rwaldron/johnny-five/awesome.md

# Awesome Nodebots Built with Johnny-Five
----------------
(Entries listed newest to oldest)

## Ricardo de Pena [@ricardodepena](https://twitter.com/ricardodepena)

- Clawbot: bluetooth bot with a claw, controlled via a ps3 controller
    [video](http://vimeo.com/86788094)
    [code](https://github.com/rdepena/clawbot)

## Richard Key [@busyrich](http://twitter.com/busyrich)

- Arduino Attack!
    [video](http://www.youtube.com/watch?v=1NalU4d7a20)
    [code](https://github.com/BusyRich/arduino-attack)

## Andrew Homeyer [@andrewhomeyer](https://twitter.com/andrewhomeyer), Matt Parrish [@mattparrish](https://twitter.com/mattparrish), Nicholas Boll [@nicholasboll](https://twitter.com/nicholasboll)

- Missile Command: A rubber band launcher that took down a nodecopter
    [video](http://youtu.be/0FAfu-Zowuo)
    [code](https://github.com/homeyer/missile-command/)

## Sara Gorecki [@opheliasdaisies] (https://twitter.com/opheliasdaisies)

- A tri-color LED that cycles according to pressure sensor input.
    [video](http://youtu.be/ePiiaja1CuI)
    [code](https://github.com/opheliasdaisies/tri-color-led)

## Rahul Ravikumar [@tikurahul](https://twitter.com/tikurahul), Bryan Hughes[@nebrius](https://twitter.com/nebrius)

- Typing Bot (nodebots, jsconf)
    [video](http://www.youtube.com/watch?v=kjTO2OkGnD8)

## Raquel Vélez [@rockbot](https://twitter.com/rockbot)

- Manny the Manipulator: A 2-dimensional serial manipulator using forward/inverse kinematics (via [vektor](https://github.com/rockbot/vektor))
    [video](http://www.youtube.com/watch?v=JKumEFyOvuI)
    [code](https://github.com/rockbot/vektor/tree/master/manipulator)

## Travis Thieman [@thieman](https://twitter.com/thieman)

- Power Glove (OS X Volume Control):
    [video](http://www.youtube.com/watch?v=j1BimT0hPSQ)
    [code](https://github.com/tthieman/arduino-projects/blob/master/hackathon_20130217/power_glove.js)

## Francis Gulotta [@reconbot](https://twitter.com/reconbot)

- Dorby the DoorBot
    [video howto](http://www.youtube.com/watch?v=6VnSIbRAlFw)
    [video servo operation](http://www.youtube.com/watch?v=gh7LtDA6EL0)
    [code](https://github.com/reconbot/dorby)

## Tim Walker [@timwalker2k](https://twitter.com/timwalker2k)

- An experimental Theremin using a proximity sensor and JavaScript.
    [code](https://github.com/twalker/sine5)

- A build status light for use within a continuous integration workflow
    [code](https://github.com/twalker/cilite)

## Kelly Korevec [@korevec](http://twitter.com/korevec)

- Medibot
    [Picture](https://twitter.com/korevec/status/267848987711766528/photo/1)
    [code](https://github.com/korevec/medibot)

## Irene Ros [@ireneros](http://twitter.com/ireneros)

- Wii Nunchuk Controller for AR Drone (nodecopter event)
    [video](http://twitter.yfrog.com/n4u1nrxrakmkyopxxpjmxzmzz)
    [code](https://github.com/iros/nodecoptering)

## Chris Williams [@voodootikigod](http://twitter.com/voodootikigod)

- Wii Nunchuk Controller for AR Drone (nodecopter event)
    [code](https://github.com/voodootikigod/wii-drone/)

## Andreas Haugstrup Pedersen [@hgstrp](http://twitter.com/hgstrp)

- LCD Controller (First successful implementation!!)
    [video](http://vimeo.com/46577266)
    [code](https://gist.github.com/3200331)
    (Became the basis for the LCD constructor!)

## Rebecca Murphey [@rmurphey](http://twitter.com/rmurphey)

- Johnny-Five Projects
    [On Github](https://github.com/rmurphey/johnny-five-projects)

- Shift Register Implementation w/ Led Counter Display
    [video](http://vimeo.com/46463390)
    [code](http://gist.github.com/3185390)

## Jonathan Blanchet [@jblanchefr](http://twitter.com/jblanchefr)

- Arduino + Websockets + particles:
    [video](http://www.youtube.com/watch?v=MXEGLGmpCfo)
    [code](https://gist.github.com/3145395)

- Arduino + Websockets + css change:
    [video](http://www.youtube.com/watch?v=aYFOOr1amSg&feature=plcp)
    [code](https://gist.github.com/3145461)

- Arduino + potentiometer + particles:
    [video](http://www.youtube.com/watch?v=d5r5r7pHUZI)
    [code](https://gist.github.com/3147263)

## Cole Gillespie [@theCole](https://twitter.com/theCole)

- Joystick Controlled Google Maps Streetview:
    [video](https://air.mozilla.org/hack-jam-dundee/)

## Kelly Korevec [@korevec](https://twitter.com/korevec)

- 6WD Rover
  [image](http://twitpic.com/a9t3rg)

## Sara Chipps [@sarajchipps](https://twitter.com/sarajchipps)

- LEDs that change color based on Twitter sentiment
   [video](http://www.youtube.com/watch?v=ws7svZuq29c)
   [code](https://github.com/SaraJo/twitter-ring)

## Yusuf Çakmak [@yukocan](https://twitter.com/yukocan)
   Control Led's Color with Leap Motion + Arduino
   [Code](https://github.com/yusufcakmak/leapmotion-arduino/blob/master/examples/ledcontrolhands.js) 
   [Vine](https://vine.co/v/MmhnAKO7aLx)

## Ibnu Triyono [@ibnutri](https://twitter.com/ibnutri)
   SCARA Drawbot (using 2 sg90s servo)
   [Code](https://github.com/ibnutri/scara-drawbot)
