rwaldron/johnny-five/docs/accelerometer-LIS3DH.md

<!--remove-start-->

# Accelerometer - LIS3DH

<!--remove-end-->

##### Breadboard for "Accelerometer - LIS3DH"

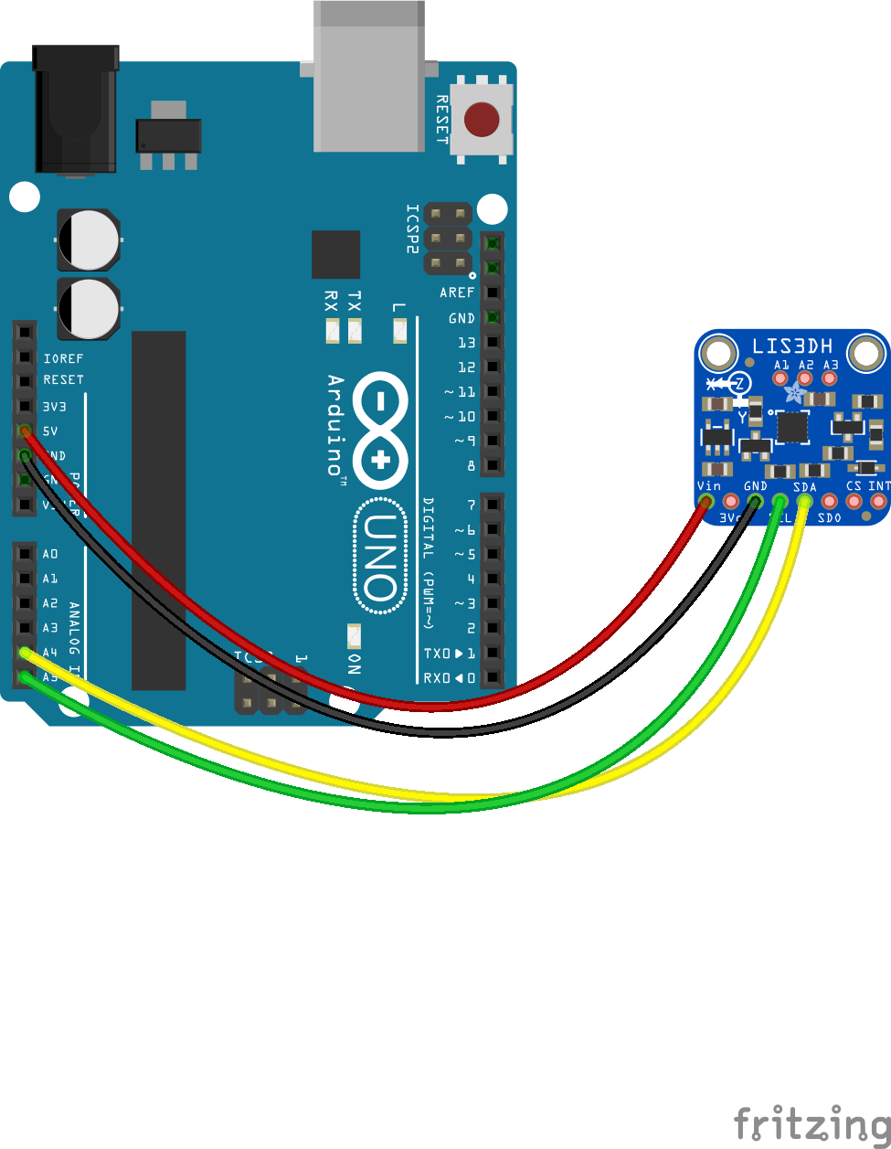
[picture p6: docs/breadboard/accelerometer-LIS3DH.png]
<br>

Fritzing diagram: [docs/breadboard/accelerometer-LIS3DH.fzz](breadboard/accelerometer-LIS3DH.fzz)

&nbsp;

Run this example from the command line with:
```bash
node eg/accelerometer-LIS3DH.js
```

```javascript
const { Accelerometer, Board } = require("johnny-five");
const board = new Board();

board.on("ready", () => {
  const accelerometer = new Accelerometer({
    controller: "LIS3DH",
    // Optionally set the range to one of
    // 2, 4, 8, 16 (±g)
    // Defaults to ±2g
    // range: ...
  });

  accelerometer.on("change", () => {
    const {acceleration, inclination, orientation, pitch, roll, x, y, z} = accelerometer;
    console.log("Accelerometer:");
    console.log("  x            : ", x);
    console.log("  y            : ", y);
    console.log("  z            : ", z);
    console.log("  pitch        : ", pitch);
    console.log("  roll         : ", roll);
    console.log("  acceleration : ", acceleration);
    console.log("  inclination  : ", inclination);
    console.log("  orientation  : ", orientation);
    console.log("--------------------------------------");
  });

  ["tap", "tap:single", "tap:double"].forEach((event) => {
    accelerometer.on(event, () => {
      console.log(event);
    });
  });
});

```

&nbsp;

<!--remove-start-->

## License
Copyright (c) 2012-2014 Rick Waldron <waldron.rick@gmail.com>
Licensed under the MIT license.
Copyright (c) 2015-2023 The Johnny-Five Contributors
Licensed under the MIT license.

<!--remove-end-->
