rwaldron/johnny-five/docs/accelerometer-MMA8452.md

<!--remove-start-->

# Accelerometer - MMA8452

<!--remove-end-->

##### Breadboard for "Accelerometer - MMA8452"

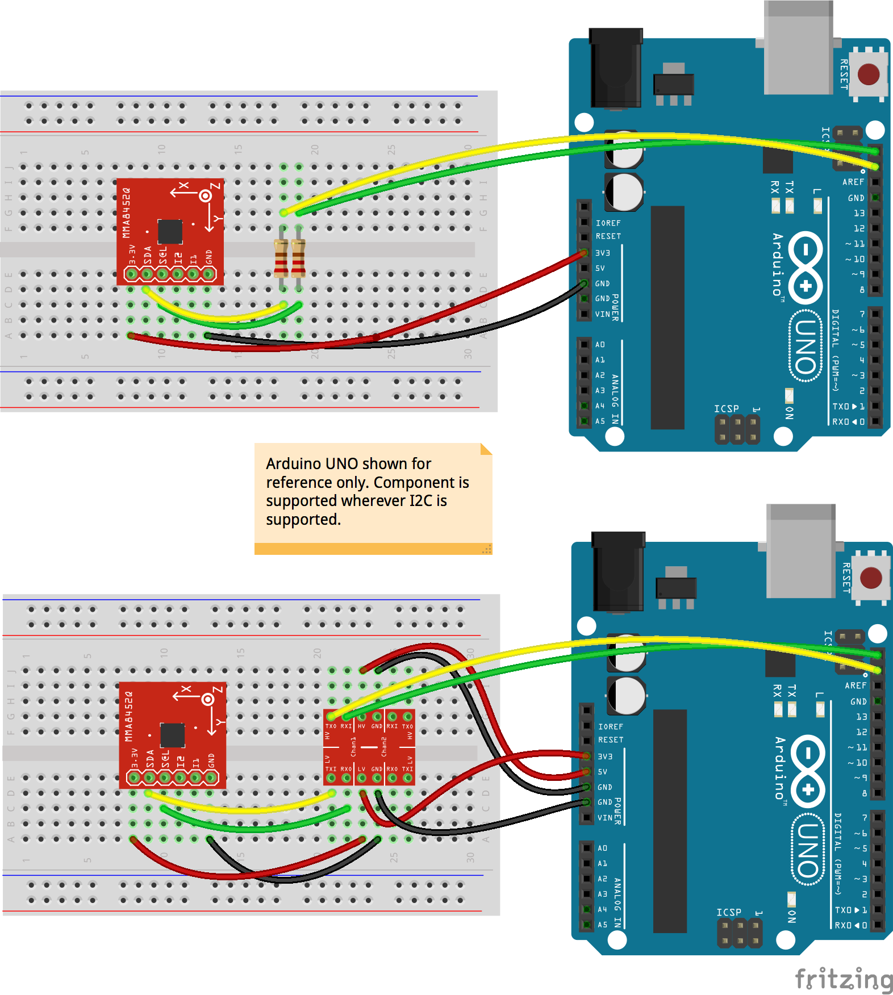
[picture p8: docs/breadboard/accelerometer-MMA8452.png]
<br>

Fritzing diagram: [docs/breadboard/accelerometer-MMA8452.fzz](breadboard/accelerometer-MMA8452.fzz)

&nbsp;

Run this example from the command line with:
```bash
node eg/accelerometer-MMA8452.js
```

```javascript
const { Accelerometer, Board } = require("johnny-five");
const board = new Board();

board.on("ready", () => {
  const accelerometer = new Accelerometer({
    controller: "MMA8452"
  });

  accelerometer.on("change", () => {
    const {acceleration, inclination, orientation, pitch, roll, x, y, z} = accelerometer;
    console.log("Accelerometer:");
    console.log("  x            : ", x);
    console.log("  y            : ", y);
    console.log("  z            : ", z);
    console.log("  pitch        : ", pitch);
    console.log("  roll         : ", roll);
    console.log("  acceleration : ", acceleration);
    console.log("  inclination  : ", inclination);
    console.log("  orientation  : ", orientation);
    console.log("--------------------------------------");
  });

  ["tap", "tap:single", "tap:double"].forEach((event) => {
    accelerometer.on(event, () => console.log(event));
  });
});

```

&nbsp;

<!--remove-start-->

## License
Copyright (c) 2012-2014 Rick Waldron <waldron.rick@gmail.com>
Licensed under the MIT license.
Copyright (c) 2015-2023 The Johnny-Five Contributors
Licensed under the MIT license.

<!--remove-end-->
