rwaldron/johnny-five/docs/altimeter-BMP085.md

<!--remove-start-->

# Altimeter - BMP085

<!--remove-end-->

##### BMP085

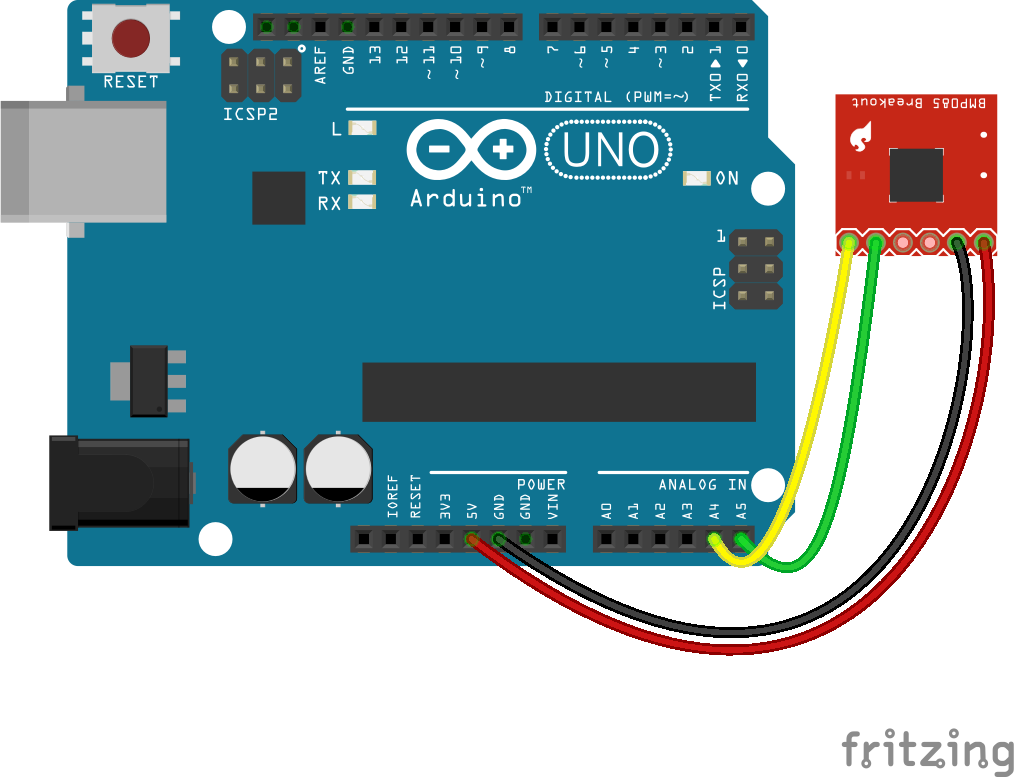
[picture p11: docs/breadboard/multi-bmp085-sfe.png]
<br>

Fritzing diagram: [docs/breadboard/multi-bmp085-sfe.fzz](breadboard/multi-bmp085-sfe.fzz)

&nbsp;

Run this example from the command line with:
```bash
node eg/altimeter-BMP085.js
```

```javascript
const { Altimeter, Board } = require("../");
const board = new Board();

board.on("ready", () => {
  // By including a base `elevation` property, the values
  // received will be absolute elevation (from sealevel)
  const altimeter = new Altimeter({
    controller: "BMP085",
    // Change `elevation` with whatever is reported
    // on http://www.whatismyelevation.com/.
    // `12` is the elevation (meters) for where I live in Brooklyn
    elevation: 12
  });

  altimeter.on("change", () => {
    const {feet, meters} = altimeter;
    console.log("Altimeter:");
    console.log("  feet         : ", feet);
    console.log("  meters       : ", meters);
    console.log("--------------------------------------");
  });
});

```

## Alternates

### BMP085 - Relative Elevation

```javascript
const { Altimeter, Board } = require("johnny-five");
const board = new Board();

board.on("ready", () => {
  // By omitting the base `elevation` property, the values
  // received will be relative to your present elevation
  const altimeter = new Altimeter({
    controller: "BMP085"
  });

  altimeter.on("change", () => {
    const {feet, meters} = altimeter;
    console.log("Altimeter:");
    console.log("  feet         : ", feet);
    console.log("  meters       : ", meters);
    console.log("--------------------------------------");
  });
});

```

## Illustrations / Photos

##### BMP085 (Adafruit)

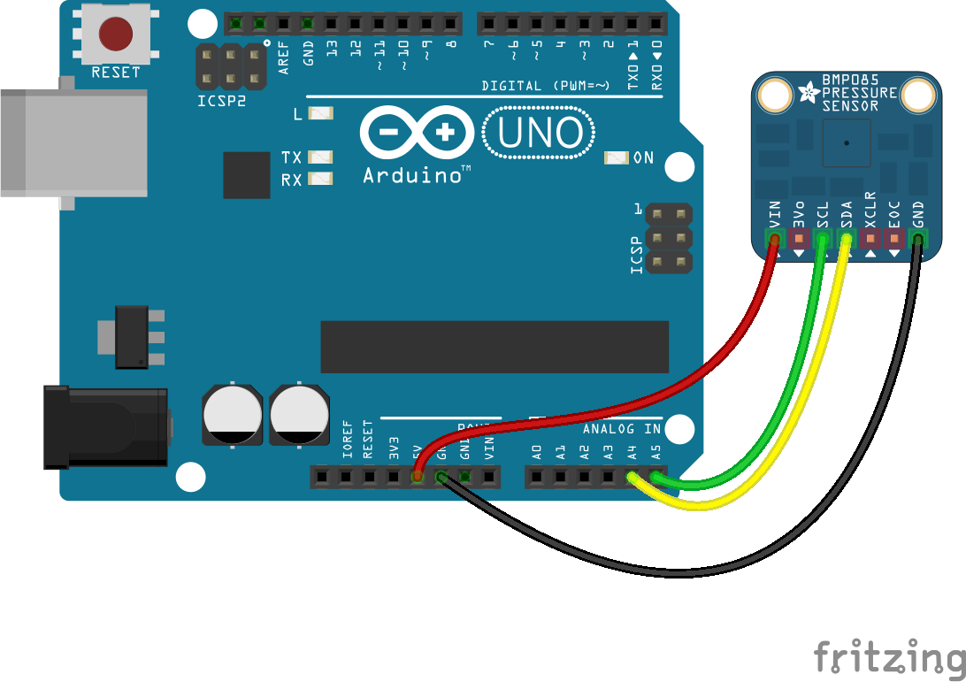
[picture p12: docs/breadboard/multi-bmp085.png]
<br>

Fritzing diagram: [docs/breadboard/multi-bmp085.fzz](breadboard/multi-bmp085.fzz)

&nbsp;

## Learn More

- [BMP085 Barometric Pressure/Temperature/Altitude Sensor](https://www.adafruit.com/products/391)

- [Grove - Barometer Sensor（BMP085)](http://www.seeedstudio.com/depot/grove-barometer-sensor-p-1199.html)

&nbsp;

<!--remove-start-->

## License
Copyright (c) 2012-2014 Rick Waldron <waldron.rick@gmail.com>
Licensed under the MIT license.
Copyright (c) 2015-2023 The Johnny-Five Contributors
Licensed under the MIT license.

<!--remove-end-->
