rwaldron/johnny-five/docs/altimeter-BMP180.md

<!--remove-start-->

# Altimeter - BMP180

<!--remove-end-->

##### BMP180

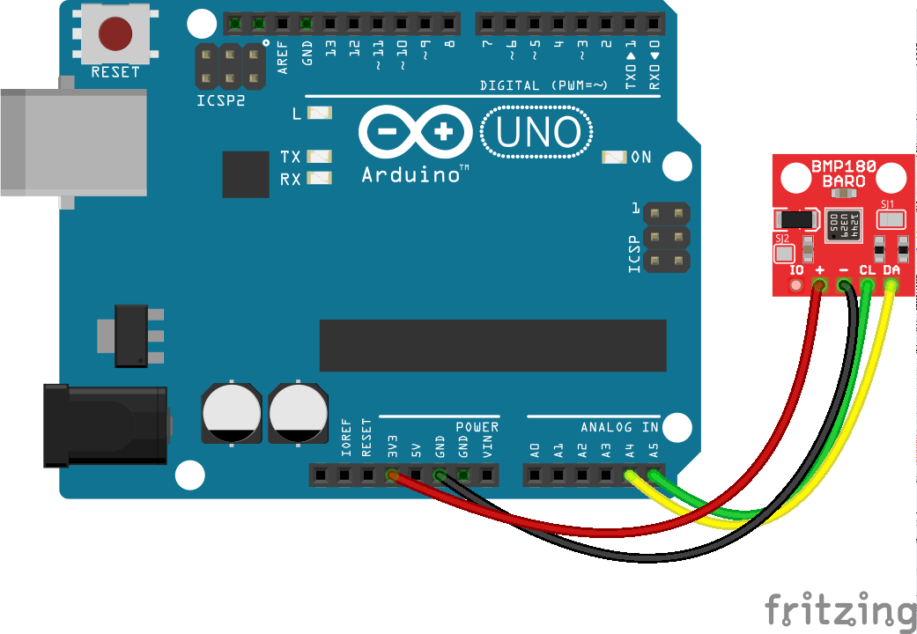
[picture p13: docs/breadboard/multi-bmp180-sfe.png]
<br>

Fritzing diagram: [docs/breadboard/multi-bmp180-sfe.fzz](breadboard/multi-bmp180-sfe.fzz)

&nbsp;

Run this example from the command line with:
```bash
node eg/altimeter-BMP180.js
```

```javascript
const { Altimeter, Board } = require("../");
const board = new Board();

board.on("ready", () => {
  // By including a base `elevation` property, the values
  // received will be absolute elevation (from sealevel)
  const altimeter = new Altimeter({
    controller: "BMP180",
    // Change `elevation` with whatever is reported
    // on http://www.whatismyelevation.com/.
    // `12` is the elevation (meters) for where I live in Brooklyn
    elevation: 12
  });

  altimeter.on("change", () => {
    const {feet, meters} = altimeter;
    console.log("Altimeter:");
    console.log("  feet         : ", feet);
    console.log("  meters       : ", meters);
    console.log("--------------------------------------");
  });
});

```

## Alternates

### BMP180 - Relative Elevation

```javascript
const { Altimeter, Board } = require("johnny-five");
const board = new Board();

board.on("ready", () => {
  // By omitting the base `elevation` property, the values
  // received will be relative to your present elevation
  const altimeter = new Altimeter({
    controller: "BMP180"
  });

  altimeter.on("change", () => {
    const {feet, meters} = altimeter;
    console.log("Altimeter:");
    console.log("  feet         : ", feet);
    console.log("  meters       : ", meters);
    console.log("--------------------------------------");
  });
});

```

## Illustrations / Photos

##### BMP180 (Adafruit)

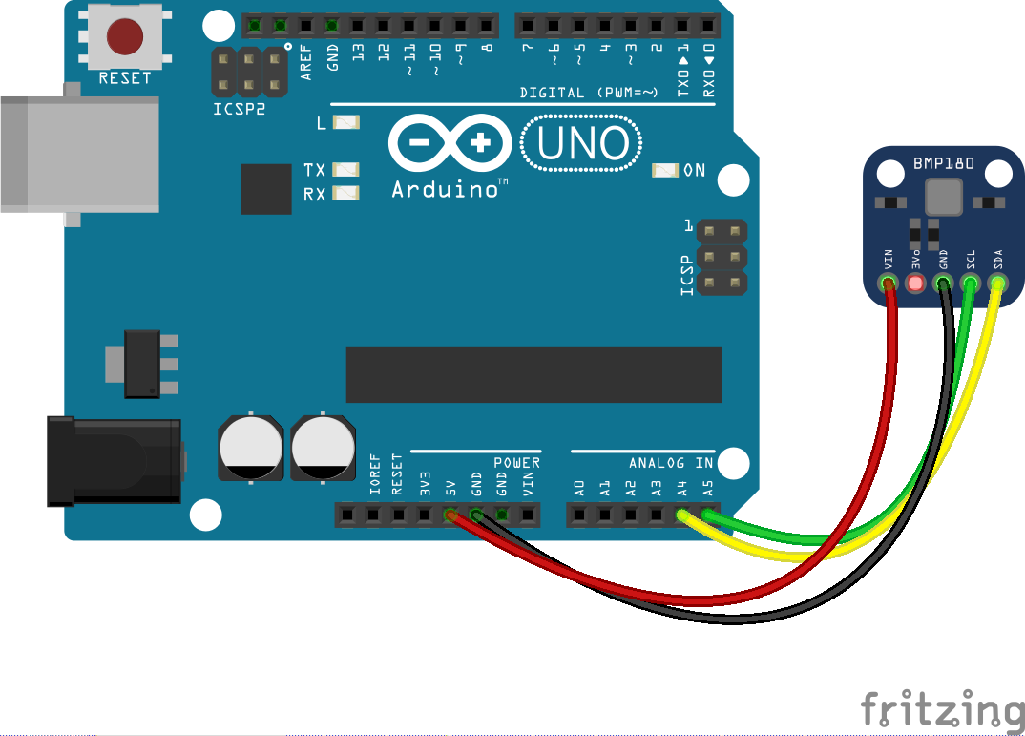
[picture p14: docs/breadboard/multi-bmp180.png]
<br>

Fritzing diagram: [docs/breadboard/multi-bmp180.fzz](breadboard/multi-bmp180.fzz)

&nbsp;

## Learn More

- [BMP180 Barometric Pressure/Temperature/Altitude Sensor](https://www.adafruit.com/products/1603)

- [SparkFun Barometric Pressure Sensor Breakout - BMP180](https://www.sparkfun.com/products/11824)

- [Grove - Barometer Sensor（BMP180)](http://www.seeedstudio.com/depot/Grove-Barometer-SensorBMP180-p-1840.html)

&nbsp;

<!--remove-start-->

## License
Copyright (c) 2012-2014 Rick Waldron <waldron.rick@gmail.com>
Licensed under the MIT license.
Copyright (c) 2015-2023 The Johnny-Five Contributors
Licensed under the MIT license.

<!--remove-end-->
