rwaldron/johnny-five/docs/barometer-mpl115a2.md

<!--remove-start-->

# Barometer - MPL115A2

<!--remove-end-->

##### MPL115A2

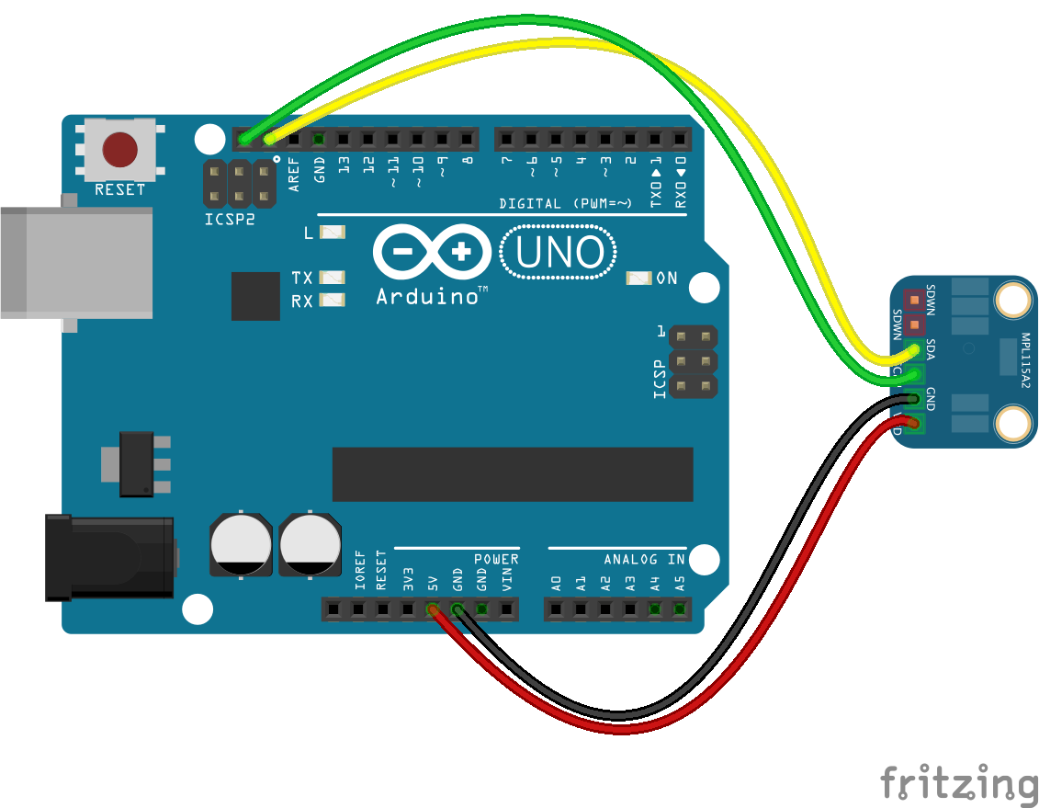
[picture p17: docs/breadboard/multi-mpl115a2.png]
<br>

Fritzing diagram: [docs/breadboard/multi-mpl115a2.fzz](breadboard/multi-mpl115a2.fzz)

&nbsp;

Run this example from the command line with:
```bash
node eg/barometer-mpl115a2.js
```

```javascript
const { Barometer, Board } = require("johnny-five");
const board = new Board();

board.on("ready", () => {
  const barometer = new Barometer({
    controller: "MPL115A2"
  });

  barometer.on("change", () => {
    console.log("Barometer:");
    console.log("  pressure     : ", barometer.pressure);
    console.log("--------------------------------------");
  });
});

```

## Learn More

- [MPL115A2 - I2C Barometric Pressure/Temperature Sensor](https://www.adafruit.com/product/992)

&nbsp;

<!--remove-start-->

## License
Copyright (c) 2012-2014 Rick Waldron <waldron.rick@gmail.com>
Licensed under the MIT license.
Copyright (c) 2015-2023 The Johnny-Five Contributors
Licensed under the MIT license.

<!--remove-end-->
