rwaldron/johnny-five/docs/board-cleanup.md

<!--remove-start-->

# Board - Cleanup in 'exit' event

<!--remove-end-->

##### LED on pin 13 (Arduino UNO)

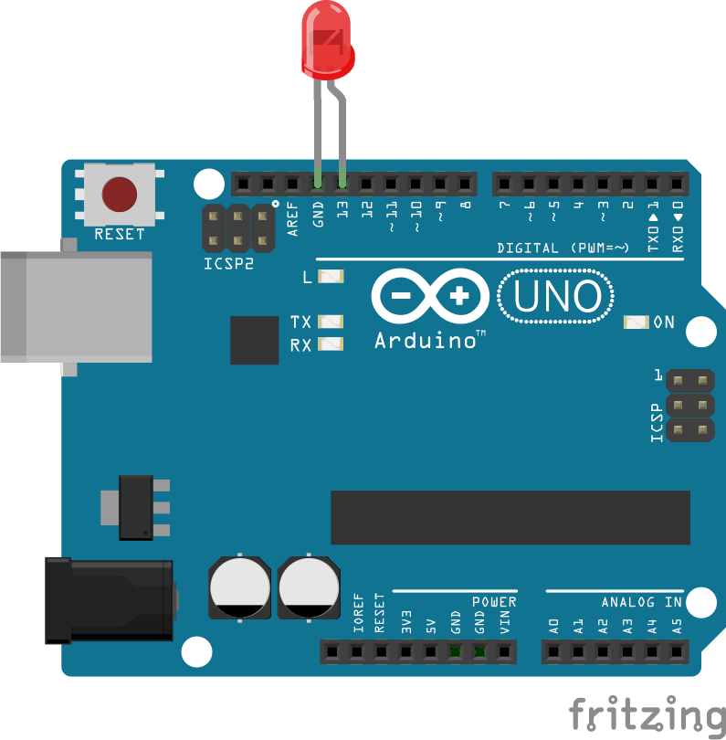
[picture p18: docs/breadboard/led-13.png]
<br>

Fritzing diagram: [docs/breadboard/led-13.fzz](breadboard/led-13.fzz)

&nbsp;

Run this example from the command line with:
```bash
node eg/board-cleanup.js
```

```javascript
const { Board, Led } = require("johnny-five");
const board = new Board();

board.on("ready", () => {
  const led = new Led(13);
  led.on();

  board.on("exit", () => {
    led.off();
  });
});

```

&nbsp;

<!--remove-start-->

## License
Copyright (c) 2012-2014 Rick Waldron <waldron.rick@gmail.com>
Licensed under the MIT license.
Copyright (c) 2015-2023 The Johnny-Five Contributors
Licensed under the MIT license.

<!--remove-end-->
