rwaldron/johnny-five/docs/edison-io-miniboard.md

<!--remove-start-->

# Led Blink on Intel Edison Mini Board

<!--remove-end-->

Example using Johnny-Five + Edison-IO to directly control an Intel Edison

##### LED on pin 1

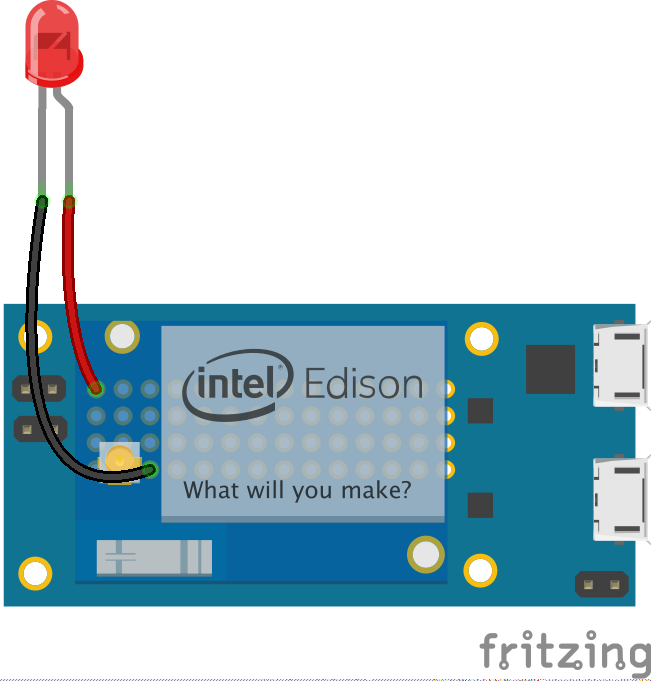
[picture p32: docs/breadboard/led-1-edison-miniboard.png]
<br>

Fritzing diagram: [docs/breadboard/led-1-edison-miniboard.fzz](breadboard/led-1-edison-miniboard.fzz)

&nbsp;

Run this example from the command line with:
```bash
node eg/edison-io-miniboard.js
```

```javascript
const { Board, Led } = require("johnny-five");
const Edison = require("edison-io");
const board = new Board({
  io: new Edison()
});

board.on("ready", () => {
  const led = new Led(1);
  led.blink();
});

```

## Illustrations / Photos

### Intel Edison Mini Board

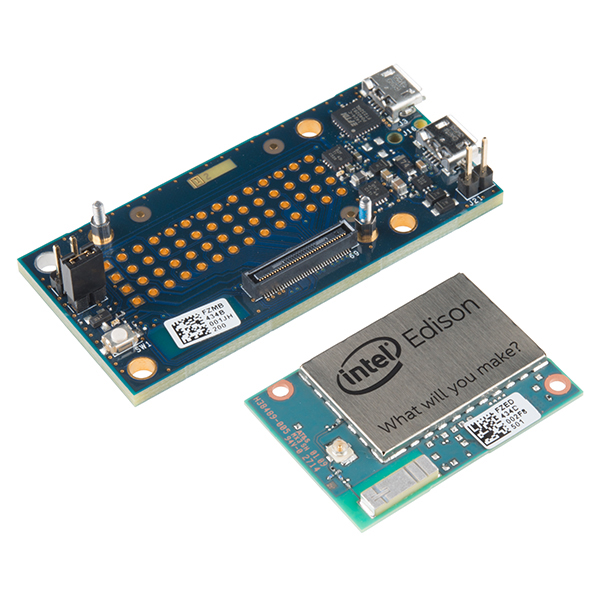
[picture p33: docs/images/edison-mini-board.jpg]
  

## Additional Notes
In order to use the Edison-IO library, you will need to flash the Intel IoTDevKit Image
on your Edison. Once the environment is created, install Johnny-Five and Edison-IO.
```sh
npm install johnny-five edison-io
```

## Learn More

- [edison-io on GitHub](https://github.com/rwaldron/edison-io/)

&nbsp;

<!--remove-start-->

## License
Copyright (c) 2012-2014 Rick Waldron <waldron.rick@gmail.com>
Licensed under the MIT license.
Copyright (c) 2015-2023 The Johnny-Five Contributors
Licensed under the MIT license.

<!--remove-end-->
