rwaldron/johnny-five/docs/grove-accelerometer-adxl345-edison.md

<!--remove-start-->

# Intel Edison + Grove - Accelerometer (ADXL345)

<!--remove-end-->

Using Johnny-Five with Grove's Accelerometer (ADXL345) component on the Intel Edison Arduino Breakout. This shield and component will work with any Arduino pin-out compatible hardware platform.

Run this example from the command line with:
```bash
node eg/grove-accelerometer-adxl345-edison.js
```

```javascript
const {Accelerometer, Board} = require("johnny-five");
const Edison = require("edison-io");
const board = new Board({
  io: new Edison()
});

board.on("ready", function() {

  // Plug the ADXL345 Accelerometer module
  // into an I2C jack
  const accelerometer = new Accelerometer({
    controller: "ADXL345"
  });

  accelerometer.on("change", () => {
    const {acceleration, inclination, orientation, pitch, roll, x, y, z} = accelerometer;
    console.log("Accelerometer:");
    console.log("  x            : ", x);
    console.log("  y            : ", y);
    console.log("  z            : ", z);
    console.log("  pitch        : ", pitch);
    console.log("  roll         : ", roll);
    console.log("  acceleration : ", acceleration);
    console.log("  inclination  : ", inclination);
    console.log("  orientation  : ", orientation);
    console.log("--------------------------------------");
  });
});

```

## Additional Notes
For this program, you'll need:
Intel Edison Arduino Breakout
Grove Base Shield v2
Grove - 3-Axis Digital Accelerometer(±16g)

&nbsp;

<!--remove-start-->

## License
Copyright (c) 2012-2014 Rick Waldron <waldron.rick@gmail.com>
Licensed under the MIT license.
Copyright (c) 2015-2023 The Johnny-Five Contributors
Licensed under the MIT license.

<!--remove-end-->
