rwaldron/johnny-five/docs/grove-accelerometer-mma7660-edison.md

<!--remove-start-->

# Intel Edison + Grove - Accelerometer (MMA7660)

<!--remove-end-->

Using Johnny-Five with Grove's Accelerometer (MMA7660) component on the Intel Edison Arduino Breakout. This shield and component will work with any Arduino pin-out compatible hardware platform.

Run this example from the command line with:
```bash
node eg/grove-accelerometer-mma7660-edison.js
```

```javascript
var five = require("johnny-five");
var Edison = require("edison-io");
var board = new five.Board({
  io: new Edison()
});

board.on("ready", function() {

  // Plug the MMA7660 Accelerometer module
  // into an I2C jack
  var acceleration = new five.Accelerometer({
    controller: "MMA7660"
  });

  acceleration.on("change", function() {
    console.log("accelerometer");
    console.log("  x            : ", this.x);
    console.log("  y            : ", this.y);
    console.log("  z            : ", this.z);
    console.log("  pitch        : ", this.pitch);
    console.log("  roll         : ", this.roll);
    console.log("  acceleration : ", this.acceleration);
    console.log("  inclination  : ", this.inclination);
    console.log("  orientation  : ", this.orientation);
    console.log("--------------------------------------");
  });
});

```

## Additional Notes
For this program, you'll need:
Intel Edison Arduino Breakout
Grove Base Shield v2
Grove - 3-Axis Digital Accelerometer(±1.5g)

&nbsp;

<!--remove-start-->

## License
Copyright (c) 2012-2014 Rick Waldron <waldron.rick@gmail.com>
Licensed under the MIT license.
Copyright (c) 2015-2023 The Johnny-Five Contributors
Licensed under the MIT license.

<!--remove-end-->
