rwaldron/johnny-five/docs/grove-compass-edison.md

<!--remove-start-->

# Intel Edison + Grove - Compass (HMC588L)

<!--remove-end-->

Using Johnny-Five with Grove's Compass (HMC588L) component on the Intel Edison Arduino Breakout. This shield and component will work with any Arduino pin-out compatible hardware platform.

Run this example from the command line with:
```bash
node eg/grove-compass-edison.js
```

```javascript
var five = require("johnny-five");
var Edison = require("edison-io");
var board = new five.Board({
  io: new Edison()
});

board.on("ready", function() {

  // Plug the HMC5883L Compass module
  // into an I2C jack
  var compass = new five.Compass({
    controller: "HMC5883L"
  });

  compass.on("headingchange", function() {
    console.log("headingchange");
    console.log("  heading : ", Math.floor(this.heading));
    console.log("  bearing : ", this.bearing.name);
    console.log("--------------------------------------");
  });

  compass.on("data", function() {
    console.log("  heading : ", Math.floor(this.heading));
    console.log("  bearing : ", this.bearing.name);
    console.log("--------------------------------------");
  });
});

```

## Additional Notes
For this program, you'll need:
Intel Edison Arduino Breakout
Grove Base Shield v2
Grove - 3-Axis Digital Compass
- [Grove - 3-Axis Digital Compass](http://www.seeedstudio.com/depot/Grove-3Axis-Digital-Compass-p-759.html)

&nbsp;

<!--remove-start-->

## License
Copyright (c) 2012-2014 Rick Waldron <waldron.rick@gmail.com>
Licensed under the MIT license.
Copyright (c) 2015-2023 The Johnny-Five Contributors
Licensed under the MIT license.

<!--remove-end-->
