rwaldron/johnny-five/docs/grove-i2c-motor-driver-edison.md

<!--remove-start-->

# Intel Edison + Grove - I2C Motor Driver

<!--remove-end-->

Using Johnny-Five with Grove's I2C Motor Driver component on the Intel Edison Arduino Breakout. This shield and component will work with any Arduino pin-out compatible hardware platform.

Run this example from the command line with:
```bash
node eg/grove-i2c-motor-driver-edison.js
```

```javascript
var five = require("johnny-five");
var Edison = require("edison-io");
var board = new five.Board({
  io: new Edison()
});

board.on("ready", function() {
  var a = new five.Motor({
    controller: "GROVE_I2C_MOTOR_DRIVER",
    pin: "A",
  });

  var b = new five.Motor({
    controller: "GROVE_I2C_MOTOR_DRIVER",
    pin: "B",
  });

  this.wait(3000, function() {
    console.log("REVERSE");

    a.rev(127);
    b.rev(127);

    // Demonstrate motor stop in 2 seconds
    this.wait(3000, function() {
      console.log("STOP");
      a.stop();
      b.stop();

      this.wait(1000, function() {
        process.emit("SIGINT");
      });
    }.bind(this));
  }.bind(this));

  console.log("FORWARD");
  a.fwd(127);
  b.fwd(127);
});

```

## Additional Notes
For this program, you'll need:
Intel Edison Arduino Breakout
Grove Base Shield v2
(Or similiar Grove shield and platform)
Grove - I2C Motor Driver

&nbsp;

<!--remove-start-->

## License
Copyright (c) 2012-2014 Rick Waldron <waldron.rick@gmail.com>
Licensed under the MIT license.
Copyright (c) 2015-2023 The Johnny-Five Contributors
Licensed under the MIT license.

<!--remove-end-->
