rwaldron/johnny-five/docs/grove-joystick-edison.md

<!--remove-start-->

# Intel Edison + Grove - Joystick

<!--remove-end-->

Using Johnny-Five with Grove's Joystick component on the Intel Edison Arduino Breakout. This shield and component will work with any Arduino pin-out compatible hardware platform.

Run this example from the command line with:
```bash
node eg/grove-joystick-edison.js
```

```javascript
var five = require("johnny-five");
var Edison = require("edison-io");
var board = new five.Board({
  io: new Edison()
});

board.on("ready", function() {

  // Plug the Joystick module into the
  // Grove Shield's A0 jack. Use
  // the Joystick class to control.
  var joystick = new five.Joystick(["A0", "A1"]);

  // Observe change events from the Joystick!
  joystick.on("change", function() {
    console.log("Joystick");
    console.log("  x : ", this.x);
    console.log("  y : ", this.y);
    console.log("--------------------------------------");
  });
});

```

## Additional Notes
For this program, you'll need:
Intel Edison Arduino Breakout
Grove Base Shield v2
Grove - Joystick Module
Grove - Touch Module

&nbsp;

<!--remove-start-->

## License
Copyright (c) 2012-2014 Rick Waldron <waldron.rick@gmail.com>
Licensed under the MIT license.
Copyright (c) 2015-2023 The Johnny-Five Contributors
Licensed under the MIT license.

<!--remove-end-->
