rwaldron/johnny-five/docs/grove-led-edison.md

<!--remove-start-->

# Intel Edison + Grove - LED

<!--remove-end-->

Using Johnny-Five with Grove's LED component on the Intel Edison Arduino Breakout. This shield and component will work with any Arduino pin-out compatible hardware platform.

Run this example from the command line with:
```bash
node eg/grove-led-edison.js
```

```javascript
var five = require("johnny-five");
var Edison = require("edison-io");
var board = new five.Board({
  io: new Edison()
});

board.on("ready", function() {

  // Plug the LED module into the
  // Grove Shield's D6 jack.
  //
  // Select an LED from the kit
  // (red, green, blue) and insert
  // it into the LED module, with
  // the long pin in + and short
  // pin in -.
  var led = new five.Led(6);

  // This will blink the LED over
  // 500ms periods.
  led.blink(500);
});

```

## Illustrations / Photos

### Grove LED

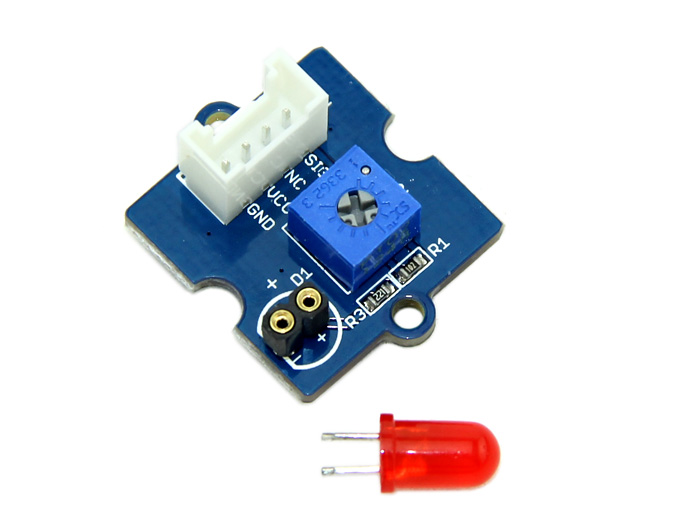
[picture p58: docs/images/grove-led.jpg]
  

## Additional Notes
For this program, you'll need:
Intel Edison Arduino Breakout
Grove Base Shield v2
Grove - LED Module

&nbsp;

<!--remove-start-->

## License
Copyright (c) 2012-2014 Rick Waldron <waldron.rick@gmail.com>
Licensed under the MIT license.
Copyright (c) 2015-2023 The Johnny-Five Contributors
Licensed under the MIT license.

<!--remove-end-->
