rwaldron/johnny-five/docs/grove-light-sensor-edison.md

<!--remove-start-->

# Intel Edison + Grove - Light Sensor (TSL2561)

<!--remove-end-->

Using Johnny-Five with Grove's Light Sensor (TSL2561) component on the Intel Edison Arduino Breakout. This shield and component will work with any Arduino pin-out compatible hardware platform.

Run this example from the command line with:
```bash
node eg/grove-light-sensor-edison.js
```

```javascript
const five = require("johnny-five");
const Edison = require("edison-io");
const board = new five.Board({
  io: new Edison()
});

board.on("ready", () => {

  // Plug the Grove TSL2561 Light sensor module
  // into an I2C jack
  const light = new five.Light({
    controller: "TSL2561"
  });

  light.on("change", function() {
    console.log("Ambient Light Level: ", this.level);
  });
});

```

## Additional Notes
For this program, you'll need:
Intel Edison Arduino Breakout
Grove Base Shield v2
Grove - Digital Light Sensor
- [Grove - Digital Light Sensor](http://www.seeedstudio.com/depot/Grove-Digital-Light-Sensor-p-1281.html)

&nbsp;

<!--remove-start-->

## License
Copyright (c) 2012-2014 Rick Waldron <waldron.rick@gmail.com>
Licensed under the MIT license.
Copyright (c) 2015-2023 The Johnny-Five Contributors
Licensed under the MIT license.

<!--remove-end-->
