rwaldron/johnny-five/docs/grove-q-touch.md

<!--remove-start-->

# Intel Edison + Grove - Q Touch

<!--remove-end-->

Using Johnny-Five with Grove's Q Touch component on the Intel Edison Arduino Breakout. This shield and component will work with any Arduino pin-out compatible hardware platform.

Run this example from the command line with:
```bash
node eg/grove-q-touch.js
```

```javascript
var argv = require("minimist")(process.argv.slice(2), {
  default: {
    show: 1
  }
});
var five = require("johnny-five");
var Edison = require("edison-io");
var board = new five.Board({
  io: new Edison()
});

board.on("ready", function() {
  // QTOUCH Capacitive Touch Shield
  var keypad;

  if (argv.show === 1) {
    keypad = new five.Keypad({
      controller: "QTOUCH"
    });
  }

  if (argv.show === 2) {
    keypad = new five.Keypad({
      controller: "QTOUCH",
      keys: [
        ["1", "2", "3"]
      ]
    });
  }

  if (argv.show === 3) {
    keypad = new five.Keypad({
      controller: "QTOUCH",
      keys: ["1", "2", "3"]
    });
  }

  ["change", "press", "hold", "release"].forEach(function(eventType) {
    keypad.on(eventType, function(data) {
      console.log("Event: %s, Target: %s", eventType, data.which);
    });
  });
});

```

## Additional Notes
For this program, you'll need:
Intel Edison Arduino Breakout
Grove Base Shield v2
Grove - Q Touch Sensor (http://www.seeedstudio.com/depot/GroveQ-Touch-Sensor-p-1854.html)

&nbsp;

<!--remove-start-->

## License
Copyright (c) 2012-2014 Rick Waldron <waldron.rick@gmail.com>
Licensed under the MIT license.
Copyright (c) 2015-2023 The Johnny-Five Contributors
Licensed under the MIT license.

<!--remove-end-->
