rwaldron/johnny-five/docs/hygrometer-DHT11_I2C_NANO_BACKPACK.md

<!--remove-start-->

# Hygrometer - DHT11_I2C_NANO_BACKPACK

<!--remove-end-->

##### Hygrometer DHT11

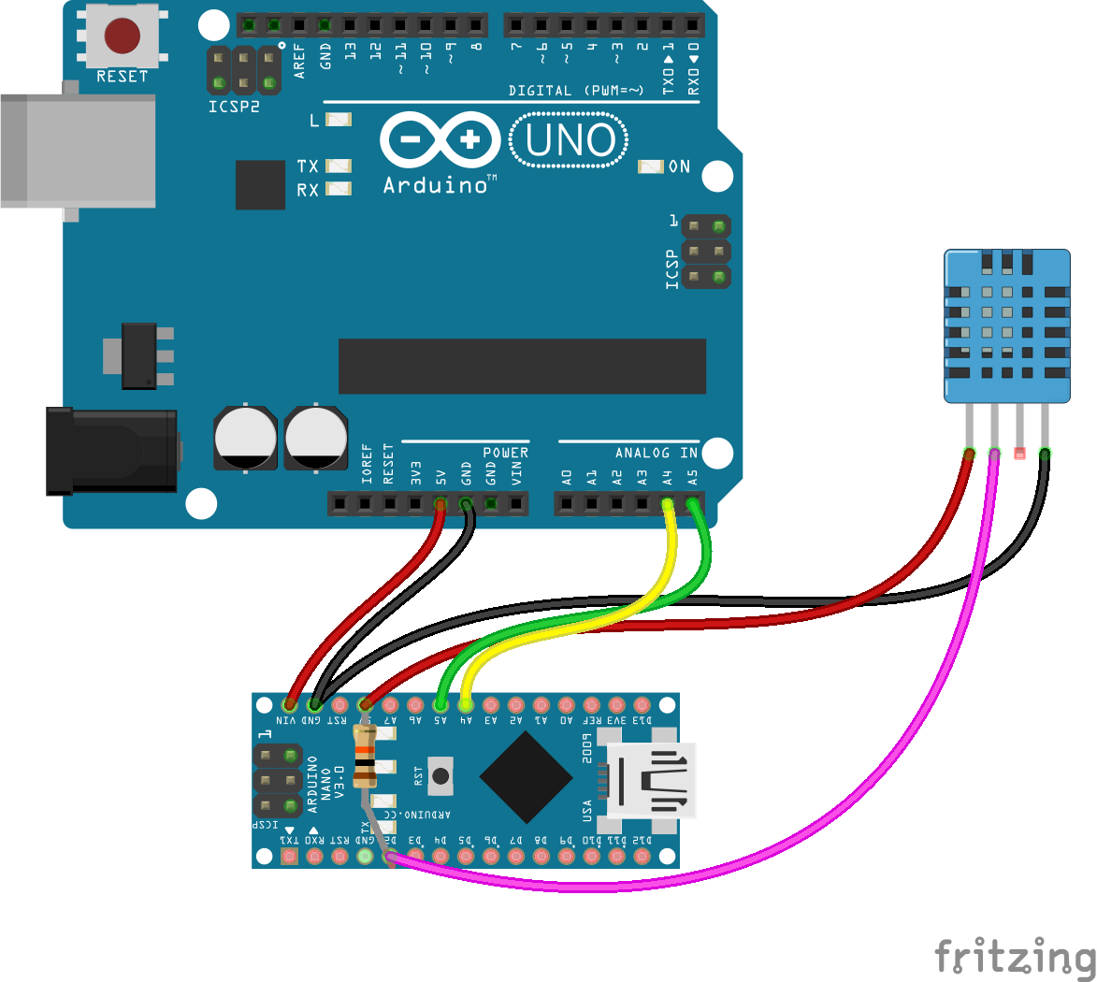
[picture p62: docs/breadboard/multi-DHT11_I2C_NANO_BACKPACK.png]
<br>

Fritzing diagram: [docs/breadboard/multi-DHT11_I2C_NANO_BACKPACK.fzz](breadboard/multi-DHT11_I2C_NANO_BACKPACK.fzz)

&nbsp;

Run this example from the command line with:
```bash
node eg/hygrometer-DHT11_I2C_NANO_BACKPACK.js
```

```javascript
var five = require("../");
var board = new five.Board();

board.on("ready", function() {
  var hygrometer = new five.Hygrometer({
    controller: "DHT11_I2C_NANO_BACKPACK"
  });

  hygrometer.on("change", function() {
    console.log("Hygrometer");
    console.log("  relative humidity : ", this.relativeHumidity);
    console.log("--------------------------------------");
  });
});

```

## Learn More

- [I2C Backback Firmare](https://github.com/rwaldron/johnny-five/blob/master/firmwares/dht_i2c_nano_backpack.ino)

&nbsp;

<!--remove-start-->

## License
Copyright (c) 2012-2014 Rick Waldron <waldron.rick@gmail.com>
Licensed under the MIT license.
Copyright (c) 2015-2023 The Johnny-Five Contributors
Licensed under the MIT license.

<!--remove-end-->
