rwaldron/johnny-five/docs/lcd-i2c.md

<!--remove-start-->

# LCD - I2C

<!--remove-end-->

##### Using a Grove RGB LCD with and without the Grove Shield

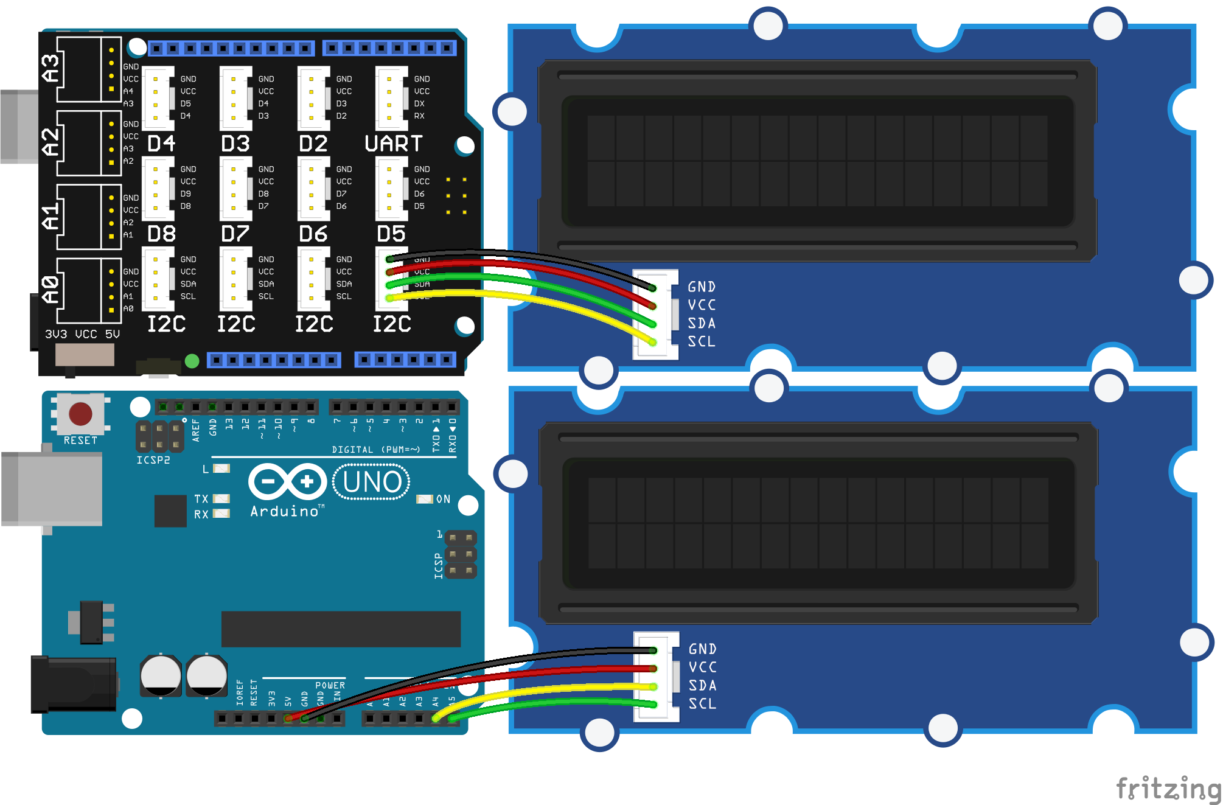
[picture p96: docs/breadboard/lcd-JHD1313M1.png]
<br>

Fritzing diagram: [docs/breadboard/lcd-JHD1313M1.fzz](breadboard/lcd-JHD1313M1.fzz)

&nbsp;

Run this example from the command line with:
```bash
node eg/lcd-i2c.js
```

```javascript
var five = require("johnny-five");
var board = new five.Board();

board.on("ready", function() {

  var lcd = new five.LCD({
    controller: "JHD1313M1"
  });

  lcd.useChar("heart");

  lcd.cursor(0, 0).print("hello :heart:");

  lcd.blink();

  lcd.cursor(1, 0).print("Blinking? ");
});

```

## Additional Notes
[Grove - LCD RGB w/ Backlight](http://www.seeedstudio.com/depot/grove-lcd-rgb-backlight-p-1643.html)
Grove LCD RGB

&nbsp;

<!--remove-start-->

## License
Copyright (c) 2012-2014 Rick Waldron <waldron.rick@gmail.com>
Licensed under the MIT license.
Copyright (c) 2015-2023 The Johnny-Five Contributors
Licensed under the MIT license.

<!--remove-end-->
