rwaldron/johnny-five/docs/lcd-runner-20x4.md

<!--remove-start-->

# LCD - Runner 20x4

<!--remove-end-->

##### Breadboard for "LCD - Runner 20x4"

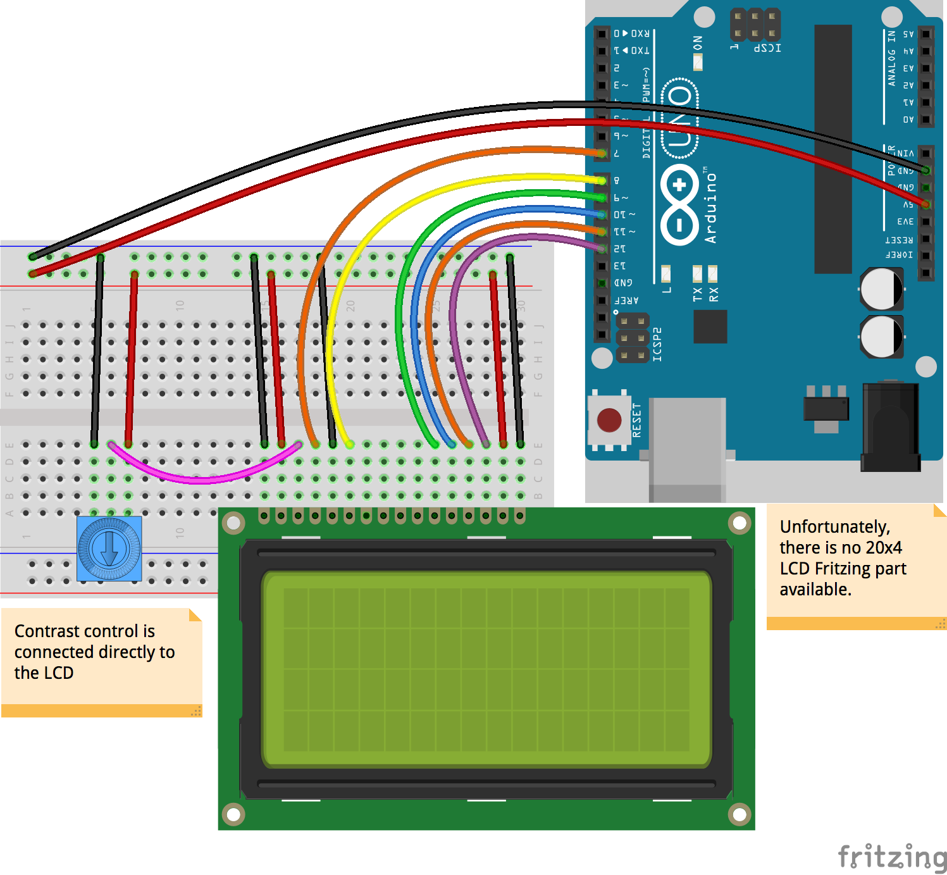
[picture p98: docs/breadboard/lcd-runner-20x4.png]
<br>

Fritzing diagram: [docs/breadboard/lcd-runner-20x4.fzz](breadboard/lcd-runner-20x4.fzz)

&nbsp;

Run this example from the command line with:
```bash
node eg/lcd-runner-20x4.js
```

```javascript
var five = require("johnny-five");
var board = new five.Board();

board.on("ready", function() {

  var lcd = new five.LCD({
    // LCD pin name  RS  EN  DB4 DB5 DB6 DB7
    // Arduino pin # 7    8   9   10  11  12
    pins: [7, 8, 9, 10, 11, 12],
    rows: 4,
    cols: 20
  });

  var frame = 1;
  var frames = [":runninga:", ":runningb:"];
  var col = 0;
  var row = 0;

  // These calls will store the "runninga" and "runningb"
  // characters in the LCD's built-in memory. The LCD
  // allows up to 8 custom characters to be pre-loaded
  // into memory.
  //
  // http://johnny-five.io/api/lcd/#predefined-characters
  //
  lcd.useChar("runninga");
  lcd.useChar("runningb");

  this.loop(300, function() {
    lcd.clear().cursor(row, col).print(
      frames[frame ^= 1]
    );

    if (++col === lcd.cols) {
      col = 0;
      if (++row === lcd.rows) {
        row = 0;
      }
    }
  });
});

```

## Additional Notes
- [16 x 2 LCD White on Blue](http://www.hacktronics.com/LCDs/16-x-2-LCD-White-on-Blue/flypage.tpl.html)
- [20 x 4 LCD White on Blue](http://www.hacktronics.com/LCDs/20-x-4-LCD-White-on-Blue/flypage.tpl.html)

&nbsp;

<!--remove-start-->

## License
Copyright (c) 2012-2014 Rick Waldron <waldron.rick@gmail.com>
Licensed under the MIT license.
Copyright (c) 2015-2023 The Johnny-Five Contributors
Licensed under the MIT license.

<!--remove-end-->
