rwaldron/johnny-five/docs/led-digits-clock-HT16K33.md

<!--remove-start-->

# LED - Digital Clock, HT16K33

<!--remove-end-->

##### Breadboard for "LED - Digital Clock, HT16K33"

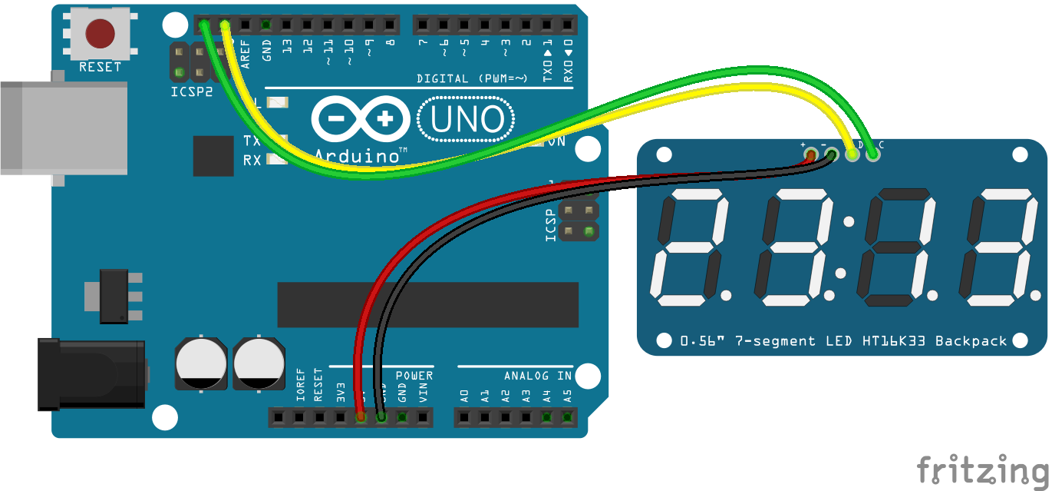
[picture p108: docs/breadboard/led-digits-clock-HT16K33.png]
<br>

Fritzing diagram: [docs/breadboard/led-digits-clock-HT16K33.fzz](breadboard/led-digits-clock-HT16K33.fzz)

&nbsp;

Run this example from the command line with:
```bash
node eg/led-digits-clock-HT16K33.js
```

```javascript
const moment = require("moment");
const { Board, Led } = require("johnny-five");
var board = new Board();

board.on("ready", () => {
  const digits = new Led.Digits({
    controller: "HT16K33",
  });
  let toggle = 0;

  setInterval(() => {
    // Toggle the colon part: on for a second, off for a second.
    digits.print(time(toggle ^= 1));
  }, 1000);
});

function time(showColon) {
  var display = "    " + moment().format(
    showColon ? "h:mm" : "h mm"
  );
  return display.slice(-5);
}

```

## Additional Notes
Learn More:
- [JavaScript: A Digital Clock with Johnny-Five](http://bocoup.com/weblog/javascript-arduino-digital-clock-johnny-five/)

&nbsp;

<!--remove-start-->

## License
Copyright (c) 2012-2014 Rick Waldron <waldron.rick@gmail.com>
Licensed under the MIT license.
Copyright (c) 2015-2023 The Johnny-Five Contributors
Licensed under the MIT license.

<!--remove-end-->
