rwaldron/johnny-five/docs/led-fade-animation.md

<!--remove-start-->

# LED - Fade with animation

<!--remove-end-->

LED fade example that fades an LED up and down to varying values. Requires LED on pin that supports PWM (usually denoted by ~).

##### LED on pin 11 (Arduino UNO)

LED inserted directly into pin 11.

<br>

Fritzing diagram: [docs/breadboard/led-11-pwm.fzz](breadboard/led-11-pwm.fzz)

&nbsp;

Run this example from the command line with:
```bash
node eg/led-fade-animation.js
```

```javascript
const { Board, Led } = require("johnny-five");
const board = new Board();

board.on("ready", () => {
  const led = new Led(11);

  led.fade({
    easing: "linear",
    duration: 1000,
    cuePoints: [0, 0.2, 0.4, 0.6, 0.8, 1],
    keyFrames: [0, 250, 25, 150, 100, 125],
    onstop() {
      console.log("Animation stopped");
    }
  });

  // Toggle the led after 2 seconds (shown in ms)
  board.wait(2000, () => led.fadeOut());
});

```

&nbsp;

<!--remove-start-->

## License
Copyright (c) 2012-2014 Rick Waldron <waldron.rick@gmail.com>
Licensed under the MIT license.
Copyright (c) 2015-2023 The Johnny-Five Contributors
Licensed under the MIT license.

<!--remove-end-->
