rwaldron/johnny-five/docs/light-ambient-EVS_EV3.md

<!--remove-start-->

# Light - EVShield EV3 (Ambient)

<!--remove-end-->

Run this example from the command line with:
```bash
node eg/light-ambient-EVS_EV3.js
```

```javascript
const { Board, Light } = require("johnny-five");
const board = new Board();

board.on("ready", () => {
  const ambient = new Light({
    controller: "EVS_EV3",
    pin: "BAS1"
  });

  ambient.on("change", () => {
    console.log("Ambient Light Level: ");
    console.log("  level  : ", ambient.level);
    console.log("-----------------");
  });
});

```

&nbsp;

<!--remove-start-->

## License
Copyright (c) 2012-2014 Rick Waldron <waldron.rick@gmail.com>
Licensed under the MIT license.
Copyright (c) 2015-2023 The Johnny-Five Contributors
Licensed under the MIT license.

<!--remove-end-->
