rwaldron/johnny-five/docs/light-reflected-EVS_EV3.md

<!--remove-start-->

# Light - EVShield EV3 (Reflected)

<!--remove-end-->

Run this example from the command line with:
```bash
node eg/light-reflected-EVS_EV3.js
```

```javascript
const { Board, Light } = require("johnny-five");
const board = new Board();

board.on("ready", () => {
  const reflected = new Light({
    controller: "EVS_EV3",
    pin: "BAS1",
    mode: "reflected"
  });

  reflected.on("change", () => {
    console.log("Reflected Light Level: ");
    console.log("  level  : ", reflected.level);
    console.log("-----------------");
  });
});

```

&nbsp;

<!--remove-start-->

## License
Copyright (c) 2012-2014 Rick Waldron <waldron.rick@gmail.com>
Licensed under the MIT license.
Copyright (c) 2015-2023 The Johnny-Five Contributors
Licensed under the MIT license.

<!--remove-end-->
