rwaldron/johnny-five/docs/motor-directional.md

<!--remove-start-->

# Motor - Directional

<!--remove-end-->

##### Breadboard for "Motor - Directional"

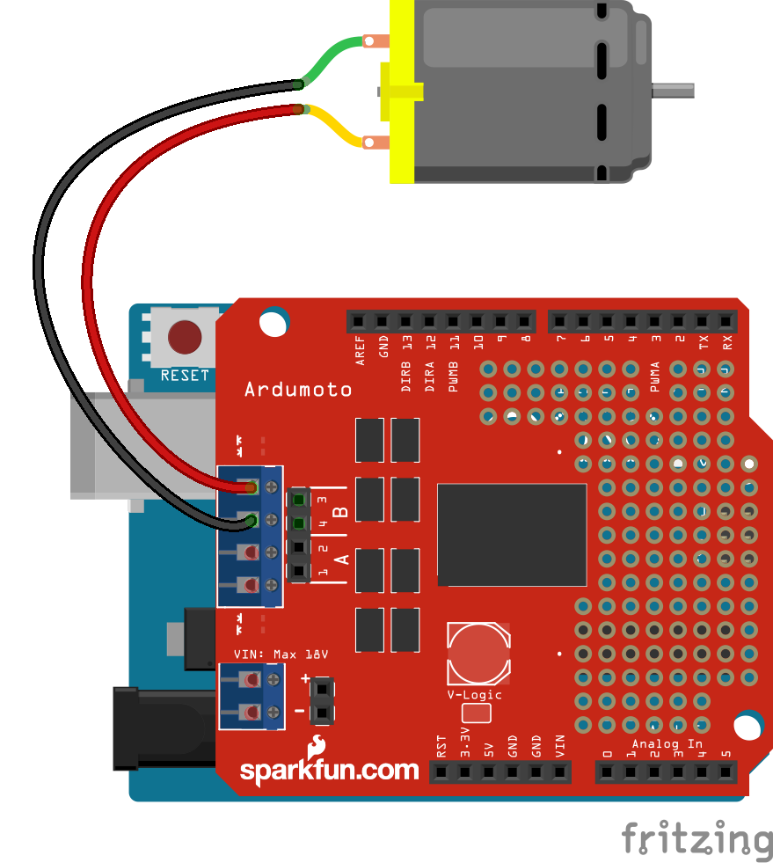
[picture p132: docs/breadboard/motor-directional.png]
<br>

Fritzing diagram: [docs/breadboard/motor-directional.fzz](breadboard/motor-directional.fzz)

&nbsp;

Run this example from the command line with:
```bash
node eg/motor-directional.js
```

```javascript
const {Board, Motor} = require("johnny-five");
const board = new Board();

board.on("ready", () => {
  /*
    ArduMoto
      Motor A
        pwm: 3
        dir: 12

      Motor B
        pwm: 11
        dir: 13

    AdaFruit Motor Shield
      Motor A
        pwm: ?
        dir: ?

      Motor B
        pwm: ?
        dir: ?

    Bi-Directional Motors can be initialized by:

      new five.Motor([ 3, 12 ]);

    ...is the same as...

      new five.Motor({
        pins: [ 3, 12 ]
      });

    ...is the same as...

      new five.Motor({
        pins: {
          pwm: 3,
          dir: 12
        }
      });

   */

  const motor = new Motor({
    pins: {
      pwm: 3,
      dir: 12
    }
  });

  board.repl.inject({
    motor
  });

  motor.on("start", () => {
    console.log(`start: ${Date.now()}`);
  });

  motor.on("stop", () => {
    console.log(`automated stop on timer: ${Date.now()}`);
  });

  motor.on("forward", () => {
    console.log(`forward: ${Date.now()}`);

    // demonstrate switching to reverse after 5 seconds
    board.wait(5000, () => motor.reverse(50));
  });

  motor.on("reverse", () => {
    console.log(`reverse: ${Date.now()}`);

    // demonstrate stopping after 5 seconds
    board.wait(5000, motor.stop);
  });

  // set the motor going forward full speed
  motor.forward(255);
});

```

&nbsp;

<!--remove-start-->

## License
Copyright (c) 2012-2014 Rick Waldron <waldron.rick@gmail.com>
Licensed under the MIT license.
Copyright (c) 2015-2023 The Johnny-Five Contributors
Licensed under the MIT license.

<!--remove-end-->
