rwaldron/johnny-five/docs/motor-PCA9685.md

<!--remove-start-->

# Motor - PCA9685

<!--remove-end-->

Run this example from the command line with:
```bash
node eg/motor-PCA9685.js
```

```javascript
const {Board, Motor} = require("johnny-five");

const board = new Board();

/*
 * The PCA9685 controller has been tested on
 * the Adafruit Motor/Stepper/Servo Shield v2
 */

board.on("ready", () => {
  // Create a new `motor` hardware instance.
  const motor = new Motor({
    pins: [8, 9, 10],
    controller: "PCA9685",
    address: 0x60
  });

  // Inject the `motor` hardware into
  // the Repl instance's context;
  // allows direct command line access
  board.repl.inject({
    motor
  });

  // Motor Event API

  // "start" events fire when the motor is started.
  motor.on("start", () => {
    console.log(`start: ${Date.now()}`);

    // Demonstrate motor stop in 2 seconds
    board.wait(2000, motor.stop);
  });

  // "stop" events fire when the motor is started.
  motor.on("stop", () => {
    console.log(`stop: ${Date.now()}`);
  });

  // Motor API

  // start()
  // Start the motor. `isOn` property set to |true|
  motor.start();

});

```

&nbsp;

<!--remove-start-->

## License
Copyright (c) 2012-2014 Rick Waldron <waldron.rick@gmail.com>
Licensed under the MIT license.
Copyright (c) 2015-2023 The Johnny-Five Contributors
Licensed under the MIT license.

<!--remove-end-->
