rwaldron/johnny-five/docs/plugin.md

<!--remove-start-->

# Example plugin

<!--remove-end-->

Run this example from the command line with:
```bash
node eg/plugin.js
```

```javascript
module.exports = function(five) {
  return (function() {

    function Component(opts) {
      if (!(this instanceof Component)) {
        return new Component(opts);
      }

      // Board.Component
      //    - Register the component with an
      //      existing Board instance.
      //
      // Board.Options
      //    - Normalize incoming options
      //      - Convert string or number pin values
      //        to `this.pin = value`
      //      - Calls an IO Plugin's `normalize` method
      //
      five.Board.Component.call(
        this, opts = five.Board.Options(opts)
      );

      // Define Component initialization

    }

    // Define Component Prototype

    return Component;
  }());
};

/**
 *  To use the plugin in a program:
 *
 *  var five = require("johnny-five");
 *  var Component = require("component")(five);
 *
 *
 */

```

&nbsp;

<!--remove-start-->

## License
Copyright (c) 2012-2014 Rick Waldron <waldron.rick@gmail.com>
Licensed under the MIT license.
Copyright (c) 2015-2023 The Johnny-Five Contributors
Licensed under the MIT license.

<!--remove-end-->
