rwaldron/johnny-five/docs/proximity-EVS_EV3_IR.md

<!--remove-start-->

# Proximity - EVShield EV3 (IR)

<!--remove-end-->

Run this example from the command line with:
```bash
node eg/proximity-EVS_EV3_IR.js
```

```javascript
const { Board, Proximity } = require("johnny-five");
const board = new Board();

board.on("ready", () => {
  const proximity = new Proximity({
    controller: "EVS_EV3_IR",
    pin: "BBS1"
  });

  proximity.on("change", () => {
    const {centimeters, inches} = proximity;
    console.log("Proximity: ");
    console.log("  cm  : ", centimeters);
    console.log("  in  : ", inches);
    console.log("-----------------");
  });
});

```

&nbsp;

<!--remove-start-->

## License
Copyright (c) 2012-2014 Rick Waldron <waldron.rick@gmail.com>
Licensed under the MIT license.
Copyright (c) 2015-2023 The Johnny-Five Contributors
Licensed under the MIT license.

<!--remove-end-->
