rwaldron/johnny-five/docs/proximity-lidarlite.md

<!--remove-start-->

# Proximity - LIDAR-Lite

<!--remove-end-->

Basic LIDAR-Lite example.

##### Breadboard for "Proximity - LIDAR-Lite"

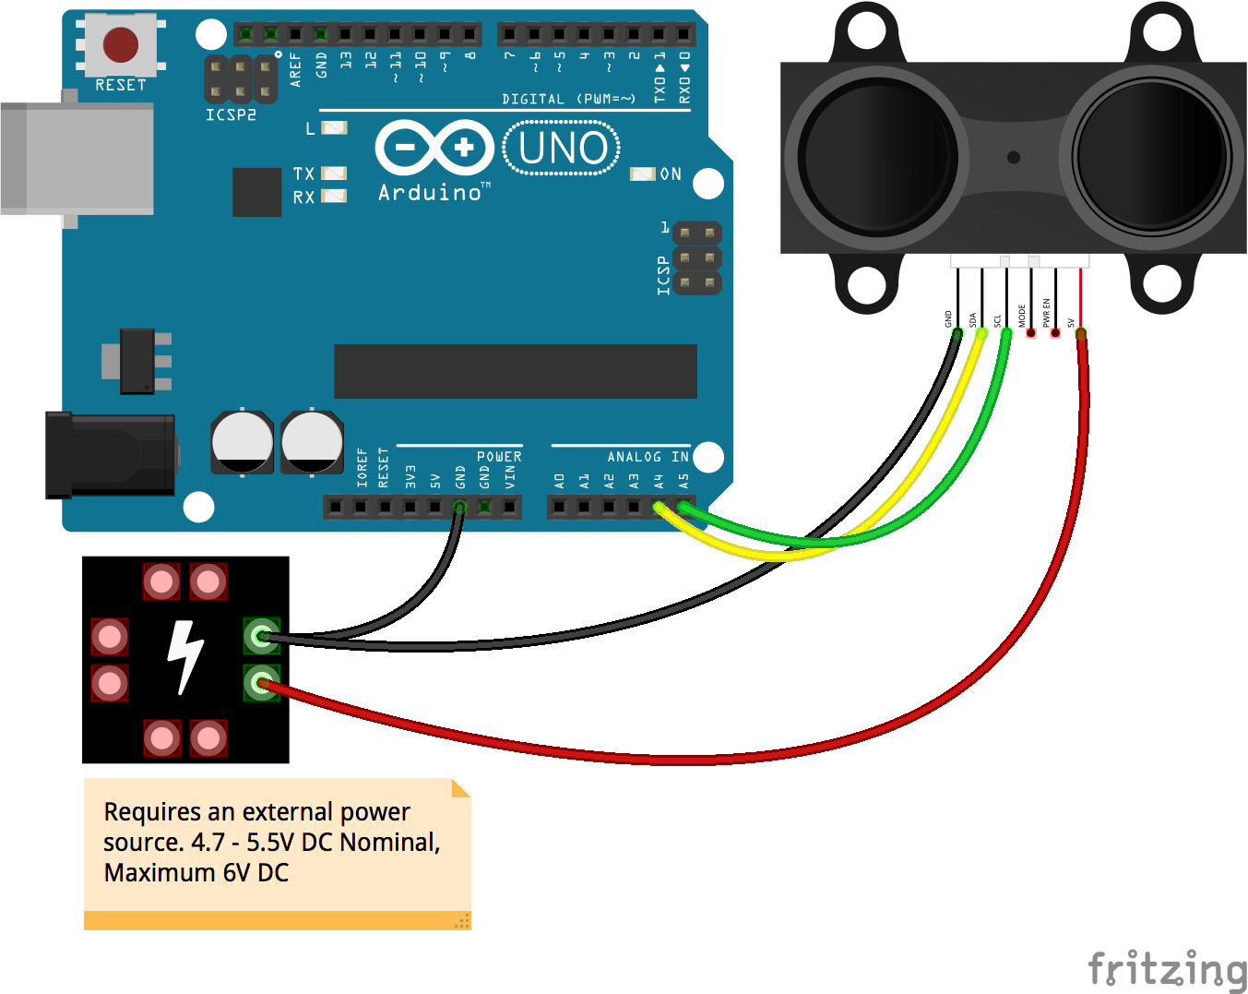
[picture p154: docs/breadboard/proximity-lidarlite.png]
<br>

Fritzing diagram: [docs/breadboard/proximity-lidarlite.fzz](breadboard/proximity-lidarlite.fzz)

&nbsp;

Run this example from the command line with:
```bash
node eg/proximity-lidarlite.js
```

```javascript
const { Board, Proximity } = require("johnny-five");
const board = new Board();

board.on("ready", () => {
  const proximity = new Proximity({
    controller: "LIDARLITE"
  });

  proximity.on("change", () => {
    const {centimeters, inches} = proximity;
    console.log("Proximity: ");
    console.log("  cm  : ", centimeters);
    console.log("  in  : ", inches);
    console.log("-----------------");
  });
});

```

&nbsp;

<!--remove-start-->

## License
Copyright (c) 2012-2014 Rick Waldron <waldron.rick@gmail.com>
Licensed under the MIT license.
Copyright (c) 2015-2023 The Johnny-Five Contributors
Licensed under the MIT license.

<!--remove-end-->
