rwaldron/johnny-five/docs/stepper-driver.md

<!--remove-start-->

# Stepper - Driver

<!--remove-end-->

##### Breadboard for "Stepper - Driver"

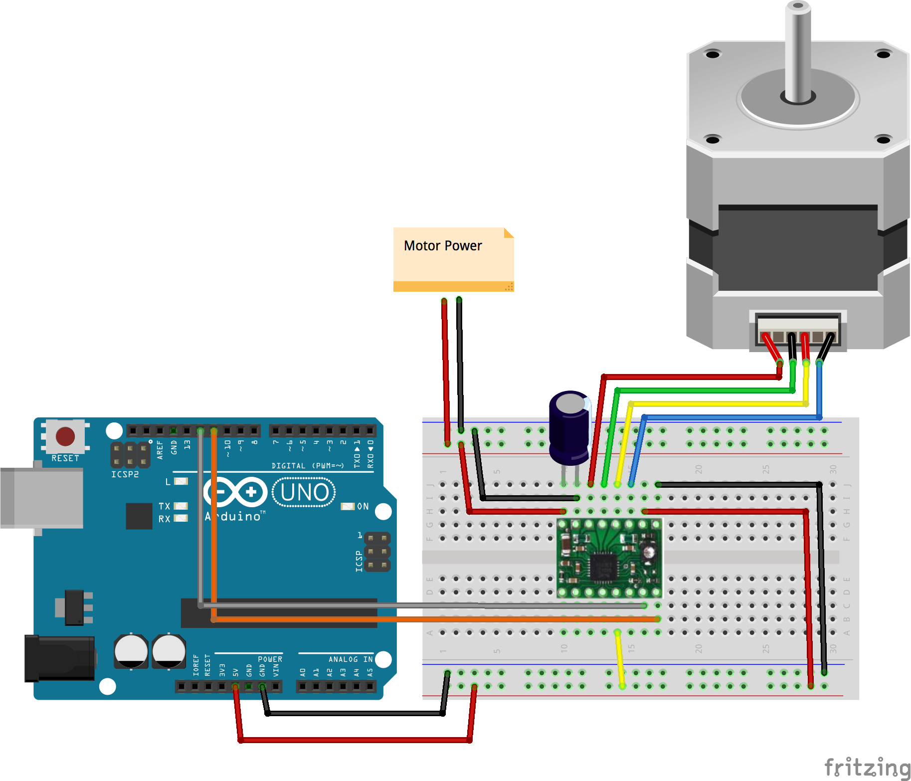
[picture p178: docs/breadboard/stepper-driver.png]
<br>

Fritzing diagram: [docs/breadboard/stepper-driver.fzz](breadboard/stepper-driver.fzz)

&nbsp;

Run this example from the command line with:
```bash
node eg/stepper-driver.js
```

```javascript
const {Board, Stepper} = require("johnny-five");
const board = new Board();

board.on("ready", () => {

  /**
   * In order to use the Stepper class, your board must be flashed with
   * either of the following:
   *
   * - AdvancedFirmata https://github.com/soundanalogous/AdvancedFirmata
   * - ConfigurableFirmata https://github.com/firmata/arduino/releases/tag/v2.6.2
   *
   */

  const stepper = new Stepper({
    type: Stepper.TYPE.DRIVER,
    stepsPerRev: 200,
    pins: {
      step: 12,
      dir: 11
    }
  });

  // Set stepper to 180 RPM, counter-clockwise with acceleration and deceleration
  stepper.rpm(180).ccw().accel(1600).decel(1600);
  
  // Make 10 full revolutions
  stepper.step(2000, () => {

    console.log("Done moving CCW");

    // once first movement is done, make 10 revolutions clockwise at previously
    //      defined speed, accel, and decel by passing an object into stepper.step
    stepper.step({
      steps: 2000,
      direction: Stepper.DIRECTION.CW
    }, () => console.log("Done moving CW"));
  });
});

```

## Additional Notes
- [A4988 Stepper Motor Driver Carrier](http://www.pololu.com/catalog/product/1182)
- [100uf 35v electrolytic cap](http://www.amazon.com/100uF-Radial-Mini-Electrolytic-Capacitor/dp/B0002ZP530)
- [Stepper Motor (4 wire, bipolar)](https://www.sparkfun.com/products/9238)


&nbsp;

<!--remove-start-->

## License
Copyright (c) 2012-2014 Rick Waldron <waldron.rick@gmail.com>
Licensed under the MIT license.
Copyright (c) 2015-2023 The Johnny-Five Contributors
Licensed under the MIT license.

<!--remove-end-->
