rwaldron/johnny-five/docs/temperature-lm35.md

<!--remove-start-->

# Thermometer - LM35

<!--remove-end-->

##### Breadboard for "Thermometer - LM35"

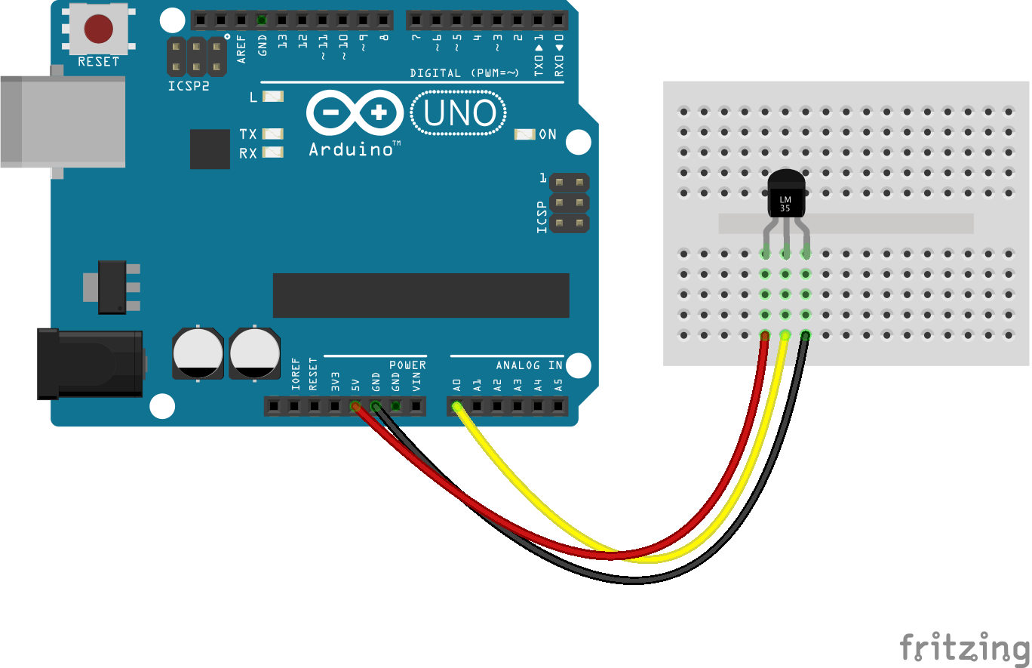
[picture p185: docs/breadboard/temperature-lm35.png]
<br>

Fritzing diagram: [docs/breadboard/temperature-lm35.fzz](breadboard/temperature-lm35.fzz)

&nbsp;

Run this example from the command line with:
```bash
node eg/temperature-lm35.js
```

```javascript
const { Board, Thermometer } = require("johnny-five");
const board = new Board();

board.on("ready", () => {
  const thermometer = new Thermometer({
    controller: "LM35",
    pin: "A0"
  });

  thermometer.on("change", () => {
    const {celsius, fahrenheit, kelvin} = thermometer;
    console.log("Thermometer");
    console.log("  celsius      : ", celsius);
    console.log("  fahrenheit   : ", fahrenheit);
    console.log("  kelvin       : ", kelvin);
    console.log("--------------------------------------");
  });
});

```

## Additional Notes
- [LM35 - Thermometer Sensor](http://www.ti.com/product/lm35)

&nbsp;

<!--remove-start-->

## License
Copyright (c) 2012-2014 Rick Waldron <waldron.rick@gmail.com>
Licensed under the MIT license.
Copyright (c) 2015-2023 The Johnny-Five Contributors
Licensed under the MIT license.

<!--remove-end-->
