rwaldron/johnny-five/assets/rmurphey-rock-paper-scissors.jpg

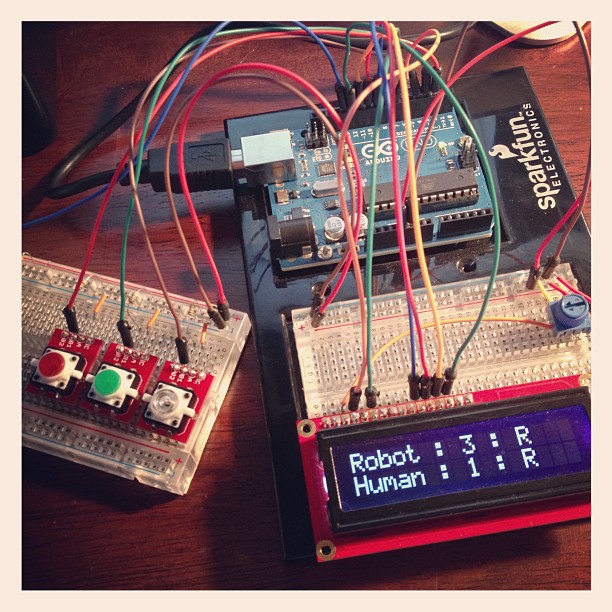
assets/rmurphey-rock-paper-scissors.jpg
