rwaldron/johnny-five/docs/images/beam-MB1000.gif

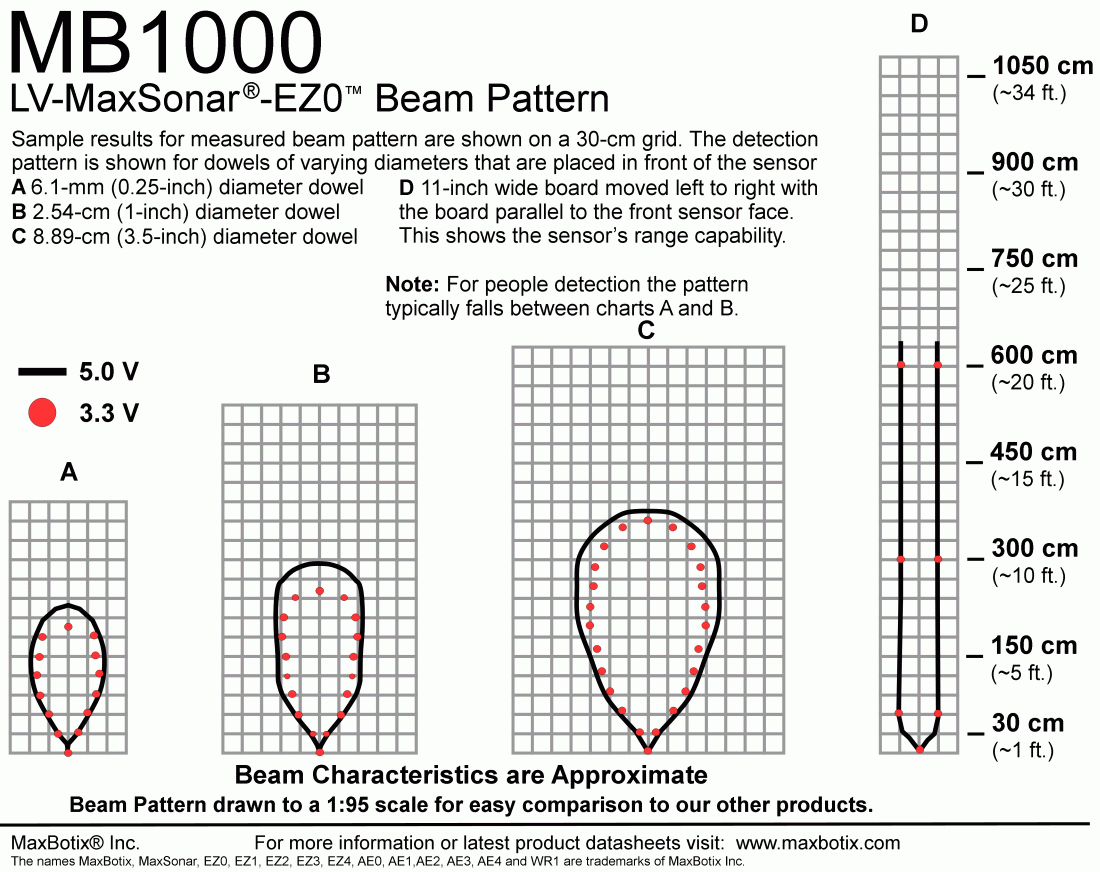
docs/images/beam-MB1000.gif
