rwaldron/johnny-five/docs/images/beam-MB1003.gif

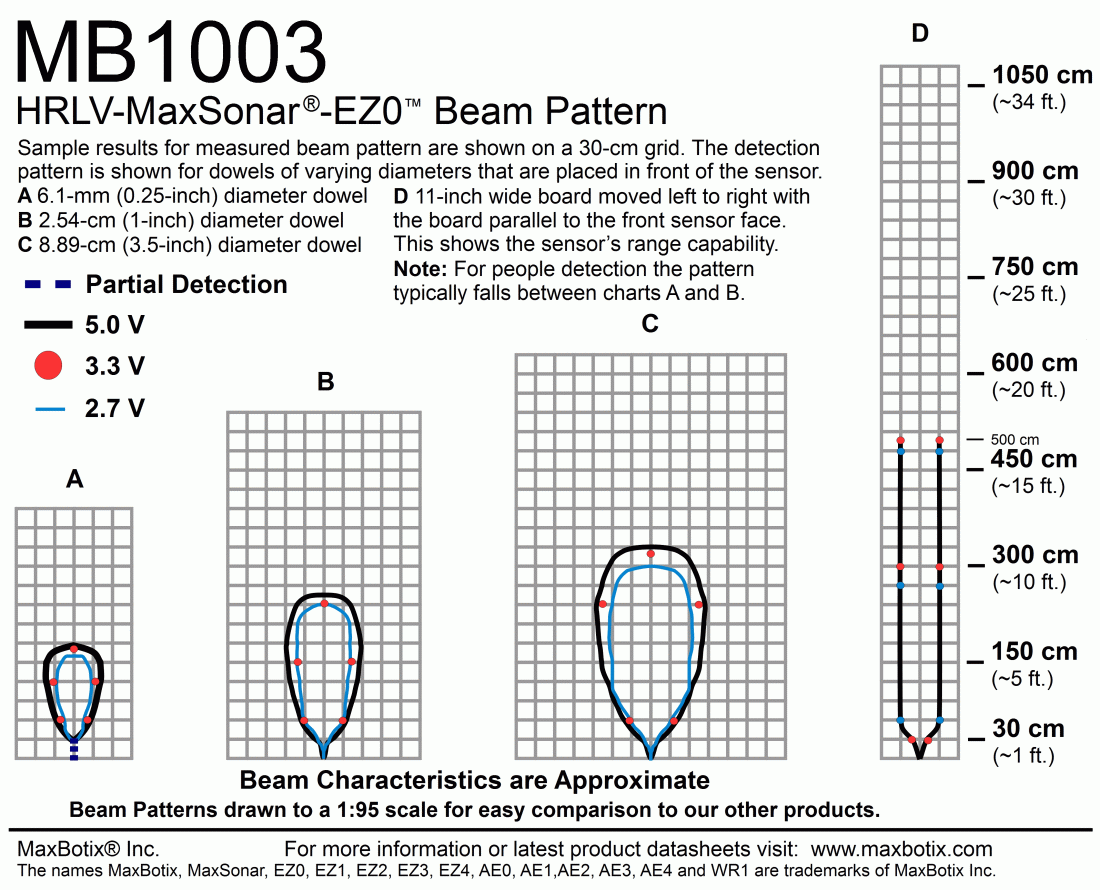
docs/images/beam-MB1003.gif
