rwaldron/johnny-five/docs/images/beam-MB1230.gif

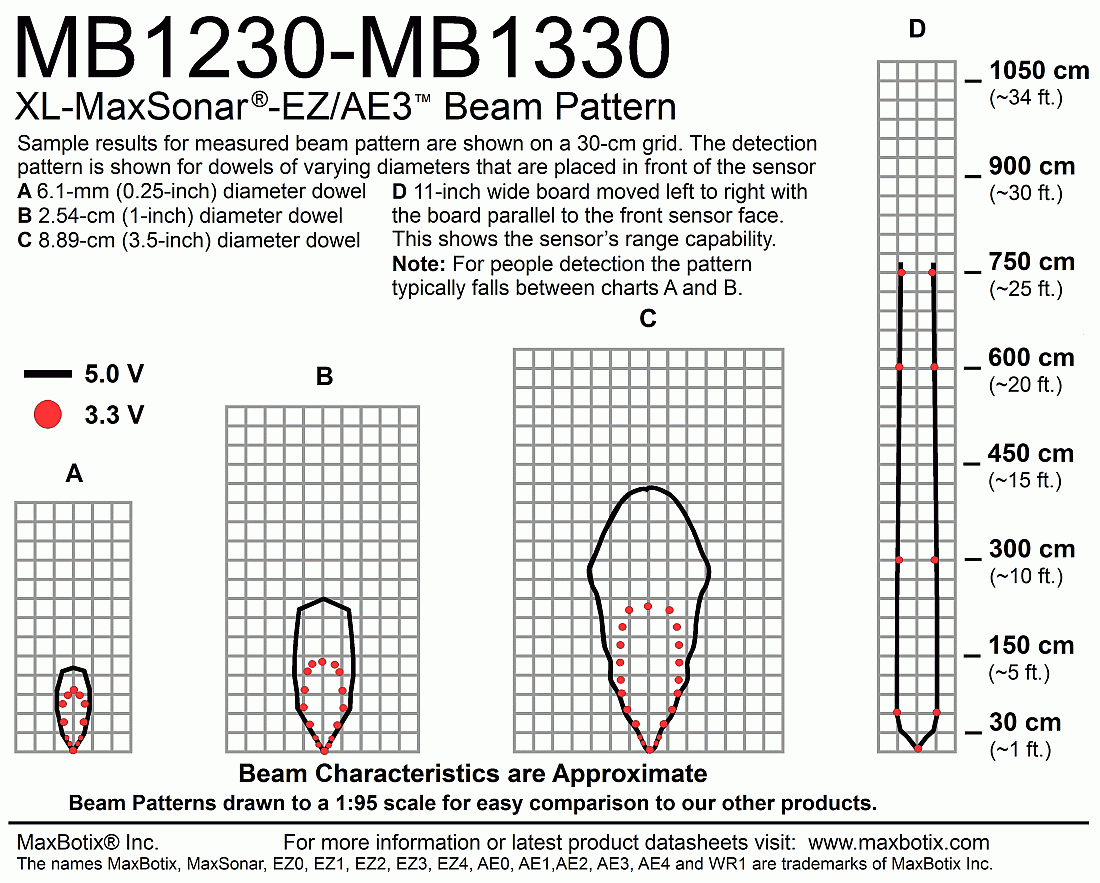
docs/images/beam-MB1230.gif
