rwaldron/johnny-five/docs/images/joystick.jpg

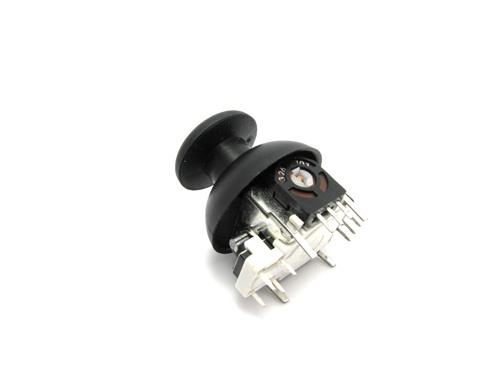
docs/images/joystick.jpg
