rwaldron/johnny-five/docs/images/mpr121_breakout_blue.jpg

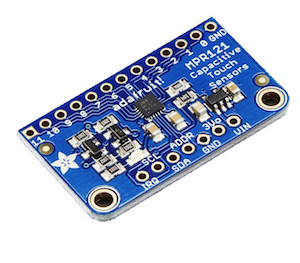
docs/images/mpr121_breakout_blue.jpg
