rwaldron/johnny-five/docs/images/mpr121_breakout_red.jpg

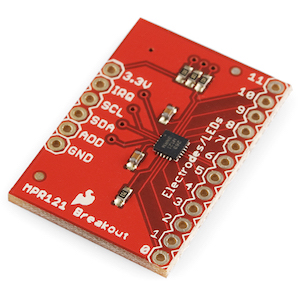
docs/images/mpr121_breakout_red.jpg
