rwaldron/johnny-five/docs/images/mpr121_keypad.jpg

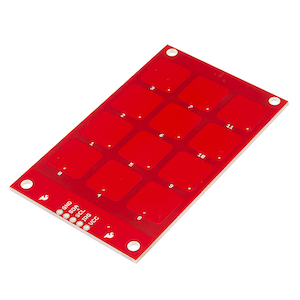
docs/images/mpr121_keypad.jpg
