rwaldron/johnny-five/docs/images/mpr121qr2.jpg

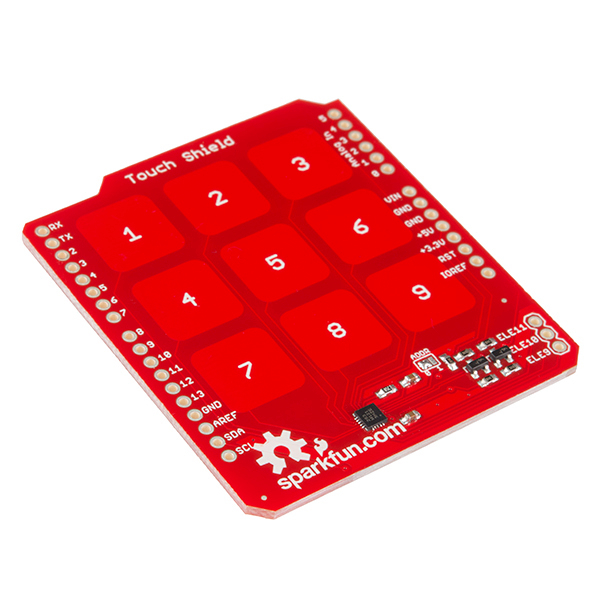
docs/images/mpr121qr2.jpg
