rwaldron/johnny-five/docs/images/tinkerkit-blink.png

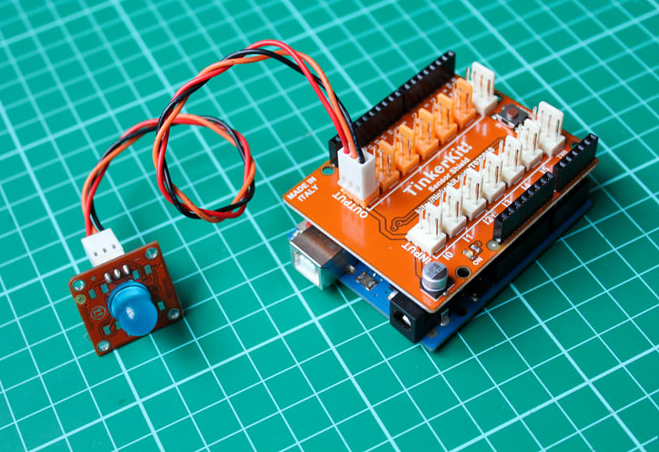
docs/images/tinkerkit-blink.png
