rwaldron/johnny-five/docs/images/tinkerkit-button.png

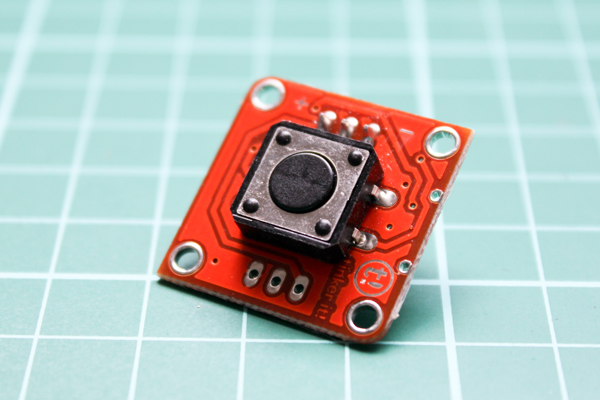
docs/images/tinkerkit-button.png
