rwaldron/johnny-five/docs/images/tinkerkit-continuous-servo.png

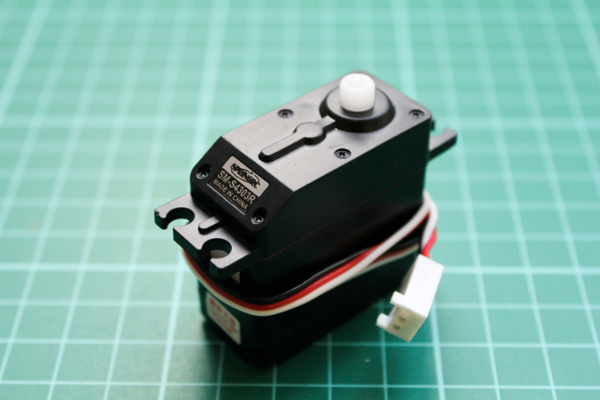
docs/images/tinkerkit-continuous-servo.png
