rwaldron/johnny-five/docs/images/tinkerkit-linear-pot.png

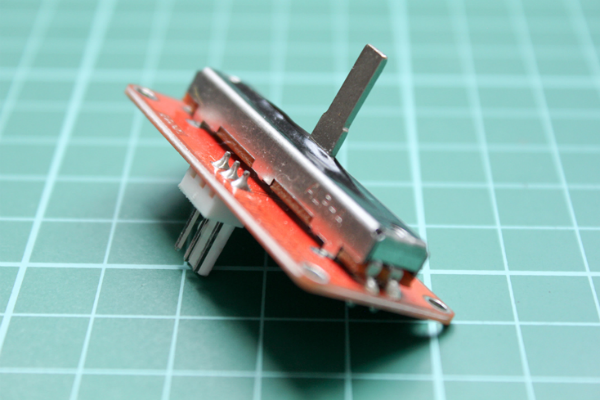
docs/images/tinkerkit-linear-pot.png
