rwaldron/johnny-five/docs/images/tinkerkit-rotary.png

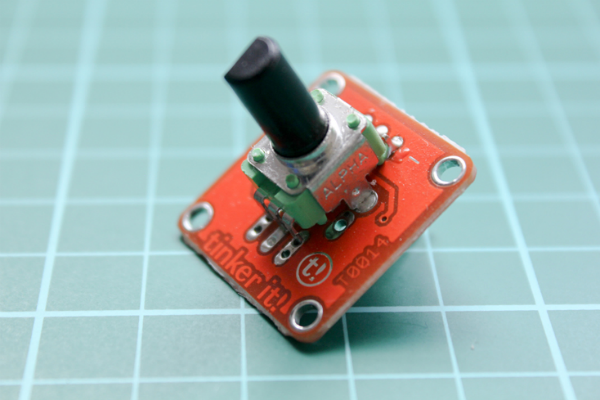
docs/images/tinkerkit-rotary.png
