rwaldron/johnny-five/docs/images/tinkerkit-thermistor.png

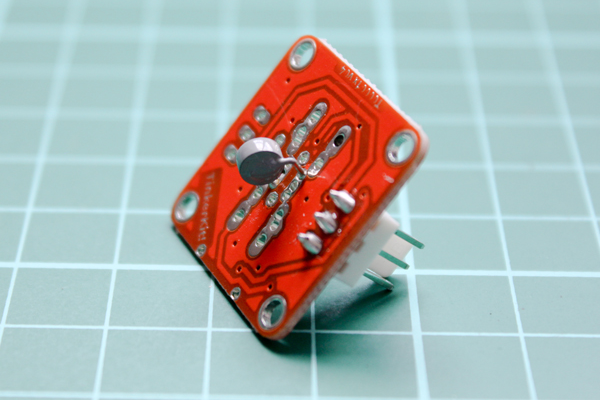
docs/images/tinkerkit-thermistor.png
