rwaldron/johnny-five/docs/images/tinkerkit-tilt.png

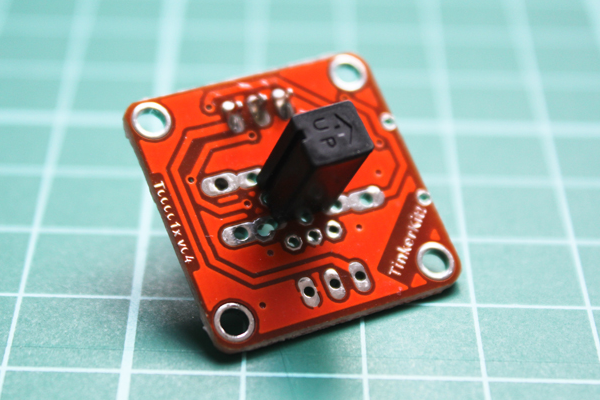
docs/images/tinkerkit-tilt.png
