rwaldron/johnny-five/docs/images/tinkerkit-touch.png

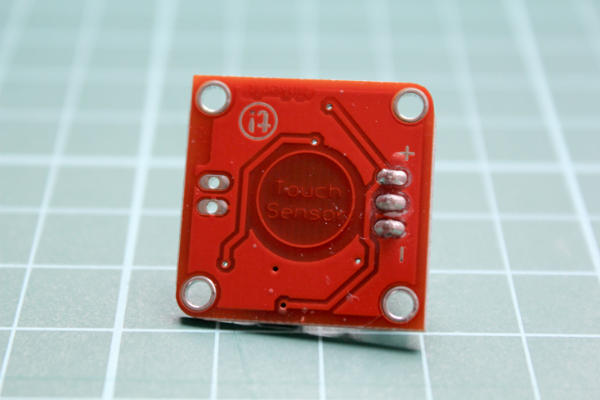
docs/images/tinkerkit-touch.png
