rwaldron/johnny-five/parts.md

# Easy "Getting Started"

- KIT-11576 [Sparkfun Inventor's Kit](https://www.sparkfun.com/products/12060) replaces [RTL-11236](https://www.sparkfun.com/products/retired/11236)
  * Follow the _Replaces_ link shown after the documents links for RTL-11236 for even older retired versions -- for references to software and documentation that may have changed in the later versions

# Parts

## Adafruit

- [Triple-Axis Accelerometer, ADXL326](http://www.adafruit.com/products/1018)
- [Motor Shield](http://www.adafruit.com/products/1438)
- [MaxSonar](https://www.adafruit.com/products/172)
- [Bumper Switch](https://www.adafruit.com/products/818)

## Amazon

- [Futuba Servo](http://www.amazon.com/Futaba-S3003-Servo-Standard/dp/B0015H2V72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)
- [Hitec HS322HD Servo](http://www.amazon.com/Hitec-33322S-HS-322HD-Standard-Karbonite/dp/B0006O3XEA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)
- [OSEPP I2C Expansion Shield](http://www.amazon.com/OSEPP-I2CSHD-01-I2C-Expansion-Shield/dp/B008MOOEA8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)
- [SainSmart Sensor Shield](http://www.amazon.com/SainSmart-Sensor-Digital-Arduino-Duemilanove/dp/B006TQ314G)

## DFRobot

- [Analog Slide Position Sensor](http://www.dfrobot.com/index.php?route=product/product&filter_name=slide&product_id=131)
- [I2C/TWI LCD1602 Module](http://www.dfrobot.com/index.php?route=product/product&filter_name=i2c/twi&product_id=135)
- [DFRobot LG-NS Gripper](http://www.dfrobot.com/index.php?route=product/product&filter_name=gripper&product_id=628#.UCvGymNST_k)

## Makershed

- [Getting Started with Arduino](http://www.makershed.com/Getting_Started_with_Arduino_Kit_V3_0_p/msgsa.htm)
- [Ultimate Microcontroller Pack](http://www.makershed.com/Ultimate_Microcontroller_Pack_p/msump.htm)

## Maxbotix

- **[XL-MaxSonar EZ/AE (MB1230)](http://www.maxbotix.com/products/XL-EZ.htm)**
- [LV-MaxSonar EZ1 (MB1230)](http://www.maxbotix.com/products/LV.htm)

## Parallax

- [Robot Bases](https://www.parallax.com/catalog/robotics/complete-robots)
- [2 Axis Joystick](https://www.parallax.com/product/27800)
- [5 Position Switch](https://www.parallax.com/product/27801)
- [Gripper Kit](https://www.parallax.com/product/28202)
- [PMB-648 GPS SiRF Internal Antenna](https://www.parallax.com/product/28501)
- [Ping))) Ultrasonic Distance Sensor](https://www.parallax.com/product/28015)
- [PIR Sensors](https://www.parallax.com/search?search_api_views_fulltext=pir+sensor)
- [Standard Servo](https://www.parallax.com/product/900-00005)
- [Continuous Servo](https://www.parallax.com/product/900-00008)
- [Tank Tread Kit](https://www.parallax.com/product/28106)

## Sparkfun

- [Triple Axis Accelerometer, ADXL345](https://www.sparkfun.com/products/9836)
- [Arcade Joystick](http://www.sparkfun.com/products/9136)
- retired [Laser Card Module - Red](http://www.sparkfun.com/products/594)
- [Laser Module - Green](https://www.sparkfun.com/products/9906)
- [Pan/Tilt Bracket](http://www.sparkfun.com/products/10335)
- [Robotic Claw](http://www.sparkfun.com/products/10332)
- replaced and retired [Robotic Claw Pan/Tilt Bracket](http://www.sparkfun.com/products/10826)
- [Servo Extension Cable - Female to Female (shrouded)](http://www.sparkfun.com/products/8738)
- [Servo Cable - Female to Female](http://www.sparkfun.com/products/9187)
- [Servo - Medium](http://www.sparkfun.com/products/10333)
- [Servo - Medium Full Rotation](http://www.sparkfun.com/products/10189)
- [Servo - Small](http://www.sparkfun.com/products/9065)
- [SoftPot Membrane - 50mm](http://www.sparkfun.com/products/8680)
- [Triple Axis Magnometer/Compass HMC5883L](https://www.sparkfun.com/products/10530)
- [Wiper/Actuator - 1N to 3N Force](http://www.sparkfun.com/products/9075)

# Tools

- [LadyAda's Toolkit](https://www.adafruit.com/products/136) (I don't have this, but it's basically the same as all of the tools I have)
- [Panavise Vaccuum Base stand](http://www.amazon.com/PanaVise-209-Vacuum-Base-Jr/dp/B000CONJUM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)
- [Panavise Junior](http://www.amazon.com/PanaVise-Model-201-Junior-Miniature/dp/B000B61D22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)
