rwaldron/johnny-five/test/extended/README.md

# Extended Tests

Tests in this directory have risk of being long-running or otherwise failing on builds or slow hardware and are not run as part of the default test command.
