rwaldron/johnny-five/tpl/.changelog.md

| Commit | Message/Description |
| --- | --- |
<%= rows %>
