rwaldron/johnny-five/(threads)

Thread 112 (2013-04-13):

Adding DHT11 or DHT22 sensor support

piotrfalba, 2013-04-13:
It would be great to have DHT11 humidity, temperature sensor support.

BrianGenisio, 2015-01-01:
It looks like the [DHT11Firmata](https://github.com/firmata/arduino/blob/configurable/examples/DHT11Firmata/DHT11Feature.cpp) extension uses the `RESERVED_COMMAND` message ([0x00](https://github.com/firmata/arduino/blob/configurable/examples/DHT11Firmata/DHT11Feature.h#L24)) with a specific address to report the data.  As far as I can tell, there is no way of getting to that command in `firmata.js`.  Or am I missing something?

I think we need to send a PR to firmata.js along with this, to support `RESERVED_COMMAND` handling in some way.  Looks like we need to set the `pinMode` to `0x7E` and then listen to `RESERVED_COMMAND` messages with that `0x7E` address.

The `Temperature` controller would look something like this, where `readReserved` (or something similar) would be a new function in firmata.js.

```js
var ADDRESS = 0x7E,
var LENGTH = 5;
io.readReserved(ADDRESS, LENGTH, function(data) {
  var pin = data[0];
  var temp = read16(data[1], data[2]);
  var humidity = read16(data[3], data[4]);
});
```

Or am I off in the weeds, drinking too much Gulden Draak on NYE?  This doesn't feel right. What does `readReserved` look like to other board IO layers that don't actually speak Firmata?  Is there already a way of doing this in firmata.js that I am overlooking?

(P.S. I don't always hack/program near midnight on NYE... sick wife and kids... canceled plans... waiting for midnight... celebrating the new year by myself and hacking.  Why not look into reading data from humidity sensors?)

soundanalogous, 2015-01-01:
DHT11Firmata will be getting a command ID soon. ConfigurableFirmata features that wrap 3rd party libraries will be separate repositories. The proof-of-concept is here (temporarily): https://github.com/soundanalogous/DHT11Firmata. I'll be moving this to the [firmata organization](https://github.com/firmata) once I have all of the details figured out.

Regarding the command ID I need to determine if devices should get an ID in the existing 0x0F - 0x7F range which will not scale well, or if I designate a single command ID to mean "device" or a range of IDs to classify types of devices (sensor, actuator, radio, etc). The later 2 options will add a second byte to the protocol, the former option would not but it's possible at some point to run out of values.

BrianGenisio, 2015-01-01:
OK, so it sounds like J5 should wait for Firmata before we support this
device.
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

soundanalogous, 2015-01-01:
You may also want to consider this I2C temp + humidity sensor: https://www.adafruit.com/products/1293. The advantage of using an I2C device over something like the DHT11/22 is that the processing is offloaded to the client device. This avoids having to add significant delays to the main loop in the Firmata code running on the Arduino.

zanechua, 2015-05-21:
Any updates on this?

soundanalogous, 2015-05-23:
I'm still working out the details for 3rd party contributed libraries. Once that is settled I can add DHT11/22 support to Firmata.

kevbost, 2015-08-03:
Commenting for update update?  Just got a DHT22 in the mail and then discovered this thread.

soundanalogous, 2015-08-03:
I need to revisit this. I moved on to other tasks before finalizing the addressing scheme for 3rd party Firmata libraries. Additional input on the proposal would help get the process started again: https://github.com/firmata/ConfigurableFirmata/issues/16.

dtex, 2015-12-07:
Cross referencing: https://github.com/firmata/arduino/pull/246

jerwallace, 2016-04-08:
Hey all.. +1 for DHT22 support... It's been a while since the last post.. Any updates here?

soundanalogous, 2016-04-08:
There will be no Firmata device support until more people weigh in on and there is a concrete resolution here: https://github.com/firmata/ConfigurableFirmata/issues/16

rwaldron, 2016-04-08:
In addition to @soundanalogous's information, johnny-five supports DHT11 via I2C backpack, as shown here: https://github.com/rwaldron/johnny-five/issues/1068#issuecomment-200933572

reconbot, 2016-08-23:
Looks like we have two solutions with some broader discussions for the future.

DeanMW, 2016-10-13:
Any update on this yet?

gedeagas, 2016-10-14:
@DeanMW not yet.

rwaldron, 2016-10-14:
@DeanMW @gedeagas Sorry for the delay, it turned out to be a lot more work than I thought. I've tested the latest version using all three: DHT11, DHT21 and DHT22. Be sure to follow the diagrams in the examples, make sure you load the provided firmware onto the nano (or whatever uC you prefer)

- http://johnny-five.io/examples/multi-DHT11_I2C_NANO_BACKPACK/
- http://johnny-five.io/examples/multi-DHT21_I2C_NANO_BACKPACK/
- http://johnny-five.io/examples/multi-DHT22_I2C_NANO_BACKPACK/

michalvankodev, 2017-07-08:
Hello there,

I am going to read from DHT-22 sensor connected to raspberry. AFAIK DHT-22 doesn't have to be connected through I2C. For example this module will do exactly what I want https://github.com/momenso/node-dht-sensor. But I'd like to use DHT with johnny-five.

Can you recommend an alternative approach I should choose? Should I create a new analog thermometer and supply my own `toCelsius` function?

Thanks for reply

rwaldron, 2017-07-12:
> AFAIK DHT-22 doesn't have to be connected through I2C.

You're right DHT-22 doesn't have to be connected through I2C, but when using it with Johnny-Five, it does and always will. The reason for this is still the same as it was in 2013:

> rwaldron commented on Jul 3, 2013
> The code required to make this work requires too many process blocking delays

> For example this module will do exactly what I want https://github.com/momenso/node-dht-sensor

That module includes compiled add-on code that ultimately appears to do the same thing that Johnny-Five's backpack firmware does.

cesaragusto-dev, 2019-04-15:
Any solution to make DHT11 communicate without IC2 with J5?

dtex, 2019-04-17:
@cesaragusto-dev No (see the comment just before yours). Assuming you are using firmata on an Arduino compatible device, the i2c backpack is the most practical solution.

Closed 2016-08-23.

Thread 380 (2014-06-06):

Adafruit Motor Shield Support

brandonaaskov, 2014-06-06:
My particular use case is to drive a [12V stepper motor](https://www.adafruit.com/product/324). I have the [AdvancedFirmata](https://github.com/soundanalogous/AdvancedFirmata) that I need. Even have the motor shield and Arduino on two separate power supplies. But I realized I have no idea how to address the pins with this thing. The motor terminals I'm using are "M3" and "M4" but that doesn't tell me which PWM pins to use.

Then I read this...

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

Give that, is this something that would get support at the firmata level? This is a bit low-level for me, so I'm just barely treading here.

I don't think it makes a difference, but here's my code for reference:
```js
var five = require("johnny-five"),
    board = new five.Board()

board.on("ready", function() {
  var options = {
    type: five.Stepper.TYPE.DRIVER,
    stepsPerRev: 200,
    pins: [11, 12]
  }

  var stepper = new five.Stepper(options)
  stepper.step(1000, function() {
    process.exit(1)
  })
})
```

brewh0use, 2015-05-01:
Have you ever had a chance looking into this again? I was hoping to hook up a stepper motor the adafruit motor shield, but haven't had any luck so far :-(

rwaldron, 2015-05-01:
@dtex are you still working on this?

dtex, 2015-05-01:
No, but I did get a 12V stepper motor to test with.

brewh0use, 2015-05-08:
Please let me know if there is any way I can help. Happy to test with the motors that I have available.

rwaldron, 2015-05-08:
I hate to pass the buck, but if you want to get unblocked, the EasyDriver or the Pololu Drivers work great ;)

spokke, 2015-06-24:
hi all... i'm developing a automower and have adafruit shield 4 motors connected to mega.. i'd like to know if i can connect through johnny ... thank you ...

rwaldron, 2015-06-24:
@spokke which adafruit shield motor shield? v1 or v2?

dtex, 2015-06-24:
The V1 shield should also work with a Mega per the Adafruit site and both V1 and V2 are supported by Johnny-Five.

BrianGenisio, 2015-06-24:
The V1 shield supports stepper and servo connections in addition to regular motors.  When I wrote the V1 driver (ShiftRegister), I only got regular motors working.  IIRC, the code for steppers is a bit more complicated than regular motors, but not as much.  They both use the shift registers to use 3 pins to control lots more.  The Motor.js:Controllers["ShiftRegister"] code was loosely based off of this code: https://github.com/adafruit/Adafruit-Motor-Shield-library/blob/master/AFMotor.cpp

spokke, 2015-06-24:
thank for all response ....
the shield is this http://www.amazon.it/gp/product/B00E19VXR0?psc=1&redirect=true&ref_=oh_aui_detailpage_o02_s00 ... i will try soon ..
which pin must i use ? thank you

BrianGenisio, 2015-06-24:
That is a V1 shield.

rwaldron, 2015-06-24:
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

spokke, 2015-06-24:
ok i will take an example and try in a few days (i hope) :)

BrianGenisio, 2015-06-24:
Again, this shield won't work with Stepper motors without writing new code
inside J5. It will only work with regular motors.
B

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

spokke, 2015-06-24:
Ok i need for normal motor no stepper

Inviato da iPhone

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

reconbot, 2016-08-23:
I'm going to close this issue due to it's age, but if you'd like to continue with it feel free to comment and we'll reopen.

trentrand, 2020-05-03:
For those who landed here looking for help with the Adafruit Motor/Stepper/Servo Shield V2, it is now supported in Johnny-Five. See the example here: https://github.com/rwaldron/johnny-five/wiki/Motor#adafruit-motorstepperservo-shield-v2

Closed 2016-08-23.

Thread 391 (2014-06-16):

Button isPullup option relies on AVR implementation details

fivdi, 2014-06-16:
I hope I'm not doing too much guessing but here's what I believe to be true:

The following piece of code from [button.js](https://github.com/rwaldron/johnny-five/blob/master/lib/button.js#L50-L61) relies on an AVR implementation detail and has the potential of resulting in (possibly serious?) issues on non-AVR platforms:

``` js
  // Set the pin to INPUT mode
  this.mode = this.io.MODES.INPUT;

  // Option to enable the built-in pullup resistor
  this.isPullup = opts.isPullup || false;

  this.io.pinMode(this.pin, this.mode);

  // Enable the pullup resistor after setting pin mode
  if (this.isPullup) {
    this.io.digitalWrite(this.pin, this.io.HIGH);
  }
```

The AVR implementation detail it relies on is the fact that the pullup resistor for an input pin can be enabled by writing 1 to that pin.

So, if opts.isPullup is true, when the line:

``` js
this.io.digitalWrite(this.pin, this.io.HIGH);
```

is executed, it doesn't actually write 1 to the pin, it enables the pullup resistor. This, of course, is fine on AVR platforms such as the Arduino Uno. What happens on other platforms depends on how digitalWrite is implemented.

Here's the current implementation from [galileo-io](https://github.com/rwaldron/galileo-io/blob/master/lib/galileo.js#L247-L257):

``` js
Galileo.prototype.digitalWrite = function(pin, value) {
  var pinIndex = ToPinIndex(pin);

  if (this.pins[pinIndex].mode !== this.MODES.OUTPUT) {
    this.pinMode(pin, this.MODES.OUTPUT);
  }

  this.pins[pinIndex].write(value);

  return this;
};
```

and here's the current implementation from [beaglebone-io](https://github.com/julianduque/beaglebone-io/blob/master/lib/beaglebone.js#L266-L277):

``` js
BeagleBone.prototype.digitalWrite = function (pin, value) {
  var pinIndex = this.normalize(pin);
  var port = this.pins[pinIndex].port;

  if (this.pins[pinIndex].mode !== this.MODES.OUTPUT) {
    this.pinMode(pin, this.MODES.OUTPUT);
  }

  this.pins[pinIndex].value = value;
  b.digitalWrite(port, value);
  return this;
};
```

Instead of enabling the pullup resistor, both of these implementations will change the pin mode from input to output and then write 1 to that output. This has the potential of resulting in (possible serious?) issues. Depending on how the button is wired up, pressing/releasing the button will result in the 5v output being connected to 0v which is not a good idea.

I tried this out on the BeagleBone WITHOUT a button connected up. Fortunately, the attempt to change the pin mode from input to output isn't successful. I didn't try it on any other platforms.

reconbot, 2016-08-23:
Seems related to #363

fivdi, 2017-04-08:
This is no longer a bug, it's a feature :) There are now IO plugins like Raspi-IO that configure pullup/pulldown  resistors when `digitalWrite` is called for an input pin. See [here](https://github.com/nebrius/raspi-io-core/blob/1.1.1/src/index.js#L575-L588).

Closed 2017-05-20.

Thread 420 (2014-07-31):

johnny-five camera support

josephfinlayson, 2014-07-31:
I have one of these (Miniature TTL Serial JPEG Camera with NTSC Video):

https://www.adafruit.com/products/1386

Is it possible to get these working with johnny-five?

YesPapa, 2015-05-14:
Hello,

What about this issue? Is it possible to use the johnny-five library with a camera?

Thank you.

rwaldron, 2015-05-14:
Johnny-Five itself does not support a generic camera, as it's out of scope for the framework. I recommend using [node-opencv](https://github.com/peterbraden/node-opencv) along with Johnny-Five to create robots with camera capabilities. I'm building a rover that uses an ffmpeg stream via websockets to the browser display: https://www.youtube.com/watch?v=xr7hjaZHKFU

YesPapa, 2015-05-14:
Ok. Thank you.

soundanalogous, 2015-05-14:
I have serious doubts that SoftwareSerial support in Firmata would support a camera. It would be better handled by wrapping the Adafruit library and then requesting the buffer from Firmata than trying to relay the buffer data through SoftwareSerial.

tawalke, 2017-11-08:
This issue was a few years ago, I was curious if anything has changed on this front.  I have the Grove Serial Camera Kit and the Grove Fingerprint Sensor.  Both capture images and it would be great to have all my code using the J5 framework for these on multiple devices.

dtex, 2017-11-08:
@rwaldron wrote:
> Johnny-Five itself does not support a generic camera, as it's out of scope for the framework.

We probably should have closed this back then. Please don't take this as a rebuke, it's just a function of what Johnny-Five is intended to be. Rather than an all-things for everyone solution, johnny-five focuses on lower level devices (servos, motors, sensors, etc) and embraces the node/npm ecosystem for more complex and device or manufacturer specific support.

Johnny-Five is not particularly opinionated about how you write your code. It's just Javascript with a healthy helping of events and call backs so it will play nice with other libraries.

Rather than just closing the issue, I want to at least point you in the right direction. Are you using an Arduino Uno connected to your computer over USB or something more?

tawalke, 2018-01-12:
Hi @dtex : Thanks for not closing the issue and your response.  You are right it did kinda sound like a rebuke initially, but I get it.  I had a deadline so I rewrote all the code completely over in C and took out the JS parts to finish quickly since I had a deadline.

However, I would love to help people in my situation that would love to use Johnny-Five with specific sensors so I would LOVE to be pointed in the right direction.  Is there a way for me to take my C code used for specific sensors and convert it to JavaScript for use in the Johnny-Five framework.  I'm sure it would help others looking to use J5 for a holistic across different devices.

Please advise how I can and should go about this.

BTW: I was building a solution that needed to work across 5 different types of sensors and that's why this option was so attractive to me.  The devices were was Raspberry Pi3, BeagleBone Black, custom Qualcomm, ESP8266-12E, and Intel device for legacy work.

dtex, 2018-01-12:
I think the concern raised by @soundanalogous is the first thing that needs to be addressed. He's a smart cookie and knows firmata better than.. well.. anyone else on earth, so his comment warrants serious consideration.

In short, can softwareSerial in firmata even support the camera?

Serial support landed in firmata (for Arduino's and most Arduino compatible devices) a while back so we have everything we need to try it out and it sounds like you might be our motivated contributor.

> Please advise how I can and should go about this.

So part of the battle is making sure you are sending all the appropriate commands to get the camera up and running, and that you are listening for the appropriate commands and knowing what to do with them. You've got all that handled in C, so it's just a matter of porting your code (no magic there).

Next would be making sure that you know how to send and receive serial data in Johnny-Five. The only class in J5 that has code for working with serial is GPS and I think [this code block](https://github.com/rwaldron/johnny-five/blob/master/lib/gps.js#L265-L298) will be the most valuable to help you get up and running.

dtex, 2018-01-12:
Oh, and I'm going to close this issue but not because it is going away. We've added [a new wiki page](../wiki/Requested-Features] that tracks all of our new feature, device, class and module requests in a single place. If anything, it should make it easier for new contributors to find issues to work on. We can also group issues with those feature requests so everyone can see the demand for those that are most wanted.

tawalke, 2018-01-13:
Thanks!! Checking out the wiki page and the code now.

developer239, 2018-06-26:
+1 😄

developer239, 2018-06-26:
@rwaldron Could you please explain how to use opencv and arduino together? I have no experience with IOT so I am slowly trying to read as much information as possible for a project that I have in my mind.

I have experience with https://github.com/justadudewhohacks/opencv4nodejs though.

If I understand it correctly we only need to:
1. connect a camera to Arduino UNO R3
2. initialize `johny-five`
3. then use the camera with opencv:
```
const devicePort = 0;
const wCap = new cv.VideoCapture(devicePort);
```

Is this correct?

Closed 2018-01-12.

Thread 530 (2014-12-13):

ESC

carldanley, 2014-12-13:
I'm trying to use this ESC: https://traxxas.com/products/parts/otherparts/xl5waterproof. I have jumper wires that run from the ground and input on the ESC to the arduino. The arduino is being powered by my macbook (over USB) and the ESC is being powered properly with the RC car's battery.

I'm running this code:
```
const five = require('johnny-five');
const board = new five.Board();

board.on('ready', function() {

  // ENGINE
  const motorServo = new five.Servo({
    pin: 10
  });

  this.repl.inject({
    s: motorServo
  });

});
```

From the repl, I can run `s.to(90)` to stop the motor. I can increase the speed from 90 to 160 where 160 is the maximum speed (35mph) for the RC car.

The RC car is supposed to be able to reverse and I've found that no matter what values I use, I cannot switch from forward to reverse and back. I've gotten both directions to work independently but I do not know what I did to get them to work.

Any suggestions or ideas as to what I need to be doing for this to work properly?

landshark22, 2015-03-21:
Did anyone ever solve this problem? We are having a few issues communicating with our ESC including getting reverse to work properly.

rwaldron, 2015-03-21:
No, not yet. @carldanley was going to ship his bot to me so I could work on it... not sure if that's still the plan. I just bought an ESC that has reverse capabilities—that will be here on Tuesday, which is the soonest I can work on this. I appreciate your patience :)

rwaldron, 2015-03-21:
I just found this on another site...

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

Have you tried calibrating like this?

carldanley, 2015-03-22:
@rwaldron Thanks for the reminder! Email me your address so I can send my RC car your way.

rwaldron, 2015-03-22:
@carldanley let's hold off on that. I have a bidirectional ESC on it's way, so it might be able to solve this without needing your entire RC car :D

rwaldron, 2015-03-24:
Just an update: my speed controller arrived, so I can start working on this on my end.

carldanley, 2015-03-24:
Awesome, let me know if you need anything. I can also test code on my end as well.

landshark22, 2015-03-24:
Update from us as well. We played with it a bit more after I posted this the other day and we were able to figure out we do have reverse. I have not yet tried the calibration procedure above.

I don't have my notes in front of me, but as far as I remember this is what we came up with for the HobbyKing ESC mentioned previously.

50 was the start/reset point.
45-54 Motor would not spin

Forward:
55-85 was the adjustable speed range moving forward.
85-100 no noticeable increase in speed for us.

Reverse:
46-30 If I remember correctly, this was the adjustable range in reverse, I'll double check my notes when I get home, but I do remember the range was minimal as compared to forward.
29-0 Motor would not spin (again I will check these values)

Some interesting notes:

if you set a forward value say 60 and set the next value at 35 the motor would stop almost like popping a circuit breaker. at this point no value forward or reverse would spin the motor. We would then need to send the value of 50 to "reset" the ESC and then we were able to enter af FWD or REV value. Of course most people would not be controlling a motor like this, just thought it was an interesting point to note.

rwaldron, 2015-03-24:
Your notes here are really helpful (thank you), they confirm the understanding I've come to have for 3 stage (Forward, Brake, Reverse) brushed motor speed controllers. Specifically: the forward window is greater, with a larger range and speed capability, than the reverse range.

> if you set a forward value say 60 and set the next value at 35 the motor would stop almost like popping a circuit breaker. at this point no value forward or reverse would spin the motor.

This unit likely has an internal BEC that's sensing a jump and automattically shutting down. These are commonly built in to protect all components that are connected to the controller.

I've just ordered two more speed controllers to keep testing, they should be here tomorrow.

carldanley, 2015-03-24:
@landshark22 do you have some sample code (maybe a gist) of the portion that controls the ESC? I want to test your calculations from my end as well.

rwaldron, 2015-03-24:
@carldanley this is useful, if you have a speed controller programmer:  http://www.axialracing.com/blog_posts/787000000

I made it into an Arduino C program as well:

```ino
#include <Servo.h>

#define MAX 2000
#define MIN 1000
#define NEUTRAL 1500
#define MOTOR_PIN 11

Servo esc;

int aV = 0;
int sV = 0;
int lV = 0;
int step = 0;

void setSpeed(int speed) {
  esc.writeMicroseconds(speed);
}

void setup() {
  Serial.begin(9600);

  esc.attach(MOTOR_PIN);
}

void loop() {
  // To reset the process, type a character into the serial monitor and press <enter>
  while (Serial.available()) {
    step = 0;
    aV = 0;
    Serial.read();
    Serial.println("Reset");
  }

  int v = analogRead(A0);

  if (v != aV) {
    aV = v;
    lV = sV;
    sV = map(v, 0, 1023, MIN, MAX);

    if (sV == MAX && step == 0) {
      Serial.println("Hold speed at MAX and turn on Speed Controller");
      setSpeed(sV);
      step = 1;
    }

    if (sV == MIN && step == 1) {
      Serial.println("Hold speed at MIN");
      setSpeed(sV);
      step = 2;
    }

    if (sV == NEUTRAL && step == 2) {
      Serial.println("Hold speed at NEUTRAL");
      setSpeed(sV);
      step = 3;

      delay(2000);
      step = 0;
    }

    if (step == 0) {
      setSpeed(sV);
    }
  }
}
```

(Hook up a rotary potentiometer to A0)

landshark22, 2015-03-25:
>This unit likely has an internal BEC that's sensing a jump and automattically shutting down. These are commonly built in to protect all components that are connected to the controller.

@rwaldron I figured it was something like that.

@carldanley, this is what we've been using and I'll preface this by saying I don't know if it's right, I just now it's been working, I am starting from 0 in coding my daughter is just as green as I am so we struggled for a while to get this to work:

```
var five = require("johnny-five");
var board = new five.Board();

board.on("ready", function() {

  var esc = new five.ESC(9);
  range: [ 0, 100 ];

  this.repl.inject({
    esc: esc
  });
});
```

and we use the following command to adjust speed

```
esc.speed (60)
```

rwaldron, 2015-03-25:
Whoa, this is awesome—there is a line of code that does literally nothing, but it's **totally** valid syntax! Check it out:

```js
range: [ 0, 100 ];
```

This is effectively a no-op, because `range:` is parsed as _LabelledStatement_, whose _Statement_ is just an _Expression_ (_ArrayInitializer_).

Ok, enough nerding out... You don't actually need to set that range for ESC—`[0, 100]` is the default :)

```js
var five = require("johnny-five");
var board = new five.Board();

board.on("ready", function() {

  var esc = new five.ESC(9);

  this.repl.inject({
    esc: esc
  });
});
```

landshark22, 2015-03-25:
Cool, that's great. We'll try that out. When things started moving we stopped messing with the code :)

A little more info that may or maynot be helpful but worth adding I suppose.

We have the motor/ESC connected to an Arduino Mega, the Mega is connected via USB to a Raspberry Pi 2 running Raspian. We are connected to the Ras Pi 2 via the ethernet connection and sending commands and editing the .js files using Orion also installed on the Pi. So far seems like everything is playing together nicely.

Our ultimate goal is to get this working with a game controller of some sort over the network along with a browser interface. Our project is an Underwater ROV.

rwaldron, 2015-03-25:
All information is useful :)

This sounds like an awesome project! I'll report back later today

rwaldron, 2015-03-25:
Great news: I was able to figure out bidirectional control today. Additionally, I spent time with ESC, updating it to the controller model and adding support for PCA9685 (that's in review right now)

rwaldron, 2015-03-25:
@carldanley I don't think "sport mode" will ever be supportable in any reasonable sense. "Sport Mode – Fwd / Brake / Rev", from what I've learned, this requires a "double tap" of the throttle—1 to brake and then it can be reversed. This isn't meant to be programmed by any code on any platform, this is for use with transmitter + receiver. "Training Mode" which splits the range into 50% forward and 50% reverse is supportable programmatically.

carldanley, 2015-03-26:
That is excellent news. For knowledge purposes, are you mentioning that sport mode is only available when a transmitter/receiver is used? Is that some feature that the transmitter makes available to us? Sorry for the confusion.

Also, for the bidirectional support, did you need to modify anything in j5 for this to work OR did you adjust values until it worked like @landshark22 has been mentioning?

rwaldron, 2015-03-26:
No, it's available, it's just something you did with your figure, and not with code. Johnny-Five needed some changes, I'll be pushing those soon

rwaldron, 2015-03-26:
Here's a bit more detail...

----

The "Forward, Brake, Reverse" setting on all of the speed controllers that I've looked at in the last couple of days requires a "flick of the trigger finger" because it assumes you're using something like one of these:

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

So you'd be pushing the throttle **Forward**; when you want to reverse you need to "flick" the throttle toward **Reverse** once and let it snap back to neutral, which is **Brake**. Once the throttle has snapped back to neutral, you can pull the throttle stick/trigger to **Reverse** the motor.

----

The "Forward, Reverse" setting assumes the same controllers above, BUT this can also easily be programmed for, as there is no "double tap into reverse" necessary. There is a neutral pulse (the center of the max and min pulse); **Forward** is neutral -> max (stopped -> full speed) and **Reverse** is neutral -> min (stopped -> full speed).

Resseguie, 2015-03-26:
Just a clarifying remark for those not familiar with these transmitters. The concept of "pushing the throttle forward" applies to the second type that Rick shows. It's physically reversed in the trigger style transmitter where you "pull the trigger" to drive forward and "push the trigger away from you" to brake/reverse. Wanted to make sure we didn't get confused with physical direction of the throttle mechanism and the direction the vehicle drives.

Resseguie, 2015-03-26:
(this stuff is hard to describe in just text!)

rwaldron, 2015-03-26:
Oh man, while I wrote that I was describing the physical act—as I actually did it in real life—with the the second style controller. Thanks for the additional clarification, because THAT would've been confusing :D

carldanley, 2015-03-26:
This makes total sense now; thanks for taking the time to explain it @rwaldron!

@Resseguie - you're absolutely right; just one of those things that's difficult to read through.

landshark22, 2015-03-29:
Ok, great news

bur here's couple of a really stupid newb questions.

1. How do I check the currently installed version of johnny-five (installed on a Ras Pi 2 running Raspian)

tried:

```
johnny-five -v
```
and received a "command not found" error

2. How do I upgrade to the latest?

I attempted this:
```
sudo apt-get update
```
and then:
```
sudo apt-get upgrade johnny-five
```
lots happened just not sure if we got the latest.

Not only are we new to coding also new to Linux.

rwaldron, 2015-03-30:
> bur here's couple of a really stupid newb questions.

:P no such thing.

> johnny-five -v

There is no Johnny-Five binary, if your project has a package.json, then presumably that file has the version installed listed?

> sudo apt-get upgrade johnny-five

Johnny-Five isn't a package that's available this way.

----

The patch for this ESC issue isn't released yet, I'm waiting to try a few more ESCs. Once it is, then you'll be able to update on the Pi with:

```
npm install johnny-five
```

Hopefully this helped?

landshark22, 2015-03-31:
It did thanks.

rwaldron, 2015-03-31:
Great!

Closed 2015-04-06.

Thread 606 (2015-01-29):

support for RTC (real-time clock)

boneskull, 2015-01-29:
A popular (I think?) RTC chip is the DS1307.  It's included in many (several? some?) data logger shields.

I'm working on support for interfacing w/ the DS1307 directly, but this is my first encounter with I2C, and I am having trouble translating the Arduino library (`Wire` calls) to the J5 equivalent.  Any general tips would be helpful here, since the docs seem kind of slim in this area unless I missed something.

I *think* the implementation should be a `Controller` in a new `RTC` (or `Clock` perhaps) class, maybe even the `DEFAULT` one.  I imagine tests, docs, and a trivial example are expected.

Is there anything else I need to know?

dtex, 2015-01-29:
Firmata has a handful of I2C methods you can call so you shouldn't have to worry about the wire stuff. Check out the methods here:

https://github.com/jgautier/firmata#i2c

boneskull, 2015-01-29:
@dtex Yes, but I'm having trouble figuring out the library for this thing that uses `Wire`; the mapping between what method *there* corresponds to what method *here*.

dtex, 2015-01-29:
It might be easier to get the I2C info straight from the [DS1307 docs](http://datasheets.maximintegrated.com/en/ds/DS1307.pdf)

boneskull, 2015-01-29:
@dtex I'm looking at that, but as I said, I have not encountered I2C before, so I'm just kind of flailing.

rwaldron, 2015-01-29:
Can you post a link to the component you're working with? (so I can follow along :D)

rwaldron, 2015-01-29:
First of all, I like the idea of being able to interact with a real time clock, but I'm wondering what advantage this has over system time in ms available to JS via `Date.now()`. RTC components are generally used with platforms that have no "built-in" notion of time (beyond the "time since this processor started"). Johnny-Five runs in an environment that already has access to time.

To clarify, I didn't bring this up to discourage you, I just want to talk about these aspects and get a better idea of use cases and so forth.

boneskull, 2015-01-29:
It's [this](http://www.maximintegrated.com/en/products/digital/real-time-clocks/DS1307.html).

It's included in [this shield](https://www.adafruit.com/products/1141), which I have a rough Chinese clone of.

boneskull, 2015-01-29:
@rwaldron The clock is used by the data logger to record the time when logging.  Given what you just wrote, I'm having a hard time envisioning a use case outside of this.  Perhaps it's better just to go with #607 instead of this.

boneskull, 2015-01-29:
Sh*tcanning this for reasons discussed in #607.

rwaldron, 2015-01-29:
So, I think it might be fun for you to do this anyway, just to get an understanding for how the I2C API and semantics work :) I looked up some super raw examples and discovered that reading these devices is pretty straight forward (cursory look, I might be wrong). Either way, in the end you'll have learned how to use the I2C functionality :)

rwaldron, 2015-01-29:
I will get this one https://learn.adafruit.com/ds1307-real-time-clock-breakout-board-kit/overview

rwaldron, 2015-01-29:
j/k, I got this one: http://www.amazon.com/Real-Time-Clock-Module-DS1307/dp/B00BLC3C2Y

aabm00, 2017-02-08:
Hi

In my project I am running Johnny-five in an Arduino Yun, and have to send data to a server every 30 seconds with the real date and time. It's a real-time application controlling machines and an accurate date-time is important.
The problem with Yun is that it hasn't a real time clock, so it cannot track the time when it is off. While booting, the Linux side makes some educated guesses of the current date/time by checking the modification time stamps on key files, but it doesn't really know the time until it has an Internet connection and can query an NTP server (sometimes it doesn't work), or until you manually set the date and time .
The most reliable method to make sure the Yun has the correct local time is to add a battery backed up RTC chip to it.

I have had problems with YUN sending data with date of 20/07/2015 so it would be fine to have a J5 implementation of [DS1307](https://www.adafruit.com/product/3296) and/or [DS3231 ](https://learn.adafruit.com/adafruit-ds3231-precision-rtc-breakout/overview) to this use cases when the date is important and the board with connection to internet doesn't have a real time RTC clock.

Thanks

Closed 2015-01-29.

Thread 622 (2015-02-15):

Supporting L298 H-Bridge Motor Control board

dulichan, 2015-02-15:
Hi guys,
I looked around the Motor documentation and the source code to see if [L298 H-Bridge Motor controller] (http://blog.pennybuying.com/down/f/F815A.pdf) is supported. I tried to see if this was similar to the Arduino Motor Shield but seems like it has a different concept.

There are 2 channels. Channel A has 3 pins. One pin is the PWM pin. The other 2 pins are IN1 & IN2. When IN1 is HIGH and IN2 is LOW - the motors move forward. When IN1 is LOW and IN2 is HIGH- the motors reverse. How does it map with the Johnny Five motor implementation?

Below implementation seems to be working but I am using a PIN object to set the PWM pin to HIGH.
```
	var pinA = new five.Pin(10);
	var motor =
		new five.Motor({
	       pins: {
	         pwm: 2,
	         dir: 3
	       }
	     });

	pinA.high();
	motor.forward();
```

What's the correct way to use it without using a PIN object?
Cheers~

dulichan, 2015-02-15:
Hi guys,
I figure it out. We have to use a cdir property. Below is my example.
```
var motorA = new five.Motor({
        pins: {
            pwm: channelA.pin,
            dir: channelA.dir,
            cdir: channelA.cdir
        }
    });
```

channelA.pin - ENA
channelA.dir - IN1
channelA.dir - IN2
Cheers~

dtex, 2015-02-15:
@dulichan

Here is an example of that style motor shield.

https://github.com/rwaldron/johnny-five/blob/master/docs/motor-3-pin.md

dulichan, 2015-02-15:
Thanks @dtex

dtex, 2015-02-15:
Ha, I was two seconds too late. Glad you found it.

cookiengineer, 2017-05-09:
For the sake of clarity when others are googling for this issue, as it took me around 3 hours of shitty internet tutorials to figure out:

The wiring of the L298N for _two_ motors is different than expected or explained in all related issues.

PWMs that are used (outer pins on L298N) are `Pin 9` and `Pin 10` on the Arduino. `Pin 2 to 5` are the digital control channels (inner pins on L298N).

With my setup it's also important to know  that the `Voltage Jumper` on the L298N being connected means it runs in `7.5V - 8V` for my DC motors. Less voltage (all tutorials say 5V) is not working.

Might be obvious to advanced users, but unknown to noobs like me: If you don't have a common ground connected to the L298N AND the Arduino's GND Pin (next to pin 13), the L298N will stay dead and don't react to the PWMs as they need a common GND.

```javascript
const _five = require('johnny-five');
const _board = new _five.Board({
    port: '/dev/ttyUSB0' // change on OSX or Windows
});

_board.on('ready', function() {

    let motor_l = new _five.Motor({
        pins: {
            pwm: 9,
            dir: 2,
            cdir: 3
        }
    });

    let motor_r = new _five.Motor({
        pins: {
            pwm: 10,
            dir: 4,
            cdir: 5
        }
    });

    motor_l.forward(255);
    motor_r.reverse(255);

});
```

dtex, 2017-05-09:
Hello @cookiengineer

It sounds like you were using the L298N IC directly and not a breakout board or shield. So, one of these thingies:
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
If so, it sounds an example for the L298N that is similar to [this on for the SN754410](http://johnny-five.io/examples/motor-hbridge/) would have prevented your frustration correct?

Closed 2015-02-15.

Thread 627 (2015-02-19):

Johnny-Five < -- > Ethernet < -- > Arduino

henricavalcante, 2015-02-19:
Can I use something like this to connect to Arduino?

https://github.com/peterschwarz/standard-firmata-ethernet

soundanalogous, 2015-02-20:
That library uses an old version of StandardFirmata so I wouldn't recommend it, but it will work with the version of Firmata you already have installed in your Arduino application. You can use [ConfigurableFirmata](https://github.com/firmata/arduino/releases/tag/v2.6.2) to use Firmata over Ethernet but it requires installing a new version of Firmata (which is recommended).

However, [node-firmata](https://github.com/jgautier/firmata), which is what johnny-five uses to interface with an Arduino board running Firmata, currently only supports a Serial interface, you'd have to update it to support Ethernet.

To use ConfigurableFirmata with Ethernet, [see this gist](https://gist.github.com/soundanalogous/3d6d3d3f76e3a529e2cc) and follow the instructions posted in the first comment.

henricavalcante, 2015-02-20:
Ok @soundanalogous, thanks for the light, I'll try to do something.

rwaldron, 2015-02-22:
This thread has inspired me to finally work on making Firmata.js capable of using alternative communication transports. Hopefully will have something by tomorrow :)

monteslu, 2015-02-22:
Only issue I've had using different communication transports with firmata is that johnny-five doesn't currently emit a ready event without flagging the firmata instance with isReady=true
This works now: https://gist.github.com/monteslu/6ef34e8ec01e7e5675e2

Pretty much any node stream or [virtual serial port](http://blog.iceddev.com/2014-12-05-remotebots-cutting-the-cord-with-remote-io.html) will work.

soundanalogous, 2015-02-22:
I can work on StandardFirmataEthernet.

rwaldron, 2015-02-22:
@monteslu tried your gist with ConfigurableFirmata (with remote_ip, local_ip set) and it won't connect, it's possible I'm doing something wrong, but I didn't spend much time with it.

I've been working on `EtherPort`, which is a wrapper around some logic that creates a socket with  `net.createServer`. Connecting executes perfectly, but nothing happens when I try to digital write (led blinking of course)

rwaldron, 2015-02-22:
https://github.com/rwaldron/etherport

monteslu, 2015-02-22:
@rwaldron sorry about that didn't mean to imply there isn't work to do on the arduino side. Just that not a lot had to change on the firmata.js side for it to work.

 Still need to channel the ethernet data to what would otherwise be serial input on the device. @jacobrosenthal has done a bunch work in this area on various sketches.

soundanalogous, 2015-02-23:
I've created a version of StandardFirmata with Ethernet that is working with Rick's Etherport example.

Assumes you have an Arduino Uno or Arduino Ethernet board or Ethernet shield (or other compatible ethernet board / shield).

1. Checkout the [ethernet branch](https://github.com/firmata/arduino/tree/ethernet) from firmata/arduino, run release.sh and copy the contents of the appropriate .zip file to your Arduino core libraries folder, overwriting the existing Firmata library.
2. Open the StandardFirmataEthernet (SFE) example and perform the following:
  - Change the IP address on line 39 to match the IP address of the computer running the etherport example
  - Either comment out line 48 or set the IP address if your Ethernet  shield (both options are working for me)
  - Update line 50 to add the mac address of your Ethernet shield
3. Compile and upload
4. Open eg/blink.js in the etherport repo and change the pin number to something other than 10, 11, 12 or 13 (I used 2... submitted a pull request for same change) and wire an LED to that pin.
5. Run eg/blink.js in the etherport repo

I'm using Norbert Truchsess' EthernetClientStream which will maintain a connection and reconnect if dropped. This also enables the arduino client to be running before the node server is started and vice versa.

rwaldron, 2015-02-23:
@soundanalogous successful runs with the "blink.js" example in EtherPort, with digital pin 2:

- StandardFirmataEthernet.ino-2.4
- ConfigurableFirmata.ino-2.6

mcinnes01, 2015-03-09:
@rwaldron thanks for your clear steps I've been looking to be able to do this for ages and within about 20 minutes I'm able to control my arduino over ethernet with johnny-five. I've been trying to do this with octoblu and microblu_mqtt for ages but to no avail. Are there likely to be some features coming soon and in terms of stability where would you say this is up to? Like octublu I like the idea of being able to assign UUID's and tokens makes the connecting and addressing process a little easier/more secure. Resolving to name servers would also be really cool.

Many thanks

Andy

rwaldron, 2015-03-09:
@mcinnes01 are you using [etherport](https://github.com/rwaldron/etherport)?

mcinnes01, 2015-03-09:
@rwaldron I am indeed, its great well done!

rwaldron, 2015-03-09:
Excellent :)

DonPancoe, 2015-06-04:
I can't get the blink.js test to work with johnny-five and etherport. When I try to run it, I get a connection timeout as shown below. I have StandardFirmataEthernet 2.4.3 flashed on the board (an Atmega328P-based [DFRobot XBoard V2](http://www.dfrobot.com/index.php?route=product/product&product_id=564#.VW-3W89VhBc)). I can ping the board's IP address, but when I try PortQry at that address on port 3030, I get "FILTERED" ("LISTENING" is what I'd hope to see).

I am using Arduino IDE 1.6.4, and have node.js, johnny-five and etherport installed. Any help would be appreciated as I'm diving into a number of new topics at once, here.

**Example command line output:**
C:\Program Files\nodejs\nodebot>node blink.js
1433382815040 SerialPort Listening on port: 3030
1433382815043 Connected Listening on port: 3030
1433382825045 Device or Firmware Error A timeout occurred while connecting to the Board.

Please check that you've properly flashed the board with the correct firmware.
See: https://github.com/rwaldron/johnny-five/wiki/Getting-Started#trouble-shooting
events.js:85
      throw er; // Unhandled 'error' event
            ^
Error: A timeout occurred while connecting to the Board.
    at Board.<anonymous> (C:\Program Files\nodejs\node_modules\johnny-five\lib\board.js:406:26)
    at Timer.listOnTimeout (timers.js:110:15)

C:\Program Files\nodejs\nodebot>

soundanalogous, 2015-06-04:
As long as the Wiznet chip on the XBoard is wired exactly the same way to the ATMega328 as it is with an Arduino Ethernet shield, then the XBoard should work. If SS is wired to a different pin on the XBoard than it is with an Arduino ethernet shield, then you may have an issue.

Did you make the appropriate changes in [lines 101 - 119 of StandardFirmataEthernet](https://github.com/soundanalogous/Breakout/tree/master/custom_examples)?

soundanalogous, 2015-06-04:
Actually the SS pin shouldn't make a difference here since there is only one SPI device in use.

DonPancoe, 2015-06-04:
Thanks for the reply.

I did make the necessary changes in StandardFirmataEthernet, but you might be onto something with your pin number question. The DFRobot board does match the standard Arduino pinouts, but the TQFP32 version of the Atmega328P does have a different pin numbering scheme than the DIP28 version as shown below. Could I need to modify board.h to account for this? Has anyone already done a board.h for a TQFP-based Arduino such as the Uno SMD Edition?

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

DonPancoe, 2015-06-04:
Also, I was curious why some of the comments (I forget which file, exactly) stated that StandardFirmataEthernet ignores requests related to D4. Does XCK/TO also have something to do with communication to the Wiznet chip? D4 is on pin 6 of the DIP28 but on pin 2 of the TQFP32. Thanks again.

soundanalogous, 2015-06-04:
There are some other Arduino compatible boards that use the TQFP32 package of the ATMega328p. I think the underlying avr-gcc library figures out that difference somehow.

The arduino ethernet shield has an SD card attached to D4 which is why it has to be ignored, but only for the ethernet shield. You can comment out lines 814, 826 and 827 in StandardFirmataEthernet.

One thing to try is running a few of the Ethernet library examples (not with J5, just on their own) in the Arduino IDE. Open File -> Examples -> Ethernet. Do they all work as expected?

soundanalogous, 2015-06-04:
Another thing to try is using the DFRobot board with johnny-five using the serial connection. Does that work without issue?

DonPancoe, 2015-06-04:
Thanks for the new info. It may take me a few days, but I will get around to trying your suggestions and reporting what I find.

rwaldron, 2015-06-04:
Sorry to jump in so late, but can you provide the exact code you're running that produces the error above? That will also be super helpful for @soundanalogous and I (or anyone else) to help you out :) Thanks!

DonPancoe, 2015-06-04:
Sorry for leaving that out. It was the test code from the EtherPort github README.md but with the LED pin changed.

var five = require("johnny-five");
var EtherPort = require("etherport");
var board = new five.Board({
  port: new EtherPort(3030)
});

board.on("ready", function() {
  var led = new five.Led(13);
  led.blink(500);
});

rwaldron, 2015-06-04:
This needs to be documented, but @soundanalogous mentioned above:

> Open eg/blink.js in the etherport repo and change the pin number to something other than 10, 11, 12 or 13 (I used 2... submitted a pull request for same change) and wire an LED to that pin.

I don't recall why this is the case, and I'm not sure if/how it matters to your case, but can you try a pin that isn't one of those?

soundanalogous, 2015-06-04:
Pin 13 is one of the SPI pins, so trying to blink that pin will mess up the communication with the Ethernet driver.

soundanalogous, 2015-06-04:
However Firmata ignores requests to change Pin 13 when using the Ethernet library so that would not cause an error here. You just wouldn't see the LED blink.

soundanalogous, 2015-06-04:
Actually it looks like Firmata is not ignoring digital writes, only set pin mode request. Try changing the LED pin to 2 or 8. If that works then I have a bug in Firmata to fix.

DonPancoe, 2015-06-05:
Quick report since it is late...

Changing the LED to pin 8 did not fix the Ethernet version. Got the same error messages as above.

The following Arduino IDE Ethernet examples all worked on the XBoard over Ethernet: UDPSendReceiveString, WebServer & ChatServer.

The following javascript blink file did work over serial with StandardFirmata flashed on the XBoard and the LED on pin 13.

var five = require("johnny-five");
var board = new five.Board();

board.on("ready", function() {
  // Create an Led on pin 13
  var led = new five.Led(13);
  // Blink every half second
  led.blink(500);
});

DonPancoe, 2015-06-05:
It may also be worth noting that the built-in LED on the board (pin 13) does blink two times then four times immediately after flashing the board with StandardFirmata, correctly indicating that I am using version 2.4. When I flash the board with StandardFirmataEthernet, this does not happen. Instead, the LED just glows dimly but continuously, occasionally turning off for a while then coming back on.

soundanalogous, 2015-06-05:
I just tested the same code with StandardFirmataEthernet v2.4.3 and an Arduino ethernet shield connected to an Arduino Uno. I found that I had to comment out [line 29 in index.js of the etherport module](https://github.com/voodootikigod/node-serialport#to-install) because it was throwing a TypeError on the `emit` method. After that everything was working as expected. Also had to use node v0.10 instead of node v0.12. Make sure you're using node v0.10 and that you aren't getting errors regarding the `emit` method. Otherwise the only difference between my setup and yours could possible be a difference in the bootloader that would cause a longer startup time for the DFRobot board, but the documentation says it's using an Uno bootloader. Also the fact that the Ethernet examples worked should rule out any difference in wiring.

soundanalogous, 2015-06-05:
Also, pin 13 doesn't do the version blink when using StandardFirmataEthernet. I suspect the Ethernet library sets pin 13 to digital input once the library is included so you shouldn't see it blink at all. The fact that you see the LED fading on and off makes me wonder if you are supplying enough current to your board. Try a higher current power supply if you have one, or if you're just using USB, then try a 5V 1A input instead.

rwaldron, 2015-06-05:
> Also had to use node v0.10 instead of node v0.12.

I wonder why?

I've just ordered a [DFRobot XBoard V2](http://www.dfrobot.com/index.php?route=product/product&product_id=564#.VW-3W89VhBc)

DonPancoe, 2015-06-07:
Finally got a chance to revisit this. I've downgraded to Node.js 0.10.38, I'm powering the board with a 2A USB charger and I've commented out line 29 of index.js (*this.emit("open");*). Unfortunately, I'm still getting the command line response shown below. Is there another debug method that I'm missing? I'm not seeing anything coming over the UART.

Also, when I did downgrade to 0.10.38 and tried to npm install etherport, I got the following:
*npm WARN package.json etherport@0.1.2 No repository field.*

Thanks again for the help.

**Command Line Output**
C:\Program Files\nodejs>node blink.js
1433646895438 SerialPort Listening on port: 3030
1433646895440 Connected Listening on port: 3030
1433646905443 Device or Firmware Error A timeout occurred while connecting to the Board.

Please check that you've properly flashed the board with the correct firmware.
See: https://github.com/rwaldron/johnny-five/wiki/Getting-Started#trouble-shooting

Error: A timeout occurred while connecting to the Board.
    at Board.<anonymous> (C:\Program Files\nodejs\node_modules\johnny-five\lib\board.js:406:26)
    at Timer.listOnTimeout [as ontimeout] (timers.js:112:15)

C:\Program Files\nodejs>

DonPancoe, 2015-06-07:
Realizing that I still had my laptop's WiFi switched on, which sometimes causes gateway conflicts with devices connected to the RJ45 Ethernet port, I tried it again with WiFi switched off. It still didn't work, but I realized that - because of how this comment system handles markups - a bit of the information being returned wasn't making it into my posts. I think I've fixed that now.

**Command Line Output**
C:\Program Files\nodejs>node blink.js
1433648154025 SerialPort Listening on port: 3030
1433648154027 Connected Listening on port: 3030
1433648164030 Device or Firmware Error A timeout occurred while connecting to the Board.

Please check that you've properly flashed the board with the correct firmware.
See: https://github.com/rwaldron/johnny-five/wiki/Getting-Started#trouble-shooting

Error: A timeout occurred while connecting to the Board.
    at Board.\<anonymous\> (C:\Program Files\nodejs\node_modules\johnny-five\lib\board.js:406:26)
    at Timer.listOnTimeout \[as ontimeout\] \(timers.js:112:15\)

C:\Program Files\nodejs>

soundanalogous, 2015-06-07:
Have you tried with and without DHCP? Comment out line 115 of StandardFirmataEthernet to use DHCP. Is line 103 set to the IP address of the computer your board is connected to?

DonPancoe, 2015-06-07:
I have the laptop connected directly to the board with a single Ethernet cable, so no DHCP server is involved. I have the IP addresses of both the laptop and the board defined in the Firmata firmware. I can ping between the laptop and the board just fine, so I think the WIZnet chip is doing its job. The issue seems to be making the UDP connection to the Atmel chip and its firmware.

I will likely have to shift to a different project early next week so I may have to step away from this one for a little while. It will be interesting to see what rwaldron learns when he receives his XBoard. I've also shared this topic [over at their forum](http://www.dfrobot.com/forum/viewtopic.php?f=8&t=1432).

It sounds repetitious saying it, but I really do appreciate all your help with this issue.

rwaldron, 2015-06-09:
Quick update: I'm still awaiting my  DFRobot XBoard V2

mcinnes01, 2015-07-20:
Hey @rwaldron

Just wondered if you've had any luck with your XBoard?

Many thanks

Andy

rodrigoadachi, 2015-07-20:
Can you use a ESP8266 as bridge, but I think a waste, since the ESP8266 is more powerful than the Arduino and even comes embedded with WiFi

DonPancoe, 2015-07-21:
Or maybe create a version of Firmata firmware to run right on the ESP8266 via the Arduino IDE. My available tinkering time is still taken up by the project I mentioned earlier, but I still hope to work on the XBoard, and maybe the ESP8266 idea, when I get a chance. Probably after the summer.

Resseguie, 2015-07-21:
@rodrigoadachi @DonPancoe the most information I'm aware of re: ESP8266 is here:
https://gist.github.com/ajfisher/5fe60fe7d8c49b3223f0

rodrigoadachi, 2015-07-21:
Resseguie, thus need a slave Arduino, the esp8266 is very powerful and low cost, if there was a Firmata for esp8266 would be perfect

rwaldron, 2015-07-21:
cc @monteslu @ajfisher

Resseguie, 2015-07-22:
@rodrigoadachi right. Believe @ajfisher was investigating just that. The above gist is his intermediate solution I believe. You might jump on gitter and check in for the details on the latest thinking.

ajfisher, 2015-07-22:
@rodrigoadachi So current status is that we are still looking to build a firmata like port across to the ESP8266. This is slightly challenging due to the nature of the timers the chip uses as well as the SDK being a currently moving target (4 major breaking releases in 6 months).

As such the current mostly working solution is to use the ESP8266 as a wifi-serial bridge in transparent mode. This is a bit of a waste of resources given the ESP8266 is pretty powerful but does work. The set up in my gist (https://gist.github.com/ajfisher/5fe60fe7d8c49b3223f0) is known to work but it's over TCP. This is reliable and means a very straightforward implementation for johnny-five, however it is also quite problematic under reasonable message load because of the FIFO implementation on the bridge. This is a known problem.

Resulting from that there are a group of us working on a UDP based WiFi-Serial bridge. UDP is more tolerant of messages being dropped and doesn't have the ack overhead all the time which is what slows down the message processor on the TCP bridge. @monteslu has written the NodeJS side and we're just nutting out the bits on the ESP8266 side with help from the MakeBlock team (who are looking to use this in their mBots too). I'd like to say we'll have sorted this imminently as we really want to use this for NodeBots day this weekend.

As soon as we have a working solution I'll post here as well as wrap up a full gist on it explaining how to make it work

That should at least make a good wireless solution that buys time for a more dedicated implementation on the ESP8266. Though having done a lot of development on them over the last 6 months, they aren't the panacea they appear (mostly because of their lack of high resolution timers).

rodrigoadachi, 2015-07-22:
I appreciate the explanation, I know it's not a good practice, but communicate the NodeJS and esp8266 by native tcp, when opening the connection not closing, with two-way communication within 100ms packaging in the JSON at the end of each object put a ' ! ' so I can parser (.trim ('')) just so I decided my FIFO problem. Sorry if I talked nonsense or used a bad practice schedule.

rodrigoadachi, 2015-07-22:
Just a correction:

var dataString = data.toString().split('|');
          for (i in dataString){
            if (dataString[i] != ""){
              var dadaJson = JSON.parse(dataString[i]);
              // -----
            }
          }

Closed 2015-03-09.

Thread 641 (2015-03-01):

Motor docs pin reference

Jackbennett, 2015-03-01:
Hello, was just trying to get my motor reverse from reading [this example](https://github.com/rwaldron/johnny-five/blob/master/docs/motor-hbridge.md) and the [motor class reference](https://github.com/rwaldron/johnny-five/wiki/Motor)

I'm using an Uno with a L293D h-Bridge out the starter kit and it took me a while and someone else's example to try using `cdir` in my pins object to get the motor to reverse. I think the docs could make it a bit clearer somewhere that `dir` and `cdir` might be used together. I was trying to use `brake` at first.

dtex, 2015-03-01:
Hi @Jackbennett ,

CDIR would only be necessary if your wiring is different than the diagram in the example.

Do you have a wiring diagram or a picture you could share so I can make sure what is in my head matches what you've wired up?

Jackbennett, 2015-03-01:
I was using this diagram without the button as a reference to get it to work;

http://api.ning.com/files/jFhR10F2nKDm5cJ0p2jcpgHpKd4hNPz01QgMS8OF6QUh82aIgvr-dp1uzQSopb*PQgSlhFEgj5ALhek3X56Zq6xDZuw-9vwD/l293dmontagem.jpeg
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

Here's my actual diagram I just made;

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

Just to clarify, I don't think the example is wrong, but I can't see any clear mention that doing it with the 3 pins that made more sense to me requires the cdir option. I'm bringing it up because the L293D chip is in the arduino starter kit so someone else new might run into it.

I was looking to see if `dir` could take an array. i.e `dir: [8, 12]`

dtex, 2015-03-02:
Cool, thanks for the diagram.

I feel kinda weird providing a 3 pin example for the H-Bridge since it can be done with 2. I don't want to send people down a less efficient path. However, I like to be accommodating and I certainly don't know everything there is to know about H-Bridge's so please help me understand the case for doing it with three.

Jackbennett, 2015-03-02:
This is the first thing I've made so my experience might not be the level you intend this library for  but I'll explain my reasoning for you to judge.

L293D chip pinout for reference, pin numbers form here refer to this diagram not an arduino.
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

The 3-way as wired I can see that;
- Pin 2 and pin 7 take a boolean input for direction on or off.
- Pin 1 on PWM then drives that whole side at the given speed.
- The enable pin is not always on
- All the enable/input voltage is from the Arduino 5v, including the logic supply pin 16 from the 5v
- Pin 8 supply voltage is clearly form the 9v

From the [datasheet](http://arduino.cc/documents/datasheets/L293D.pdf) page 2 "Absolute Maximum Ratings" Vi and Ven (input and enable voltage) list a max of 7v. I didn't want to put the 9v battery to that with pin 1.

Just logically this way I could mentally step through what was going to happen.
1. Set the direction
2. Wind the motor

Now, Maybe I'm wrong about this. Or perhaps I should PR this as a new example to demonstrate the H-bridge before going on to cover the 2pin method. I still need to learn how just pin7 being pwm can drive the direction.

dtex, 2015-03-02:
> I still need to learn how just pin7 being pwm can drive the direction.

The key is the difference in the voltage being applied to the two poles of the motor. With pin 2 on the H-Bridge being fed a digital signal and pin 7 on the H-Bridge being fed an analog signal:

Pin 2 | Pin 7 | Difference | Result
------------ | ------------- | ------------- | -------------
Low | 0 | **0** | Stopped
Low | 64 | **+64** | Forward half speed
Low | 128 | **+128** | Forward half speed
Low | 255 | **+255** | Forward full speed
High | 0 | **-255** | Reverse full speed
High | 64 | **-191** | Reverse 3/4 speed
High | 128 | **-128** | Reverse 1/2 speed
High | 255 | **0** | Stopped

dtex, 2015-12-11:
Hi @Jackbennett, did everything work out? Can we close the issue?

Jackbennett, 2015-12-11:
I thought I might just write up an extra example for a PR but never got to it.

Excellent explanation thank you for your help.

Closed 2015-12-11.

Thread 646 (2015-03-15):

Zumo IR Array not working with Johnny Five

den2k, 2015-03-15:
I've been having great success getting Johnny Five to work with the Zumo bot.  Motor control through wireless works great with keyboard control.

I'm now trying to get the attached IR Array to work.

The challenge I have is running the following code.

```
var five = require("johnny-five");
var board = new five.Board({
    port: "com3"
});

var stdin = process.stdin;
stdin.setRawMode(true);
stdin.resume();

board.on("ready", function() {

  // Create a new `reflectance` hardware instance.
  var eyes = new five.IR.Reflect.Array({
    emitter: 2,
    pins: [4, "A3", "A0", "A2", 5], // cannot use 11, and lots of pins are already in use?
  //    emitter: 2,  // Zumo Reflectance Sensor Array Emitter Pin for Arduino Uno
  //    pins: ["4", "A3", "11", "A0", "A2", "5"],   // Zumo Reflectance Sensor Array
  });

  var calibrating = true;

  eyes.calibrateUntil(function () {return !calibrating; });
  console.log("Press the spacebar to end calibration...");

  stdin.on("keypress", function(chunk, key) {
  if (!key || key.name !== 'space') return;

    calibrating = false;
  });

  eyes.on("line", function(err, line) {
    console.log(line);
  });

  eyes.enable();
});
```

The issue is the various pins are already in use.

pin: 2 is already in use
pin: 4 is already in use
pin: 3 is already in use
pin: 0 is already in use
pin: 2 is already in use
pin: 5 is already in use

and calibration doesn't work properly.  I'm new, so it could be just entirely my issue.  I would appreciate any direction.

BrianGenisio, 2015-03-15:
A couple of things related to this:

The `IR.Reflect.Array` currently only supports analog sensors.  The Zumo array is a digital sensor, which uses pulse timing to determine the values.  Instead, if you want to use a reflectance array in Johnny-Five, you will need to use an [analog array](https://www.pololu.com/product/960).

Because of this, you need to use analog pins only (A0, A1, A2, etc).  In your example, you are mixing digital and analog pins.  I don't know if this is why you are getting the "already in use" error, but it could be because J5 is trying to set the digital pins as analog?

den2k, 2015-03-15:
I didn't realize this made a difference. Good to know and seems obvious now. Luckily I have an analog version of their IR array. I'll try that when I get a chance and see if it makes a difference. I'll also just try with just the analog pins on the current array and see what I get.

BrianGenisio, 2015-03-16:
Cool.  Glad to know you have an analog one lying around.  I can assure you, however, that if you connect a digital array up to analog pins, the driver won't work.  The encoding is completely different.  As far as I understand, the Zumo array only comes in digital.  The Pololu sensor comes in digital or analog.

den2k, 2015-03-25:
I hooked up a QTR-8A array to the Zumo bot and I now have readings, but I don't think it is calibrating correctly with the following code.  I have 5 sensors hooked up and I should be seeing 0 - 4001 I believe.  Not sure what the 2000 base value means in my case.  I also continue to see Pin in use when I run this code. Hmmm?

var five = require("johnny-five");
var board = new five.Board({
	port: "com3"
});

board.on("ready", function() {

  var calibrating = true;

  var eyes = new five.IR.Reflect.Array({
    emitter: 13,
    pins: ["A0","A1","A2","A3","A4"]
  });

  // calibrate for two seconds
  eyes.calibrateUntil(function() { return !calibrating; });
  setTimeout(function() { calibrating = false; }, 2000);

  eyes.enable();

  eyes.on('line', function(err, lineValue) {
    console.log( "Line Position: ", lineValue);
  });

});

-------------------------

pin: 0 is already in use
pin: 1 is already in use
pin: 2 is already in use
pin: 3 is already in use
pin: 4 is already in use
Line Positions: 0
Line Positions: 2500
Line Positions: 2000
Line Positions: 2000
Line Positions: 2000
Line Positions: 2000
Line Positions: 2000
Line Positions: 2000
Line Positions: 2000
Line Positions: 2000
Line Positions: 2000
Line Positions: 2000
Line Positions: 2000
Line Positions: 2000
Line Positions: 2013
Line Positions: 2010
etc.

BrianGenisio, 2015-03-25:
While calibrating, you need to make sure that all sensors see both extremes (white and black).  So in the 2 second window you created, wave the sensor at the height you expect over white and black.

2 seconds is a bit short to do it well.  I like to take a keypress input instead, and then serialize the calibration data to a file.  If the file exists, deserialize it and pass it to the component (`loadCalibration`).

I keep meaning to change this sensor to have an `autoCalibrate: true` option which will calibrate as it drives.  It would simplify the calibration process, but it would make for a messier start for a line following bot.

But you are correct.  If everything is working properly, 5 sensors would be between 0 and 4001 for the "line" event.  It really just aggregates the "calibratedData" array into a single number which tells you where on the array the data is.  The "calibratedData" event will give you normalized data on the 5 sensors.  The "data" event will give you raw values on the 5 sensors.

At any point in time, you also have access to the `values` property with is an array of calibrated data at the last reading and the `raw` property which is an array of raw data at the last reading.

If your raw values are changing how you'd expect as you swipe it over the line, then you know the sensor is working and wired up properly.

dtex, 2018-01-08:
@den2k Touching base. Did @BrianGenisio's comment give you everything you need? Wondering if I can close this issue.

dtex, 2018-01-16:
@den2k I'm going to close this since we haven't heard back. Feel free to re-open if necessary.

Closed 2018-01-16.

Thread 674 (2015-03-25):

Ping module not working + Memory leak error

ecdeveloper, 2015-03-25:
Here is a very simple code:

```
var five = require("johnny-five");
var board = new five.Board();
board.on("ready", function() {
	var ping = new five.Ping(7);
	ping.on("change", function() {
		console.log("Object is " + this.in + " inches away");
	});
});
```

For some reason nothing is outputted to the stdout. The more so, after 10-15 seconds it throws an error:
```
(node) warning: possible EventEmitter memory leak detected. 101 listeners added. Use emitter.setMaxListeners() to increase limit.
Trace
    at addListener (events.js:160:15)
    at once (events.js:185:8)
    at Board.pulseIn (/Users/evghenic/dev/node_modules/johnny-five/node_modules/firmata/lib/firmata.js:1265:8)
    at Ping.<anonymous> (/Users/evghenic/dev/node_modules/johnny-five/lib/ping.js:45:13)
    at wrapper [as _onTimeout] (timers.js:261:14)
    at Timer.listOnTimeout [as ontimeout] (timers.js:112:15)
```

If I remove the Ping related code - the error doesn't occur.

I followed the Ping setup guide. Uploaded the custom Firmata sketch.

I also tested the device/circuit with an Arduino application - it works fine.

Any ideas what may be wrong?

rwaldron, 2015-03-26:
Can you send a picture of your circuit wiring?

ecdeveloper, 2015-03-26:
Red is 5V on Arduino, and + on the board
Blue is GND and -

![ping circuit]
(http://oi62.tinypic.com/mu8yo6.jpg)

cybertiti, 2015-03-26:
Hi, I had the same issue before changing to the firmata modified sketch.
With the good firmata version, everything is working.

ecdeveloper, 2015-03-26:
@cybertiti which method for changing Firmata have you used? I actually used both (cloning the jgautier/arduino-1.git repo, and also copy/pasting the Firmata code into the Arduino IDE).

rwaldron, 2015-03-26:
@ecdeveloper thanks for the clear image :heart:. I will assemble your circuit today and try to reproduce :)

ecdeveloper, 2015-03-26:
@rwaldron Thanks! Looking forward to see your results :)

rwaldron, 2015-03-26:
@ecdeveloper (unrelated to report) I notice that the board has "JY-MCU" printed on it—does this board have built-in Bluetooth? (I've never seen a board with that printed on it)

ecdeveloper, 2015-03-26:
Wow. Just noticed that too :D I don't really know, when I ordered it I was sure it's a regular UNO without any extra built-in features.

rwaldron, 2015-03-26:
Interesting—would you mind taking a few pictures from different angles and of the back side? If not, that's ok :)

ecdeveloper, 2015-03-26:
@rwaldron https://www.dropbox.com/s/88t1066vahuztxt/arduino%20uno.zip?dl=0

rwaldron, 2015-03-26:
You're the best :)

ecdeveloper, 2015-03-26:
:smile:

cybertiti, 2015-03-26:
@ecdeveloper I used the cloning git version, but you need to check is the firmata directory used by IDE is the right one by searching pulse_in in your sketch. The first time i did it, i uploaded the standard firmata because IDE was loading from the wrong directory.

ecdeveloper, 2015-03-26:
@cybertiti Hm, probably you're right. I remember when I tried cloning the repo, I didn't find any "pulse_in" matches in sketch. Will double check tonight, thanks.

rwaldron, 2015-03-26:
I just used the "copy/paste" method and cannot reproduce the issue. Here is the circuit I assembled:

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

And here's a video demo of the circuit controlled by the program in `eg/ping.js`:

https://www.youtube.com/watch?v=puDJJWomqzc

-----

The error you're seeing is usually the result of a wiring issue that causes the board to stop responding. A response is necessary to clear the event created by Firmata.js's `pulseIn` method ( `once("pulse-in-" + pin, ...)` ).

Can you try connecting directly from the breadboard to the Ground and 5V as shown in my circuit?

ecdeveloper, 2015-03-27:
@rwaldron Thanks!!! Connecting it directly solved the problem! :)

soundanalogous, 2015-03-27:
pulse_in (in Arduino / c) has a while loop that is blocking until the pulse has finished. This will create significant delays if you are trying to read other sensors and/or control actuators at the same time. Data will still buffer through the UART as best it can but you risk loss of data by using pulse_in. This is why I have never included the routine in StandardFirmata. Once someone creates an interrupt driven pulse_in routine that works across the majority of Arduino boards, I will add an implementation... likely to ConfigurableFirmata and StandardFirmata as well if the implementation it has a low memory footprint and does not interfere with existing timers.

ecdeveloper, 2015-03-27:
@rwaldron I will try to connect it back how it has been connected before, will let you know either it works or not.

@soundanalogous It seems related to this issue - https://github.com/rwaldron/johnny-five/issues/675

ecdeveloper, 2015-03-27:
@rwaldron Now it works with my previous circuit. Magically :D

marvindebruin, 2015-04-15:
Ive tried connecting it directly and indirectly and both give the memory leak error. Maybe closing this issue was a bit premature?

 warning: possible EventEmitter memory leak detected. 101 listeners added. Use emitter.setMaxListeners() to increase limit.
Trace
    at EventEmitter.addListener (events.js:160:15)
    at EventEmitter.once (events.js:185:8)
    at Board.pulseIn (/Volumes/Work HDD/Repositories/arduino/node_modules/johnny-five/node_modules/firmata/lib/firmata.js:1265:8)
    at Ping.<anonymous> (/Volumes/Work HDD/Repositories/arduino/node_modules/johnny-five/lib/ping.js:45:13)
    at wrapper [as _onTimeout] (timers.js:252:14)
    at Timer.listOnTimeout [as ontimeout] (timers.js:110:15)

ecdeveloper, 2015-04-15:
@marvindebruin In my case the problem was because of insufficient power. I was using usb power, and I had multiple things connected to my board.

rwaldron, 2015-04-15:
>  Maybe closing this issue was a bit premature?

No, because the issue isn't software related :(

marvindebruin, 2015-04-15:
Ill add an external power supply to the mix and get back at it tomorrow. Hope this solves it.

@rwaldron I get it now :)

rwaldron, 2015-04-15:
Cool, let us all know how it goes :)

marvindebruin, 2015-04-16:
So I added an external power source (5v adapter hooked up to a second arduino) and turned it on. Still no success. Ive measured the Voltage and it gives 5V to the sensor. so that works. Ive tried the sensor in this conf with the basic ping script and that works.
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

rwaldron, 2015-04-16:
> So I added an external power source (5v adapter hooked up to a second arduino)

Did you share a ground line across the two Arduinos? This really should not be necessary at all. Please try with wiring exactly as shown here: https://github.com/rwaldron/johnny-five/issues/674#issuecomment-86586234

rwaldron, 2015-04-16:
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

marvindebruin, 2015-04-16:
Hey Rwaldron, this made no difference. Could it be Im using a different firmata / where can I get the proper one if not from the examples. Ill try that first just to rule it out.

rwaldron, 2015-04-16:
> Could it be I'm using a different firmata

Yes, it very well could be. Are you using the special Ping-specific Firmata that's provided in the docs? https://github.com/rwaldron/johnny-five/wiki/Ping#setup

bbence84, 2015-04-30:
I have a slightly different issue / question, sorry for hijacking the thread. :) What I am trying to do is to check periodically the sensor from a node red flow. The sensor returns the correct value just fine in a vanilla node.js app, but I cannot get it to work in node red (http://nodered.org/docs/hardware/arduino.html). It returns zero. How do I connect the onchange callback in a node red flow? I tried the following which did not work:
var ping = new five.Ping(7);
msg.payload = ping.cm;

johnny five and the board is supposed to be already initialized according to the example I linked. But that is just about blinking a red, there's no callback required there... Thanks!

rwaldron, 2015-04-30:
Try this:

```js
var ping = new five.Ping(7);

ping.on("change", function() {
  msg.payload = this.cm;
});
```

bbence84, 2015-04-30:
Thanks, but this does not seem to work.
I think the reason is that node-red isn't supposed to work in this callback fashion, Or does it? How would you use the johnny five pushbutton object in node-red?

rwaldron, 2015-05-01:
Sounds like a bug in node-red, because all of Johnny-Five's sensor/input component classes are emitters.

Closed 2015-03-27.

Thread 675 (2015-03-26):

Firmata modifed for ping, other sensor not working anymore

cybertiti, 2015-03-26:
Hi,
My sensor "new five.Sensor({pin: "A5", freq: 60000})" is not working anymore since I changed for the modified firmata needed for using the "new five.Ping(0)".
Do i need to change something for Sensor library to work with modifed firmata ?
Best regards,
Thierry

rwaldron, 2015-03-26:
Can you provide your complete code example? A picture of your circuit would also be helpful—thanks in advance!

cybertiti, 2015-03-26:
Sure, here is the last part of the code, the complete one is a bit long :
if (args.indexOf("noArduino") == -1) {
  board = new five.Board();
  board.on("ready", function() {
    var controller = process.argv[2] || "GP2Y0A41SK0F";
    motorL = new five.Motor({pins: {pwm: 5, dir: 4}});
    motorR = new five.Motor({pins: {pwm: 6, dir: 7}});

    tilt = new five.Servo({pin: 10, range: [0, 60], startAt: 40, center: false});
    pan = new five.Servo({pin: 9, range: [0, 180], startAt: 90, center: true});
    led = new five.Led({pin: 13, type: "PWM"});
    light = new five.Led({pin: 12});
    laser = new five.Led({pin: 14});
    alarm = new five.Led({pin: 11, type: "PWM"});
    voltmetre = new five.Sensor({pin: "A5", freq: 60000});
    pingL = new five.Ping({pin: 0, freq: 300});
    pingR = new five.Ping({pin: 1, freq: 300});
    proxiFR = new five.IR.Distance({pin: "A1", controller: controller});
    proxiFL = new five.IR.Distance({pin: "A2", controller: controller});
    proxiRR = new five.IR.Distance({pin: "A3", controller: controller});
    proxiRL = new five.IR.Distance({pin: "A4", controller: controller});

    voltmetre.on("data", function(err, res) {
      console.log(res + " pin A5");
      res = res * 5 / 1024;
      res = res / (24930 / (47530 + 24930));
      res = res - 0.10;
      volt = res.toFixed(2);
      console.log(volt + " Volt");
    });

    pingL.on("data", function(err, value) {
      console.log("Dist Left " + this.cm + " cm");
    });
    pingR.on("data", function(err, value) {
      console.log("Dist Right " + this.cm + " cm");
    });

    proxiFR.on("change", function() {
      console.log("IR FR cm: ", this.cm);
    });
    proxiFL.on("change", function() {
      console.log("IR FL cm: ", this.cm);
    });
    proxiRL.on("change", function() {
      console.log("IR RL cm: ", this.cm);
    });
    proxiRR.on("change", function() {
      console.log("IR RR cm: ", this.cm);
    });

    serverStatus.hasArduino = true;
  });
}

cybertiti, 2015-03-26:
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

cybertiti, 2015-03-26:
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
And the front view with the sensors

cybertiti, 2015-03-26:
The Sensor on A5 is for voltage sensing, and was working perfectly before i changed the firmata with the modifed firmata for Ping library

rwaldron, 2015-03-26:
> The Sensor on A5 is for voltage sensing

Can you provide a link? I will likely need to purchase whatever you're using

Before we embark on solving this issue, all I ask is that you remain patient with me :) In some cases we'll be at the mercy of shipping times if I have to order components.

cybertiti, 2015-03-26:
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
You need 2 resistor, in my case i used a 47 Kohm for R1 and a 25 Kohm for R2.
Resistor value can be change, these one are for a Vin up to 14 Volt

rwaldron, 2015-03-26:
Oh great, that's very simple. I have just ordered the Romeo v2.2

cybertiti, 2015-03-26:
Oh great, Romeo v2 is really a nice board. If you zoom on my first picture, you can see the resistor plugged in the A5 blue analog input, the Vin is plugged before the DC converter, label VIN on the board. It's really easy to build, and working perfectly to monitor battery voltage.

rwaldron, 2015-03-30:
Just checking in—I haven't received the Romeo yet, but will update when I do.

cybertiti, 2015-03-31:
Hi Rick, i hope your romeo will arrive soon !
Just an update, other library like LED are not working correctly neither with modified firmata.
I revert back to the original firmata and everything is working fine again, except US and IR proximity sensor for sure.

rwaldron, 2015-03-31:
Quick question, did you select Arduino Leonardo when you uploaded the Ping Firmata?

rwaldron, 2015-03-31:
Sorry I missed this before now: the Ping instances are being set up with pin 0 and 1, which is not allowed because those are the RX/TX lines being used by the Pi to talk to the Romeo.

rwaldron, 2015-03-31:
An update.

I received the Romeo yesterday afternoon and today I assembled the following:

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

- A1: GP2Y0A21YK \*
- A2: GP2Y0A21YK
- A3: GP2Y0A21YK
- A4: GP2Y0A21YK
- A5: Slide Potentiometer as a substitute for the voltage level sensor, I wanted to be able to change the value at will.
- D7: Ping
- D8: Ping

The following program was used to test. It was adapted from the code provided.

Relevant changes:
- Changed Ping pins to 7 & 8 from 0 & 1

Irrelevant changes:
- Updated IR controller to GP2Y0A21YK \*
- Minor tweak in the `voltmetre` change handler to use `this.value` instead of the argument

```js
var five = require("johnny-five");
var board = new five.Board();

board.on("ready", function() {
  var voltmetre = new five.Sensor({pin: "A5"});
  var pingL = new five.Ping({pin: 7, freq: 300});
  var pingR = new five.Ping({pin: 8, freq: 300});
  var proxiFR = new five.IR.Distance({pin: "A1", controller: "GP2Y0A21YK"});
  var proxiFL = new five.IR.Distance({pin: "A2", controller: "GP2Y0A21YK"});
  var proxiRR = new five.IR.Distance({pin: "A3", controller: "GP2Y0A21YK"});
  var proxiRL = new five.IR.Distance({pin: "A4", controller: "GP2Y0A21YK"});

  voltmetre.on("change", function() {
    var res = this.value;
    console.log(res + " pin A5");
    res = res * 5 / 1024;
    res = res / (24930 / (47530 + 24930));
    res = res - 0.10;

    var volt = res.toFixed(2);
    console.log(volt + " Volt");
  });

  pingL.on("data", function(err, value) {
    console.log("Dist Left " + this.cm + " cm");
  });
  pingR.on("data", function(err, value) {
    console.log("Dist Right " + this.cm + " cm");
  });
  proxiFR.on("change", function() {
    console.log("IR FR cm: ", this.cm);
  });
  proxiFL.on("change", function() {
    console.log("IR FL cm: ", this.cm);
  });
  proxiRL.on("change", function() {
    console.log("IR RL cm: ", this.cm);
  });
  proxiRR.on("change", function() {
    console.log("IR RR cm: ", this.cm);
  });
});
```

I ran the program several times, with several logging configurations (limiting logging to certain sensors at a time). All runs behaved as expected:

- The potentiometer reported changes for variation in voltage resistance
- The IR sensors reported readings that were consistent with changes to the physical space around them (ie. If I moved my hand across them, the readings reflected this change).
- The Ping sensors reported readings that were consistent with changes to physical space around them (ie. If I moved my hand across them, the readings reflected this change).

I used a centimeter ruler to confirm reported distances on "randomly" selected sensors on each run.

\* GP2Y0A21YK is similar enough to the GP2Y0A41SK0F, it shouldn't make a difference.

cybertiti, 2015-04-06:
Hi Rick,
I'm glad to see you've got everything working, maybe my issue is because i used the input 0 and 1. I'm going to test with another input.
Which firmata did you upload to the romeo ? the modifed one you describe in you ping sensor post ?
Do you like your new romeo board ?
Thanks for your help, you're doing a great job.

cybertiti, 2015-04-06:
You were right, moving away from pin 0 & 1 did the trick.
Ping sensors are working perfectly now.
But I still have an issue with IR sensors reporting "null" value only ...

rwaldron, 2015-04-06:
@cybertiti I'm out of town for a few days so I won't be able to test this until I get back—I appreciate your patience :)

rwaldron, 2015-10-08:
Can you update this to use the Proximity class and let us know if the issue remains?

http://johnny-five.io/api/proximity/

rwaldron, 2015-11-05:
@cybertiti I'm going to close this for now—if you want to dig in again, we can reopen :)

Closed 2015-11-05.

Thread 692 (2015-04-05):

OneWire temperature sensors (DS18B20) can't have multiple devices per pin

BrianGenisio, 2015-04-05:
The OneWire spec allows multiple devices per pin, but the `Temperature` class doesn't handle multiple temperature sensors properly.
- [x] Bust out the DS18B20 controller into a sharable driver, like the IMU
- [x] Re-work the controller to register with the driver
- [x] Make sure the un-addressed sensor still works
- [x] Throw an error if there is more than one un-addressed sensor
- [x] Unit tests
- [ ] More real-world testing

dtex, 2018-01-08:
Fixed by #694

Closed 2018-01-08.

Thread 719 (2015-04-10):

Servo Arduino Raspberry Pi serial port

goliatone, 2015-04-10:
Logging this here as it drove me nuts for a good while.

I have a servo connected to an Arduino Uno which is connected to a Raspberry Pi 2 B. I was running the sample servo script. It was able to connect, as soon as I would send a command from the `rpl` it would error out with a **Error: Serialport not open.**.

However, I installed the arduino IDE- `sudo apt-get install arduino`- and I was able to run a simple sketch from the Raspberry controlling the servo OK.

I was also able to control the pin 13 LED from the `rpl` with no issues.

The Raspberry Pi was powering the  Arduino so I ended up powering it with an external source and that fixed the issue.

johnny-five v 0.8.53
node v0.12.0
node-gyp v1.0.3
serialport v1.6.3

Incidentally I was having issues compiling `node-gyp` and `serialport` was not being installed. It took me a bit to fix that and get it running.

```
>> servo.center()
Error: Serialport not open.
    at SerialPortFactory.SerialPort.write (/home/pi/CODE/servo/node_modules/johnny-five/node_modules/serialport/serialport.js:254:17)
    at Board.analogWrite (/home/pi/CODE/servo/node_modules/johnny-five/node_modules/firmata/lib/firmata.js:606:11)
    at Board.servoWrite (/home/pi/CODE/servo/node_modules/johnny-five/node_modules/firmata/lib/firmata.js:651:20)
    at Servo.Controllers.Standard.servoWrite.value (/home/pi/CODE/servo/node_modules/johnny-five/lib/servo.js:109:17)
    at Servo.to (/home/pi/CODE/servo/node_modules/johnny-five/lib/servo.js:332:10)
    at Servo.center (/home/pi/CODE/servo/node_modules/johnny-five/lib/servo.js:422:15)
    at repl:1:8
    at REPLServer.self.eval (repl.js:112:21)
    at Interface.<anonymous> (repl.js:239:12)
    at Interface.emit (events.js:95:17)
```

```js
var five = require("johnny-five");
var board = new five.Board();

board.on("ready", function() {
  var servo = new five.Servo(10);

  this.repl.inject({
    servo: servo
  });

  servo.min();
});
```

```js
var five = require("johnny-five");
var board = new five.Board();

board.on("ready", function() {
  var led = new five.Led(13);

  this.repl.inject({
    led: led
  });

  led.blink();
});
```

Resseguie, 2015-04-10:
cc @bryan-m-hughes

bryan-m-hughes, 2015-04-10:
It makes sense that trying to power the servo from the Arduino from the Pi wouldn't work. The Raspberry Pi's power supply is pretty notorious. On older models, powering and controlling a servo straight from the pi would cause the board to reset the instant you turned it on! The newer models are better, but powering servos from the pi still isn't really an option.

@goliatone can you tell us more about the compile issues you had?

goliatone, 2015-04-10:
Well, I was **able to control** the Arduino board from the Raspberry Pi without extra power by installing the arduino IDE and loading a basic sketch.
I will dig around for the error logs, I know I did save them.

bryan-m-hughes, 2015-04-10:
Well, just because it worked under testing doesn't mean you should do it :-P. As soon as the servo stalls, it'll probably reset the RPi.

So just to clarify, do you only get that error when powering servos from the RPi? or do you get that error all the time?

goliatone, 2015-04-11:
You can install the arduino IDE on the RPi. I had a node script and an arduino sketch that were equivalent. Running the node script gave me a **Error: Serialport not open** but running the sketch did not- and the servo was behaving as expected so the serial port was actually open.

You actually **have** to enable serial port communication on the RPi. By default is used by a login shell that you can connect over serial cable. So getting a serial port not open makes sense in that context.
But to load the sketch on the arduino from the RPi the IDE also uses the serial port, so that threw me off for a bit.

I guess the difference is that the IDE only uses the serial port to **load** the sketch, but when the servo is running there is no serial port communication. Node is talking over the serial port on real time and the RPi does not have enough power to feed the servo and keep up with the chatter.

And just to clarify, I did not file this as a bug, my intention was to leave a comment in case someone else has the same issue in the future. So, nothing to fix :) Just give it a FYI label or whatever and close it.

>Well, just because it worked under testing doesn't mean you should do it :-P. As soon as the servo stalls, it'll probably reset the RPi.
Actually, the RPi was not getting reset. I kept working fine outside throwing that error.

rwaldron, 2015-10-08:
Thanks for documenting the issue here :)

Closed 2015-10-08.

Thread 755 (2015-04-26):

RPI / Arduino Nano hang on Device or Firmware Error

valencreative, 2015-04-26:
Hello Guys,

I currently developing a node-express-socket-johnny app for RPi and run into an issue when i tested my app.js on the raspberry pi2. It was developed and worked fine on my Mac with all the same module versions, but the RPi hang on this:

```
1430084459857 Device(s) /dev/ttyUSB0
1430084459942 Connected /dev/ttyUSB0
undefined
undefined
undefined
1430084469954 Device or Firmware Error A timeout occurred while connecting to the Board.

Please check that you've properly flashed the board with the correct firmware.
See: https://github.com/rwaldron/johnny-five/wiki/Getting-Started#trouble-shooting
events.js:85
      throw er; // Unhandled 'error' event
            ^
Error: A timeout occurred while connecting to the Board.
    at Board.<anonymous> (/home/bodobot/node_modules/johnny-five/lib/board.js:388:26)
    at Timer.listOnTimeout (timers.js:110:15)
```

It needs to be look like this btw (from my Mac):

```
1430087707599 Looking for connected device
1430087722452 Device(s) /dev/cu.usbserial-AL008BQZ
1430087722461 Connected /dev/cu.usbserial-AL008BQZ
1430087727121 Repl Initialized
>>
```

thanks for the kind solutions

bryan-m-hughes, 2015-04-26:
Can you connect to the Nano from the Raspberry Pi using the Arduino IDE? It may be possible that you don't have the right FTDI drivers installed, and this would be a good way to verify one way or another.

rwaldron, 2015-10-08:
Please reopen if still an issue

Closed 2015-10-08.

Thread 766 (2015-05-01):

Possible memory leak with GP2Y0D805Z0F

frxnz, 2015-05-01:
Using [this device](http://osepp.com/products/sensors-arduino-compatible/osepp-ir-proximity-sensor-module/) over I2C, getting a memory leak warning:

```
(node) warning: possible EventEmitter memory leak detected. 11 I2C-reply-38-0 listeners added. Use emitter.setMaxListeners() to increase limit.
Trace
    at addListener (events.js:179:15)
    at once (events.js:204:8)
    at Board.sendI2CReadRequest (/Users/notbook/git/johnny-five/node_modules/firmata/lib/firmata.js:921:8)
    at IR.<anonymous> (/Users/notbook/git/johnny-five/lib/ir.js:162:13)
    at wrapper [as _onTimeout] (timers.js:265:14)
    at Timer.listOnTimeout (timers.js:110:15)
```

Running this code:

```js
var five = require("../lib/johnny-five.js");

five.Board().on("ready", function() {

  var ir = new five.IR({
    device: "GP2Y0D805Z0F"
  });

  ir.on("data", function(err, timestamp) {
    console.log("data");
  });

});
```

It's entirely possible this is a wiring issue, since none of the pins are labelled. I've tried it a couple different ways with the same results.

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

dtex, 2015-05-01:
These line numbers don't seem to match up. What version of Johnny-Five?

rwaldron, 2015-05-01:
This bug is not likely in Johnny-Five. It pops up when there is something wrong with the wiring causing the component to fail.

frxnz, 2015-05-01:
@rwaldron Do you have one of these? Does the wiring above look right?

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

fivdi, 2015-05-01:
@frxnz is it because there are no pull-ups? SB1 & SB2 should be shorted according to the [document](http://osepp.com/wp-content/uploads/2012/01/OSEPP-PROX-01_REV1_1.pdf) linked to above.

frxnz, 2015-05-01:
>  is it because there are no pull-ups?

"Only short SB1 and SB2 if sensor is not connected to OSEPP I2C Shield". The pinout on the shield is just Vcc, GND, SDA and SCL.

fivdi, 2015-05-01:
Yes, "Only short SB1 and SB2 if sensor is not connected to OSEPP I2C Shield". In the photo above the proximity sensor is connected directly to the Arduino and not indirectly through an [OSEPP I2C Shield](http://osepp.com/products/shield-arduino-compatible/i%C2%B2c-expansion-shield/). I don't actually have one of the proximity sensors or an OSEPP I2C Shield, but the document leads me to believe that the proximity sensor board has 2 solder bridges called SB1 and SB2 that need to be closed to enable the 2K2 pull-up resistors on the proximity sensor board. Does the proximity sensor board have 2 solder bridges and are they closed? They are not visible in the photo, perhaps they're on the bottom of the board.

frxnz, 2015-05-01:
@fivdi Ah good catch. I assumed it was the I2C shield because I'm bad at reading. There are indeed 2 solder bridges on the back, and they're open. I'll close them tonight and give this another try. Thanks!

Closed 2015-05-06.

Thread 791 (2015-05-14):

Unable to control ESCs on Intel Edison

Abv204, 2015-05-14:
Hi, I am working on a project using Intel Edison and johnny-five to control a tricopter. The thing is the board is connected and initialized and then I get a type error something like this
 TypeError: Object #Galileo has no method 'servoConfig'
    at ESC.Controllers.DEFAULT.initialize.value (/home/edison/node_modules/johnny-five/lib/esc.js:72:17)
    at new ESC (/home/edison/node_modules/johnny-five/lib/esc.js:242:8)
    at Board.<anonymous> (/home/edison/Project codes/Flight.js:7:13)
    at Board.emit (events.js:92:17)
    at process._tickCallback (node.js:448:13)
    at Function.Module.runMain (module.js:499:11)
    at startup (node.js:119:16)
    at node.js:935:3
Could anyone help with this?
I am using ubilinux on my Intel Edison.

rwaldron, 2015-05-14:
Thanks for the report, I'll get this fixed immediately

rwaldron, 2015-05-14:
Please update Galileo-IO (or Edison-IO) to v0.8.14 and confirm that the issue is resolved—thanks!

Abv204, 2015-05-14:
Failed at the galileo-io@0.8.14 postinstall script 'node scripts/postinstall'.
npm ERR! This is most likely a problem with the galileo-io package,
npm ERR! not with npm itself.
npm ERR! Tell the author that this fails on your system:
npm ERR!     node scripts/postinstall

This is the error I get when trying to update.

rwaldron, 2015-05-14:
I'm not sure why it would error like that, especially if you'd previously installed it with no issues. I'll take a closer look and report back what I find.

rwaldron, 2015-05-14:
Please run:

```
opkg info libmraa0
```

And post the output—thanks!

rwaldron, 2015-05-14:
I think I know what this is. If you've flashed your board with the 2.1 image, Intel broke the native bindings (missing some header file). You'll need to flash with 2.0 and reinstall johnny-five and galileo-io. I'm sorry that's such a pain in the ass—if I worked at Intel, I could do something about it, but I don't, so I can't. Here's a link to the page that has 2.0 download: https://software.intel.com/en-us/iot/hardware/edison/downloads

danyocom, 2015-05-15:
What header files are missing?

Abv204, 2015-05-15:
I'll switch back to the old image and let you know if it works.
Thank you.

Abv204, 2015-05-17:
I re-flashed the edison to the 2.0 image and re-installed johnny-five and galileo-io. The modules work fine but I get an error saying,
illegal arguments for construction of _exports_PWM

Abv204, 2015-05-17:
I have tried changing the PWM swizzers on the board and still nothing and also apparently the board has only four PWM pins despite there being six printed on it.

rwaldron, 2015-05-17:
> I have tried changing the PWM swizzers on the board and still nothing and also apparently the board has only four PWM pins despite there being six printed on it.

That's correct. The Edison can only handle 4 PWMs at a time, so the native bindings have hard-coded a set of allowed PWM pins internally. There is nothing this project can do to change that. This means programs may only use:

- [3](https://github.com/intel-iot-devkit/mraa/blob/master/src/x86/intel_edison_fab_c.c#L1164-L1165)
- [5](https://github.com/intel-iot-devkit/mraa/blob/master/src/x86/intel_edison_fab_c.c#L1179-L1180)
- [6](https://github.com/intel-iot-devkit/mraa/blob/master/src/x86/intel_edison_fab_c.c#L1188-L1189)
- [9](https://github.com/intel-iot-devkit/mraa/blob/master/src/x86/intel_edison_fab_c.c#L1209-L1210)

Abv204, 2015-05-18:
Is there a way to run the esc-keypress code without initailizing Repl, so that the motors switch on once the program runs?

michael-joseph-payne, 2015-05-18:
Hi rwaldron - there are several Intel folks who have seen this thread and would like to lock down the problem.  Can you describe what header files are impacting this use case?

rwaldron, 2015-05-18:
@Abv204

> Is there a way to run the esc-keypress code without initailizing Repl, so that the motors switch on once the program runs?

The "esc-keypress" code is just a fun demo ;) It sounds like you want something simpler? Try this:

```js
var five = require("johnny-five");
var Edison = require("galileo-io");
var board = new five.Board({
  io: new Edison()
});

board.on("ready", function() {
  var a = new five.ESC(3);
  var b = new five.ESC(5);
  var c = new five.ESC(6);
  var d = new five.ESC(9);

  a.speed(25);
  b.speed(25);
  c.speed(25);
  d.speed(25);
});
```

Or more simply...

```js
var five = require("johnny-five");
var Edison = require("galileo-io");
var board = new five.Board({
  io: new Edison()
});

board.on("ready", function() {
  var escs = new five.ESC.Array([3, 5, 6, 9]);
  escs.speed(25);
});
```

And when you're ready to run the program silently, add `repl: false, debug: false`:

```diff
  var five = require("johnny-five");
  var Edison = require("galileo-io");
  var board = new five.Board({
    io: new Edison(),
+    repl: false,
+    debug: false
  });

  board.on("ready", function() {
    var escs = new five.ESC.Array([3, 5, 6, 9]);
    escs.speed(25);
  });
```

--------

@michael-joseph-payne

> Hi rwaldron - there are several Intel folks who have seen this thread and would like to lock down the problem. Can you describe what header files are impacting this use case?

I only know what I learned at the NYC Intel IoT Roadshow event. I was a judge at the event and was I was told that any teams that wanted to use the mraa JavaScript or Python bindings had to roll back to the 2.0 image because `mraa` would not build on the 2.1 image. Sorry, but I don't have a spare Edison that I can trash just to get the file name.

cc @ashishdatta @IoTman

michael-joseph-payne, 2015-05-18:
@rwaldron - no problem, that's enough to get us started checking a few things

rwaldron, 2015-05-18:
@michael-joseph-payne thanks for the attention to this :)

Abv204, 2015-05-19:
I wanted to implement the keypress module into the project, I got the escs working with the addition to the code you mentioned.
Thanks for all the help :-).

rwaldron, 2015-05-20:
That's great! I look forward to seeing your work when you're ready :)

Closed 2015-05-19.

Thread 793 (2015-05-14):

validating analog pin number

mMerlin, 2015-05-14:
I am writing some unit tests for a johnny-five project.  The project includes a user modifiable configuration file with details like which pin a sensor is connected to.  I want the unit test to sanity check the properties exported by the configuration.

Is there an simple way to check that an entry is a valid analog pin number, in a board agnostic way?

Looking at some of the existing test code, I can see using MockFirmata to create a dummy board, then use that to attempt to create a Sensor instance, and check the result.  Is there a simpler way?  Is there a way to check that is not dependant on a specific board?   When the unit tests are being run, the controller board is not known.

Looking at some johnny-five library code, it appears that checking for a string with first character 'A' or 'I', followed by a number would be close.  What would be the maximum analog pin number for supported boards?

rwaldron, 2015-05-14:
`MockFirmata` is "board agnostic" as any IO Plugin, but all IO Plugins must implement instance properties called `pins` and `analogPins`: https://github.com/rwaldron/io-plugins#minimum-plugin-class-requirements

I recommend using https://github.com/achingbrain/board-io to create testable "board" objects.

mMerlin, 2015-05-15:
That looks a bit 'involved' to get working.  I've added a link reference to this thread in the unit test comments.  For now (until I run into a valid case that fails the test, or invalid case that pass), I'm just going to use a regex test:
```
/^[AI]\d$/.test(value)
```
That should handle up to 10 analog pins.  Since the physical board is not know when running the test, even the full suggested implementation would have problems deciding what the limits should be.

rwaldron, 2015-05-15:
> That looks a bit 'involved' to get working.

It's really not, I promise :/

I'm not really sure what I can do, because I don't really understand the problem case that you're trying to solve—and trust me, I want to help :)

The physical board will report its digital and analog pins when Johnny-Five connects to it, so we mock result of that capabilities report with the pin array stubs.

mMerlin, 2015-05-15:
I guess I left some 'detail's of the context out.  That's what happens when you already know enough about the environment to be dangerous, but not enough to know what might be important, while looking for details in a specific area.

The project is designed to be generic / reusable, so no particular environment assumptions are *safe*.  The data that drives some of the test cases comes from a configuration file that the end-user WOULD modify, to adjust things like the specific pin numbers things are attached to.  Even for the initial round, the code will be running on totally different computers (both the johnny-five project, and the Arduino board) than the current development and testing is being done on.  There might not even be a board connected at the time that grunt is run to do the tests.  The test cases have to either be explicitly configured, or assume **everything** about what the actual board and run time environment would look like.

I looked at some of what the mock was doing when adding test cases for the Pin class.  From what I could see, it simulated approximately the capabilities of an UNO class Arduino board, based on the available pins.  Going forward, an enhancement would be to (on mock creation) tell it what specific board, or range of pins to create.  IE: provide the mock with an options structure what would set the capabilities that would be reported back.

Currently more important to me, is figuring out a way to create test cases that need to respond to and generate events.  Where functions are publicly visible, events can be simulated by calling the handlers directly with appropriate binding and arguments.  The package code I am working on (writing) though uses initializer methods that add listeners referencing package private event handlers.  I am not seeing a way to get hold of the entry points.  I should be able to directly emit appropriate test events, but then I need to catch the results.  Which are not the return value of the function.  So far, I have not found samples close enough to what is needed to wrap my head around a structure that works with the testing framework.

From looking over the johnny-five test code, it looks like the sinon package will be useful, but that is another that I do now know yet.

I need to finish the current round of refactoring, to get close to runnable code again, then I can push it up to github, and you could see the whole structure.  The current repo version has a structure significantly different than the one I am writing test cases for.  Really, I am writing test cases while trying to create a structure for more tests.

I am a programmer with a lot of years of experience in larger systems, with knowledge of a lot of programming languages.  I am not familiar with some of the structures needed to work with the lower levels of event driven systems, especially for testing.  I can do event handlers and emitters, but do know know how to get the 'hooks' in to be able test from the outside.  I have lots of experience testing from the inside, by adding debug code directly to the applications, and using tools to trace / step through.  Not so much with external testing frameworks.  I can get the code to work, but am having difficulty setting up some external regression testing where the code to be tested can not be simply called with test parameters, and the results checked.  I know lots about programming, but am missing some environment specific concepts, so I do not know the right question to ask.  Or even that there is a question.  I've worked with client side javascript before, but nodejs, npm, node-unit are all NEW.  So is that structure of event driven applications.  I've worked with browser based events, and years ago a bit with VB, so the concepts (I think) I understand, but implementation details are vague at best.

I have also worked directly with Arduino, enough to teach some programming / computer science with it for a local hobbyist robotics group.  My background includes general electronics knowledge as well.  That is enough to generally follow what the johnny-five components are doing.  I've got some of the highest and lowest levels of information, but am missing a layer in the low/middle.

mMerlin, 2015-07-22:
@ rwaldron
If you have the time, and are interested, here are links to the repositories for the project that started the thread.  That was done awhile ago.  I learned enough to get reasonable coverage for the unit test.  Finally thought to dig out this thread, and post the links

https://github.com/mMerlin/johnny-load
https://github.com/mMerlin/auto-water

The live test showed it to be working well.  At least until someone physically removed the moisture sensor :(

rwaldron, 2015-07-22:
> At least until someone physically removed the moisture sensor

Humans can't be trusted :)

These projects are super cool—thanks for following up :) I love seeing this stuff—it really makes my day

Closed 2015-05-15.

Thread 842 (2015-06-29):

this.io.pingRead undefined raspberry pi (similar to #787)

sesh-kebab, 2015-06-29:
Hi - a new johnny-five user. Firstly thank you for such an awesome library. I just recently got started but running into issues with Proximity using a Seeedstudio ultrasonic sensor. Documents mention that I need a special version of PingFirmata and I should use Arduino Studio to upload it. But how can I do this on a RaspberryPi? Is the below error related?

1435589004832 Device(s) RaspberryPi-IO
Nodebot - Test Harness listening at http://0.0.0.0:3000
1435589008787 Connected RaspberryPi-IO
1435589008862 Repl Initialized
>> /home/pi/Nodebot-TestHarness/node_modules/johnny-five/lib/proximity.js:175
          this.io.pingRead(settings, function(microseconds) {
                  ^
TypeError: undefined is not a function
    at Proximity.<anonymous> (/home/pi/Nodebot-TestHarness/node_modules/johnny-five/lib/proximity.js:175:19)
    at wrapper [as _onTimeout] (timers.js:265:14)
    at Timer.listOnTimeout (timers.js:110:15)

dtex, 2015-06-29:
@sesh-kebab (great handle BTW) You don't need to upload form the Pi. You can install the Arduino IDE on your laptop and then use that machine to upload the special version of Firmata. Once it's uploaded to the Arduino, it's on there for good until you upload something else. Just connect the Arduino to your Raspberry Pi once the upload is complete.

Note: It's also possible to run the Arduino IDE on your Pi, but that may be more hassle than it's worth.

sesh-kebab, 2015-06-30:
Thanks for quick reply. Sorry, I should've have mentioned I'm not using an Arduino - only a Raspberry Pi.

nebrius, 2015-06-30:
Hi @sesh-kebab, raspi-io author here. I haven't heard of the `pingRead` method before, tbh. It's not a part of the [io plugin spec](https://github.com/rwaldron/io-plugins).

So what this means is that it's not currently possible to use the `pingRead` method on the Raspberry Pi.

@dtex are you familiar with `pingRead`? @rwaldron is this something that we should add to the io plugin spec?

rwaldron, 2015-07-01:
`pingRead` is the bogus name I made up for hacked in UltraSonic Ping support in `PingFirmata`. If you wanted to support those devices you could add this, but it's only useful for that one type of component, so it's not really in the io plugin wheelhouse.

sesh-kebab, 2015-07-01:
@rwaldron @nebrius thanks! From a newbie's perspective, it would definitely be helpful if at the very least, rasp-io could output a message describing why this method isn't available when using Johnny-Five + RaspberryPi combination, for folks who may also run into this issue in the future.

As for a workaround, I'm thinking of using a Pin class to read and write to the signal pin. Would this work? @nebrius and if so, can the workaround solution be considered as a generic implementation for pingRead in raspi-io?

rwaldron, 2015-07-01:
Notes for implementing `pingRead` on raspberry pi:

- https://electrosome.com/hc-sr04-ultrasonic-sensor-raspberry-pi/
- http://www.raspberrypi-spy.co.uk/2012/12/ultrasonic-distance-measurement-using-python-part-1/
- http://www.bytecreation.com/blog/2013/10/13/raspberry-pi-ultrasonic-sensor-hc-sr04
- http://www.modmypi.com/blog/hc-sr04-ultrasonic-range-sensor-on-the-raspberry-pi

nebrius, 2015-07-01:
@sesh-kebab TBH I'm a little wary of implementing this in raspi-io. As rwaldron mentioned, this is a rather specific case that doesn't apply to non-Arduino devices, and if we were to add this to raspi-io, we would need to add it to all of the non-Arduino IO plugins too. Also, if we were to consider adding this method, we would need to consider adding in methods from all of the non-standard firmata implementations.

I'll leave the final decision up to @rwaldron though. Adding this does mean changing the IO plugin API afterall.

rwaldron, 2015-07-01:
@nebrius I think we might as well make it available wherever possible. The thing that made me come around was being reminded of the end developer experience. If you can do support here, I will update all the IO-Plugins that I maintain. I've updated the IO-Plugin spec: https://github.com/rwaldron/io-plugins

nebrius, 2015-07-02:
I just published v3.3.0 of raspi-io, which includes a stub for pingRead. Currently it just throws an error stating "pingRead is not yet implemented", which is the same error all the other unimplemented methods state.

@sesh-kebab if you get some working code, would you be interested in adding that to raspi-io proper? I can help you with the integration process.

sesh-kebab, 2015-07-03:
@nebrius yes, I absolutely would be interested. Will definitely need your help with the integration process. Hope to have something soon.

nebrius, 2015-07-04:
@sesh-kebab Fantastic, let me know when you're ready!

sesh-kebab, 2015-09-02:
Hi @nebrius - sorry I took a very long vacation (recieved Splatoon on WiiU for my birthday).

Just wanted to let you know I have built a native nodejs extension [raspi-sonar](https://github.com/sesh-kebab/raspi-sonar) to support pingRead on Raspberry Pi. I need to trigger the ping on a separate thread among other things; just wanted to check in to see whether I'm on the right track.

My implementation currently allows the signal pins and trigger pins to be different. But the pingRead [io plugin spec](https://github.com/rwaldron/io-plugins) doesn't allow for this. Is this not really a valid use case? Does everyone using this sensor on a Raspberry Pi, always run both the trigger and signal of the same IO pin?

nebrius, 2015-09-02:
@sesh-kebab I hear Splatoon is a ton of fun!

My understanding is that the single pin is sufficient for what we do, but maybe @rwaldron can provide some more insight?

Nice work on raspi-sonar so far, I think you're mostly on the right track. I do have two recommendations for you that will make maintenance easier.

I would recommend using Native Abstractions for Node (https://github.com/nodejs/nan). This provides a wrapper around a lot of the V8 stuff and protects your C++ from breaking changes in V8, which occur with pretty much every major Node release.

NAN also provides nice threading abilities out of the box for you, so be sure to check out the async stuff. For an example using wiring pi, check out the main raspi package and the init method: https://github.com/nebrius/raspi/blob/master/src/init.cc

The other thing I would recommend changing is how you're distributing the binary. If you want to distribute pre-built binaries, I would recommend taking a look at node-pre-gyp (https://github.com/mapbox/node-pre-gyp). The other option, and the one I do right now, is to have the code built at module install time. Neither are great solutions, but it's all we have right now.

The thing with pre-built binaries is that you have to provide a lot of them to support different combinations of things. We need to support both armv6 and armv7, as well as node 0.10, node 0.12, the various io.js flavors, and soon node 4, which means you have to supply _6_ binaries. Fortunately for us, we don't have to support the entire matrix that some of the other native modules do (over 60 combinations :-O).

Feel free to borrow whatever you need from the raspi package (build setup, tooling, code snippets, etc) to make your life easier.

I realize that all of this native module support stuff is a pain to work with. Native modules are a major pain point for node as a whole, and there are several initiatives underway to make all this easier down the road, but of course that doesn't help us right now :-/

Thanks for taking this on! I really appreciate the help, especially since this involves some native code. Keep up the good work, and let me know if there's any other way I can help!

rwaldron, 2015-09-02:
> My implementation currently allows the signal pins and trigger pins to be different. But the pingRead io plugin spec doesn't allow for this

These are usually the same pin and when they are not, we instruct users to jump the trigger and echo pins. Considering this is a really fringe case, no new updates are going to be made for `pingRead`. These sensors will soon be fully supported via I2C Backpack controllers.

born2net, 2015-09-03:
having the same issue with pingRead :(

```
>> /root/node_modules/raspi-io/lib/index.js:765
        throw new Error("pingRead is not yet implemented");
              ^
Error: pingRead is not yet implemented
    at Raspi.pingRead (/root/node_modules/raspi-io/lib/index.js:765:15)
    at Ping.<anonymous> (/root/node_modules/johnny-five/lib/ping.js:45:13)
    at wrapper [as _onTimeout] (timers.js:274:14)
    at Timer.listOnTimeout (timers.js:119:15)
PI-~/johnyfive->
```

sesh-kebab, 2015-09-09:
@nebrius wow thank you so much for providing all the great info. Glad to be of help - I had no idea I would be knee deep in c++ code but definitely a lot of fun to be contributing to a great library. I have started a new branch using the NAN. Will let you know once everything is working ok and promoted to master.

@rwaldron ok - thanks for the explanation. I was under the impression that jumping trigger and echo, on a RaspberryPI at least, would be a no go as the ECHO outputs 5v bit more than the 3.3v that the Pi's GPIO would ideally like?

@born2net working on getting this implemented - hopefully in a couple of weeks :)

nebrius, 2015-09-09:
@sesh-kebab Nobody expects the C++ inquisition! :D

You can use a voltage divider network to scale the signal from 5v down to 3.3v by putting two resistors in series. Check out the section on voltage divider network at http://www.electronics-tutorials.ws/resistor/res_3.html. In this case, Vin will be connected to ECHO (and set to 5v for calculations), and Vout will be connected to the Pi (and set to 3.3v for calculations). If you set R1 to 1k ohm, then R2 would be 2k ohm.

rwaldron, 2015-10-08:
Seems resolved?

Workshop2, 2016-01-10:
Can someone explain to me how to use proximity for Raspberry Pi? I also get the "not yet implemented" and I can't see any usage/help for the code @sesh-kebab has written. *help*

rwaldron, 2016-01-10:
ping @nebrius

nebrius, 2016-01-11:
What is the current state of raspi-sonar @sesh-kebab? Once that module is ready, it will need to be integrated into raspi-io.

So @Workshop2 the short answer is, you can't use it yet, sorry.

sesh-kebab, 2016-01-12:
@nebrius the status hasn't progressed since last post sorry. I have been able to use my native extension raspi-sonar, side-by-side with raspi-io.

I'll get my test circuit up and running again tonight and work towards having it ready to be integrated this week.

nebrius, 2016-01-12:
Thanks @sesh-kebab!

rwaldron, 2016-01-12:
Another option is to use the [GrovePi shield](http://www.dexterindustries.com/grovepi/):

```js
var five = require("johnny-five");
var Raspi = require("raspi-io");

var board = new five.Board({
  io: new Raspi()
});

board.on("ready", function() {
  // Use an Expander to create a Virtual board:
  var virtual = new five.Board.Virtual(new five.Expander("GROVEPI"));

  var proximity = new five.Proximity({
    board: virtual,
    controller: "HCSR04",
    pin: "D7"
  });

  proximity.on("change", function() {
    console.log("%dcm", Math.round(this.cm));
  });
});
```

sesh-kebab, 2016-01-13:
@nebrius I'm trying to figure out what needs to be exposed from the native node plugin.

[Proximity](http://johnny-five.io/api/proximity/) class usage sample looks like this:
```javascript
var proximity = new five.Proximity({
    controller: ...,
    pin: "A0",
    freq: "25ms"    //note in milliseconds
  });

  proximity.on("data", function() {
    console.log("inches: ", this.inches);
    console.log("cm: ", this.cm);
  });

  proximity.on("change", function() {
    console.log("
```
What needs to be supported from rasp-io according to the [io-plugins spec](https://github.com/rwaldron/io-plugins):
```javascript
pingRead(settings, handler)
//settings object
{
    pin: 0,            //plugin spec says pin number but can that also mean 'A0'?
    value: "HIGH",  //what is this value and how should I take it into account?
    pulseOut: 5  //what is this value and how should I take it into account?
}
```

I'm assuming pingRead is all that is need to support the abstractions provided by Proximity i.e., data and change events.

One last question (for now), if someone wanted to stop taking readings from the proximity sensor, how will that need to be supported?

nebrius, 2016-01-13:
@sesh-kebab here's an initial recommendation for the raspi-sonar skeleton/API:

```JavaScript
import { Peripheral } from 'raspi-peripheral';

export class Sonar extends Peripheral {
  constructor(config) {
    // Initialize here
  }

  read(cb) {
    // Calls the callback once read. Performs a single read.
  }
}
```

Then we can handle the whole `Create a single data event, invoking handler once per read, continuously and asynchronously reading` bit in raspi-io, similar to how we do `digitalRead` in raspi-io.

sesh-kebab, 2016-01-18:
@nebrius thanks - that makes it a lot easier to implement from my side. I have made really good progress over the weekend here [raspi-sonar](https://github.com/sesh-kebab/raspi-sonar/tree/native-abstractions-node).

##### Caveat:
* I'm using [wiringpi](http://wiringpi.com) C library in my native node extension.
* Accessing GPIO directly which will require root privileges i.e., sudo

##### Next steps:
* Need to create a build script as part of the NPM install that
    * Downloads WiringPi. builds and installs
* Will create an NPM package
* Once I can get raspi-sonar down as an NPM package to any project and have it building, this is when I think I can start integrating into raspi-io. I expect to add raspi-sonar as a dependency to raspi-io and use it like below, based on your skeleton implementation.

``` javascript
import { Peripheral } from 'raspi-peripheral';
var pingReadExtension = require('build/release/raspiSonarExtention');

export class Sonar extends Peripheral {
  constructor(config) {
    // Initialize here
    this.sonar = pingReadExtension.sonarFactory(15);

  }

  read(cb) {
    // Calls the callback once read. Performs a single read.
    this.sonar.read(function(duration) {
        console.log('sonar.read callback called: ' + duration);
    });
  }
}
```

##### Questions:
* Am I still on the right track?
* Is the [GNU LGPG v3](http://www.gnu.org/copyleft/lesser.html) license that WiringPi is released under, going to cause any issues?

nebrius, 2016-01-18:
Great to hear!

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

[raspi-gpio](https://github.com/nebrius/raspi-gpio), [raspi-pwm](https://github.com/nebrius/raspi-pwm/), and [raspi](https://github.com/nebrius/raspi-pwm/) also use wiringpi, so it's not a problem as long as you follow the same mechanisms they use. Notice how raspi depends on raspi-wiringpi, which in turn dynamically downloads wiringpi. This is important because GPLv2 is explicitly concerned with _distribution_, which by dynamically downloading means we're not distributing and get around the GPL license.

You should make sure that the wiring pi dependencies work the same as raspi-gpio and raspi-pwm, and then you'll be fine. The actual wiring pi dependency is implicit in those two packages, because it's explicitly defined in raspi, so in practice you don't have to do anything for wiring pi!

> Am I still on the right track?

Yeah I think so. I would pay attention to the build process that gets put in place for the ES6 bits (feel free to borrow https://github.com/nebrius/raspi-gpio/blob/master/gulpfile.js wholesale for this). You may need to adjust the paths to the built native module, depending on where your build system puts the build JavaScript file.

nebrius, 2016-01-18:
Oh, and feel free to borrow anything else from raspi-gpio, especially [binding.gyp](https://github.com/nebrius/raspi-gpio/blob/master/binding.gyp), since it's slightly more complicated with NAN

sesh-kebab, 2016-01-18:
Ok cool :smile: - didn't realise WiringPi was already in use. That should make things simpler again. And no problem for the NAN requirement; raspi-sonar is based on the NAN boilerplate extension.

Closed 2015-10-08.

Thread 851 (2015-07-05):

Problem: One Arduino, 4 motors and 2 servos

tsofist, 2015-07-05:
I'm using Arduino Nano (although the effect is repeated on the Arduino Pro Micro) for the control of four motors and two servo motors.
The motors are controlled by the driver on the basis of L298N.
Without initialization servo drives work fine: you can change speed and direction.
When initializing at least one servo one of the motors starts to behave strangely: does not respond to reverse or change the speed, but the servo work well.
Used pins:
    motors: 2-3, 4-5, 6-7, 8-9
    servos: 10, 11

I use a direct connection with a computer via USB on Windows (and trying on Raspbian)

Initialization:
```javascript
	var flMotor, frMotor, blMotor, brMotor,
		vServo, hServo;
	vServo = new five.Servo({ pin: 11, range: [0, 160], startAt: 70 });
	hServo = new five.Servo({ pin: 10, range: [0, 180], startAt: 60 });
	flMotor = new five.Motor({ pins: [6, 7], invertPWM: true });
	frMotor = new five.Motor({ pins: [3, 2], invertPWM: true });
	blMotor = new five.Motor({ pins: [9, 8], invertPWM: true });
	brMotor = new five.Motor({ pins: [5, 4], invertPWM: true });
```

I would be grateful for any help!

dtex, 2015-07-05:
See this comment:

https://github.com/rwaldron/johnny-five/issues/309#issuecomment-37071805v

I suspect this is the cause of your issue as well. Can you try switching the pins on blMotor so that you are not using pin 10?

tsofist, 2015-07-05:
Thank you much, dtex!
Now it's all working!!
It solved my issue and I think it should be described in the documentation.
Initialization:
```javascript
var flMotor, frMotor, blMotor, brMotor,
    vServo, hServo;
vServo = new five.Servo({ pin: 10, range: [0, 160], startAt: 70 });
hServo = new five.Servo({ pin: 9, range: [0, 180], startAt: 60 });
flMotor = new five.Motor({ pins: [6, 7], invertPWM: true });
frMotor = new five.Motor({ pins: [3, 2], invertPWM: true });
blMotor = new five.Motor({ pins: [11, 12], invertPWM: true });
brMotor = new five.Motor({ pins: [5, 4], invertPWM: true });
```

dtex, 2015-07-05:
I don't disagree but the rub is not all boards are the same. I wonder if we could build a guard object into board.pins.js that can be used to lookup pins with disabled PWM when servos are in use?

What do you think @rwaldron ?

rwaldron, 2015-07-06:
I like the idea of providing useful "failure" to the user, but I'm not sure how this would work in an IO-Plugin agnostic way

dtex, 2015-07-06:
It seems to come up once a quarter or so. I'll noodle on it for a while and see if I can think of something that's simple and effective.

Closed 2015-07-05.

Thread 854 (2015-07-07):

changing the frequency of events for an existing device instance

mMerlin, 2015-07-07:
Mentioned in a comment for PR #844, and confirmed by more recent additions to test/sensor.js, changing the freq property does not change the interval between data (or other) events.  A quick check of other component code seems to show that same problem everywhere.  It also showed several different default freq values.
* 20 : Pin
* 25 : Barometer, Motion, Pir, Proximity, Sensor, Temperature
* 50 : IR.Reflect, IR.Proximity (when instance of IR)
* 100 : Magnetometer, Sonar, Temperature (specific driver), Wii.Nunchuck, Wii.Classic
* 500 : IMU, IR, Wii

The main query here is, what is the intended / appropriate functionality when changing the freq property of an existing device instance?

Looking over the code to collect information about the existing functionality, I noticed a few other things:

expander.js uses state.frequency and opts.frequency versus freq property used by most other components.  Should some alignment (or aliasing) be done to get that to match?

compass.js has a comment showing creation with a freq value of 50, and another comment that says the default is 66 ms.  I do not see any actual references to the freq property in the code.  It appears that the comments are cut and pasted from the code for whatever component was used as the base for creating the Compass component.  joystick.js is similar.  A comment, but no apparent property.
Magnetometer is an instance of Compass, and passes a specific value for the freq property, but I do not see where that gets used.  The code that emits (compass) data and change events does not seem to use it.  Those are sent directly by the callback function passed through initialize to io.i2cRead.  No throttling is being done.  Does compass need a structure similar to sensor, to accumulate readings, then send only a filtered value?

rwaldron, 2015-07-07:
> changing the freq property does not change the interval between data (or other) events. A quick check of other component code seems to show that same problem everywhere.

It wasn't meant to—the property should be readonly and value storage moved to internal state. To update the interval times would require messy interaction with the internal intervals.

> 20 : Pin

This is an attempt to matche the default sampling interval of StandardFirmata, but should just be updated to match the "Barometer, Proximity, Sensor, Temperature"

> Barometer, Motion, Pir, Proximity, Sensor, Temperature

- Barometer, Proximity, Sensor, Temperature... arbitrarily this might as well be the default.
- Motion, Pir are deprecated and will no longer be updated for any reason.

> 100 : Magnetometer, Sonar, Temperature (specific driver), Wii.Nunchuck, Wii.Classic

-  Magnetometer should be updated to match "Barometer, Proximity, Sensor, Temperature"
- Sonar is deprecated and will no longer be updated for any reason. Magnetometer should
- Temperature (specific driver) might have constraints? I'll take a look
- Wii.Nunchuck, Wii.Classic... eventually these are going to be removed and put into a separate repo/module. I say just make them match the other sensor components

>  : IR.Reflect, IR.Proximity (when instance of IR)

Both deprecated and will no longer be updated for any reason.

Deprecated things will be removed for 1.0

> expander.js uses state.frequency and opts.frequency versus freq property used by most other components. Should some alignment (or aliasing) be done to get that to match?

I've mentioned before... somewhere... that "freq" was a bad name for that property, it should be "period". The "frequency" property seen in expander.js is actually for setting the frequency in Hz for that controller.

> compass.js has a comment showing creation with a freq value of 50, and another comment that says the default is 66 ms. I do not see any actual references to the freq property in the code. It appears that the comments are cut and pasted from the code for whatever component was used as the base for creating the Compass component. joystick.js is similar. A comment, but no apparent property.

It's just copy/paste junk in joystick, because there is no utility to having such a limitation on joystick, so let's just delete it. In compass, that's sounds like a bug, I will confirm as soon as I have time to take a look.

> Magnetometer is an instance of Compass, and passes a specific value for the freq property, but I do not see where that gets used. The code that emits (compass) data and change events does not seem to use it. Those are sent directly by the callback function passed through initialize to io.i2cRead. No throttling is being done. Does compass need a structure similar to sensor, to accumulate readings, then send only a filtered value?

Yeah, I think that's my fault :| It should be like Temperature or Accelerometer

mMerlin, 2015-07-07:
>>  changing the freq property does not change the interval between data (or other) events. A quick check of other component code seems to show that same problem everywhere.

> It wasn't meant to—the property should be readonly and value storage moved to internal state. To update the interval times would require messy interaction with the internal intervals.

I could do readonly no problem.  Messy?  Maybe.  I think I have the structure needed to implement it.  It did not look that bad to me.  Concept outline would move freq to internal storage as for readonly, plus add a setter function.  The setter would execute a clearInterval(savedId), then savedId=setInterval().  The callback for setInterval could be moved to a named function (outside of the constructor function) instead of anonymous (to avoid creating multiple copies of the function).  Moving the median calculation was already in the plans, to later implement changing the filtering function.  Doing the interval processing function as well is not much more.

mMerlin, 2015-07-09:
> I've mentioned before... somewhere... that "freq" was a bad name for that property, it should be "period".

I've seen that before.  Only got mentioned here because both freq and frequency were being used.  As you say, frequency was appropriate where it was used, being 1/period for that context.

Instead of period, perhaps "interval" would be a good choice to replace the freq property.  That is what the standard javascript uses: setInterval, clearInterval

rwaldron, 2015-07-10:
`interval` works for me. Let's settle on that for eventual 1.0 :)

rwaldron, 2015-11-05:
This is in! https://github.com/rwaldron/johnny-five/commit/0d5887b1c949d8d33d8b6b083361ec4507799d41

Closed 2015-11-05.

Thread 956 (2015-11-10):

Implement HC-SR04-I2C-BACKPACK controller

ajfisher, 2015-11-10:
Implement a controller which works for the HC-SR04 module that works with the backpack at https://github.com/ajfisher/nodebots-hcsr04

@ajfisher to implement - this here as a note to finish it off.

ajfisher, 2015-11-11:
Just got to fix a test - but this is failing on the within test.

```javascript
exports["Proximity: HCSR04I2C"] = {
  setUp: function(done) {
    this.board = newBoard();
    this.clock = sinon.useFakeTimers();
    this.i2cConfig = sinon.spy(MockFirmata.prototype, "i2cConfig");
    this.i2cReadOnce = sinon.stub(MockFirmata.prototype, "i2cReadOnce", function(ADDRESS, BYTES_TO_READ, callback) {
      var pulseval = 1000;
      // Split to HIGH and LOW
      console.log(pulseval);
      callback(pulseval);
    });

    this.proximity = new Proximity({
      controller: "HCSR04I2C",
      freq: 100,
    });

    done();
  },

  tearDown: function(done) {
    this.i2cConfig.restore();
    this.i2cReadOnce.restore();
    this.clock.restore();
    done();
  },

  shape: function(test) {
    test.expect(proto.length + instance.length);

    proto.forEach(function(method) {
      test.equal(typeof this.proximity[method.name], "function");
    }, this);

    instance.forEach(function(property) {
      test.notEqual(typeof this.proximity[property.name], 0);
    }, this);

    test.done();
  },

  data: function(test) {
    var spy = sinon.spy();
    test.expect(1);

    this.proximity.on("data", spy);
    this.clock.tick(100);
    test.equal(spy.callCount, 1);
    test.done();
  },

  change: function(test) {
    test.expect(1);

    var spy = sinon.spy();

    this.proximity.on("change", spy);

    this.clock.tick(100);

    test.ok(spy.called);
    test.done();
  },

    // TODO FIX THIS
  within: function(test) {
    var spy = sinon.spy();
    test.expect(2);

    this.clock.tick(250);

    this.proximity.within([0, 120], "inches", function() {
      test.equal(this.inches, 5.85);
      spy();
    });

    this.clock.tick(100);
    test.ok(spy.calledOnce);
    test.done();
  }
};
```

Error:

```bash
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
```

I can't for the life of me see why it would be sending a NAN when the other two pass....

soundanalogous, 2015-11-11:
Is the backpack's I2C interface specific to the HCSR04? Would it be possible to create an i2c interface that covers a range of proximity devices (those that would require a backpack at least), or is the HCSR04 the only proximity sensor that currently needs a backpack?

ajfisher, 2015-11-11:
So I haven't tested this with a parallax Ping but it should work. At the moment, I think this is the only one that doesn't provide an i2c interface that is in common use within the nodebots world (as they are only a couple of bucks)

frxnz, 2015-11-13:
This was closed with https://github.com/rwaldron/johnny-five/commit/662098bce2efa52549e35fd387aeac7b711292ea

Closed 2015-11-13.

Thread 1002 (2016-01-07):

Multiple proximity sensors

Sparo, 2016-01-07:
Hi all,

I have 2 'HCSR04' and idea is to check two distances.

I am using SeeedStudio Ultrasonic Range and grove base shield for Arduino Uno
http://www.seeedstudio.com/wiki/Base_shield_v2

My code is something like this

```
...
var five = require('johnny-five');
var board = new five.Board();

var proximity1, proximity2;
var the_Array1 = [];
var the_Array2 = [];

board.on('ready', function() {
	...

	proximity1 = new five.Proximity({
		controller: 'HCSR04',
		pin: 'D3'
	});
	proximity2 = new five.Proximity({
		controller: 'HCSR04',
		pin: 'D4'
	});

	proximity1.on('data', function(data) {
		the_Array1.push(data);
		if (the_Array1.length === 50) {
			the_Array1.shift();
			// console.log(the_Array1);
		}
	});

	proximity2.on('data', function(data) {
		the_Array2.push(data);
		if (the_Array2.length === 50) {
			the_Array2.shift();
			// console.log(the_Array2);
		}
	});
});
```

so I have problem that looks like this:

```
/device/node_modules/johnny-five/node_modules/firmata/lib/firmata.js:1319
  if (this.pins[opts.pin].supportedModes.indexOf(PING_READ) === -1) {
                         ^

TypeError: Cannot read property 'supportedModes' of undefined
    at Board.pingRead (/device/node_modules/johnny-five/node_modules/firmata/lib/firmata.js:1319:26)
    at Proximity.<anonymous> (/device/node_modules/johnny-five/lib/proximity.js:176:19)
    at Proximity.Controllers.HCSR04.initialize.value (/device/node_modules/johnny-five/lib/proximity.js:182:9)
    at new Proximity (/device/node_modules/johnny-five/lib/proximity.js:440:10)
    at Board.<anonymous> (/device/hardware.js:19:15) // it is this line: --> proximity1 = new five.Proximity({
    at emitNone (events.js:67:13)
    at Board.emit (events.js:166:7)
    at doNTCallback0 (node.js:417:9)
    at process._tickDomainCallback (node.js:387:13)

```

so now I am not sure where to go next... I have not seen that somebody tried to create multiple proximity sensor on one board with johnny five lib ?

rwaldron, 2016-01-09:
Hi, I suspect there is no issue with have multiple hcsr04 devices. Two things:

- Currently, Johnny-Five does not accept digital pin names prefixed with "D" for Arduino board connections—this is because the convention is to use the pin name/number as it appears on the board, not as appears on arbitrary shields. I can try to make that work for shields we encounter, but there is no way to know how every shield labels its pins. I'd rather not special case pin normalization for every single shield, because I predict that could be very messy. I'm not against addressing cases that are probably pretty common (like this one). Let me think about that a little more. For now, just change those to the numbers `3` and `4`.
- Please make sure that you've followed the instructions for using hcsr04 with an Arduino board: http://johnny-five.io/api/proximity/#pingfirmata

It would be remiss of me if I didn't warn you that these sensors are process blocking on the board and may cause strange behavior if you're also attempting to do write operations to other components attached to the board.

Sparo, 2016-01-11:
I have tried just with 3 and 4 and it has worked without removing Grove base shield for Arduino Uno, so I guess it works like that also...

tnx for suggestion !

rwaldron, 2016-01-22:
No problem, glad to help!

Closed 2016-01-22.

Thread 1017 (2016-01-20):

Multiple boards with steppers: works one or two times then errors: "device or firmware error"

Snodvod, 2016-01-20:
code link: https://github.com/Snodvod/WeatherStation

I'm able to use one stepper motor, but when I try to connect another one and use it I get this timeout... Configurable Firmata is correctly installed

``` js
var app = require('http').createServer(handler);
var io = require('socket.io')(app);
var five = require('johnny-five');
var stepperctl = require('./steppercontrol');
var ports= [
    {id: 'UNO', port:"COM4"},
    {id: 'MEGA', port:"COM3"},
];
var posClockH = 0,
    posClockM = 0,
    posTemp1 = 0,
    posTemp2 = 0,
    posWeather = 0,
    posWind = 0;

var posSteppers = [posClockH, posClockM, posTemp1, posTemp2, posWeather, posWind];

app.listen(3500);

new five.Boards(ports).on("ready", function () {
    console.log('Boards ready');
    // Arduino UNO
    var clockH = new five.Stepper({
        type: five.Stepper.TYPE.FOUR_WIRE,
        board: this.byId('UNO'),
        pins: [12, 11, 10, 9],
        stepsPerRev: 64
    });
    var clockM = new five.Stepper({
        type: five.Stepper.TYPE.FOUR_WIRE,
        board: this.byId('UNO'),
        pins: [7, 6, 5, 3],
        stepsPerRev: 64
    });
    //Arduino MEGA
    var temp1 = new five.Stepper({
        type: five.Stepper.TYPE.FOUR_WIRE,
        board: this.byId('MEGA'),
        pins: [22, 13, 12, 11],
        stepsPerRev: 64
    });
    var temp2 = new five.Stepper ({
        type: five.Stepper.TYPE.FOUR_WIRE,
        board: this.byId('MEGA'),
        pins: [24, 10, 9, 8],
        stepsPerRev: 64
    });
    var weather = new five.Stepper ({
        type: five.Stepper.TYPE.FOUR_WIRE,
        board: this.byId('MEGA'),
        pins: [26, 7, 6, 5],
        stepsPerRev: 64
    });
    var wind = new five.Stepper ({
        type: five.Stepper.TYPE.FOUR_WIRE,
        board: this.byId('MEGA'),
        pins: [28, 4, 3, 2],
        stepsPerRev: 64
    });

    stap(clockH, posSteppers, 500);

    function stap(stepper, posArray, nextPos) {
        console.log(posArray[stepper.id]);
        var steps = Math.floor(stepperctl.calcSteps(posArray[stepper.id], nextPos));
        if(steps < 0) {
            console.log('Counterclockwise');
            stepper.ccw().step(Math.abs(steps), function() {
                console.log('stepped ccw');
            });
        } else {
            stepper.cw().step(steps, function() {
                console.log('stepped cw');
            });
        }

        posArray[stepper.id] = nextPos;

    }

    io.on('connection', function(socket) {
        console.log("Companion connection succesful");
        //Global 'change' event is emmitted when the user chooses a new city
        socket.on('weather', function(data) {
            console.log(data);

            // switch (data.weather[0].main) {
            //  case 'Rain':
            //  case 'Clouds':
            //  case 'Clear':
            //  case 'Mist'
            // }
        });

        socket.on('clock', function(data) {
            var localtime = new Date(data);

            var hours = localtime.getHours()-1;
            if(hours > 12) {hours = hours-12;}
            var minutes = localtime.getMinutes();
            stap(clockH, posSteppers, (hours)*30);
            stap(clockM, posSteppers, minutes*6);
        })

        socket.on('quit', function() {
            for(var index in steppers) {
                stap(steppers[index][0], steppers[index][1], 0);
            }
            app.close();
        })
    });
});

function handler(req, res) {
    res.writeHead(200);
    res.end('Working');
    console.log('Server has started');
}

console.log('Server is running on localhost:3500');
```

dtex, 2016-01-20:
Sounds like a brown out. Can we see a pic of the wiring?

Snodvod, 2016-01-20:
I can give a picture of it tomorrow, but is it possible that the steppers ask too much from the arduino pins? Maybe try to power it with an external 9V power supply...

dtex, 2016-01-20:
Oh yes, that's exactly what I was going to look for. Stepper motors will draw more current than your computer's USB port can supply. That will cause your Arduino to shut down. You will need to use external power for sure.

Snodvod, 2016-01-20:
I've been thinking about this problem the whole day and this solution suddenly popped into my head :D Thanks for the confirmation, I'll let you know if it worked. Thanks in advance

Snodvod, 2016-01-21:
So, with a proper power supply added I still ran into this problem... But it's not really the amount of steppers attached, cause when I connect 4 steppers to my arduino MEGA there's no problem, it's just when the 2 arduino's are connected...

dtex, 2016-01-22:
It still sounds like a brown out. Are both Arduinos on the same USB port?

Snodvod, 2016-01-22:
No on 2 different ports, already tried another arduino board to...

rwaldron, 2016-01-22:
@Snodvod can you provide a picture (or a few) of your project?

dtex, 2018-01-16:
@Snodvod I'm going to close this since we haven't heard back. Please feel free to re-open if necessary.

Closed 2018-01-16.

Thread 1019 (2016-01-23):

Add support for 5-wire servo

Resseguie, 2016-01-23:
In older electronics (particularly toys and RC vehicles), you often come across a "5-wire servo". It's actually a motor, gears, and potentiometer packaged together, much like a modern servo, but without the logic built in. When hacking on these devices and controlling them with Johnny-Five, it would be very handy to just treat it like any other servo (since functionally it is equivalent). But currently you have to re-write the logic each time to read the pot value in order to control precise position of the motor. Ideally I'd just like to use the existing Servo API.

I'm interested in this because I enjoy hacking vintage toys and I've come across this a few times. I've mentioned this in Gitter a few times (and some of you in person at hackathons), but I don't think we ever came to a consensus on the best way to handle it. Decided to create an issue to track things better.

Here is a sample of such a 5-wire servo from a Teddy Ruxpin toy that I'm working on:

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

discgolfer1138, 2016-05-06:
I too have been working on hacking a Teddy Ruxpin.  More specifically, I've been baffled by the servo wiring. I was trying my best to figure out what was in there without too much disassembly.

I've been able to get the eye servo and the upper and lower jaw servos to work by just applying power and then reversing it.  Nothing useful yet, just wanted to verify that they operate.

More importantly, have you figured out a reliable way to control that motor via Johnny-Five.

Since there is no consistency to the wire colors that Worlds of Wonder used.. I can only guess based on orientation.

Any additional info you have would be greatly appreciated :)

rwaldron, 2016-05-06:
Can you find me a link to buy one or two of these servos? Thanks

discgolfer1138, 2016-05-07:
I am going to replace the stock servos in my Teddy Ruxpin with 2 HiTec standard 3-wire servos. When I do, I will be careful in removing the original 5-wire servos and would be happy to send them to you.

rwaldron, 2016-05-09:
Whoa, that would be amazing. Keep me posted :)

discgolfer1138, 2016-05-09:
will do! making progress.. https://vimeo.com/16487186
The new servos should arrive Thursday, hoping to perform the surgery over the weekend.

dtex, 2017-08-17:
@yamanote1138 @Resseguie I'm on a mission to close all issues associated with servos. Do either of you have a Teddy Ruxpin servo you could part with for a couple of weeks?

yamanote1138, 2017-11-11:
Sorry, I ended up using an h-bridge to solve my problem, so the original motors are still in use.  On a related note, I now have an army of 3 Teddy Ruxpins and one Grubby (Teddy's creepy caterpillar friend).

here's a couple test videos:
[Teddy Test - Surely](https://vimeo.com/242348473)
[Grubby Test - Taunter](https://vimeo.com/242348635)

dtex, 2018-01-11:
Hi @Resseguie  ,

Johnny-Five contributors and maintainers are loathe to close issues where someone has a need. We don't want anyone to ever feel that we don't care, but we just haven't gotten to this feature yet. Rather than leave it languishing as an open issue we have created a [Requested Features](../wiki/Requested-Features) page and added your request for 5-wire motors there.

On a personal note, I really want to get this done. My friend @ryanjgill hacks a lot of toys so I'm pinging him to see if he has any motors (servos) that are wired like this.

ryanjgill, 2018-04-03:
Sorry @dtex just saw this. I'm pretty sure I have 2 or 3 of these from old RC cars. I could get you a few if you still need them.

dtex, 2018-04-03:
I think it would be nice to add support or at least an example that mixes sensor and servo.

I'll let you know if I'm able to make it out to a meetup anytime soon.

It doesn't look like we are doing NBD this year.

yamanote1138, 2020-01-05:
fwiw, I've recently put this project back on my workbench and am researching the servos once again. In case you haven't already seen it, I came across this [video](https://www.youtube.com/watch?v=sjR7502_tRI) which explains, in detail why Teddy's servos have 5 wires and where the on-board potentiometer fits into the equation. Just figured I'd share...

@Resseguie in your initial post, you mentioned working with these motors and, I think, figuring out how to handle/utilize the potentiometer. Any chance you have any snippets or a repo you could share?

in the meantime, my current project lives [here](https://github.com/yamanote1138/johnny-ruxpin) (warning: total WIP)

Closed 2018-01-11.

Thread 1020 (2016-01-24):

PingFirmata not found

mulderp, 2016-01-24:
Hi,

I am playing with a small robot with HSR04 sensor.

Flashing the PingFirmata looked successfull, but I get an error when I start up the HSR04 example:

```
pm:vehicle pmu$ node proximity_hello.js
1453638857437 Device(s) /dev/cu.usbserial-AL01TQ76
1453638857447 Connected /dev/cu.usbserial-AL01TQ76
1453638860882 Repl Initialized
>> { supportedModes: [],
  mode: undefined,
  value: 0,
  report: 1,
  analogChannel: 127 }
/Users/pmu/projects/embedded/book/ch_9_making_robots_with_nodejs/vehicle/node_modules/johnny-five/node_modules/firmata/lib/firmata.js:1321
    throw new Error("Please upload PingFirmata to the board");
          ^
Error: Please upload PingFirmata to the board
    at Board.pingRead (/Users/pmu/projects/embedded/book/ch_9_making_robots_with_nodejs/vehicle/node_modules/johnny-five/node_modules/firmata/lib/firmata.js:1321:11)
    at Proximity.<anonymous> (/Users/pmu/projects/embedded/book/ch_9_making_robots_with_nodejs/vehicle/node_modules/johnny-five/lib/proximity.js:176:19)
```

mulderp, 2016-01-24:
Btw, I am trying to make this small robot work with Johnny-5: http://hackarobot.com/fabric-shield-monthly-giveaway/

Based on Arduino Nano, L293D to drive motors, and HC SR04 for proximity, some Arduino examples are here: https://github.com/ThomasCLee/funnyvale/tree/master/hackabot_nano ) The proximity sensor is wired to A0 and A1. Arduino Code for this is:

```
float getDistance() {
   digitalWrite(TRIGGER_PIN, LOW);
   delayMicroseconds(2);
   digitalWrite(TRIGGER_PIN, HIGH);
   delayMicroseconds(10);
   digitalWrite(TRIGGER_PIN, LOW);
   return (  pulseIn(ECHO_PIN, HIGH) *0.017);
}
```
(/cc @ThomasCLee )

mulderp, 2016-01-24:
Can `pulseIn()` be written with JavaScript ?

ThomasCLee, 2016-01-24:
I am not familiar with JavaScript, but in theory, it should be doable.

You need to monitor the echo pin when it goes low, you store the current
time. It then goes into a while loop. When the echo pin goes high, it
exists. You compare the time when it exits verses the time you stored
earlier. The difference is the pulse width.

You may need to add a timeout check for the while loop just in case.

On Sunday, January 24, 2016, Patrick Mulder <notifications@github.com>
wrote:

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

rwaldron, 2016-01-26:
HCSR04 won't work when attached to analog inputs, it needs to be attached to a digital input.

> Can pulseIn() be written with JavaScript ?

No, but that's not really the issue here.

ThomasCLee, 2016-01-26:
A0 and A1 pins could be analog as well as digital inputs (not just analog).

On Tue, Jan 26, 2016 at 11:12 AM, Rick Waldron <notifications@github.com>
wrote:

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

rwaldron, 2016-01-26:
> A0 and A1 pins could be analog as well as digital inputs (not just analog).

Yes, I'm aware of this, but Johnny-Five has always used the user provided pin name value to infer user intent. Using the literal `"A0"` is assumed to mean: "I want this pin treated as an analog input pin, because that's a precedent that I learned from using Arduino". That being said, `Proximity` w/ HCSR04 can be updated to accept `"A0"` and do the right thing.

mulderp, 2016-01-26:
(Interesting discussion, I was not aware that A0/A1 are GPIOs as well, but indeed it makes sense. Arduino mentions it too "The analog input pins can be used as digital pins, referred to as A0, A1, etc." see https://www.arduino.cc/en/Reference/DigitalRead )

rwaldron, 2016-01-26:
@mulderp thanks for the report! v0.9.19 is on npm now. This was tested using:

- HCSR04
- Parallax Ping

And an example + diagram here: https://github.com/rwaldron/johnny-five/blob/master/docs/proximity-hcsr04-analog.md

mulderp, 2016-01-28:
Thanks!
Indeed, now it works great!
To make the example work with @ThomasCLee hackarobot, one need to add a jumper between A0 and A1. Next up, I'll check the combination with an MPU-6050 to read the bot's position. But was working earlier already.

Closed 2016-01-26.

Thread 1021 (2016-01-26):

Proximity (Sharp GP2Y0A02YK0F) with Particle Photon reading is different after restart of node program

fabianmoronzirfas, 2016-01-26:
**Board:** Particle Photon
**Shield:** none
**Hardware:** Sharp GP2Y0A02YK0F distance sensor
**Johnny-Five Version:** 0.9.17
**Node version:** 0.12.9
**OS:** OSX 10.11.3
**Expected result:** same result after rerunning the program
**Current result:** Values in first run are okay. sensor does not react to objects in second run
**Steps to reproduce:** See the code and a fritzing sketch below
**video:** https://vimeo.com/153079052

---

Hi. We already discussed this problem in the gitter chat. I'll add an issue here to have it persistent. When having a hardware setup like shown in the image, I get the following problem.

I can run the attached code once and I get a reading that is slightly of but reacts to objects coming in range. Slightly of means the distance is a bit lower as the proximity module logs but it is consistent in its values. When stopping the program (by hitting CTRL+C twice) and rerunning it again. I get way to high values for the first seconds and then the value comes down and stays in a certain range without reacting to any thing coming in its range.

When I restart the Photon board by pulling he RST pin low or unplugging the external power supply the reading is again as expected.
### I already tried:
1. Adding the capacitor for smoothing the result. Works with and without.
2. Running the sensor from the boards 3.3V. Does not work.
3. Exchange the board. Gives the same results.
4. Adding a diode on the analog input of the board. Works with and without.
5. Adding a voltage divider for lowering the voltage reaching the board. Works with and without.
6. Running the sensor from a different power source then the board. Does not work.
7. Setting the debug mode of the voodoo spark firmware to true. VS reports the analog values and they behave the same as the values logged by the node program.
8. Running it without the Proximity module Just as analog pin. Same result.
9. particle-io directly not as a johnny-five plugin. same result.
### ToDos:
1. Writing Arduino firmware and analyzing the result.
### Workaround:

My current workaround is to add the pushbutton connected to the ground and just restart the board after killing the node program by pushing it once.
### Links:
- [Mastering Sharp Distance Sensors](https://github.com/FH-Potsdam/Knowledge-Exchange/blob/master/Sharp-Infrared-Sensor/2015-01-29_Sharp_Distance_Exchange_Final.pdf)
- [GP2Y0A41SK0F Sharp Distance Measuring Sensor | Particle community](https://community.particle.io/t/gp2y0a41sk0f-sharp-distance-measuring-sensor/5303)
### Code:

**index.js**

``` js
var config = require('config');
var five = require("johnny-five");
var Particle = require("particle-io");
var keypress = require('keypress');

keypress(process.stdin);
// listen for the "keypress" event

var board = new five.Board({
  debug: true,
  io: new Particle({
    token: config.get('token'),
    deviceId: config.get('id')
  })
});
board.on("ready", function() {

  var proximity = new five.Proximity({
    controller: "GP2Y0A02YK0F",
    pin: "A1"
  });
  proximity.on("data", function() {
    console.log("Proximity: ");
    console.log("  cm  : ", this.cm);
    console.log("  in  : ", this.in);
    console.log("-----------------");
  });
  process.stdin.on('keypress', function(ch, key) {
    console.log('got "keypress"', key);
    if (key && key.ctrl && key.name == 'c') {
      proximity = null;
      process.exit();
    }
  });
});
```

**package.json**

``` json
{
  "name": "ir-sensor",
  "version": "1.0.0",
  "description": "",
  "engines": {
    "node": "<=v0.12.9"
  },
  "main": "index.js",
  "scripts": {
    "start": "node index.js",
    "test": "echo \"Error: no test specified\" && exit 1"
  },
  "keywords": [],
  "author": "Fabian 'fabiantheblind' Morón Zirfas <fabian.moron.zirfas@gmail.com> (http://fabianmoronzirfas.me)",
  "license": "ISC",
  "dependencies": {
    "config": "^1.17.1",
    "johnny-five": "^0.9.17",
    "keypress": "^0.2.1",
    "particle-io": "^0.12.0"
  }
}
```

**particle-io-bare-minimum.js**

``` js
var config   = require('config');
var Particle = require("particle-io");
var board = new Particle({
  token    : config.get('token'),
  deviceId : config.get('id')
});
board.on("ready", function() {
  console.log("CONNECTED");
  // Log all the readings for A1
  this.analogRead("A1", function(data) {
    console.log(data);
  });
});
```

**config/default.json**

A file for storing the config data. Create it as config/defaul.json

``` json
{
  "id": "12345678900987654321",
  "token": "1234567899876543211234567iuztrewqertz",
}
```
### circuit:

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

rwaldron, 2016-01-26:
Thanks for providing such a thorough bug report <3

> Writing Arduino firmware and analyzing the result.

I went ahead and did this, but not for an Arduino because there is no issue there. I wrote this:

```cpp
#include "application.h"

SYSTEM_MODE(AUTOMATIC);

unsigned long lastms;
unsigned long nowms;
unsigned long sampleInterval = 100;

void setup() {
  pinMode(A0, INPUT);
}

void loop() {
  nowms = millis();
  if (nowms - lastms > sampleInterval) {
    lastms += sampleInterval;

    Serial.println(analogRead(A0));
  }
}
```

Note: particle photon firmware is at 0.4.9, which I had to download manually to the `particle-cli/updates` dir.

- Using USB power (https://www.sparkfun.com/products/12016 so same for both boards)...
- First I connected the sensor to an Arduino, with a multimeter connected to ground and the sensor's signal line. I placed a solid matte-white obstruction at 15cm, which produced a reading of 2.68V. I removed the obstruction and then returned it to 15cm, the reading changed but settled back to 2.66V
  - Connected the multimeter to the same ground and 5V that was previously used for the sensor, which produced a reading of 4.95V
- Next, I disconnected the usb from the Arduino and connected the Photon.
  - Connected the multimeter to the photon's GND and VIN, which produced a reading of 4.68V
  - Connected the multimeter to GND and VIN, _after_ the 10µF cap, which produced a reading of 4.68V
  - Connected the sensor GND and VCC to the 10µF node
  - Ensure the obstruction is set at 15cm
  - Connected the multimeter to the photon's GND and VIN (again), which produced a reading of 4.63V (note the 0.05V loss, this is consistent)
  - Connected the sensor Signal to the multimeter, which produced a reading of 2.68V
  - Connected the sensor Signal to appropriate node (sensor Vout signal source) 1K resistor
  - Ensure the obstruction is set at 15cm (again)
  - Connected the multimeter to the voltage divided Vout, which produced a reading of 1.33\*

\* I'm not sure how to resolve this discrepancy, there may be an obvious solution, eg adjusting the math used to determine a distance... but I don't want to rush into that.

---------
w/r to this:

> I can run the attached code once and I get a reading that is slightly of but reacts to objects coming in range. Slightly of means the distance is a bit lower as the proximity module logs but it is consistent in its values. When stopping the program (by hitting CTRL+C twice) and rerunning it again. I get way to high values for the first seconds and then the value comes down and stays in a certain range without reacting to any thing coming in its range.

I could not reproduce the spike in readings (using the matte-white obstruction at 15cm—unmoved.)

> Adding the capacitor for smoothing the result. Works with and without.

Confirmed.

> Running the sensor from the boards 3.3V. Does not work.

Confirmed.

> Exchange the board. Gives the same results.

Confirmed (with an alternate Photon)

> Adding a diode on the analog input of the board. Works with and without.

Did not attempt

> Adding a voltage divider for lowering the voltage reaching the board. Works with and without.

Confirmed.

> Running the sensor from a different power source then the board. Does not work.

Did not attempt

> Setting the debug mode of the voodoo spark firmware to true. VS reports the analog values and they behave the same as the values logged by the node program.
> Running it without the Proximity module Just as analog pin. Same result.
> particle-io directly not as a johnny-five plugin. same result.

Confirmed all.

-------------

I will continue working on this a bit later, I have to change gears for the rest of the day.

fabiantheblind, 2016-01-27:
Another workaround. When we register another Sharp sensor on another pin without adding anything to it, the readings are working after a restart of the program. We don't use it we just have it in our code. 🤔

    var proximity2 = new five.Proximity({
        controller: "GP2Y0A02YK0F",
        pin: "A2"
    });

rwaldron, 2016-01-27:
I'm not able to reproduce the issue where no readings are delivered, but the voltage divider changes the math and invalidates the formula being used. I'm still trying to figure out how to make so that's not an impediment, whether it's customizable or not, I'm not sure yet...

fabiantheblind, 2016-01-28:
> I'm not able to reproduce the issue where no readings are delivered
What do you mean by that?
About the voltage divider. Yes I know it renders the calculated output useless. Maybe the Proximity module can have a option to provide a own formula.

Did you try to just add another proximity object? It is pretty wired that just adding another object in the code makes the sensor reading work again.

rwaldron, 2016-01-28:
> Did you try to just add another proximity object?

I will try this.

> It is pretty weird that just adding another object in the code makes the sensor reading work again.

I've seen before in the Intel Galileo and Galileo 2 :\

fitzgr, 2017-03-29:
Can you supply the voltage of the 10uf capacitor and the specs on the diode please.

Kindest regards,
Grant Fitz

fabianmoronzirfas, 2017-03-29:
hi @fitzgr the project was finished a year ago and is already dismantled. Sorry

fitzgr, 2017-03-29:
Can you supply the voltage of the 10uf capacitor and the specs on the diode please.

Kindest regards,
Grant Fitz

fitzgr, 2017-03-29:
Woops sorry for the repost.

dtex, 2018-01-05:
It sounds like we should close the issue since @fabianmoronzirfas has dismantled the project. Anyone feel free to re-open if there is a way we can make progress.

Closed 2018-01-05.

Thread 1026 (2016-01-30):

Add isAnode to Led Docs

reconbot, 2016-01-30:
It's missing as a possible property to the options.

scottgonzalez, 2016-01-31:
`isAnode` doesn't apply to `Led`. This is used to denote whether the common pin on a multi-LED component (e.g., RGB LEDs, seven segment displays, etc.) is anode or cathode. On a single LED, there is no common pin because it's just one diode.

reconbot, 2016-01-31:
It does work for leds that are wired in reverse however.

On Sat, Jan 30, 2016, 7:48 PM Scott González <notifications@github.com>
wrote:

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

frxnz, 2016-01-31:
This topic comes up about every 6 months. We should definitely do _something_. I'd opt for removing it from `Led` altogether.

* `isAnode` is in `Led` because originally `Led.RGB` was just 3 instances of `Led`
* `Led.RGB` no longer extends from `Led`, so it really doesn't need to exist in `Led` anymore

I suppose it's true that you could use `isAnode` for an LED wired in reverse, but is there any practical reason to do that?

soundanalogous, 2016-01-31:
There are 2 different ways to wire an LED to a microcontroller. The more common way is to wire the LED annode to the microcontroller pin and the cathode to ground (with a resistor between the mcu pin and the annode or the cathode and gnd). This is known as a "source drive" circuit since the mcu pin is sourcing the current to power the LED. The other way is "sync drive" in which the cathode is wired to the mcu pin and the anode is wired to power and current flows into the mcu (which can be more power efficient in some designs but likely makes little difference for prototypes and hobby applications). When using sync drive, you set the pin value to 0 rather than 1 to turn the LED on. Therefore it's necessary to provide a means to differentiate between the two configurations in order to determine if `led.on` should set the pin value to 0 or to 1.

soundanalogous, 2016-01-31:
Here's a slightly more detailed explanation on source vs sync: https://startingelectronics.org/articles/current-sourcing-sinking/

frxnz, 2016-02-01:
That's really interesting, thanks for detailed explanation @soundanalogous. If Johnny-Five wants to support that configuration, `isAnode` still probably isn't the best name for that property.

dtex, 2016-02-01:
button, joystick, motor and servo all have an ```invert``` property that does a similar (conceptually) thing. Not saying it's the right property name (no hablo LED), just one to consider.

reconbot, 2016-02-01:
I actually thought invert existed and had to look at the source to figure
out isAnode.

Both kinda make sense here, for both led and rgbled. I'm happy as long as
there are docs. And happier if the APIs are consistent.

On Mon, Feb 1, 2016, 9:36 AM Derek Wheelden <notifications@github.com>
wrote:

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

Resseguie, 2016-02-02:
`isAnode` makes sense for `Led.RGB` because that's what it's actually called ("common anode"). I've always thought it was confusing in the vanilla `Led` class. But I had never thought about the case @soundanalogous described. I'd tend to agree with @dtex on `inverted` in that case.

Could you also have a common anode RGB LED that is similarly wired? That doesn't make sense to me, but I acknowledge that I hadn't heard of the "sync drive" case before, so maybe I'm missing it.

reconbot, 2016-02-02:
Isn't it "sink drive"?

I like `inverted` but I worry about the undocumented `isAnode` as people might have been using it. Both?

frxnz, 2016-02-02:
I like `invert` as well. I'd say alias `isAnode` to `invert`, add a deprecation warning, and remove it in the next major.

frxnz, 2016-02-02:
@Resseguie If that's the case for `Led.RGB` it would make sense to have `isAnode` _and_ `invert` in that class.

soundanalogous, 2016-02-02:
`inverted` is kinda weird unless you understand the reference to what is inverted. I would think explicit `Led.SOURCE_DRIVE` and `Led.SINK_DRIVE` modes would be best if well documented. Default to `Led.SOURCE_DRIVE` since that is the most common configuration in hobby applications since it's easier for the user to understand that 1 = ON. In the likely rare case someone wires an LED in the sink drive configuration, they set the mode on the Led config param object.

Resseguie, 2016-02-02:
@frxnz I thought the same thing about having both, but I don't know if that's an actual case that exists. For a standard LED, you're just either applying power or not. For an "inverted"/sink drive RGB, what would be controlling the values to R-G-B respectively? That's why I didn't know if such a use case exists.

If we go with `inverted` (since we've used it elsewhere) I think aliasing it with `isAnode` is probably fine (and deprecating it). But I like the thinking of @soundanalogous on explicit modes as an alternative. I could go either way.

rwaldron, 2016-02-02:
https://github.com/rwaldron/johnny-five/issues/258

reconbot, 2016-02-02:
So it's a docs issue now?

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

Resseguie, 2016-02-02:
#258 is where it first got added, but RGB was still based off three LED instances then. Once Led.RGB became its own thing, `isAnode` got left as an artifact in `Led`

rudacs, 2017-10-10:
Any consensus on this item? Will the inverted be created?

dtex, 2017-10-10:
I propose that we deprecate isAnode on LED (warning message) and add a syncDrive device type. It'll be the first device type in LED, but that's NBD.

dtex, 2018-10-06:
I'm going to keep this issue open. There is a consensus that we need to fix it, and the fix will be easy to implement.

We do not need a device type. I was wrong, that is overkill.

Functionally the ```isAnode``` property does exactly what we need so I propose that we rename it ```sinkDrive```, update the docs and make ```isAnode``` an alias to ```sinkDrive```.

Easy-peasy. Sound good?

dtex, 2019-10-01:
No Stalebot!

I've learned a lot about this in the past year, and a sinkDrive property is still the right way to go.

Closed 2020-10-04.

Thread 1036 (2016-02-13):

HC-05 Bluetooth Port Number Issue

b00682613, 2016-02-13:
```javascript
var five = require("johnny-five");
var board = new five.Board();

board.on("ready", function() {
  var led = new five.Led(13);

  this.repl.inject({
    led: led
  });
});
```
I have paired the HC-05 module with my PC on Windows. Under Bluetooth settings the COM Ports are:

Port | Direction | Name
------------ | ------------- | -------------
COM4 | Incoming | HC-05
COM5 | Outgoing      | HC-05 'Dev B'

The error message is below, it happens regardless of whether I specify the port as COM4 or COM5
```javascript
1455386996814 Device(s) COM4,COM5
1455386996829 Connected COM4
1455387006840 Device or Firmware Error A timeout occurred while connecting to the Board.

Please check that you ve properly flashed the board with the correct firmware.
See: https://github.com/rwaldron/johnny-five/wiki/Getting-Started#trouble-shooting

If connecting to a Leonardo or Leonardo clone, press the 'Reset' button on the board, wait approximately 11 seco
nds for complete reset, then run your program again.
events.js:159
      throw err;
      ^

Error: Uncaught, unspecified "error" event. ([object Object])
```

rwaldron, 2016-02-15:
Have you read through the HC-05 guide? https://github.com/rwaldron/johnny-five/wiki/Getting-Started-with-Johnny-Five-and-HC-05-Bluetooth-Serial-Port-Module

b00682613, 2016-02-15:
Yeah I followed the guide except I couldn't complete step 2, I kept getting this message:
```
Starting config

Done!
```

Using the tutorial in the link I was able to set the : AT+UART=57600,0,0 and AT+PSWD=0000
After that I uploaded StandardFirmata onto the board.

arduinofy.blogspot.com.au/2013/10/tutorial-programming-hc-05-at-mode-with.html?_sm_au_=i3VLJKMHr4QFB5WP

rwaldron, 2016-02-15:
Let's ping a few others that have more experience with bluetooth than I do cc @ajfisher @BrianGenisio @darioodiaz

ajfisher, 2016-02-15:
I don't think you should have 2 COM ports registered for one BT module - I'm not sure why you'd have outgoing and incoming but that seems strange to me as COM ports (even under windows) can be bidirectional. I'd remove both and try and pair again just once.

Okay good way to test this is to do this:

Prerequisites:

* Install StandardFirmata on the arduino.
* Ensure your HC-05 is configured to 57600 baud
* Ensure your HC-05 and computer are paired and you are definitely connected (flashing waiting light goes solid)
* Make sure you have a terminal software (on windows I think it's hyperterminal or putty or something - basically something you can connect over serial with).

Then do this:

Wire up your HC-05 to your arduino now, make sure power is externally provided not via USB from your computer.

Open your terminal and connect to the BT Serial COM port at 57600 baud. At this point you'll get a blank screen. Assuming that screen stays on (and doesn't drop you out again) and the connection light is solid then you should be connected.

At this point hit RESET on the arduino and you should see the arduino do it's little Pin 13 LED dance. Once that's done, on your serial terminal you should see something like this:

```
����y��SimpleBotFirmata.ino
```

If that's working then you *should* be able to connect to it from your johnny five script now. If it's NOT doing that then one of your pre-requisites is not complete.

b00682613, 2016-02-16:
@waldron @ajfisher I got it working now.

Under bluetooth settings I found which port number to use:
Incoming (device initiates the connection)
Outgoing (your PC initiates the connection)

In my case the outgoing port is COM5.

```javascript
var five = require('johnny-five')
var board = new five.Board({
  port: 'COM5'
});

board.on("ready", function() {
  var led = new five.Led(13);

   this.repl.inject({
     led: led
   });
});
```

ajfisher, 2016-02-16:
Brilliant news!

Closed 2016-02-16.

Thread 1039 (2016-02-20):

Support for Grove Temp & Humidity I2C sensor

dougseven, 2016-02-20:
I would like to add support for the [Grove - Temperature & Humidity Sensor](http://www.seeedstudio.com/wiki/Grove_-_Tempture%26Humidity_Sensor_(High-Accuracy_%26Mini)_v1.0) that is included in the [Grove Indoor Environment Kit for Intel® Edison](http://www.seeedstudio.com/depot/Grove-Indoor-Environment-Kit-for-Intel-Edison-p-2427.html). It utilizes a TH02 sensor that can meet measurement needs of general purposes. The C driver for the TH02 is [here](https://github.com/Seeed-Studio/Grove_Temper_Humidity_TH02)

rwaldron, 2016-02-21:
Looks pretty straight forward!

- Start by reviewing the HTU21D (which is a similar component):
  - https://github.com/rwaldron/johnny-five/blob/master/lib/imu.js#L24-L75
  - you'll define a similar driver entry in that same location
- Next, declare the base controller, again here's the HTU21D:
  - https://github.com/rwaldron/johnny-five/blob/master/lib/imu.js#L1174-L1215
- Hygrometer controller:
  - https://github.com/rwaldron/johnny-five/blob/master/lib/hygrometer.js#L8-L26
- Thermometer controller:
  - https://github.com/rwaldron/johnny-five/blob/master/lib/thermometer.js#L297-L314
- Diagram
  - fzz and png
- examples in eg/
  - we'll add the examples to tpl/programs.json and generate the markdown

rwaldron, 2016-03-18:
@dougseven I have another user that's reporting issues with the Grove Temp & Humidity sensor; they reported it was a BMP180, but a photograph of their hardware reveals that it's actually this component. I'd like to implement the controller driver for this today.

dougseven, 2016-03-18:
I had started looking into it, but haven't had time to work on it. I can look at it more today.

rwaldron, 2016-03-18:
Do you mind if I just take over?

dougseven, 2016-03-18:
Go for it - happy to help (test, etc.)

rwaldron, 2016-03-18:
Excellent—I will call on you to do so :)

rwaldron, 2016-03-18:
@dougseven ready for testing—update to latest version

dougseven, 2016-03-18:
I'm going to try a different board with the official Yocto image, but using "latest" for johnny-five and edison-io with **ubiLinux** and Node v4.3.1 gets this:

NOTE: I have previously run a johnny-five app on this board in this configuration.

root@ubilinux:~/iot-labs/azure-iot# node iot-starter-kit.js
  NOTICE
  --------------------------------
  This OS image is no longer supported.
  Please upgrade to IoTKit Image with libmraa0 support.
  https://github.com/intel-iot-devkit/mraa/#installing-on-your-board
  --------------------------------
/root/iot-labs/azure-iot/node_modules/edison-io/node_modules/galileo-io/lib/galileo.js:48
if (Pin.IO.getPlatformType() === 2) {
          ^

TypeError: Cannot read property 'getPlatformType' of undefined
    at Object.<anonymous> (/root/iot-labs/azure-iot/node_modules/edison-io/node_modules/galileo-io/lib/galileo.js:48:11)
    at Module._compile (module.js:409:26)
    at Object.Module._extensions..js (module.js:416:10)
    at Module.load (module.js:343:32)
    at Function.Module._load (module.js:300:12)
    at Module.require (module.js:353:17)
    at require (internal/module.js:12:17)
    at Object.<anonymous> (/root/iot-labs/azure-iot/node_modules/edison-io/lib/edison.js:1:80)
    at Module._compile (module.js:409:26)
    at Object.Module._extensions..js (module.js:416:10)
root@ubilinux:~/iot-labs/azure-iot# uname -a
Linux ubilinux 3.10.17-yocto-standard-r2 #7 SMP PREEMPT Thu Feb 26 09:57:06 UTC 2015 i686 GNU/Linux
root@ubilinux:~/iot-labs/azure-iot#

rwaldron, 2016-03-19:
Weird, that should only happen if the native bindings are missing 0_o

dougseven, 2016-03-23:
I set up a new Edison with the official Yocto image. I get some very radical readings using the sample for the TH02 - 80-degree swings (in Celsius).

```temperature
  celsius           :  102
  fahrenheit        :  215.6
  kelvin            :  375.15
--------------------------------------
Hygrometer
  relative humidity :  52
--------------------------------------
temperature
  celsius           :  102.375
  fahrenheit        :  216.275
  kelvin            :  375.525
--------------------------------------
Hygrometer
  relative humidity :  52.1875
--------------------------------------
temperature
  celsius           :  102.375
  fahrenheit        :  216.275
  kelvin            :  375.525
--------------------------------------
Hygrometer
  relative humidity :  52.1875
--------------------------------------
temperature
  celsius           :  22
  fahrenheit        :  71.6
  kelvin            :  295.15
--------------------------------------
Hygrometer
  relative humidity :  12.375
--------------------------------------
temperature
  celsius           :  22
  fahrenheit        :  71.6
  kelvin            :  295.15
--------------------------------------
Hygrometer
  relative humidity :  12.375
--------------------------------------
```

Other times it would start, read a couple times and then stop reading/outputing to the console:

```
root@edison:~/iot-labs/basic# node th02.js
1458718176636 Device(s) Intel Edison
1458718176653 Connected Intel Edison
1458718176676 Repl Initialized
>> temperature
  celsius           :  NaN
  fahrenheit        :  NaN
  kelvin            :  NaN
--------------------------------------
Hygrometer
  relative humidity :  -24
--------------------------------------
temperature
  celsius           :  -50
  fahrenheit        :  -58
  kelvin            :  223.14999999999998
--------------------------------------
Hygrometer
  relative humidity :  -24
--------------------------------------
```

That is where it would stop and nothing more would happen. I can stop it (Ctrl+C twice) and run it again, or another simple sample. Not sure what is happening or how to debug it. I tried it with multiple Grove - Temperature&Humidity Sensor (High-Accuracy &Mini).

rwaldron, 2016-03-23:
Interesting, I will have a closer look and double check that the initialization operations are correct.

rwaldron, 2016-03-24:
Well, I missed the status check :\

rwaldron, 2016-03-24:
And of course, I don't have my TH02 with me (I'm in Boston until tomorrow). I have a fix for this, but I just need to double check it against actual hardware, so I should have something by Saturday

dougseven, 2016-03-24:
If it's in a branch I can pull then I can test it tonight. No rush though.

Sent from Outlook on iOS

On Thu, Mar 24, 2016 at 12:49 PM -0700, "Rick Waldron" <notifications@github.com> wrote:

And of course, I don't have my TH02 with me (I'm in Boston until tomorrow). I have a fix for this, but I just need to double check it against actual hardware, so I should have something by Saturday

---
You are receiving this because you were mentioned.
Reply to this email directly or view it on GitHub:
https://github.com/rwaldron/johnny-five/issues/1039#issuecomment-200989985

rwaldron, 2016-03-31:
@dougseven I completely forgot to ping you on this; you can pull and run the last round of work from master

Closed 2016-03-18.

Thread 1056 (2016-03-08):

Software Controlling MUX Shield 2 (Analogue) expander rows

alexcroox, 2016-03-08:
I have the MUX Shield 2 (I believe the analogue version as it has 3 rows instead of 2).

I would like to set the first row (I/O 1) to be digital inputs (to read a digital vibration sensor).

According to the [documentation](http://mayhewlabs.com/media/Mux_Shield_II_User_Guide.pdf) I need to set the mode through a couple of pins.

```
board.on("ready", function() {

        var virtual = new five.Board.Virtual(
            new five.Expander("MUXSHIELD2")
        );

        // Set mode to communicate with MUX by pulling pin 8 to low
        var modePin = new five.Pin(8);
        five.Pin.write(modePin, 0);

        // Set I/O 1 row to digital in by pulling pin 10 to low
        var firstRowInPin = new five.Pin(10);
        five.Pin.write(firstRowInPin, 0);
});
```

I'm having no luck though, am I missing something? I have the option of cutting the connections on the back of the board to permanently set the mode but I'd rather do it through software if possible.

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

rwaldron, 2016-03-09:
The Expander instance takes care of all the pin mode management for you—interfering with its operations will put the expander and shield into an unknowable state. Just pass the `virtual` board to the constructor like:

```js
var vibration = new five.Sensor.Digital({
  board: virtual,
  pin: (whatever pin the sensor is connected to on the shield)
});

```

alexcroox, 2016-03-10:
Ah very interesting! I'm getting a constant 5V signal to my sensor digital pin so I presumed the shield I/O row must be set to digital out instead of digital in. I must have wired something wrong :P

One advantage of cutting the hard wire on the back to force the mode is it frees up some of the PWM pins that I need for controlling some motors, which I don't think I can do with the expander pins. Is this a non option then as the Expander Instance has to auto control the mode (and therefore needs it to be a "factory state" at all time)?

rwaldron, 2016-03-10:
Yes, I think that correctly describes what I meant.

alexcroox, 2016-03-11:
Excuse my ignorance, but I could use the MUX shield 2 to turn one of the virtual IO rows to be analogue output and therefore send a PWM signal to control a motor right? I noticed the PIN wiki document shows how I can set a PIN's mode to be PWM (mode 3) so I can send a signal to a L298N Dual Motor Controller using the MUX Shield 2.

rwaldron, 2016-03-11:
No, the muxshield doesn't have PWM output (which is necessary for "analog" output) capability. The muxshield can be used for analog input, digital input or digital output, one mode at a time, per row.

rwaldron, 2016-03-28:
I'm going to close this now—reopen if necessary :)

Closed 2016-03-28.

Thread 1090 (2016-04-09):

Add support for winch/multi-turn servo

beriberikix, 2016-04-09:
[Winch servos](http://hitecrcd.com/products/servos/boat-servos/hs-785hb-3.5-turn-winch-servo/product) are basically normal servos with a multi-turn pot. Surprisingly, not many people know about them but they can be super handy for pan-tilt things.

To control them using the standard Servo arduino library, one needs to scale the values passws to the [`write()` call](http://forum.arduino.cc/index.php?topic=120884.msg910323#msg910323).

I could see it added as a new `type` in the `Servo` component class.

dtex, 2016-04-09:
I think this is a good addition, but I don't think we need a new type. Maybe just a ```servoRange``` parameter... i.e.

````
new Five.Servo({
  pin: 11,
  servoRange: [0, 1260] // 3.5 * 360
});
````

Then just map the servoRange down to [0,180] before calling servoWrite. The size of each step will be pretty big (~5°) on a microcontroller with 8-bit PWM but it is what it is.

beriberikix, 2016-04-09:
Ah, that sounds like a scalable solution!

rwaldron, 2016-04-09:
That model is $117 :(

http://www.amazon.com/Hitec-RCD-33785S-HS-785HB-Winch/dp/B000BOGI7E

Something about "servoRange" rubs me the wrong way, can we think about this a bit more?

dtex, 2016-04-09:
I love thinking about API's! I wish it were my full time job (seriously)

dtex, 2016-04-10:
Talking out loud...

We already have ```range``` which sets software limits on what we can ask of a 180° servo, but now we are talking about the physical abilities of the servo varying. Having ```range``` and ```servoRange``` could be confusing if a user is only aware of one of the two. Now I kinda' wish ```range``` had been ```limits``` but that horse left the barn long ago.

The primary difference between this and a standard servo is an encoder that is configured to work with multiple rotations and it do not have the physical tabs that limit their range.

This property would also be useful for 90° and 360° servos.

This feature could also be used to compensate for servos that don't map perfectly to our pre-defined PWM range as long as those required PWM values are both within our default pwmRange... but that's confusing and I should probably never mention it again.

beriberikix, 2016-04-10:
@rwaldron ya, that's 'spensive - when they're in stock they're [half that](https://www.servocity.com/html/hs-785hb_3_5_rotations.html#.Vwmm-xMrKRs) at Servo City. But the real deal is [HobbyKing](http://www.hobbyking.com/hobbyking/store/uh_listCategoriesAndProducts.asp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) @ $9.

dtex, 2017-08-17:
Managed to score one for $14. It has to drop ship from china so I won't have it for a month and a half, but hey we're already 15 months in on this issue so what's a couple more right?

dtex, 2017-09-06:
@rwaldron wrote:
> Something about "servoRange" rubs me the wrong way, can we think about this a bit more?

So the distinction we need to make is between our desired limits (i.e. to keep a robot from literally tripping over its own feet) vs. the capabilities of the servo. I wish ```range``` had been ```limits``` instead but it's too late for that. The options I see are:

* ```endpoints```
* ```throw```
* ```deviceRange```
* ```servoRange```
* ```physicalRange```

BTW, my servo from Hobby King arrived last night.

dtex, 2017-09-10:
I'm going with deviceRange for now since "device" represents the physical component in our device/controller world.

rwaldron, 2017-09-11:
> I wish range had been limits instead but it's too late for that.
...
> I'm going with deviceRange for now since "device" represents the physical component in our device/controller world.

Sounds good. In the meantime, you might be able to ease into `limits` by making it an alias first and then just update all the docs that use `range` to `limits` and then we can reclaim `range` in some future release?

dtex, 2018-01-11:
Hi @beriberikix ,

I've made pretty good headway on this (I have it working great with Firmata), but there are changes that need to land in the other IO plus-ins so we don't break servo for non-firmata boards like the Tessel, Beaglebone and so on.

Rather than leave it languishing as an open issue we have created a [Requested Features](../wiki/Requested-Features) page and added your request for "non-180°" servos there.

dtex, 2018-05-10:
@beriberikix,

It only took changes to 9 repos owned by 6 different maintainers and new code in 4 different programming languages, but this is done.

Go build something really cool!

BTW, I'm really looking forward to Mesh. I've got an Argon and six Xenon's on the way. My plan is to use an Argon for high level instructions and a Xenon in each limb of a walking robot. That way the grunt work like Inverse Kinematics can be offloaded to the Xenons. Should be fun.

beriberikix, 2018-05-12:
Wow, heroic effort! 💪

Glad you're excited about Particle Mesh! Sounds fun :)

Closed 2018-01-11.

Thread 1102 (2016-04-13):

IMU class with MPU6050 is not working

pacozaa, 2016-04-13:
- I have a problem using MPU6050 with johnny-five current version. I tested MPU6050 with johnny-five older version and it worked.
I tried this 3 examples [accelerometer-mpu6050](http://johnny-five.io/examples/accelerometer-mpu6050/),[gyro-mpu6050](http://johnny-five.io/examples/gyro-mpu6050/),[imu-mpu6050](http://johnny-five.io/examples/imu-mpu6050/) and they not fire any event out except accelerometer-mpu6050 but any value printed is 0 and it only fire once.

- I use this [Arduino I2CScanner](https://gist.githubusercontent.com/kinathru/e2609f70a430e52ec3de/raw/778c7bd0b4a7e94ef3a1d40a0929136dc30daeac/scanner.c) code which print 0x68 and this [Arduino MPU6050](https://github.com/jrowberg/i2cdevlib/blob/master/Arduino/MPU6050/examples/MPU6050_raw/MPU6050_raw.ino) code which print things out.
I pretty sure about my wiring because I use hmc5883l and bmp085 which they work well with johnny-five or Arduino code in the same bus and wiring.

rwaldron, 2016-04-15:
What are you running this code with, Arduino or something else?

pacozaa, 2016-04-15:
@rwaldron I run the code with johnny-five with nodejs on my laptop and it's not work then I test and recheck my wiring by using Arduino IDE and its code to confirm that the hardware still ok and identify the problem.

rwaldron, 2016-04-15:
Yeah, I'm using the same setup and it's working correctly. Can you post a picture of your hardware setup?

pacozaa, 2016-04-22:
1. This is my exact code I'm using

``` javascript
var five = require("johnny-five");
var board = new five.Board();

board.on("ready", function() {
  var imu = new five.IMU({
    controller: "MPU6050"
  });
  imu.on("change", function() {
      console.log("temperature");
      console.log("  celsius      : ", this.temperature.celsius);
      console.log("  fahrenheit   : ", this.temperature.fahrenheit);
      console.log("  kelvin       : ", this.temperature.kelvin);
      console.log("--------------------------------------");

      console.log("accelerometer");
      console.log("  x            : ", this.accelerometer.x);
      console.log("  y            : ", this.accelerometer.y);
      console.log("  z            : ", this.accelerometer.z);
      console.log("  pitch        : ", this.accelerometer.pitch);
      console.log("  roll         : ", this.accelerometer.roll);
      console.log("  acceleration : ", this.accelerometer.acceleration);
      console.log("  inclination  : ", this.accelerometer.inclination);
      console.log("  orientation  : ", this.accelerometer.orientation);
      console.log("--------------------------------------");

      console.log("gyro");
      console.log("  x            : ", this.gyro.x);
      console.log("  y            : ", this.gyro.y);
      console.log("  z            : ", this.gyro.z);
      console.log("  pitch        : ", this.gyro.pitch);
      console.log("  roll         : ", this.gyro.roll);
      console.log("  yaw          : ", this.gyro.yaw);
      console.log("  rate         : ", this.gyro.rate);
      console.log("  isCalibrated : ", this.gyro.isCalibrated);
      console.log("--------------------------------------");
  });

});

```

2. My node.js version is 4.4.2

3.johnny-five version is 0.9.43

4. My exact hardware is [GY88](http://www.hotmcu.com/imu-10dof-mpu6050hmc5883lbmp085-p-188.html) and this is [schematic](http://g04.s.alicdn.com/kf/HT1fdGMFPRcXXagOFbXr/202407509/HT1fdGMFPRcXXagOFbXr.jpg)

5. My setup picture here.
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

6. As No.5 my picture don't useful but I think my setup is ok because i can use compass and barometer which use the same bus according to schematic in No.4

rwaldron, 2016-05-04:
I'm still waiting on the GY-88

pacozaa, 2016-05-06:
Than you

rwaldron, 2016-05-06:
Still waiting :(

reconbot, 2016-08-26:
I'm going to close this due to age. If you're still having this issue or if you figured it out let us know and we'll reopen. Hopefully the test hardware ever showed up. Sorry someone couldn't get back to you sooner.

Closed 2016-08-26.

Thread 1115 (2016-04-30):

How To Stop HTU21D Read

reza70, 2016-04-30:
I have a problem using HTU21D .
I use Multi API for read HTU21D .
this is my code  :

``` js
var five = require("johnny-five");
var board = new five.Board();

board.on("ready", function() {

var multi = new five.Multi({
    controller: "HTU21D"
  });

if($incoming == 1)
{
  multi.on("change", function() {
    console.log("temperature");
    console.log("  celsius           : ", this.temperature.celsius);
    console.log("  fahrenheit        : ", this.temperature.fahrenheit);
    console.log("  kelvin            : ", this.temperature.kelvin);

    console.log("Hygrometer");
    console.log("  relative humidity : ", this.hygrometer.relativeHumidity);

  });
}
else
{
  multi.stop();
}

});
```

I want disconnect and stop HTU21D and destroy multi variable .
Can in do this ?
thank you

rwaldron, 2016-04-30:
I've been planning for and am currently working on the lower level pieces that are necessary for supporting this capability. I should have something concrete to try out by mid week.

In the meantime, it would be helpful to me to understand what exactly you're trying to accomplish? In the above program, it's unclear where the `$incoming` variable comes from, or why a non-truthy value would result in "stopping" the sensor. Once this code runs, nothing else will happen. The Board instance will keep its connection open until the program itself is closed.

reza70, 2016-04-30:
Thank you .
I want read data from HTU21D and then close traffic tx  and then run Multi again other time .
I want this run every 1 minute .
Can i disconnect board ?

reza70, 2016-04-30:
really i want use HTU21D and DS18B20 sensor together .
When use Multi and them use Thermometer in code i get error about 1-wire sensor .
so i want create Multi object and read temp and close that and then Create Thermometer object and read data and close that .
i want this process repeat every 1 minute .

rwaldron, 2016-04-30:
What is the error you getting?

reza70, 2016-04-30:
Error: 1-Wire device search timeout - are you running ConfigurableFirmata?
    at Timeout._onTimeout (/usr/lib/node_modules/johnny-five/node_modules/firmata/lib/firmata.js:1376:14)
    at tryOnTimeout (timers.js:224:11)
    at Timer.listOnTimeout (timers.js:198:5)

i use ConfigurableFirmata on arduino
i think conflict address or any things .....

if comment five.Multi , all thing is ok .

i need destroy object and stop communicate between arduino and sensor and call five.Multi or five.Thermometer again

rwaldron, 2016-04-30:
No, that's not the right way to fix this—there should be no conflict at all between the two components, as they're using entirely different protocols. If you see that error it's because the board doesn't have ConfigurableFirmata uploaded, or it does and the 1-wire feature is not enabled. Please make sure that 1-wire is enabled

rwaldron, 2016-04-30:
@briangenisio do you know why 1-Wire would timeout, if the board has ConfigurableFirmata running?

reza70, 2016-04-30:
i sure upload ConfigurableFirmata on arduono and enable 1 wire
because when use only DS18B20 all thing work and no problem but when use DS18B20 and HTU21D together stop script and show me error

rwaldron, 2016-04-30:
I'm going to try and reproduce, I just need to find my DS18B20 :\

reza70, 2016-05-01:
OK
I found my problem but why ..... ?
I use 2 DS18B20 and connect to same digital port and use address for read data .
if use Multi for HTU21D and Thermometer for DS18B20 on this mode i get error .
but if use only DS18B20 and HTU21D i don't have problem .

while 1-wire function call and Multi in running i get error .

BrianGenisio, 2016-05-01:
IIRC, we were getting that error when we had two MAX31850K units (very similar to the DS18B20) connected simultaneously.  The chip would error out, and the read command would time out, causing the error suggesting that OneWire wasn't installed.  But it was, and everything worked fine when there was one MAX31850K unit.

I was never able to reproduce the issue, because I only ever had one unit.  But it is what caused this exit condition on that device:
https://github.com/rwaldron/johnny-five/blob/9e06037c1004adaf8c5ec59f597cb709d47b9977/lib/thermometer.js#L102

Not sure if that will help, but perhaps it is something similar?

Just looked at the HTU21D (reminded muself).  That's I2C, not one-wire.  Is it possible that I2C is causing a timing issue with OneWire?  Isn't OneWire timing-based?  Does this error happen immediately?  Or does it happen after a while?  Are the read requests happening at the same time?  I wonder if you can read them in serial... toggle between reading the DS18B20 and HTU21D?  Just a thought.

Hmpfh.  :shrug:

I'll see if I can find my HTU21D but it might be a day or two.

rwaldron, 2016-05-05:
I can reproduce this issue as well.

While I think these _should_ be able to function at the same time, I suspect there is lower level issue that's unrelated to Johnny-Five specifically. I'm going to try to prove/disprove that later today. In the meantime, I've put together a solution that meets the request in your comment here:

> I want read data from HTU21D and then close traffic tx and then run Multi again other time .
> I want this run every 1 minute .

1. Set up a project directory:
  ```
  mkdir temperature-process && cd temperature-process;
  npm init -y && npm install johnny-five && touch index.js && touch child.js
  ```

2. Fill in the two files:
  - index.js
    ```js
    var cp = require("child_process");
    var avg = null;
    var mode = 0;
    var interval = 1000; // Change to 60000 for a minute

    function read() {
      cp.exec("node child " + mode, function(error, response) {
        response = +response;

        if (avg === null) {
          avg = response;
        }

        avg = (avg + response) / 2;

        console.log("%d: %d", mode, response);
        console.log("Avg. %d°C", avg.toFixed(2));

        if (++mode === 2) {
          mode = 0;
        }

        setTimeout(read, interval);
      });
    }

    read();
    ```

  - child.js
    ```js
    var five = require("johnny-five");
    var board = new five.Board({
      repl: false,
      debug: false,
    });
    var mode = process.argv[2];
    var configs = [
      { controller: "DS18B20", pin: 2 },
      { controller: "HTU21D" },
    ];

    if (mode === undefined) {
      mode = 0;
    }

    board.on("ready", function() {
      var temp = new five.Thermometer(configs[mode]);
      temp.on("data", function() {
        process.stdout.write(String(this.celsius));
        process.exit();
      });
    });
    ```

3. Run it!
  ```
  $ node index.js
  0: 22.1875
  Avg. 22.19°C
  1: 22.11
  Avg. 22.15°C
  0: 22.1875
  Avg. 22.17°C
  1: 22.35
  Avg. 22.26°C
  0: 22.25
  Avg. 22.25°C
  1: 22.38
  Avg. 22.32°C
  0: 22.1875
  Avg. 22.25°C
  1: 22.35
  Avg. 22.3°C
  ```

rwaldron, 2016-05-05:
I just tried reading both with just an Arduino sketch and it works fine. Maybe @soundanalogous can help us understand the timing constraints (if any exist)

jackrosenhauer, 2016-11-26:
Any progress on this? I just ran into this issue as well.

soundanalogous, 2016-11-26:
One possibility is, depending on which board you are using, there is not enough memory remaining for stable operation once you enable both OneWire and I2C in ConfigurableFirmata. What board are you using and how much flash memory and SRAM is remaining after compile the firmware (ConfigurableFirmata) for that board? This will be printed in the bottom of the Arduino IDE.

jackrosenhauer, 2016-11-26:
Sorry deleted my comment because I thought it was off topic but after a second look I'm using the same setup as @reza70. My board is a MEGA 2560 and I'm only using 1 DS18B20 and an HTU21D-F. The output after uploading:
Sketch uses 26,658 bytes (10%) of program storage space. Maximum is 253,952 bytes.
Global variables use 3,072 bytes (37%) of dynamic memory, leaving 5,120 bytes for local variables. Maximum is 8,192 bytes.

soundanalogous, 2016-11-26:
Ok memory is definitely not an issue then. Have you tried attaching the DS18B20 to different pins?

soundanalogous, 2016-11-26:
Also try changing the sampling interval. It's 19ms by default. Try setting it to 100 or even 1000ms:

```js
var board = new five.Board({
  samplingInterval: 100,
});
```

That will change the rate at which the I2C devices will report their values if continuous reporting is enabled. It could be that the default of 19ms is too frequent when attempting to read from multiple devices.

jackrosenhauer, 2016-11-26:
Mega uses pins 20 and 21 for i2c for the HTU21D and the DS18B20 is hooked up to pin 11. I tried pin 2-12 and did not seem to make a difference.

Here is my stack trace (pretty much the same as above):

events.js:160
      throw er; // Unhandled 'error' event
      ^

Error: 1-Wire device read timeout - are you running ConfigurableFirmata?
    at Timeout._onTimeout (C:\git\raspberrypi\node_modules\firmata\lib\firmata.js:1460:14)
    at ontimeout (timers.js:365:14)
    at tryOnTimeout (timers.js:237:5)
    at Timer.listOnTimeout (timers.js:207:5)

jackrosenhauer, 2016-11-26:
Setting the samplingInterval to 1s yields the same results.

soundanalogous, 2016-11-26:
And if you use only the HTU21D or only the DS18B20 everything works without issue, correct?

jackrosenhauer, 2016-11-26:
Yes, using only one of the sensors works without issue.

jackrosenhauer, 2016-11-26:
Also, setting samplingInterval to 1000ms does not seem to change the rate at which the values are being read.

soundanalogous, 2016-11-26:
That's pointing to an issue in the default polling rate set in johnny-five then.

soundanalogous, 2016-11-26:
I'd need to add logging in ConfigurableFirmata and report it back over Firmata sendString in order to gain an understanding of what is happening at the firmware level. I don't have these sensors so I'd have to walk you through the process of setting up debug messages.

jackrosenhauer, 2016-11-26:
Tell me what to do. I'm trying to look into the issue as much as I can. It seems that the samplingInterval value is being set in board.io.settings but is being ignored.

soundanalogous, 2016-11-26:
Are you using a version of ConfigurableFirmata built from firmatabuilder.com or just the default version you get from firmata/ConfigurableFirmata/examples/ConfigurableFirmata.ino?

jackrosenhauer, 2016-11-26:
I've tried both and get the same result. Currently using firmata/ConfigurableFirmata/examples/ConfigurableFirmata.ino.

soundanalogous, 2016-11-26:
Did you make any modifications?

jackrosenhauer, 2016-11-26:
Nope.

jackrosenhauer, 2016-11-26:
Just to be thorough I do get these 2 compile warnigns http://pastebin.com/NRQnCU9K

soundanalogous, 2016-11-26:
Copy this to a new file and compile and upload: https://gist.github.com/soundanalogous/7e7643cd8cf00a5f90de615f5d52b9ec

Also make sure you have ConfigurableFirmata v2.9.1 installed.

jackrosenhauer, 2016-11-26:
Seems to be outputting mostly gibberish besides the sketch name.

soundanalogous, 2016-11-26:
Probably seeing ascii text. If converted to raw bytes that may be helpful info.

soundanalogous, 2016-11-26:
Add this to the end of the setup function:

```c++
// set sampling interval to 1000ms
reporting.setSamplingInterval(1000);
```

jackrosenhauer, 2016-11-26:
How do I get the raw bytes being sent?

soundanalogous, 2016-11-26:
It depends on where the stream is coming from. Where is the gibberish data showing up? Is it part of the error stream or is it from console.log, etc?

soundanalogous, 2016-11-26:
Also please share you full javascript code.

jackrosenhauer, 2016-11-26:
I should just be able to open the serial monitor (COM) and see the output, right?

code: https://gist.github.com/jackrosenhauer/b4452d2ffbf09409fc4add1ebb4c34e1

soundanalogous, 2016-11-26:
You can try, but I don't think it will work because the serial monitor will own the connection and you won't be able to communicate with your J5 application.

soundanalogous, 2016-11-26:
So you get no output when running that script?

jackrosenhauer, 2016-11-26:
I don't get any additional output while running the J5 app

soundanalogous, 2016-11-26:
Strange. Can you copy and paste the gibberish data. I can probably decipher it if it's ascii.

jackrosenhauer, 2016-11-26:
The gibberish data is not in ascii and was from the serial monitor.

soundanalogous, 2016-11-27:
Add this to your script inside the "ready" function block:

```js
board.on("string", function (message) {
  console.log(message);
});
```

soundanalogous, 2016-11-27:
Then update ConfigurableFirmataDebug.ino with the following: https://gist.github.com/soundanalogous/7e7643cd8cf00a5f90de615f5d52b9ec.

Compile and upload then run your sensors.js. It should hopefully print "reporting..." once a second.

jackrosenhauer, 2016-11-27:
It does indeed print reporting... every second but nothing else.

soundanalogous, 2016-11-27:
That's good. It indicates the firmware isn't crashing. Getting more meaningful data will be difficult as it will require modification of the ConfigurableLibrary.

soundanalogous, 2016-11-27:
Also, just to make sure everything else is working as intended with this firmware, comment out the `thermometer` and let me know if that prints data, then uncomment `thermometer` and comment out `hygrometer` and let me know if that prints data.

jackrosenhauer, 2016-11-27:
Any variation prints "reporting..." but J5 exits on the 1-Wire device read timeout error.

soundanalogous, 2016-11-27:
Go to your Arduino/libraries/ directory and make a copy of ConfigurableFirmata (as a backup) and move that copy out of the libraries directory. Then in the ConfigurableFirmata that remains in Arduino/libraries/, replace the existing /ConfigurableFirmata/src/OneWireFirmata.cpp with this version: https://gist.github.com/soundanalogous/b46593e9fa90ae5846146cc7e6253e16.

If you have the Arduino IDE open, you'll need to close then reopen it after updating that file. The compile and upload ConfigurableFirmataDebug.ino again and let me know what your script prints. It should print a few numbers periodically.

jackrosenhauer, 2016-11-27:
output sample: https://gist.github.com/jackrosenhauer/ddbe376f2212751d86e05ca8e11abd3c

soundanalogous, 2016-11-27:
Now replace ConfigurableFirmata/src/I2CFirmata.h with this file: https://gist.github.com/soundanalogous/af3eba67c19f29dd9a0a1ef5f4d42a31

jackrosenhauer, 2016-11-27:
output#2 sample: https://gist.github.com/jackrosenhauer/1a7b96debcac9f69f7e542c7411b7708

soundanalogous, 2016-11-27:
strange... seeing no strings from I2C, is both thermomenter and hydrometer uncommented?

soundanalogous, 2016-11-27:
Also, here's another update to OneWireFirmata.cpp: https://gist.github.com/soundanalogous/b46593e9fa90ae5846146cc7e6253e16

jackrosenhauer, 2016-11-27:
I had thermometer enabled and hygrometer disabled. hygrometer is now enabled, I've also updated the OneWireFirmata.cpp.

Output:
I2C write
I2C read
I2C read
...

soundanalogous, 2016-11-27:
That's all you get is those 3 lines now?

jackrosenhauer, 2016-11-27:
No, it continues to output I2C read.

soundanalogous, 2016-11-27:
but no more subcmd values?

soundanalogous, 2016-11-27:
and are you seeing "I2C read" more frequently that you're seeing "reporting..."?

jackrosenhauer, 2016-11-27:
With both sensors enabled and running this is the output https://gist.github.com/jackrosenhauer/1fe822d6bec89120fb347e292dc3d4d0

soundanalogous, 2016-11-27:
When you shared output#2 sample, was the OneWire device reporting correct data as expected?

jackrosenhauer, 2016-11-27:
I was not outputting sensor data to reduce noise. I can redo if you need

soundanalogous, 2016-11-27:
yeah that would be helpful

jackrosenhauer, 2016-11-27:
yes, it was accurate
output2#2: https://gist.github.com/jackrosenhauer/1b2eba23e159bbf079afe8d239a2596b

soundanalogous, 2016-11-27:
Here's another update to OneWireFirmata.cpp: https://gist.github.com/soundanalogous/b46593e9fa90ae5846146cc7e6253e16. Please try that and enable both sensors. Also share an output stream with just the thermometer and just the hydrometer with that firmware.

jackrosenhauer, 2016-11-27:
output for both: https://gist.github.com/jackrosenhauer/0e7cf244f0dee039549d56a330b6182a
thermometer: https://gist.github.com/jackrosenhauer/06d6dc8181b61036e492c08efa21aacc
hygrometer:https://gist.github.com/jackrosenhauer/fbd7d0d098f499ed8d033648fd0bda50

soundanalogous, 2016-11-27:
So it looks like the thermometer is crashing even when the hygrometer is commented out.

soundanalogous, 2016-11-27:
Try changing the frequency of the thermometer and hygrometer readings to 1 second (default is 100ms for DS18B20 and 20ms for Multi):

```js
var thermometer = new five.Thermometer({
      controller: "DS18B20",
      pin: 4,
      freq: 1000
});
var hygrometer = new five.Multi({
    controller: "HTU21D",
    freq: 1000
});
```

jackrosenhauer, 2016-11-27:
The thermometer is no longer reporting sensor data...

soundanalogous, 2016-11-27:
It is probably affected by delays caused by all of those delay strings, but it's interesting in that causes a crash in the same way as when both devices are enabled simultaneously.

soundanalogous, 2016-11-27:
Swap the original version of ConfigurableFirmata back in and run with your script with the longer frequencies. I'm curious if the 20ms default freq of the five.Multi object is what is causing the crash. That's way too frequent to read an I2C device while simultaneously reading a OneWire device, especially since on each write call to OneWire global interrupts are disabled on the board, which is going to mess with I2C behavior.

soundanalogous, 2016-11-27:
by original version of ConfigurableFirmata, I mean the library in Arduino/libraries/ not the sketch.

soundanalogous, 2016-11-27:
I think in order to get multi-sensor that use a mix of interfaces (I2C and OneWire) in this case, Firmata is going to need a task manager.

soundanalogous, 2016-11-27:
or some sort of a queue

jackrosenhauer, 2016-11-27:
same results, any idea of a temp work around?...

soundanalogous, 2016-11-27:
so with original ConfigurableFirmata library and longer frequencies, you still get the crash?

jackrosenhauer, 2016-11-27:
That is correct.

soundanalogous, 2016-11-27:
Based on the data we've gathered I'm unfortunately still not sure if the error is on the firmware side, or if it's in firmata.js or in johnny-five. Based on the [samples#2 -- both](https://gist.github.com/jackrosenhauer/0e7cf244f0dee039549d56a330b6182a) data, here's what I know:

- a OneWire read request fails mid read (line 17). However "reporting..." is still printed every second so the firmware hasn't locked up.
- johnny-five is controlling the polling frequency so the Firmata `samplingInterval` is irrelevant in this case.
- even with a lower polling frequency (1000ms) there is still a conflict and no data is returned, indicating the issue isn't caused by flooding the stream.

What could be happening?

**Hypothesis A**: Somewhere shortly after "read request bit" is printed, data gets in a bad state in OneWireFirmata that somehow also puts I2C in a bad state (perhaps OneWire gets stuck with the global interrupt still in the disabled state), but the firmware application itself does not completely crash and firmata.js/johnny-five keeps processing input correctly (printing: "reporting...").

**Hypothesis B**: Expected data is not returned in firmata.js or johnny-five and one of those libraries stop requesting I2C and OneWire data.

In order to make further progress I'd need the actual hardware to repro this condition as it will require much more extensive logging both in the firmware and in firmata.js and johnny-five.js.

@rwaldron FYI. Can you look into Hypothesis B on the johnny-five side. Is there an unhandled case that would break the frequency interval in the Multi or Thermometer modules?

soundanalogous, 2016-11-27:
@jackrosenhauer one more thing to add to your script is blink the on-board LED once a second. That will indicate if the firmware is still responsive even if the client application appears to have crashed. Of course it will stop when the error is thrown by J5.

jackrosenhauer, 2016-11-27:
LED blinks until J5 crashes

soundanalogous, 2016-11-27:
One more update to OneWireFirmata.cpp that adds a couple more debug statements: https://gist.github.com/soundanalogous/b46593e9fa90ae5846146cc7e6253e16. @jackrosenhauer if you could please try this and output the log with both sensors enabled. Thanks!

jackrosenhauer, 2016-11-27:
output: https://gist.github.com/jackrosenhauer/f2b96adee530c9aea9d90c5a90b3cff0
code: https://gist.github.com/jackrosenhauer/c02cb82890ea66f595bfecfd8d0f7377
led continues to blink

jackrosenhauer, 2016-11-28:
No change.

soundanalogous, 2016-11-28:
Ok then I really think the issue must lie in the Multi object.

@rwaldron

soundanalogous, 2016-11-28:
@jackrosenhauer do you have a 4.7k resistor connected to the data line of the temp sensor?

jackrosenhauer, 2016-11-28:
Yes, there is a 4.7k resistor connected

soundanalogous, 2016-11-28:
And when you say "no change", are you using the original ConfigurableFirmata library or the modified version?

jackrosenhauer, 2016-11-28:
While using both versions, the 1-Wire timeout still happens.

soundanalogous, 2016-11-28:
In firmata.js try changing the timeout on lines 1382 and 1404 to 10000 or higher

rwaldron, 2016-11-28:
@soundanalogous I will read through this thread and follow up as soon as I can

jackrosenhauer, 2016-11-29:
Changed timeouts on lines 1382, 1404 and 1462. Same results.

ruswerner, 2017-07-24:
I'm also getting this same error `1-Wire device read timeout`. However I'm using 3 DS18B20's on 2 different pins (6 total sensors), with a 5 sec polling frequency. The J5 app will run happily for a random amount of time, but usually it doesn't go more than 24 hours before crashing with:

```events.js:141
      throw er; // Unhandled 'error' event
      ^

Error: 1-Wire device read timeout - are you running ConfigurableFirmata?
    at Error (native)
    at null._onTimeout (/tmp/remote-script/node_modules/firmata/lib/firmata.js:1:12227)
    at Timer.listOnTimeout (timers.js:92:15)
```

I'm about to give up and switch over to a Particle Photon to get this project finished, I just can't get J5+ConfigurableFirmata to be stable reading temps...

Hopefully my setup will shed some light on this problem. Let me know if you need something from me.

soundanalogous, 2017-07-24:
Sounds like a potential memory leak in ConfigurableFirmata when using multiple OneWire devices. Are you able to determine if the ConfigurableFirmata is locking up after 24 hours or so?

ruswerner, 2017-07-24:
@soundanalogous After this above read timeout error, if I re-run the J5 program, this is what happens:

```1500926295073 Connected /dev/ttyACM0
1500926355153 Device or Firmware Error A timeout occurred while connecting to the Board.

Please check that you've properly flashed the board with the correct firmware.
See: https://github.com/rwaldron/johnny-five/wiki/Getting-Started#trouble-shooting

If connecting to a Leonardo or Leonardo clone, press the 'Reset' button on the board, wait approximately 11 seconds for complete reset, then run your program again.
```

And it will keep doing this ^ until I **hard-power off** the Arduino and the host computer (a Tesssel 2 in this case). Just pressing reset on the Arduino doesn't work.

It seems to me, not having much knowledge of how firmata works, is that the delicate 1-wire protocol gets slightly behind/out-of-sync and then bails, leaving the arduino in an unrecoverable state. There's either a bug in how 1-wire is implemented or a better way to recover from errors like this.

I'm happy to help diagnose this further...

soundanalogous, 2017-07-25:
I can't look into this with real hardware until early August so anything you can try in the meantime will be helpful. I don't have a Tessel 2 so I can't help diagnose on that end.

Which Arduino board are you running Firmata on?

ruswerner, 2017-07-25:
No worries. I'm using an official Arduino UNO R3. I can do some more testing once I have it swapped out of active service heating my home (when it's not crashed) ;P

soundanalogous, 2017-07-25:
Please try the following:
1. Install the [ArduinoUnit library](https://github.com/mmurdoch/arduinounit) (you need this for a dependency it includes).
2. Include ArduinoUnit in your ConfigurableFirmata file:
```c++
#include <ArduinoUnit.h>
```
3. Add these 2 lines near near the top of your ConfigurableFirmata.ino file where other variables are declared:
```c++
long memCheckCounter = 0;
char buffer[20];
```
4. Add these lines at the end of the `loop()` function:
```c++
// send memory reading approximately ever 10 seconds
// 526 * 19 (default sampling interval) = 9994 ms
// increase 526 for long running processes
if (memCheckCounter++ == 526) {
   sprintf(buffer, "%u", freeMemory());
   Firmata.sendString(buffer);
   memCheckCounter = 0;
}
```
5. Add this line in your JavaScript file:
```js
board.on("string", function (message) {
  console.log("available memory: " + message);
});
```

That will log the amount of available memory on the Arduino every 10 seconds (see comments for how to extend the reporting period) . Let me know if you see the memory value increase over time.

ruswerner, 2017-07-30:
@soundanalogous Thanks. I'll get to this as soon as I can. I've had to decommission my hardware setup and switch to something more reliable, a Particle Photon,  for heating our home. Now that the tessel and arduino are back on the bench, I can setup a safe debug env for this.

lfnoleto, 2019-11-26:
what it would be like to get humidity and temperature every 20 minutes? @rwaldron

Closed 2018-08-28.

Thread 1128 (2016-05-10):

How to fix  EIO,i/o error

asit569, 2016-05-10:
Getting this error please resolve

pi@raspberrypi:~ $ cd waterpi-node
pi@raspberrypi:~/waterpi-node $ sudo node index.js
1462815306876 Device(s) RaspberryPi-IO
1462815307277 Connected /dev/ttyACM0
1462815307365 Connected RaspberryPi-IO
connect
1462815311112 Board ID:  pi
1462815311114 Board ID:  uno
1462815311129 Repl Initialized
>> ready
Temperature: 33.00C, humidity: 45.00%
fs.js:613
    return binding.writeBuffer(fd, buffer, offset, length, position);
                   ^
Error: EIO, i/o error
    at Error (native)
    at Object.fs.writeSync (fs.js:613:20)
    at Bus.i2cWriteSync (/home/pi/waterpi-node/node_modules/raspi-io/node_modules/raspi-i2c/node_modules/i2c-bus/i2c-bus.js:340:13)
    at I2C.writeSync (/home/pi/waterpi-node/node_modules/raspi-io/node_modules/raspi-i2c/lib/index.js:332:34)
    at Raspi.i2cWrite (/home/pi/waterpi-node/node_modules/raspi-io/lib/index.js:559:19)
    at Expander.write (/home/pi/waterpi-node/node_modules/johnny-five/lib/lcd.js:49:11)
    at LCD.Controllers.PCF8574.initialize.value (/home/pi/waterpi-node/node_modules/johnny-five/lib/lcd.js:341:23)
    at new LCD (/home/pi/waterpi-node/node_modules/johnny-five/lib/lcd.js:734:10)
    at Boards.<anonymous> (/home/pi/waterpi-node/index.js:60:9)
    at Boards.emit (events.js:107:17)
    at Boards.<anonymous> (/home/pi/waterpi-node/node_modules/johnny-five/lib/board.js:1197:14)
    at process._tickDomainCallback (node.js:381:11)

nebrius, 2016-05-10:
Looking at the output, it would appear that you are trying to use Raspi IO _and_ an Arduino Uno connected to the serial port, is that correct? Do you need to use both boards?

If so, I think I know what's going on, Raspi IO is trying to claim the serial port for use with `board.io.serial*` and Johnny-Five is also trying to claim the serial port for use with the Uno+Firmata. Yeah, we need to do something about this.

Regardless, I think it would be worthwhile to add a flag to the Raspi IO constructor to tell it to not initialize the serial port.

nebrius, 2016-05-10:
Thinking through this more, this serial port that it's talking about (`/dev/ttyAMA0`) is different than the USB one used by an Uno. @rwaldron does J5 try and open all serial ports it can find and scan them for Firmata devices? If so, is there a way to blacklist certain ports?

fivdi, 2016-05-10:
The stack trace indicates that an attempt is being made to send information to an I2C LCD wired to the GPIO header on a Raspberry Pi but the I2C LCD can't be found.

As mentioned above, there also appears to be an Arduino Uno connected via USB (/dev/ttyACM0) to the Raspberry Pi, is this correct? There's no mention of the serial port broken out onto the GPIO header on the Raspberry Pi (/dev/ttyAMA0) in the OP.

@asit569 It's probably best if you explain what needs to be achieved with the Arduino Uno and the Raspberry Pi.

asit569, 2016-05-10:
@fivdi i am using aws iot and dynamo db for sensor will timely monitor and display it on lcd if everything correct but it ends up with error please see these below what i want to achieve

https://www.hackster.io/demirhanaydin/waterpi-houseplant-remote-watering-and-monitoring-system-340400
https://github.com/demirhanaydin/waterpi-node

fivdi, 2016-05-10:
Lets see if the LCD can be found on the Raspberry Pi.

First run this command:
```
pi@raspberrypi:~ $ ls -l /dev/i2*
```
This should output either this:
```
crw-rw---- 1 root i2c 89, 1 May  8 23:04 /dev/i2c-1
```
or this:
```
crw-rw---- 1 root i2c 89, 1 May  8 23:04 /dev/i2c-0
```
If `/dev/i2c-1` was found, run the following command:
```
i2cdetect -y -r 1
```
If `/dev/i2c0` was found, run the following command:
```
i2cdetect -y -r 0
```
Note that if command i2cdetect can't be found it will need to be installed with the following command first:
```
sudo apt-get update
sudo apt-get install i2c-tools
```
Then post the output of the command `i2cdetect`

nebrius, 2016-05-10:
Good catch, I was misreading the output @fivdi.

fivdi, 2016-05-10:
@nebrius perhaps you were being distracted by work :)

asit569, 2016-05-10:
@fivdi     pi@raspberrypi:~/waterpi-node $ i2cdetect -y -r 1
     0  1  2  3  4  5  6  7  8  9  a  b  c  d  e  f
00:          -- -- -- -- -- -- -- -- -- -- -- -- --
10: -- -- -- -- -- -- -- -- -- -- -- -- -- -- -- --
20: -- -- -- -- -- -- -- -- -- -- -- -- -- -- -- --
30: -- -- -- -- -- -- -- -- -- -- -- -- -- -- -- 3f
40: -- -- -- -- -- -- -- -- -- -- -- -- -- -- -- --
50: -- -- -- -- -- -- -- -- -- -- -- -- -- -- -- --
60: -- -- -- -- -- -- -- -- -- -- -- -- -- -- -- --
70: -- -- -- -- -- -- -- --

asit569, 2016-05-10:
i have  detached all parts lcd,dht 11,relay from pi then also same error exist @nebrius @fivdi

fivdi, 2016-05-10:
Yes, if everything is detached the same error should occur.

Please edit `/home/pi/waterpi-node/index.js`

and change [these lines](https://github.com/demirhanaydin/waterpi-node/blob/master/index.js#L60-L63):
```
  lcd = new five.LCD({
    controller: "LCM1602",
    board: this.byId('pi')
  });
```
to:
```
  lcd = new five.LCD({
    controller: "PCF8574A",
    board: this.byId('pi')
  });
```
and then check to see if the LCD works.

asit569, 2016-05-10:
Yes finally it solves the issue @fivdi Thankyou

nebrius, 2016-05-10:
> perhaps you were being distracted by work :)

It's what they pay me for after all :) Thanks for the help @fivdi, and I'm glad you got it working @asit569!

fivdi, 2016-05-10:
Excellent!

@asit569 If all is ok now you could hit the `Close issue` button at the bottom of the page :)

yangzai, 2016-05-23:
Is there any way to catch i2c errors like this?

nickcoutsos, 2016-08-05:
Sorry to bring up a closed issue but I got here with the same question as @yangzai and didn't see a solution documented. The i2c error is raised by the board itself and can be handled by listening for its _error_ event:

```
board.on('error', function(err) { console.error(err) })
```

NishantWioc, 2018-03-06:
This problem still exists for me Please Help

`1520356539428 Available RaspberryPi-IO
1520356539906 Connected /dev/ttyACM0
1520356540206 Connected RaspberryPi-IO
connect
1520356544141 Board ID:  pi
1520356544150 Board ID:  uno
1520356544197 Repl Initialized
>> ready
Temperature: 0.00C, humidity: 0.00%
fs.js:753
    return binding.writeBuffer(fd, buffer, offset, length, position);
                   ^

Error: EREMOTEIO: remote I/O error, write
    at Object.fs.writeSync (fs.js:753:20)
    at Bus.i2cWriteSync (/home/pi/Desktop/waterpi-node-master/node_modules/i2c-bus/i2c-bus.js:348:13)
    at I2C.writeSync (/home/pi/Desktop/waterpi-node-master/node_modules/raspi-i2c/dist/index.js:294:38)
    at RaspiIOCore.i2cWrite (/home/pi/Desktop/waterpi-node-master/node_modules/raspi-io-core/dist/index.js:744:19)
    at Expander.portWrite (/home/pi/Desktop/waterpi-node-master/node_modules/johnny-five/lib/lcd.js:64:11)
    at LCD.value (/home/pi/Desktop/waterpi-node-master/node_modules/johnny-five/lib/lcd.js:371:23)
    at new LCD (/home/pi/Desktop/waterpi-node-master/node_modules/johnny-five/lib/lcd.js:792:10)
    at Boards.<anonymous> (/home/pi/Desktop/waterpi-node-master/index.js:60:9)
    at Boards.emit (events.js:159:13)
    at Boards.<anonymous> (/home/pi/Desktop/waterpi-node-master/node_modules/johnny-five/lib/board.js:1208:14)
`

I tried the above solutions, My LCD is connected and i'm able to detect it using the method suggested by @fivdi

I changed
` lcd = new five.LCD({
    controller: "LCM1602",
    board: this.byId('pi')
  });
`
` lcd = new five.LCD({
    controller: "PCF8574AT",
    board: this.byId('pi')
  });
`
Beacause my I2c module uses this controller i found it on the backside of it

fivdi, 2018-03-07:
@NishantWioc

The `"remote I/O error"` means that Johnny-Five / Raspi-IO can't communicate with the I2C LCD.

Can you post the complete output of `i2cdetect -y -r 1` please?
Please also post the complete content of `/boot/config,txt`.
Can you post a picture that clearly shows how the I2C LCD is connected to the Raspberry Pi?

>  Is there something related to temperature sensor not working or not connected ?

There appears to be something wrong as `"Temperature: 0.00C, humidity: 0.00%"` is displayed which doesn't seem plausible. I'm not familiar with the [node-dht-sensor](https://github.com/momenso/node-dht-sensor) module which is used to measure the temperature and humidity. You'll need to figure out if the library is being used correctly. It may also be necessary to use the [Raspi-IO](https://github.com/nebrius/raspi-io) excludePins option to tell Raspi-IO not to initialize the pins used by the DHT sensor.

NishantWioc, 2018-03-08:
**Output for `ls -l /dev/i2*`**
`crw-rw---- 1 root i2c 89, 1 Mar  6 18:02 /dev/i2c-1`

**Output For `i2cdetect -y -r 1`**

     0  1  2  3  4  5  6  7  8  9  a  b  c  d  e  f
00:          -- -- -- -- -- -- -- -- -- -- -- -- --
10: -- -- -- -- -- -- -- -- -- -- -- -- -- -- -- --
20: -- -- -- -- -- -- -- -- -- -- -- -- -- -- -- --
30: -- -- -- -- -- -- -- -- -- -- -- -- -- -- -- 3f
40: -- -- -- -- -- -- -- -- -- -- -- -- -- -- -- --
50: -- -- -- -- -- -- -- -- -- -- -- -- -- -- -- --
60: -- -- -- -- -- -- -- -- -- -- -- -- -- -- -- --
70: -- -- -- -- -- -- -- --

**Content of  Boot/config.txt**
# For more options and information see
# http://rpf.io/configtxt
# Some settings may impact device functionality. See link above for details

# uncomment if you get no picture on HDMI for a default "safe" mode
#hdmi_safe=1

# uncomment this if your display has a black border of unused pixels visible
# and your display can output without overscan
#disable_overscan=1

# uncomment the following to adjust overscan. Use positive numbers if console
# goes off screen, and negative if there is too much border
#overscan_left=16
#overscan_right=16
#overscan_top=16
#overscan_bottom=16

# uncomment to force a console size. By default it will be display's size minus
# overscan.
#framebuffer_width=1280
#framebuffer_height=720

# uncomment if hdmi display is not detected and composite is being output
#hdmi_force_hotplug=1

# uncomment to force a specific HDMI mode (this will force VGA)
#hdmi_group=1
#hdmi_mode=1

# uncomment to force a HDMI mode rather than DVI. This can make audio work in
# DMT (computer monitor) modes
#hdmi_drive=2

# uncomment to increase signal to HDMI, if you have interference, blanking, or
# no display
#config_hdmi_boost=4

# uncomment for composite PAL
#sdtv_mode=2

#uncomment to overclock the arm. 700 MHz is the default.
#arm_freq=800

# Uncomment some or all of these to enable the optional hardware interfaces
dtparam=i2c_arm=on
#dtparam=i2s=on
#dtparam=spi=on

# Uncomment this to enable the lirc-rpi module
#dtoverlay=lirc-rpi

# Additional overlays and parameters are documented /boot/overlays/README

# Enable audio (loads snd_bcm2835)
dtparam=audio=on

# NOOBS Auto-generated Settings:

#hdmi_force_hotplug=1

dtparam=i2c_arm=on
dtparam=i2c=on
dtparam=i2c_arm_baudrate=100000

Image for Raspberry to LCD connection
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

**`Image for i2cdetect -y -r 1`**
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

NishantWioc, 2018-03-08:
## MORE PICTURES
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

NishantWioc, 2018-03-08:
# Now I'm getting this New Error

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

fivdi, 2018-03-08:
Nice pictures. Everything and in particular the LCD looks good to me.

The "TypeError: Cannot read property forEach of undefined" is occurring on [this line of code](https://github.com/rwaldron/johnny-five/blob/master/lib/lcd.js#L651) which is for a parallel LCD not an I2C LCD.

Has the code been modified since yesterday?
Is the following line of code not being use to create an LCD instance anymore?
```js
 lcd = new five.LCD({ controller: "PCF8574AT", board: this.byId('pi') });
```

fivdi, 2018-03-08:
There's also an Arduino UNO connected to one of the USB ports on the Pi, correct? I can't see it in the photos.

fivdi, 2018-03-08:
Maybe it would be a good idea to test the components one by one to get them to work before tyring everything at the same time.

For example, if the Arduino UNO is disconnected from the USB port and the following (untested) program is run on the Pi does it display anything on the LCD?
```js
const Raspi = require('raspi-io');
const five = require('johnny-five');
const board = new five.Board({
  io: new Raspi()
});

board.on('ready', () => {
  var count = 0;
  var lcd = new five.LCD({
    controller: "PCF8574AT"
  });

  setInterval(() => {
    count += 1;
    lcd.print('Hello' + count);
  }, 1000);
});
```

NishantWioc, 2018-03-09:
Thanks for your quick reply :)
umm  I didn't modified the code. What i can do is download the project once again with clean code. Because it may be possible that i removed something form code during removing lcd code. but that's an another file with lcd code removed

Yes You are right there's an Arduino Uno connected to one of the Usb Port of pi,
I'll try the same as you suggested then i will tell you the results :)
Thanks once again :D

NishantWioc, 2018-03-09:
# Lcd Prints Nothing
I tried the above code and everything looked fine, i disconnected  Arduino too but lcd prints nothing

#### following is the output
`
1520617959178 Available RaspberryPi-IO
1520617959535 Connected RaspberryPi-IO
1520617959617 Repl Initialized
>>
`
#### Here's the picture
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

# It tried something
`lcd.print('Hello');
	console.log(lcd.print('Hello'))`

## Output

`1520618340723 Available RaspberryPi-IO
1520618341140 Connected RaspberryPi-IO
1520618341233 Repl Initialized
>> LCD {
  board:
   Board {
     io:
      RaspiIOCore {
        domain: null,
        _events: [Object],
        _eventsCount: 4,
        _maxListeners: undefined,
        name: 'RaspberryPi-IO',
        isReady: [Getter],
        pins: [Getter],
        analogPins: [Getter],
        MODES: [Object],
        HIGH: 1,
        LOW: 0,
        defaultLed: -1,
        SERIAL_PORT_IDs: [Object] },
     timer:
      Timeout {
        '0': null,
        _called: false,
        _idleTimeout: -1,
        _idlePrev: null,
        _idleNext: null,
        _idleStart: 5974,
        _onTimeout: null,
        _timerArgs: undefined,
        _repeat: null,
        _destroyed: false,
        [Symbol(asyncId)]: 11,
        [Symbol(triggerAsyncId)]: 7 },
     isConnected: true,
     isReady: true,
     register: [ [Circular] ],
     occupied: [],
     Drivers: {},
     id: 'DE2690CA-F153-4772-A103-41E63E2F5537',
     debug: true,
     repl: Repl { context: [Object], ready: true, cmd: [REPLServer] },
     sigint: true,
     pins:
      Pins {
        '0': [Object],
        '1': [Object],
        '2': [Object],
        '3': [Object],
        '4': [Object],
        '5': [Object],
        '6': [Object],
        '7': [Object],
        '8': [Object],
        '9': [Object],
        '10': [Object],
        '11': [Object],
        '12': [Object],
        '13': [Object],
        '14': [Object],
        '15': [Object],
        '16': [Object],
        '17': [Object],
        '18': [Object],
        '19': [Object],
        '20': [Object] },
     transport: null,
     port: 'RaspberryPi-IO',
     type: 'OTHER',
     _events: { ready: [Function] },
     _eventsCount: 1,
     MODES: { INPUT: 0, OUTPUT: 1, ANALOG: 2, PWM: 3, SERVO: 4 },
     millis: [Function] },
  io:
   RaspiIOCore {
     domain: null,
     _events:
      { close: [Function: bound ],
        disconnect: [Function: bound ],
        error: [Function: bound ],
        string: [Function: bound ] },
     _eventsCount: 4,
     _maxListeners: undefined,
     name: 'RaspberryPi-IO',
     isReady: [Getter],
     pins: [Getter],
     analogPins: [Getter],
     MODES: { INPUT: 0, OUTPUT: 1, ANALOG: 2, PWM: 3, SERVO: 4 },
     HIGH: 1,
     LOW: 0,
     defaultLed: -1,
     SERIAL_PORT_IDs: { HW_SERIAL0: '/dev/ttyAMA0', DEFAULT: '/dev/ttyAMA0' } },
  id: '0B7F4E4B-BD82-4092-B263-56F9D574D61D',
  custom: {},
  controller: 'PCF8574AT',
  ctype: 'PCF8574AT',
  bitMode: 4,
  lines: 2,
  rows: 2,
  cols: 16,
  dots: '5x8',
  address: { lcd: 63 },
  expander:
   Expander {
     address: 63,
     mask: 0,
     memory: 249,
     io:
      RaspiIOCore {
        domain: null,
        _events: [Object],
        _eventsCount: 4,
        _maxListeners: undefined,
        name: 'RaspberryPi-IO',
        isReady: [Getter],
        pins: [Getter],
        analogPins: [Getter],
        MODES: [Object],
        HIGH: 1,
        LOW: 0,
        defaultLed: -1,
        SERIAL_PORT_IDs: [Object] } } }`

fivdi, 2018-03-09:
So there are no errors but nothing is displayed on the LCD. This is strange. Does adjusting the blue potentiometer on the LCD interface board help? If it doesn't, I can't think of anything else to do other than trying to debug the problem. I'm afraid I don't have an I2C LCD to give it a try.

NishantWioc, 2018-03-13:
I think either i have to adujst the potentiometer  or the lcd is getting the garbage data. For Now i have just removed the lcd code, and the project is working fine. I'll try to debug the problem :) Thanks for your help ;)

Closed 2016-05-10.

Thread 1133 (2016-05-13):

Trying to use 6 steppers.

drj-io, 2016-05-13:
https://gist.github.com/drj-io/56db4be7e002e763ff5e0c2a5e256f59

I'm using Big Easy Drivers (sparkfun). I'm able to run the above code with steppers 1-4 or 3-5... any combo of 4.

If I engage 5 or 6, the steppers never run.

I'm using a 10A 12v power supply, so there should be enough juice.

I'm using an Arduino Mega 2560 with Advanced Firmata.

soundanalogous, 2016-05-13:
Are you using an Arduino or something like a Raspberry PI?

drj-io, 2016-05-14:
Arduino.

drj-io, 2016-05-14:
here is the hardware config.  In this picture, the steppers aren't hooked up, but I assure you they've all been tested and work individually.  I've been using J5 with steppers for about a year now and I've never run into anything like this.  But I've also never set up more than 3 steppers.

Any ideas would be great thanks!

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

soundanalogous, 2016-05-14:
Firmata (which the J5 implementation for Arduino uses under the hood) supports up to 6 stepper motors simultaneously. However I've never tested with 6 since I've never had that many drivers at one time. The issue could lie in the Firmata firmware or the the firmata.js middle-ware. I'll look over the code for both to see if I see any potential issues. May not get to it until later this weekend.

soundanalogous, 2016-05-14:
Have you tried 5 steppers simultaneously, or the most you can run is 4?

soundanalogous, 2016-05-14:
Also, are you using ConfigurableFirmata, AdvancedFirmata or some other variant?

drj-io, 2016-05-14:
I have tried 4 & 5,  In one case I was able to get 5 working.  We are using advancedFirmata.

drj-io, 2016-05-14:
Also, we did change MAX_STEPPERS in the Firmata code, and in steppers.js J5 lib, but that did not help.

soundanalogous, 2016-05-14:
I don't see anything suspect in the code in either AdvancedFirmata or firmata.js. Have you tried attaching the steppers to different pins on the board to see if that makes any difference? This is probably going to require adding Logging into AdvancedFirmata and firmata.js in order to diagnose. Also if you have access to an oscilloscope that may be useful in monitoring power and signals on the motors to see if that is the source.

soundanalogous, 2016-05-14:
Also have you tried controlling the steppers using firmata.js instead of J5? That can help diagnose if the issue could be in J5.

drj-io, 2016-05-16:
@soundanalogous thanks for your ideas.  We've tried different pins, and haven't had any luck with that. We might want to try a different board, though...  Just to be sure.

We have swapped out different pins/steppers and can only narrow it down to the number of steppers that are in the mix.  And we can get each stepper to function properly.

I'll checkout https://www.npmjs.com/package/firmata and see what we can reproduce the same issue. I was not aware of this lib, so it might be something we can also use.

+ @ludicsound is also helping out, so I'm tagging him.

Thanks again!

drj-io, 2016-06-22:
This is still an issue, though I haven't had a chance to try with Firmata.  We'd like to get this working, but for now we're just using 2 arduino's for our application...

drj-io, 2016-09-06:
I considered several work-arounds on this one, but here's what I decided to do.

Each stepper is set individually, so I didn't need the timing in manipulation to be super precise, at least not yet.  We've got some enhancements that will require this, but for now we just want to get our POC working.

We had thought about connecting to the board and then trying to close it, alternating pins each time, but we determined that is not a feature that will be supported anytime soon - #617

We've decided to spawn a separate process script for each stepper.  This node spawn simply loads J5, connects to the board, turns 1 stepper to the precise location, and then does a `process.exit(0)`...  The controlling software goes through each stepper until everything is finished.

the command line script looks something like

`node arduino-standalone --method=stepper --m1=35 --m2=34 --cw=3600 -rpm=180`

This will work for now for our application, but it would be nice if we could support 6 steppers per board, particularly for some of our more real-time features.

I tested the original script again (https://gist.github.com/drj-io/56db4be7e002e763ff5e0c2a5e256f59) with the latest NPM install and a different computer (OSX -> Arduino) and got the same result.

Thanks!

techniq, 2016-11-10:
I'm trying to use 3 stepper motors, but am struggling to even get 2 running at the same time.  I'm using a Nano with the A4988 driver.

```js
var five = require("johnny-five");
var board = new five.Board({repl:false});

board.on("ready", function() {

  var stepper1 = new five.Stepper({
    type: five.Stepper.TYPE.DRIVER,
    stepsPerRev: 200,
    pins: [4, 5]
  });

  var stepper2 = new five.Stepper({
    type: five.Stepper.TYPE.DRIVER,
    stepsPerRev: 200,
    pins: [7, 6]
  });

  stepper1.rpm(180).ccw().step(200, function(){
    console.log("done");

    stepper2.rpm(180).ccw().step(200, function() {
	    console.log("done");
  	});

  });
});
```

If I comment out the other stepper, they work individual, but never together.  I'm using ConfigurableFirmata built from http://firmatabuilder.com/ with StepperFirmata selected.  I haven't tried using AdvancedFirmata, but might since 4 have been shown to work with it (although it is now deprecated in favor of ConfigurableFirmata).  I also might try using a Teensy so see if it helps, but was checking to see if there are any known issues/gotchas with more than 1 stepper.  I saw there were some changes [coming](https://github.com/rwaldron/johnny-five/issues/1218#issuecomment-258685642) to Firmata/J5 but didn't see anything that might fix this.

soundanalogous, 2016-11-10:
Please try using AdvancedFirmata. The stepper code in AdvancedFirmata is equivalent to that in ConfigurableFirmata. I'm wondering if something else in ConfigurableFirmata is causing an issue. Please also report the full list of features you selected when using firmatabuilder.

techniq, 2016-11-10:
Thanks @soundanalogous.  I'm also having trouble with a regular dc motor (using the `Motor` class) for the same project, and it appears to be some kind of firmata compatibility issue with my Arduino Nanos (some from Amazon, and some from Banggood experience the same issues).  I'm going to open a separate issue for this (with better explanation) but until I resolve that issue, consider my report null and void :)

techniq, 2016-11-10:
@soundanalogous Btw, part of my DC Motor / PWM issue might steam from using pins 9 and 10 and `StandardFirmata` and my `ConfigurableFirmata` included `Servo` support, which looks to disable PWM on these pins.  I'm pretty sure I was also having issues with pins 3, 5, 6 with PWM, but I was mostly focused on 9 and 10 due to my breadboard layout.  Once I resolve the PWM/DC motor issue, I'll report back with multiple servo support.

soundanalogous, 2016-11-10:
That's correct you can't reliably use a motor on pin 9 when the Servo library is included.

techniq, 2016-11-15:
I commented out a reference to a [Servo](http://johnny-five.io/api/servo/) I had overlooked and also switched to `AdvancedFirmata`.  I'm not sure if switching to AdvancedFirmata was required, but I now had 3 working steppers and 2 DC motors for my project, so I'm happy.  Thanks

soundanalogous, 2016-11-15:
I would still like to try to figure out why ConfigurableFirmata is not working. Can you create build with [firmatabuilder](http://firmatabuilder.com/) and select only the following features and let me know if that works with 3 stepper motors (I'd test myself but only have 2 stepper motors).

- DigitalInputFirmata
- DigitalOutputFirmata
- AnalogInputFirmata
- AnalogOutputFirmata
- I2CFirmata
- StepperFirmata

techniq, 2016-11-15:
Sure. I won't have the hardware back for a few days but I'll try to report
back by the end of the week.

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

drj-io, 2017-03-10:
Hi all, I wanted to follow up on this.  I haven't tested lately as we're still using the above workaround. Was wondering if anyone had a chance to look at this.

I can test next week if needed.

dtex, 2017-07-19:
@drj-io I have a PR against firmata.js and configurableFirmata that is a complete rewrite of stepper. I don't have the Johnny-Five part yet, but would you be willing to test against firmata.js? I can port [your gist](https://gist.github.com/drj-io/56db4be7e002e763ff5e0c2a5e256f59) if necessary.

drj-io, 2017-07-19:
@dtex great news, I will see what I can do to port over to firmata.js to test.  Can you link me to the PRs?

dtex, 2017-07-19:
https://github.com/firmata/ConfigurableFirmata/pull/72
https://github.com/firmata/firmata.js/pull/176
and if necessary for reference
https://github.com/firmata/protocol/pull/90

I'm in the middle of changing references from Stepper2Firmata to AccelStepperFirmata. So if you see stepper2 anywhere replace with accelStepperFirmata

dtex, 2018-08-21:
The new stepper class in Johnny-Five is coming very, very soon so let's remove the stale label and close this properly when the time comes.

dtex, 2019-08-16:
Back off Stale Bot, I'm working on it.

Closed 2020-08-19.

Thread 1135 (2016-05-15):

ADXL345 accelerometer - Problems of bit addresses

Jeremboo, 2016-05-15:
Hi,

With @tournevis we use an [ADXL345 accelerometer](https://www.amazon.fr/SODIAL-ADXL345-Digital-Acceleration-dinclinaison/dp/B00KBPR3E0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) and we discover a largely known problem about the Z-axis value. One of solutions (except buying another model) is to changing the range of the accelerometer like they say into this two topics :

- [Forum Arduino - Problem with adxl345 3-axis accelerometer](http://forum.arduino.cc/index.php?topic=101845.0)

>  The arduino code I am using (Razor_AHRS) initializes the accelerometer for range +-2g. By switching to +-16 g mode (writing 0x0B instead of 0x08 to register 0x31), I was able to get unclipped reading from Z axis.

- [Avrfreaks - ADXL345 Accelerometer Z-axis not working](http://www.avrfreaks.net/forum/adxl345-accelerometer-z-axis-not-working)

> I changed the range to +- 16 g and that seemed to solve the problem.

And it works fine for us.

Now, we pass to Firmata using jhonny-five and we discover the same trouble using the [ADXL345 example](http://johnny-five.io/examples/accelerometer-adxl345/) :

````
  x            :  -0.22
  y            :  -0.53
  z            :  2.04
--------------------------------------
  x            :  -0.18
  y            :  -0.51
  z            :  2.04
```

The Z-axis never change and it's not possible to calibrate the range.

Then, when we look `johnny-five/accelerometer.js` (exactly [l.129-130](https://github.com/rwaldron/johnny-five/blob/master/lib/accelerometer.js#L129-L130)) we found mistakes into the bit adresses. According to the [i2cdevlib/ADXL345](https://github.com/jrowberg/i2cdevlib/tree/master/Arduino/ADXL345) arduino library, good adresses are :

```
#define ADXL345_ADDRESS_ALT_LOW     0x53 // alt address pin low (GND)
#define ADXL345_ADDRESS_ALT_HIGH    0x1D // alt address pin high (VCC)
....
#define ADXL345_RA_DATA_FORMAT      0x31
#define ADXL345_RA_DATAX0           0x32
#define ADXL345_RA_DATAX1           0x33
#define ADXL345_RA_DATAY0           0x34
#define ADXL345_RA_DATAY1           0x35
#define ADXL345_RA_DATAZ0           0x36
#define ADXL345_RA_DATAZ1           0x37
....
#define ADXL345_RANGE_2G            0b00
#define ADXL345_RANGE_4G            0b01
#define ADXL345_RANGE_8G            0b10
#define ADXL345_RANGE_16G           0b11
...
```
...and into `johnny-five/accelerometer.js` we have :

```
ADXL345: {
    ADDRESSES: {
      value: [0x53]
    },
    REGISTER: {
      value: {
        POWER: 0x2D,
        RANGE: 0x31,
        READREGISTER: 0x32
      }
    },
```

So the `RANGE` and `READREGISTER` values seems to be wrong. They shift the values completely. This seems to be true because when we are changing adresses, we already have better results :
```
 RANGE: 0b11,
 READREGISTER: 0x31
```
```
  x            :  -32.36
  y            :  14.12
  z            :  0
--------------------------------------
  x            :  -31.95
  y            :  21.09
  z            :  -1.02
```

But the Z-axis is locked between `0` and `-1.02` and changes into a very little angle. It is not still usable and we think it's because the range value is at  `+-2g`. And when we are adding into our Firmata arduino code the ADXL345 library to calibrate manually the range, the accelerometer works perfectly.

So, we think there are two problems into the johnny-five support :

1. The bit adresse `READREGISTER` is wrong.
2. The bit adresse `RANGE` is wrong and in any case never applied.

Hoping to have helped.

rwaldron, 2016-05-16:
This is all very interesting, a bit much to read through, but interesting. According to the datasheet, 0x32 is the correct register to read from, as 0x31 is the `DATA_FORMAT` register

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

> Then, when we look johnny-five/accelerometer.js (exactly l.129-130) we found mistakes into the bit adresses. According to the i2cdevlib/ADXL345 arduino library, good adresses are :

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

How is that Johnny-Five is wrong, and this is right, when they literally have the same exact number? 0x32 is the same number in C as it is in JavaScript. In Johnny-Five, `ADXL345_RA_DATAX0` is generically called `READREGISTER`.

`RANGE: 0x31` is _definitely_ wrong.

ADXL345 controller is one of the oldest controllers here and clearly needs some love. I'll take a look as soon as I have time.

>  And when we are adding into our Firmata arduino code the ADXL345 library to calibrate manually the range, the accelerometer works perfectly.

I don't recommend changing anything at the Firmata level.

rwaldron, 2016-05-16:
Update: the use of `RANGE: 0x31` is correct, I just looked past the bit field table earlier. Range is set in bits 0 and 1 of the `DATA_FORMAT` register and we're just calling that register "RANGE" because... I don't remember why...

What needs to happen is that this controller needs to allow a `range` property in the constructor options:

```js
Accelerometer({
  controller: "ADXL345",
  range: 2
});
```

Where range can be one of: 2, 4, 8, 16

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

And then this line:

```js
// Set range (this is 2G range, should be user defined?)
this.io.i2cWrite(address, this.REGISTER.RANGE, 8);
```

Needs to be something like...

```js
var range = ({ 2: 0, 4: 1, 8: 2, 16: 3 })[opts.range || 2];
this.io.i2cWrite(address, this.REGISTER.RANGE, range);
```

rwaldron, 2016-05-17:
@Jeremboo can you test those changes? `npm install rwaldron/johnny-five` to get the changes to try out.

```js
new five.Accelerometer({
  controller: "ADXL345",
  range: 2 // 2, 4, 8, 16
});
```

Jeremboo, 2016-05-17:
Hi @rwaldron !

Thank you very much for your reactivity and your advices ! With this changes, we will not need to using our dirty tricks for our project ;)

I tried your code and the `range` is updated correctly. So your support works very well !

However, the Z-axis can be read only with the `range: 16`. The quality of my accelerometer can be interrogated...

-----

_Render with `range: 16`:_
```
  x            :  0.59
  y            :  2.5
  z            :  67.89
--------------------------------------
  x            :  0.21
  y            :  1.94
  z            :  69.77
```

Thank you again and sorry for my long and misleading assumption.

rim0621, 2018-09-07:
HI, i using ADXL345 and +-16g.
i know the ranges are -256 ~ +255(10bits).
but i have got over 255 and under -256...
what is wrong? can you help me? thank you.
'''
  after reading data...
			gxt = HLdata(TempChar[5], TempChar[4]);
			gyt = HLdata(TempChar[7], TempChar[6]);
			gzt = HLdata(TempChar[9], TempChar[8]);
'''

Closed 2016-05-17.

Thread 1145 (2016-06-01):

Pololu - Dual MC33926 Motor Driver Carrier

martinschuberteu, 2016-06-01:
Hi,
I got a MC33926 connected to an PCA9685 expander and am really struggling to get a motor running. I've tried both 2 (pwm, dir) and 3 (pwm, dir, cdir) pin configurations with different pins and invertPWM:true. I actually only want to use two PWMs that are connected to IN1 and IN2 and according to the truth table in the documentation [https://www.pololu.com/file/download/MC33926.pdf?file_id=0J233](url) they should be set to:
                          IN1            IN2
Forward             High          Low
Reverse             Low           High

(and both low for stop I guess). How can I do this with the motor class? Is there something like a truth table for pwm, dir or pwm, dir, cdir for the motor class? Thank you!

dtex, 2016-06-01:
Hi there,

So you're running Arduino->PCA9685->MC33926? I've never seen that configuration before. First question, how many motors are you trying to control? You might not need the PCA9685.

martinschuberteu, 2016-06-01:
Hi Donovan,
Raspberry PI 3 -> (via I2C) PCA9685 -> (PWM) MC33926 actually. It works perfectly find for e.g. servos and shouldn't be any problem at all. I'm using the PCA9685 because I need more PWM ports than the Raspberry PI has and  I just need to know how to use the motor class with two PWMs to control a motor connected to the MC33926. Is there something like a table that shows the output on pwm, dir or pwm, dir, cdir for the different states in the motor class (stop, forward, reverse, ...)?

dtex, 2016-06-01:
Every motor controller is a snowflake and may or may not have different jumpers available/enabled so a truth table would be hard. This is my first 4-pin input motor controller but I believe we can put a jumper on one or two of those pins and get us down to a configuration that emulates a two or three pin controller.

What pins do you have jumpers on right now?

martinschuberteu, 2016-06-01:
I've tried these to configurations:

#1 jumpers on EN, D1 and D2 and PWM on IN1 and IN2 for pwm and dir
#2 jumpers on EN and D1 and PWM on D2, IN1 and IN2 for pwm, dir and cdir

For #1 (which I would prefer) the motor was running when it should have been stopped, and was stopped when it should run. Reverse actually worked and after the reverse a stop also worked. As I said I've tried different combinations on the pins and also invertPWM:tru, but it never did what it should do. So I was hoping to get some information on the output of the pins for stop, forward, reverse to try and map it with the truth table in the MC33926 documentation.

martinschuberteu, 2016-06-01:
FYI: I was also using this forum entry as reference: [http://letsmakerobots.com/node/39173](url)

dtex, 2016-06-01:
I think you are totally on the right track with #1, invertPWM: true and those jumper settings. The behavior you describe is exactly what I would expect if invertPWM were not set to true. Forgive me for asking again, but can I see you opts object? I confess I'm just looking for a typo.

dtex, 2016-06-01:
Also, I can see it working with the jumpers on D1 and D2 removed.

martinschuberteu, 2016-06-01:
I've removed the jumpers on D1 and D2 and the result was that the motor was stopped all the time. I've also tried it again with #1 and invertPWM: true and here's what I get on OUT1 and OUT2:

initial:             -10.8V
forward 128:    -5.3V
stop:              -10.8V
reverse:          10.8V
stop:              0V
forward 255:  0V

Also here's the relevant code:

`
var pwmExpander = new five.Expander({
    controller: "PCA9685"
  });

  var pwmBoard = new five.Board.Virtual({
    io: pwmExpander
  });

  var leftMotor = new five.Motor({
    pins: {
      dir: 8,
      pwm: 9,
      invertPWM: true
    },
    board: pwmBoard
  });

  // motor test
  console.log("motor forward 128");
  leftMotor.forward(128);
  sleep.sleep(5);
  console.log("motor stop");
  leftMotor.stop();
  sleep.sleep(5);
  console.log("motor reverse");
  leftMotor.reverse(255);
  sleep.sleep(5);
  console.log("motor stop")
  leftMotor.stop();
  sleep.sleep(5);
  console.log("motor forward 255");
  leftMotor.forward(255);
`

martinschuberteu, 2016-06-01:
I've just tested it without invertPWM and am getting the same values actually.

dtex, 2016-06-01:
Haha, okay I'm gonna have to draw myself a picture.

I'll get back to you with some thoughts by tomorrow. Let me know if you figure it out before then.

martinschuberteu, 2016-06-01:
Thank you so much, your help is really appreciated!

dtex, 2016-06-02:
I think I understand it now. Have you tried it with the above code and Jumper on D1 but no jumper on D2? If it still doesn't work I'm just going to order one.

martinschuberteu, 2016-06-02:
I've just tried that and got nothing, but then I tried it again with the following configuration, and it worked!

dir:     IN1
cdir:   IN2
pwm: D2

I'm pretty sure I've tried that before, but who cares if it works now :) Thank you so much!

martinschuberteu, 2016-06-02:
One last question if I may: I' also considering using the feedback port to current, but it would have to be  on a different virtual board. Does johnny-five support having the ports on different boards?

dtex, 2016-06-02:
I'm glad you got it working... I still wonder if it couldn't be done with just two pins...

This was such a brain bender I think we should add an example in case anyone else is having similar troubles. Would you like to be a Johnny-Five contributor? This is a relatively easy first contribution (the hardest part is the Fritzing diagram) and I'll help you with the process.

Yes. The current object is just passed to sensor as sensor opts. It can be on a different virtual board.

martinschuberteu, 2016-06-02:
Sure, I'd love too. I've actually downloaded Fritzing but couldn't find the shapes needed. I'll have a look if I can get the somewhere and then create a new example for Raspberry PI + MC33926  in the motor wiki?

What would the syntax look like to assign dedicated pins to dedicated boards?
`
  var leftMotor = new five.Motor({
    pins: {
      dir: 8,
      cdir: 9,
      pwm: 10
    },
    board: pwmBoard
  });
`

dtex, 2016-06-02:
You can't split one motor's drive pins between boards. It works for current sensing because current instantiates a sensor object that can take a different board property.

I don't know that I would use a Pi in the example since the real pickle here was the MC33926 jumper and pin configuration. That could be for anybody/any platform. I'd just show it wired to an Uno since that's the most basic option. Oh hey, you could totally do both!

martinschuberteu, 2016-06-02:
Sure, I'll have a look into both :) Thank you again!

martinschuberteu, 2016-06-02:
I've already created /docs/breadboard/motor-Pololu-Dual-MC33926.fzz and /docs/breadboard/motor-Pololu-Dual-MC33926.png and will test this with an Arduino UNO on the weekend and then create /docs/motor-Pololu-Dual-MC33926.md and /eg/motor-Pololu-Dual-MC33926.js and check everything in. Is that it or am I missing something?

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

dtex, 2016-06-03:
That's all the hard parts. There are a couple of other small things that you have to do:

Add entries for each example to https://github.com/rwaldron/johnny-five/blob/master/tpl/programs.json#L392

Run ```grunt examples``` That will generate the markdown files and update the readme.

This process also updates the http://johnny-five.io website

rwaldron, 2016-06-21:
@martinschuberteu how is this coming along? Anything we can iron out together?

martinschuberteu, 2016-06-21:
I have it on my todo list, but didn't get to it yet. I'm hoping to get this done on the weekend though!

rwaldron, 2016-06-21:
@martinschuberteu ok, awesome :)

Closed 2019-02-04.

Thread 1148 (2016-06-04):

Reconnection : How can I reallocated the board and pins to make work properly ?

Jeremboo, 2016-06-04:
**Board:** Particle Photon
**Shield:** none
**Hardware:** Motor [Micro buzzer](http://www.ebay.com/itm/121720786154?_trksid=p2060353.m2749.l2649&ssPageName=STRK%3AMEBIDX%3AIT)
**Johnny-Five Version:** 0.9.52
**Node version:** 5.0.0
**OS:** OSX 10.11.3
**Expected result:** The buzzers work even if I reconnect my photon
**Current result:** On reconnection, the buzzers don't work and I have this log : `Component pin: D0 is already in use`.

---

Hi,

I have two micro buzzers connected at my Particle photon board on pins `D0` and `D1` powered by a battery.

When I turn on my board, she connects to my node.js server and I can initiate my Photon and my two buzzers like this :

```
var leftMotor = { five: false, speed: 0 };
var rightMotor = { five: false, speed: 0 };
var board = new five.Board({
  io: new Particle({
    host: this.IPAddress,
    port: 48879,
  })
});

_initMotor(leftMotor, 'D0');
_initMotor(rightMotor, 'D1');

function _initMotor(motor, pin) {
  motor.five = new five.Motor({ pin });

  motor.five.on('start', () => {
    console.log('start', Date.now());
  });

  motor.five.on('stop', () => {
    console.log('stop', Date.now());
  });

  motor.five.start(0);
}
```

See the complete code here [Bracelet.js](https://github.com/ricochetGobz/ricochet_server/blob/master/app/components/Bracelet.js).

And It works well. I can changing the speed of both buzzer when i want.
## My Problem :

**But now**, I would try to predict the case where my disconnected Photon tries to reconnect (with the same IP). Because I can not restart my node.js server used for other things at the same time.

And in each test, I have the same error and the motors don't reply.

```
 -> bracelet connected at 192.168.1.2
1465033754482 Device(s) particle-io
1465033754484 Connected particle-io
1465033754488 Repl Initialized
>> init motors
1465033754530 Component pin: D0 is already in use
1465033754531 Component pin: D1 is already in use
```

So my question is : **How can I manage reconnection or reallocated the pins to make work the buzzers properly ?**
## Already tried:
- Detect if the IP is already used and :
  - Do not reconnect the board and motors.  👎_nothing is happening_
  - Do not reconnect the board, just recreate motor `new five.Motor({ pin })`.  👎_log error `Component pin: D0 is already in use` && nothing is happening_
  -  Reconnect the board and :
    - Nothing else.  👎 _nothing is happening_
    - recreate motor `new five.Motor({ pin })` 👎_log error `Component pin: D0 is already in use` && nothing is happening_
    - `.stop()` and `.start(255)` motor. 👎_nothing is happening_
    - using pins manually  👎_log error `Component pin: D0 is already in use` && nothing is happening_

  ```
        var pin = new five.Pin('D0');
        pin.mode = five.Pin.OUTPUT;
        pin.mode = five.Pin.INPUT;
  ```
- - delete all variables before recreate board and motors. 👎_log error `Component pin: D0 is already in use` && nothing is happening_

  ```
         board = null;
         leftMotor.five.stop();
         rightMotor.five.stop();
         leftMotor.five = null;
         rightMotor.five = null;

         // or

         delete board;
         delete rightMotor;
         delete leftMotor;
  ```

---

Thanks for reading. My question seem basic and I am sorry to create an issue but I did not found informations about that.

rwaldron, 2016-06-06:
>  nothing is happening

Well, my first thought is that this:

```js
var leftMotor = { five: false, speed: 0 };
var rightMotor = { five: false, speed: 0 };
var board = new five.Board({
  io: new Particle({
    host: this.IPAddress,
    port: 48879,
  })
});

_initMotor(leftMotor, 'D0');
_initMotor(rightMotor, 'D1');

function _initMotor(motor, pin) {
  motor.five = new five.Motor({ pin });

  motor.five.on('start', () => {
    console.log('start', Date.now());
  });

  motor.five.on('stop', () => {
    console.log('stop', Date.now());
  });

  motor.five.start(0);
}
```

...isn't a valid Johnny-Five program.

Those motors can't be created until after the board and the program have finished initializing:

```js
var leftMotor = { five: false, speed: 0 };
var rightMotor = { five: false, speed: 0 };
var board = new five.Board({
  io: new Particle({
    host: this.IPAddress,
    port: 48879,
  })
});

_initMotor(leftMotor, 'D0');
_initMotor(rightMotor, 'D1');

function _initMotor(motor, pin) {
  motor.five = new five.Motor({ pin });

  motor.five.on('start', () => {
    console.log('start', Date.now());
  });

  motor.five.on('stop', () => {
    console.log('stop', Date.now());
  });

  motor.five.start(0);
}

board.on("ready", function() {
  _initMotor(leftMotor, 'D0');
  _initMotor(rightMotor, 'D1');
});
```

rwaldron, 2016-06-06:
Ok, I see that _is_ in your full program. I'll need some time to take a closer look.

rwaldron, 2016-06-06:
> So my question is : How can I manage reconnection or reallocated the pins to make work the buzzers properly ?

@BrianGenisio @monteslu what do you think? I haven't encountered such a thing and it's not in Johnny-Five's scope to be concerned with reconnection, etc. I'm thinking that the node.js program should be managed as a child process that restarts when the remote end disconnects?

BrianGenisio, 2016-06-08:
Hmmmm... Yeah, I see disconnects happen, and I agree it is frustrating.  I haven't spent any time trying to detect and recover from it.  I just kill the app and re-start.

But, it does seem like the [Particle-IO](https://github.com/rwaldron/particle-io) plugin can be smarter.  If it detects a disconnection, it can re-connect and Johnny-Five can be none-the-wiser.  Seems like that might be the best approach?  Perhaps VoodooSpark needs to be updated as well.

mwittig, 2016-06-08:
Perhaps off-topic and pedantic: I think the corrected code example above is still wrong. The two ```_initMotor``` calls before ```function _initMotor``` need to be removed.

Jeremboo, 2016-06-13:
Hi all, sorry for my late answer.

> Ok, I see that is in your full program. I'll need some time to take a closer look. Sorry, long day :\

No problem @rwaldron. If I had make a good example without mistake, there would not been troubles.

> But, it does seem like the Particle-IO plugin can be smarter.

@BrianGenisio particle-IO, if I'm not mistaken, has not a method for disconnect and seem not recognize a lost connection or a disconnecting message. Maybe should I create an issue on Particle-IO about that for more visibility ?

@mwittig the corrected code example is not perfect. But in any case it was just an example. My true code is into a es2015 class [here](https://github.com/ricochetGobz/ricochet_server/blob/master/app/components/Bracelet.js) probably with errors too ;).

BrianGenisio, 2016-06-13:
@Jeremboo You are correct.  [particle-io](https://github.com/rwaldron/particle-io/blob/master/lib/particle.js) doesn't try to reconnect or anything.  It isn't terribly straight-forward, since some state needs to be maintained so that it can re-ask for input streams.  But it would make the story much more robust if we were able to come up with a way to do this, which would be nice.  It wouldn't hurt to create an issue in particle-io so we can discuss it more there.  Especially since it isn't J5's responsibility to do this.

Closed 2018-08-28.

Thread 1151 (2016-06-06):

unable to read value of digital pin mode is OUTPUT.

overflowz, 2016-06-06:
Well, hi. As docs say, board.digitalRead can read value from any digital pin WHEN IT CHANGES.
While callback is not fired whenever pin mode is set to OUTPUT.

Could someone point me how can I read output mode pin states whenever it changes?

Regards.

rwaldron, 2016-06-06:
That's not possible with the underlying Firmata protocol. If you're writing to the output somewhere else, then it would be inefficient to respond to that state change by reading the actual output itself, it makes more sense to just signal in your program that the output was changed. If that's really out of the question, just use another pin:

```js
var five = require("johnny-five");
var board = new five.Board();

board.on("ready", function() {
  var output = new five.Pin(11);
  var input = new five.Sensor.Digital(7);
  var value = 1;

  setInterval(() => {
    output.write(value ^= 1);
  }, 1000);

  input.on("change", state => console.log(state));
});
```

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

overflowz, 2016-06-06:
I'm new on this stuff, I apologize. So you mean if I add two wires at the same position (output and input) changing output value also triggers that input value too, and I can read the state, right?

rwaldron, 2016-06-06:
> So you mean if I add two wires at the same position (output and input) changing output value also triggers that input value too, and I can read the state, right?

Yep, that's exactly right :)

overflowz, 2016-06-06:
Thanks!

rwaldron, 2016-06-06:
No problem :)

overflowz, 2016-06-06:
Instead of opening another topic, I'll write it here anyways. Is it safe to do something like check all output pin states manually within 100ms interval?

overflowz, 2016-06-06:
Well, I'll explain my problem here if you don't mind.
I'm playing with home automation like project, while need real time states.
Let's say, there's a bulb and a switch. When switch is ON, bulb is ON too and vice-versa.
But this bulb also can be changed from the web directly so I would like to attach event directly to OUTPUT (bulb) pin rather than INPUT (switch) one. Is there any other possible ways? I'm kinda limited to additional pins :disappointed:

rwaldron, 2016-06-06:
Before we answer that question... if the bulb can be changed from a switch or from the web, what happens to the switch when the web changes the bulb?

overflowz, 2016-06-06:
switch stays at the same state, it's one-way trigger. I don't know how to explain but I'll try. It has only one state (clicking down) and then jumps back to top.

rwaldron, 2016-06-06:
Ah, I see. That's called a "momentary switch", which is actually falls in the "button" category :)

A few questions:

- Is the momentary switch/button part of the J5 program?
- Is the web based control served from a Node.js program that has the J5 code running?

To be more helpful, I need to know more about the hardware you're using and the big picture program you're trying to create. I have to sign off for the evening, but I will check back in the AM

overflowz, 2016-06-07:
Okay! Have nice evening tho! :-)

1) IT SHOULD. I thought a lot and now I know that it should be handled by J5.
2) Yes!

I'm using Raspberry PI, Arduino Due and NodeJS + J5 only.

Things I'm trying to accomplish:
1) I have 1 button and 1 bulb.
2) When user clicks button, I can't catch event of it, thus I can't know if bulb state changed or not.
3) If user triggers that bulb state (on or off) from the web, then J5 comes in play.

I think these steps should not have any problems. now I thought, can OUTPUT pins exist which is not relying on INPUT ones (except sensors of course)? or is it up to me? If there can be OUTPUT pins which won't rely on INPUT ones, how should I check if their state changes? Like a sensor?

I really apologize for poor explanation, my English skills aren't that perfect nor knowledge of this sphere.

Regards.

soundanalogous, 2016-06-07:
You can use the pin state query to get the state of the output pin. This is not event driven so you'd have to poll. I'm also not sure if this is exposed through J5. It's part of firmata.js which J5 uses to communicate with arduino-compatible boards. You'd do something like this:

```javascript
board.queryPinState(pin, function () {
  console.log("state of pin " + pin + " changed to: " + board.pins[pinToQuery].state);
});
```

overflowz, 2016-06-07:
Question is, is it reliable if I'll use poll like every 100ms on 60+ pins?

soundanalogous, 2016-06-07:
You'd have to stagger your polling.

overflowz, 2016-06-07:
That's not a reliable solution then I guess. Cause if I stage it, the last pin would be checked every 100 x 60 ms :disappointed:

soundanalogous, 2016-06-07:
Not 1 ever 100ms, could be one few ms. It depends on how much other work you application is doing and how much you can squeeze in when communication happens at 57600 baud. There is a proposal open however to enable reporting the state of all pins in one shot. It may be some time before that makes it's way into J5 however as it is just a proposal currently.

overflowz, 2016-06-07:
Uhm, and so much data transfers won't cause any troubles to either controllers? or isn't it a bad practice?

Closed 2016-06-06.

Thread 1155 (2016-06-14):

L298N not working

illogica, 2016-06-14:
I built a small robot with two 5V DC motors. I want to drive them using a L298N and an Arduino Nano clone ([this one](https://www.amazon.it/gp/product/B015MGHH6Q/ref=oh_aui_detailpage_o00_s00?ie=UTF8&psc=1)).
I uploaded the StandardFirmata program in the Nano, using Arduino IDE 1.6.9.
I communicate with the Nano using a JY-MCU bluetooth module (working, node is communicating correctly with the module).
I uploaded the following program:

```
var five = require("johnny-five"), board, motor1, motor2, led;

board = new five.Board();

board.on("ready", function() {
  // Create a new `motor` hardware instance.
  motor1 = new five.Motor({
    pins: {
      pwm:3,
      dir:4,
      cdir: 7
    }
  });

  motor2 = new five.Motor({
    pins: {
      pwm:5,
      dir:8,
      cdir: 12
    }
  });

  motor1.start(124);
  motor2.start(124);

  board.repl.inject({
    motor1: motor1,
    motor2: motor2
  });

  // "start" events fire when the motor is started.
  motor1.on("start", function() {
    console.log("start motors", Date.now());

    // Demonstrate motor stop in 2 seconds
    board.wait(5000, function() {
      motor1.stop();
      motor2.stop();
    });
  });

  // "stop" events fire when the motor is stopped.
  motor1.on("stop", function() {
    console.log(" motors stopped", Date.now());
    motor1.start(200);
  });
});
```

When I launch the program, Node is correctly communicating with the Nano and the console prints meaningful messages, but the PWM outputs don't output  thing and even the direction pins act somewhat randomly.
Out of desperation I uploaded this program into the Arduino:

```
//Code by Reichenstein7 (thejamerson.com), adapted for my application

//Keyboard Controls:
//
// 1 -Motor 1 Left
// 2 -Motor 1 Stop
// 3 -Motor 1 Right
//
// 4 -Motor 2 Left
// 5 -Motor 2 Stop
// 6 -Motor 2 Right

// Declare L298N Dual H-Bridge Motor Controller directly since there is not a library to load.

int SPEED = 255;

// Motor 1
int dir1PinA = 8;
int dir2PinA = 12;
int speedPinA = 5; // Needs to be a PWM pin to be able to control motor speed

// Motor 2
int dir1PinB = 7;
int dir2PinB = 4;
int speedPinB = 3; // Needs to be a PWM pin to be able to control motor speed

void setup() {  // Setup runs once per reset
// initialize serial communication @ 9600 baud:
Serial.begin(9600);

//Define L298N Dual H-Bridge Motor Controller Pins

pinMode(dir1PinA,OUTPUT);
pinMode(dir2PinA,OUTPUT);
pinMode(speedPinA,OUTPUT);
pinMode(dir1PinB,OUTPUT);
pinMode(dir2PinB,OUTPUT);
pinMode(speedPinB,OUTPUT);

}

void loop() {

// Initialize the Serial interface:

if (Serial.available() > 0) {
int inByte = Serial.read();
int speed; // Local variable

switch (inByte) {

//______________Motor 1______________

case '1': // Motor 1 Forward
analogWrite(speedPinA, SPEED);//Sets speed variable via PWM
digitalWrite(dir1PinA, LOW);
digitalWrite(dir2PinA, HIGH);
Serial.println("Motor 1 Forward"); // Prints out “Motor 1 Forward” on the serial monitor
Serial.println("   "); // Creates a blank line printed on the serial monitor
break;

case '2': // Motor 1 Stop (Freespin)
analogWrite(speedPinA, 0);
digitalWrite(dir1PinA, LOW);
digitalWrite(dir2PinA, HIGH);
Serial.println("Motor 1 Stop");
Serial.println("   ");
break;

case '3': // Motor 1 Reverse
analogWrite(speedPinA, SPEED);
digitalWrite(dir1PinA, HIGH);
digitalWrite(dir2PinA, LOW);
Serial.println("Motor 1 Reverse");
Serial.println("   ");
break;

//______________Motor 2______________

case '4': // Motor 2 Forward
analogWrite(speedPinB, SPEED);
digitalWrite(dir1PinB, LOW);
digitalWrite(dir2PinB, HIGH);
Serial.println("Motor 2 Forward");
Serial.println("   ");
break;

case '5': // Motor 1 Stop (Freespin)
analogWrite(speedPinB, 0);
digitalWrite(dir1PinB, LOW);
digitalWrite(dir2PinB, HIGH);
Serial.println("Motor 2 Stop");
Serial.println("   ");
break;

case '6': // Motor 2 Reverse
analogWrite(speedPinB, SPEED);
digitalWrite(dir1PinB, HIGH);
digitalWrite(dir2PinB, LOW);
Serial.println("Motor 2 Reverse");
Serial.println("   ");
break;

default:
// turn all the connections off if an unmapped key is pressed:
for (int thisPin = 2; thisPin < 11; thisPin++) {
digitalWrite(thisPin, LOW);
}
}
}
}
```

This program works, I can command both motors via the Arduino serial monitor, so the hardware is correctly connected and properly working.

Am I looking at a FIrmata problem or Johnny-Five problem?

dtex, 2016-06-14:
Hi @illogica

I don't know much about the Nano or Bluetooth modules, but I know a lot about the motor class and it looks to me like you've done everything right with the setup on that. The only difference between your J5 code and that working example is that the working example always sets the PWM value to 0 or 255. I would expect 124 to work as well, but if the motor power is on the threshold of being just barely enough then it might make a difference though the following statement makes me think that's not the culprit here:

> PWM outputs don't output thing and even the direction pins act somewhat randomly.

How are you measuring the pins to know what's happening (a voltage meter)? Sometimes I like to wire up LED's to the motor pins on my micro-controller so I can literally see what's happening on those pins.

illogica, 2016-06-14:
Hi @dtex , thanks for the prompt reponse.
I'm measuring the PWM output using my voltmeter and I see plain 0.0V. Also tried with an Led straight from the PWM output to ground, but it won't turn on. The value 124 is just to be safe, I tried the motors with a .ino program and they start rotating at about 50.
I don't have my robot with me now, but I think I'll try uploading the StandardFirmataPlus tonight, instead of the StandardFirmata, and see if anything changes.

dtex, 2016-06-14:
StandardFirmata should work, but StandardFirmataPlus is the new recommended install for J5. Did you configure the bluetooth module to work at 57,600 baud?

https://github.com/rwaldron/johnny-five/wiki/Getting-Started-with-Johnny-Five-and-JY-MCU-Bluetooth-Serial-Port-Module

illogica, 2016-06-14:
Yes, I went successfully through the whole AT stuff.
I'm going to try the StandardFirmataPlus now, let's see what happens...

illogica, 2016-06-14:
Another test, even more simple, just one of the two motors:
```
var five = require("johnny-five"), board, motor;

board = new five.Board();

board.on("ready", function() {
  // Create a new `motor` hardware instance.
  motor = new five.Motor({
    pins: {
      pwm:3,
	  dir:4,
	  cdir: 7
    }
  });

  board.repl.inject({
    motor: motor
  });

  // "start" events fire when the motor is started.
  motor.on("start", function() {
    console.log("motor started", Date.now());
  });

  // "stop" events fire when the motor is stopped.
  motor.on("stop", function() {
    console.log(" motor stopped", Date.now());
  });
});
```
So, I just type "motor.start()" at the command line, and all I get is digital outputs 4,7,8,12 on for less than a second, and then go off again. After this the board will still accept REPL commands, but wit no visible effect.
I also tried with another Nano board (I have 5 of them) and the result is the same.

illogica, 2016-06-14:
Replaced the Nano clone with an original Arduino Uno, I obtain the same non-results.

illogica, 2016-06-15:
I think I made some progress. Using the wired connection the J5 program works. Using the Bluetooth adapter (JY-MCU, HC-05) the program works but only for a fraction of a second. I might try with a different bluetooth module (which I don't have).

rwaldron, 2016-08-23:
> I built a small robot with two 5V DC motors. I want to drive them using a L298N and an Arduino > Nano clone (this one).
> I uploaded the StandardFirmata program in the Nano, using Arduino IDE 1.6.9.
> I communicate with the Nano using a JY-MCU bluetooth module (working, node is communicating correctly with the module).

- What is your power source on the Nano side?
- How are you powering the motors?

dtex, 2018-01-16:
Hi @illogica

I'm going to close this since we haven't heard back. Please feel free to re-open if necessary.

Closed 2018-01-16.

Thread 1158 (2016-06-19):

Failure to fully turn off RGB Led strip on exit event

JvanderHeide, 2016-06-19:
**Board:** Arduino Uno
**Shield:** n/a
**Hardware you are having an issue with:** RGB led strip
**Version of Johnny-Five:** 0.9.56
**What your expectations are:**
I expect that calling ``ledRGB.off()`` will turn off the entire RGB led strip when called in an `exit` event handler.
**What the actual outcome is:**
Only the red pin is switched off, green and blue are still on.
**Steps to reproduce (including code samples):**
I'm trying to reset my board to its original state by using the following script:
```javascript
board.on('ready', function(){

  var ledRGB = new five.Led.RGB([ 9, 10, 11 ]);
  ledRGB.color('white');

  this.repl.inject({
    ledRGB: ledRGB
  });

  this.on('exit', function() {
    ledRGB.off();
  });

});
```

When I then proceed to exit via ``^C^C`` or ``.exit``, only pin 9 turns off. Leaving the strip turned on at a blue/green color.

If I call ``ledRGB.off()`` from REPL everything works as expected.

I'm guessing that there's not enough time after the exit event is fired for Johnny Five to turn off all the pins before the connection is closed or is something else going on?

Currently I'm restarting the script once and then quickly ``^C``-ing to reset the board, but I'd love to be able to do it automatically.

rwaldron, 2016-06-20:
Thanks for the report! I'll try to take a look at this today

JvanderHeide, 2016-06-29:
@rwaldron I was wondering if you've had the time to take a look at this issue. I understand if you weren't able to. If you have any pointers on resetting the board in any other way that'd be great.

Thank you very much for your work on Johnny-Five!

rwaldron, 2016-06-29:
@JvanderHeide sorry, I've been swamped working on this: https://learn.sparkfun.com/tutorials/experiment-guide-for-the-johnny-five-inventors-kit which just launched today.

Can you link me to the actual component you're using, described above as "RGB led strip"? Thanks!!

JvanderHeide, 2016-06-29:
Sweet! Looks like a great kit.

---

If I recall correctly it's [this one](http://www.ledstripkoning.nl/led-strips-rgb/losse-ledstrips-rgb/5-meter-150-leds-rgb-led-strip/). The page is in Dutch however. I'm powering it with a separate 12V transformator. Like this (although I have switched the R and B around (R=9,G=10,B=11)):

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

It works like a charm, with the exception of only the red pin turning off when calling `.off()` at an exit event.

rwaldron, 2016-07-02:
TBH, I suspect the issue isn't a software related one, because all the rgb instance is doing in off() is zeroing the PWM signal. If the red channel is staying on it may be that some power source is causing that? I will have to locate the same or similar components and then try to reproduce

rwaldron, 2016-07-02:
Do you think this is suitable: https://www.amazon.com/uxcell®-Package-L7812CV-Positive-Regulators/dp/B00CMQ4O8Y ?

JvanderHeide, 2016-07-02:
@rwaldron there's no power from the Arduino going to the led strip, the MOSFETs are only controlling the ground. And Red is turning off (the first pin of the rgb configuration), hence my assumption that there's not enough time for the other two pins two be shut down in an exit event.

.off() works perfectly fine from repl or in any code but the exit event.

JvanderHeide, 2016-07-02:
Just tried without any components, just measuring the pins using my multimeter, and pins 10 and 11 kept giving their voltage at the moment of exit. Only pin 9 got set to zero volts.

rwaldron, 2016-07-02:
Ok, that's very helpful. I believe you're exactly right w/r to "not enough time". Try this:

```js
// Anywhere inside your board's ready event handler:
this.repl.inject({
  // Make an accessor named "q"
  get q() {
    rgb.off();
    process.nextTick(() => process.exit());
  }
});
```

I didn't test this exact code, but I've used this same mechanism before. Now you can type `q` + `<enter>` to "clean up" and exit.

JvanderHeide, 2016-07-02:
Thank you!  This works and will do 👍

Had to rename my ledRGB in the repl, so that it didn't match the global ledRGB (thus no `ledRGB: ledRGB`) and had to add a `setTimeout` of a few ms around the `process.nextTick(() => process.exit());` (timeouts didn't work with the exit event handler).

rwaldron, 2016-07-05:
Nice! I'm glad we could resolve this :)

Closed 2016-07-02.

Thread 1163 (2016-06-24):

One of the boards to communicate after a few minutes

rodrigoadachi, 2016-06-24:
Hello,
I have two mini Arduino pro USB-connected and communicating to JF5 one nicknamed "A" and the other "B" after a few minutes just one of them (sometimes the The other times B) to communicate without giving errors or reports in board.on ("close", function (), before it was only the board is now B, and always one or the other and it is functioning normally.

Below a piece of my code

```
var five = require('johnny-five');
var ports     = [
    { id: "A", port: "/dev/ttyUSB0" },
    { id: "B", port: "/dev/ttyUSB1" }
];
var board = new five.Boards(ports);
board.on("ready", function(boards) {
  var expanderX20 = new five.Board.Virtual( new five.Expander({ address: 0x20, controller: "PCF8574", board: this.byId("A") }) );
  var jfB01E20P00   = new five.Relay({ board: expanderX20, pin: 0 });
  var jfB01E20P01   = new five.Relay({ board: expanderX20, pin: 1 });
  var jfB01E20P02   = new five.Relay({ board: expanderX20, pin: 2 });
  var jfB01E20P03   = new five.Relay({ board: expanderX20, pin: 3 });
  var jfB01D08  = new five.Button({ isPullup: true, invert: true, holdtime: 1000, pin: 8, board: this.byId("A") });
  var jfB01D10  = new five.Button({ isPullup: false, invert: true, holdtime: 1000, pin: 10, board: this.byId("A")});
  var jfB01D11  = new five.Button({ isPullup: false, invert: true, holdtime: 1000, pin: 11, board: this.byId("A") });
  var jfB01D12  = new five.Button({ isPullup: false, invert: true, holdtime: 1000, pin: 12, board: this.byId("A") });
  var jfB01Led  = new five.Led.RGB({ pins: { red: 6, green: 5, blue: 9, board: this.byId("A") }});
  var jfB02A00  = new five.Sensor({ pin: "A0", freq: 250, threshold: 5, board: this.byId("B") });
  var jfB02D04  = new five.Button({ isPullup: false, invert: false, holdtime: 1000, pin: 4, board: this.byId("B") });
  var jfB02D05  = new five.Button({ isPullup: true, invert: false, holdtime: 500, pin: 5, board: this.byId("B") });
  var jfB02D06  = new five.Button({ isPullup: false, invert: false, holdtime: 500, pin: 6, board: this.byId("B") });
  var jfB02D03  = new five.Relay({ pin: 3, board: this.byId("B") });
  var jfB02D07  = new five.Relay({ pin: 7, board: this.byId("B") });

  jfB01E20P00.off();
  jfB01E20P01.off();
  jfB01E20P02.off();
  jfB01E20P03.off();
  jfB01Led.off();
  jfB02D03.off();
  jfB02D07.off();
});

board.on("close", function() {
    console.log('JohnnyFive board closed')
});

```

Excuse the translation, my default language is Portuguese in Brazil

rodrigoadachi, 2016-07-08:
News

if (board[0].isReady){
	console.log('JF board A : ',board[0].isReady);
}

if (board[1].isReady){
	console.log('JF board B : ',board[1].isReady);
}

I put a setInterval monitoring these guys there and when the board to operate they do not realize

rwaldron, 2016-07-08:
Thanks for the report. I will try to assemble something to reproduce this over the weekend.

Closed 2018-08-28.

Thread 1176 (2016-07-12):

Unable to switch an AC Contactor via Relay

criticalboot, 2016-07-12:
Here is the following scenario

**Setup:**
We are using Atmega644 PA-AU and trying to drive AC Contactors via relays. The relays are based on Johnny-five Relay Class through StandardFirmataEthernetPlus.

ATMega644 (StandardFirmataEhternetPlus + UIPEthernet) ==> ENC28J60 ==> network ==> PC ( J5 + NodeJs + Electorn)

**Problem:**
Please refer the attached schematic as the basis of our setup
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

When we are driving just the relay without AC Loads mentioned at the end of the schematic it works fine with out any issues. As soon as we connect this relay to drive an AC contactor the behavior is erratic meaning the relay works for a few times and stops working with the corresponding leds (led1 and led2 ) hanging up. This also is leading to a MCU freeze.

**Observations:**
H/w and S/w disconnect: We are sending an on()/off() via console of Electron to the Relays. When AC is **NOT** connected the Relays status and the corresponding leds status is in sync. Now with AC Contactor connected to the Relays, the whole setup goes out of sync randomly after any number of ons/offs. Any action via browser does not affect the MCUs status. This is leading us to assume that the MCU is freezing.

As long as the AC load is not connected the system works flawlessly forever. When ever the AC load is connected malfunction occurs. Not sure why.

**Questions:**
1. Is there any thing abnormal in the schematic or connectivity that we have used?
2. Do you think the AC load is causing the MCU freeze up?
3. How do we know/test if J5 is alive?
4. Are we missing some thing here?

**NOTE:
The same setup is working perfectly with Arduino UNO+Ehternet shield.**

nebrius, 2016-07-12:
Are the relays rated for the load your attaching to them?

rwaldron, 2016-07-13:
Thanks for the report!

>  Any action via browser does not affect the MCUs status. This is leading us to assume that the MCU is freezing.

Browser? I think there is a whole layer I'm missing here :\

Also, looking forward to your answer to @nebrius's question, as it will be helpful to determine if this is software issue or not.

(Also, thanks for jumping in @nebrius ❤️ )

criticalboot, 2016-07-16:
Thank you for the response.

@nebrius - Yes, relays are rated at 10A and we are using AC load of less than 1A.

@rwaldron -

> Browser? I think there is a whole layer I'm missing here :\

We are using Electron browser as the front end. This based on Chrome & NodeJS. J5 is added to NodeJS via NPM.
J5 objects are being called from the console of the Electron browser. Eg: Motor object can be called via the console and 'external_contactor' can be toggled to switch on/off the motor/device.

**Setup 1:**
Please refer the image attached to the previous message and the observation still holds good.

MCU = AtMega644PA-AU
Ethernet Module = ENC28J60

**Main issue :** the MCU freezes(?) and LED 1 stops blinking and stays in the same state where it was (on / off) at the time of freeze. When this happens there are no error messages thrown out anywhere giving us no clue as to what is happening.

**Setup 2:**
MCU = AtMega328P-AU
Ethernet Module = Wiz Mini with chip Wiz 5100

The schematic that was attached earlier still holds good except that the MCU and Ethernet module were switched to 328 & Wiz5100.

**Main Issue :** The LED1 stops blinking and remains in the state of on/off, J5 throws two types of errors
1. 'the other party has closed the connection'
2. 'ECONRESET'

The above errors are occuring **ONLY WHEN** the AC load is switched on. But otherwise, this works fine - meaning the relay switches on/off forever without the AC load (in this case the external contactor that we connect to the relay. In another case we connected an incandscent bulb).

**Setup 3:**
Same as Setup 2 minus the Ethernet module; instead used serial connectivity (TTL to USB). One of the lines in the code attached shows that (commented).

**Main Issue :** When the AC load is switched on LED 1 stops blinking and stays in the same state where it was (on / off) at the time of freeze.

**Setup 4:**
This is the barebones setup without J5. We simply burnt the Arduino Blink sketch on the 328 and tried the same thing. This works absolutely fine without any problem forever with the AC load switched on.

**Main Issue :** None

Not sure what is missing here. Could there be a possible hardware issue?. Or do we suspect the software?. Please help us understand if we are missing something here.

I have a suggestion that we can have a quick Skype call to show you the setup and discuss. Please let us know if that works for you.

Please find the code below as a sample for you to get a feel of what we are trying to do.
```

'use strict'
let five = require('johnny-five')
let EtherPort = require('etherport')
let Emitter = require('events').EventEmitter
let util = require('util')
let debug = require('debug')('motor')

let Motor = function (opts) {
  Emitter.call(this)
  // debug(opts)
  this.port = opts.port
  this.id = opts.id
  this.name = opts.name
  this.type = opts.type
  this.class = 'motor'
  this.pin_MOT = 7 // PB3 - external contactor on
  this.isEnabled = false

  this.enableAllPins = () => {
    this.external_contactor = new five.Relay({pin: this.pin_MOT, type: 'NO'})
  }
}

Motor.prototype.create = function () {
  let self = this

  let board = new five.Board({
    // port: '/dev/ttyUSB0'
    port: new EtherPort(this.port),
    repl: false,
    debug: false
  })
  board.on('ready', () => {
    // emit board connected signal.
    self.emit('connected', {})

    // enable all Pins
    self.enableAllPins()

    self.isEnabled = true
  })
}

Motor.prototype.onClick = function () {
  if (this.isEnabled) {
    let self = this
    setInterval(function (self) {
      self.external_contactor.toggle()
    }, 1000, self)
  }
}

util.inherits(Motor, Emitter)
module.exports = Motor
```

criticalboot, 2016-07-16:
We again tried the same setup with different AC power supply points. We thought this could be due to some extraneous current leakages in to the circuit. Even this did not work.

nebrius, 2016-07-18:
Can you try connecting a different, smaller AC load to the relay? This _really_ sounds like a hardware problem to me, given that it works without a load attached.

To isolate the issue a little more, can you write a short dummy app in C using the Arduino IDE that, say, closes the relay for 5 second and then opens it again, just to see if it works that way? If it does, then we'll know for certain if it's a hardware or software issue.

criticalboot, 2016-07-20:
Thank you @nebrius for your post and observations.
Please find below **Setup 4** already posted.
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

As per **Step 4** this seems to be working fine even with AC Loads. Whenever J5 is used to run the setup we are running into this problem. We are also a bit puzzled about this and not able to figure it out if it is a S/W or H/W problem.

**Here is another setup we tried**
**Setup :** This is exactly same as the previous **Setup 1** (as per the old schematic), the only addition being a relay at the end as shown in the schematic attached below.
 This seems to be working absolutely fine even with any amount of AC Load either driving a 200W incandescent bulb or a contactor.
Not sure how to interpret this outcome.

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

**Questions / Issues**

1. The above setup seems to be working with J5. Do you think this is H/W or S/W issue?
2. As per Setup 4, where a simple blink sketch is able to drive the AC loads with out any hitches. Where as the same setup with J5 seems to be failing.

**NOTE**
We have used the standard rated relays throughout our setups. Relay ratings - coil voltage = 5V DC, Load rating = 10A, 230V AC.

Looking forward to hearing your thoughts.

nebrius, 2016-07-20:
Can you try porting the blink sketch to J5 with the same timing and seeing if it's also reliable? It may be possible there is a timing factor at play, either through how often it's being switched, timing relative to startup, or latency in communicating between Node and firmata over serial.

My instinct still says this is hardware related though. I don't know what's going on though, maybe it something with the BJT combined with the initial load surge when the relay is closed causes it to get overloaded or something (I'm totally guessing). If the new dual relay circuit works, can you use that instead?

criticalboot, 2016-08-12:
We have discovered that this was an EMF problem with the relays getting effected switching on any AC load.
This EMF was causing the micro controller to freeze. So it is neither a J5 problem nor a micro controller problem. We have come across lot of people facing the same problems on various blogs and forums. We have been able to overcome this problem using a Solid State Relay.

But surprisingly this problem did not occur with an Arduino Uno board.

Appreciate your help.

Closed 2016-08-12.

Thread 1188 (2016-07-25):

Controlling continuous servo motors crashes my app

alexbudin, 2016-07-25:
HI guys,

My setup is this:
- 2 servo motors, cheap ones - Tower Pro - SG-5010
- one Arduino Uno (with StandardFirmata on it)
- one motor driver shield (AdaFruit Motor Shield v1))

Servos are running on pins 9 and 10 of course.
The motor shield is powered separately from 4xAA Batteries (6V)

I have this bit of code here:

```
var five = require("johnny-five");
var board = new five.Board();

board.on("ready", function() {

   // var servos = new five.Servos([9, 10]);

   // servos[0].to(20);

  var servo1 = new five.Servo({
    pin: 9,
    type: "continuous"
  });

  var servo2 = new five.Servo({
    pin: 10,
    type: "continuous"
  });

  // // Clockwise, top speed.
  servo1.cw(1);
  // // Clockwise, top speed.
  servo2.cw(1);

  setTimeout(function(){
    servo1.cw(0);
  },11000)

});
```

The motors start rotating when i run the code, but if i stop the app and run it again, 3 out of 5 times will not run again, and all i get is one of the motors turning for half a second and then none of them moving.

Also when trying to stop any of them:

```
  setTimeout(function(){
    servo1.cw(0);  // or servo1.stop();
  },11000)

```

The app crashes and i get this:

```
1469468151790 Device(s) /dev/cu.usbmodem31
1469468151797 Connected /dev/cu.usbmodem31
1469468155611 Repl Initialized
>> events.js:141
      throw er; // Unhandled 'error' event
      ^

Error: Port is not open
    at SerialPort.write (/Users/alexandrubn/Documents/work_repos/arduino/node_modules/johnny-five/node_modules/serialport/lib/serialport.js:259:24)
    at Board.analogWrite (/Users/alexandrubn/Documents/work_repos/arduino/node_modules/johnny-five/node_modules/firmata/lib/firmata.js:771:18)
    at Board.servoWrite (/Users/alexandrubn/Documents/work_repos/arduino/node_modules/johnny-five/node_modules/firmata/lib/firmata.js:839:20)
    at Servo.Controllers.Standard.servoWrite.value (/Users/alexandrubn/Documents/work_repos/arduino/node_modules/johnny-five/lib/servo.js:73:17)
    at Servo.to (/Users/alexandrubn/Documents/work_repos/arduino/node_modules/johnny-five/lib/servo.js:287:12)
    at Servo.(anonymous function) [as cw] (/Users/alexandrubn/Documents/work_repos/arduino/node_modules/johnny-five/lib/servo.js:492:17)
    at null._onTimeout (/Users/alexandrubn/Documents/work_repos/arduino/routes/paypal_ipn.js:57:12)
    at Timer.listOnTimeout (timers.js:92:15)

```

So i have 2 problems:
1 - the motors sometime start, sometime don't
2 - if i try to stop one the app crashes.

Can someone please help.

Thank you.

Alex

alexbudin, 2016-07-25:
Forgot to add that this is on a mac OSX. The Arduino UNO is connected via USB cable to my mac.

@rwaldron did more testing and it seems it works fine with ONE MOTOR.
```

var five = require("johnny-five");
var board = new five.Board();

board.on("ready", function() {

   // var servos = new five.Servos([9, 10]);

   // servos[0].to(20);

  var servo1 = new five.Servo({
    pin: 9,
    type: "continuous"
  });

  // var servo2 = new five.Servo({
  //   pin: 10,
  //   type: "continuous"
  // });

  // // Clockwise, top speed.
  servo1.cw(1);
  // // Clockwise, top speed.
  //servo2.cw(1);

  setTimeout(function(){
    servo1.stop();
  },11000)

});
```

And it seems to be working every time i run it.

This is getting so confusing :( I hope someone can help me.

dtex, 2016-07-25:
The servo pins are not powered off the 4 AA batteries, they are using the same 5V supply that drives the Uno (1). At some point the second servo is pushing the total current draw up over 500mA causing the Uno to brown out and be unreachable.

That motor shield power is just for the DC motors or stepper. If you're not going to be using a DC or stepper motor, you don't need the shield at all.

(1) https://learn.adafruit.com/adafruit-motor-shield/power-requirements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.

alexbudin, 2016-07-25:
@dtex I was just reading that now :) So annoying that it doesn't power the servos also.

I was noticing the LED on the driver board dimming a bit after the second one would start.

Thank you Donovan, really helpful.

I will just power them separately and get rid of the board.

Alex

dtex, 2016-07-25:
:+1:

Closed 2016-07-25.

Thread 1212 (2016-08-30):

Device or Firmware Error  [updated]

filyps98, 2016-08-30:
Hi everyone, I'm a new member of github. I've been using Arduino for a year now and I wanted to create a server with the Pi and the UNO. I encountered so many problems maybe because I've bought an OrangePi which is a clone of Raspberry Pi (Yes, I know, i should have bought the original one, but i had to save some money). I' ve installed Debian 8 on it and in order to work with node I also installed  NVM and  I'm currently working with node 6. I installed johnny-five, but it gave me errors regarding serialport; to solve this problem I decided to install serialport without installing johnny-five, but there were errors about node-pre-gyp. So I installed it globally. I started the program called Hello World after uploading StandardFirmata on the arduino (not original either) and after plugging it in one of the  USB ports. The program couldn't start because the cmd was continuously saying "board looking for connected device", the next thing  that I did was looking for the different devices attached to the board and this happened:
                                                                                                                                                                       `[ { comName: '/dev/ttyS0',
    manufacturer: undefined,
    serialNumber: undefined,
    pnpId: undefined,
    vendorId: undefined,
    productId: undefined },
  { comName: '/dev/ttyS2',
    manufacturer: undefined,
    serialNumber: undefined,
    pnpId: undefined,
    vendorId: undefined,
    productId: undefined },
  { comName: '/dev/ttyS3',
    manufacturer: undefined,
    serialNumber: undefined,
    pnpId: undefined,
    vendorId: undefined,
    productId: undefined } ]`

After struggling so much I decided to change the code by defining the port .
I tried all the three ports and the cmd always said:

`1472576273960 Connected /dev/ttyS3
1472576283987 Device or Firmware Error A timeout occurred while connecting to the Board.

Please check that you've properly flashed the board with the correct firmware.
See: https://github.com/rwaldron/johnny-five/wiki/Getting-Started#trouble-shooting

If connecting to a Leonardo or Leonardo clone, press the 'Reset' button on the board, wait approximately 11 seconds for complete reset, then run your program again.
events.js:165
      throw err;
      ^

Error: Uncaught, unspecified "error" event. ([object Object])
    at Board.emit (events.js:163:17)
    at Board.log (/root/node_modules/johnny-five/lib/board.js:625:8)
    at Board.(anonymous function) [as error](/root/node_modules/johnny-five/lib/board.js:636:14)
    at Board.<anonymous> (/root/node_modules/johnny-five/lib/board.js:385:14)
    at tryOnTimeout (timers.js:232:11)
    at Timer.listOnTimeout (timers.js:202:5)`

Thank you for the help. :)

lyzadanger, 2016-08-31:
Hi! There are a number of factors at one time here, so let's break it down.

First, `node-serialport`. Getting this to compile and install successfully is key. When you say:

> So I installed it globally

Does that mean you were successful in compiling and installing `node-serialport` _globally_? What's your global version of Node.js, if so? Is it the same as the version in your local project? Can you provide me the exact version.

I'm not up to speed on `node-serialport`'s support on Debian for whatever architecture your OrangePi is on (it looks like OrangePi has an ARM Cortex V7, which is comparable to a "real" Pi 2 B).

In any case, let's start with: can you provide the exact errors you get when you try to install `johnny-five` (or `node-serialport` directly) and your exact OS and Node.js versions? Thanks!

filyps98, 2016-09-01:
Sorry, but currently I can't connect to the internet with the Pi via ethernet, so I can't provide the errors. If I remember correctly, I installed node v 6.1. something   and I only typed `npm install serialport`, but it gave me errors about node-pre-gyp (It wasn't able to install it). I decided to install this module by myself and I did that by typing `npm install node-pre-gyp -g` . I'll give more information when I manage to solve the connection problem.

lyzadanger, 2016-09-01:
@filyps98 Sounds like you've got a pile of struggles with the Pi beyond the Johnny-Five (and `node-serialport` dependency) problems you're running into. Do you want to reconnect once you've got the Pi more stable and connected and can provide error output?

Have you tried running raspbian on that Pi? I presume you have a reason to run Debian but am curious.

filyps98, 2016-09-01:
Yeah, I tried with raspbian, but it wasn't the official version, it was adapted for the orange (don't know if it changes anything) and I wasn't able to install a version of node higher than 0.10 . I'll try another time with debian and then I'll change to raspbian. Debian is behaving in a really strange way right now. Thank you.

rwaldron, 2016-09-01:
@reconbot @beriberikix ping

beriberikix, 2016-09-01:
I haven't used Orange Pis myself but they're notorious for having poor driver support and other wonkiness due to out of date OS images. First - which board and exact image did you use? Have you looked at [Armbian](http://www.armbian.com/)?

Another trick I try for new devboards is try to get the Arduino IDE working. There's usually workarounds to find online and a good litmus test for the Serial driver.

filyps98, 2016-09-01:
I have an orange pi PC, the OS that I've tried are: Debian Jessie minimal and Raspbian (which has Arduino IDE installed). I've never installed Armbian. Should I try to make Arduino work with this old version of raspbian and with the Arduino IDE before working with node? Should I install armbian after having tried?

beriberikix, 2016-09-01:
If you can program an arduino from either build, that means serial is working. If so, Armbian may not be necessary. Did you try flashing using the IDE?

filyps98, 2016-09-01:
I tried with raspbian, but it doesn't work because the OS doesn't have USBtoSerial. I've only used the terminal with Debian Jessie (which does have it) and I didn't manage to switch to the desktop,  so I wasn't able to run or download Arduino. Moreover I can't succeed in accessing via ssh the pi now, it is like the pi doesn't connect to my network...i don't know if this is a problem of firmware or hardware. So much struggle.

beriberikix, 2016-09-01:
Hmm...the latest Raspbian definitely has support for usb to serial and Arduinos. It also has `serial` support, but that may need to be enabled via [`raspi-config`](https://www.raspberrypi.org/documentation/configuration/raspi-config.md). It is hard to tell what is enabled because it looks like the fork [hosted by Orange Pi](http://www.orangepi.org/downloadresources/) for the Orange Pi PC is very old. You can run Arduino with the [official CLI](https://github.com/arduino/Arduino/blob/master/build/shared/manpage.adoc) without the need for the desktop.

Sounds frustrating! Do you happen to have a [TTL cable](https://www.adafruit.com/products/954)? That would get around your networking issues.

filyps98, 2016-09-01:
The orange version of raspbian is really bad. From what I read in the orangepi forum, some users complain about the fact that this OS is totally different from the real one and it doesn't have some important features, so I opted for Linux which is said to be more complete. I tried to connect the Pi to the router with Ethernet in order to get internet (which is necessary for installing buildessential and node) and IT WORKED...for a while. Unfortunately not anymore, the Ethernet port of the pi seems working and the router recognizes the device, but my main computer doesn't see its ip and consequently I cannot work via ssh.

filyps98, 2016-09-01:
When I manage to access internet, I'll surely try to install Arduino. However thanks for helping me very much!!!

filyps98, 2016-09-06:
I managed to solve all the problems that I had except for Johnny-Five. I installed node v6.5.0 and npm v3.10.3. These is what i did and the output.

```
root@OrangePI:~# mkdir nodebot && cd nodebot;
root@OrangePI:~/nodebot# npm install johnny-five;

> serialport@4.0.1 install /root/nodebot/node_modules/serialport
> node-pre-gyp install --fallback-to-build

node-pre-gyp ERR! Tried to download: https://github.com/EmergingTechnologyAdvisors/node-serialport/releases/download/4.0.1/serialport-v4.0.1-node-v48-linux-arm.tar.gz
node-pre-gyp ERR! Pre-built binaries not found for serialport@4.0.1 and node@6.5.0 (node-v48 ABI) (falling back to source compile with node-gyp)
gyp WARN download NVM_NODEJS_ORG_MIRROR is deprecated and will be removed in node-gyp v4, please use NODEJS_ORG_MIRROR
gyp WARN download NVM_NODEJS_ORG_MIRROR is deprecated and will be removed in node-gyp v4, please use NODEJS_ORG_MIRROR
gyp WARN download NVM_NODEJS_ORG_MIRROR is deprecated and will be removed in node-gyp v4, please use NODEJS_ORG_MIRROR
make: Entering directory '/root/nodebot/node_modules/serialport/build'
  CXX(target) Release/obj.target/serialport/src/serialport.o
  CXX(target) Release/obj.target/serialport/src/serialport_unix.o
  CXX(target) Release/obj.target/serialport/src/serialport_poller.o
  SOLINK_MODULE(target) Release/obj.target/serialport.node
  COPY Release/serialport.node
make: Leaving directory '/root/nodebot/node_modules/serialport/build'
/root/nodebot
└─┬ johnny-five@0.10.0
  ├── browser-serialport@2.0.3
  ├─┬ chalk@1.1.3
  │ ├── ansi-styles@2.2.1
  │ ├── escape-string-regexp@1.0.5
  │ ├─┬ has-ansi@2.0.0
  │ │ └── ansi-regex@2.0.0
  │ ├── strip-ansi@3.0.1
  │ └── supports-color@2.0.0
  ├── color-convert@1.2.2
  ├── ease-component@1.0.0
  ├── es6-shim@0.35.1
  ├── firmata@0.14.1
  ├── lodash.clonedeep@4.5.0
  ├── lodash.debounce@4.0.8
  ├── nanotimer@0.3.10
  ├─┬ serialport@4.0.1
  │ ├── bindings@1.2.1
  │ ├─┬ commander@2.9.0
  │ │ └── graceful-readlink@1.0.1
  │ ├─┬ debug@2.2.0
  │ │ └── ms@0.7.1
  │ ├── es6-promise@3.2.1
  │ ├── nan@2.4.0
  │ ├─┬ node-pre-gyp@0.6.29
  │ │ ├─┬ mkdirp@0.5.1
  │ │ │ └── minimist@0.0.8
  │ │ ├─┬ nopt@3.0.6
  │ │ │ └── abbrev@1.0.9
  │ │ ├─┬ npmlog@3.1.2
  │ │ │ ├─┬ are-we-there-yet@1.1.2
  │ │ │ │ ├── delegates@1.0.0
  │ │ │ │ └─┬ readable-stream@2.1.4
  │ │ │ │   ├── buffer-shims@1.0.0
  │ │ │ │   ├── core-util-is@1.0.2
  │ │ │ │   ├── inherits@2.0.1
  │ │ │ │   ├── isarray@1.0.0
  │ │ │ │   ├── process-nextick-args@1.0.7
  │ │ │ │   ├── string_decoder@0.10.31
  │ │ │ │   └── util-deprecate@1.0.2
  │ │ │ ├── console-control-strings@1.1.0
  │ │ │ ├─┬ gauge@2.6.0
  │ │ │ │ ├── aproba@1.0.4
  │ │ │ │ ├── has-color@0.1.7
  │ │ │ │ ├── has-unicode@2.0.1
  │ │ │ │ ├── object-assign@4.1.0
  │ │ │ │ ├── signal-exit@3.0.0
  │ │ │ │ ├─┬ string-width@1.0.1
  │ │ │ │ │ ├─┬ code-point-at@1.0.0
  │ │ │ │ │ │ └── number-is-nan@1.0.0
  │ │ │ │ │ └─┬ is-fullwidth-code-point@1.0.0
  │ │ │ │ │   └── number-is-nan@1.0.0
  │ │ │ │ ├─┬ strip-ansi@3.0.1
  │ │ │ │ │ └── ansi-regex@2.0.0
  │ │ │ │ └── wide-align@1.1.0
  │ │ │ └── set-blocking@2.0.0
  │ │ ├─┬ rc@1.1.6
  │ │ │ ├── deep-extend@0.4.1
  │ │ │ ├── ini@1.3.4
  │ │ │ ├── minimist@1.2.0
  │ │ │ └── strip-json-comments@1.0.4
  │ │ ├─┬ request@2.73.0
  │ │ │ ├── aws-sign2@0.6.0
  │ │ │ ├── aws4@1.4.1
  │ │ │ ├─┬ bl@1.1.2
  │ │ │ │ └─┬ readable-stream@2.0.6
  │ │ │ │   ├── core-util-is@1.0.2
  │ │ │ │   ├── inherits@2.0.1
  │ │ │ │   ├── isarray@1.0.0
  │ │ │ │   ├── process-nextick-args@1.0.7
  │ │ │ │   ├── string_decoder@0.10.31
  │ │ │ │   └── util-deprecate@1.0.2
  │ │ │ ├── caseless@0.11.0
  │ │ │ ├─┬ combined-stream@1.0.5
  │ │ │ │ └── delayed-stream@1.0.0
  │ │ │ ├── extend@3.0.0
  │ │ │ ├── forever-agent@0.6.1
  │ │ │ ├─┬ form-data@1.0.0-rc4
  │ │ │ │ └── async@1.5.2
  │ │ │ ├─┬ har-validator@2.0.6
  │ │ │ │ ├─┬ chalk@1.1.3
  │ │ │ │ │ ├── ansi-styles@2.2.1
  │ │ │ │ │ ├── escape-string-regexp@1.0.5
  │ │ │ │ │ ├─┬ has-ansi@2.0.0
  │ │ │ │ │ │ └── ansi-regex@2.0.0
  │ │ │ │ │ ├─┬ strip-ansi@3.0.1
  │ │ │ │ │ │ └── ansi-regex@2.0.0
  │ │ │ │ │ └── supports-color@2.0.0
  │ │ │ │ ├─┬ is-my-json-valid@2.13.1
  │ │ │ │ │ ├── generate-function@2.0.0
  │ │ │ │ │ ├─┬ generate-object-property@1.2.0
  │ │ │ │ │ │ └── is-property@1.0.2
  │ │ │ │ │ ├── jsonpointer@2.0.0
  │ │ │ │ │ └── xtend@4.0.1
  │ │ │ │ └─┬ pinkie-promise@2.0.1
  │ │ │ │   └── pinkie@2.0.4
  │ │ │ ├─┬ hawk@3.1.3
  │ │ │ │ ├── boom@2.10.1
  │ │ │ │ ├── cryptiles@2.0.5
  │ │ │ │ ├── hoek@2.16.3
  │ │ │ │ └── sntp@1.0.9
  │ │ │ ├─┬ http-signature@1.1.1
  │ │ │ │ ├── assert-plus@0.2.0
  │ │ │ │ ├─┬ jsprim@1.3.0
  │ │ │ │ │ ├── extsprintf@1.0.2
  │ │ │ │ │ ├── json-schema@0.2.2
  │ │ │ │ │ └── verror@1.3.6
  │ │ │ │ └─┬ sshpk@1.8.3
  │ │ │ │   ├── asn1@0.2.3
  │ │ │ │   ├── assert-plus@1.0.0
  │ │ │ │   ├── dashdash@1.14.0
  │ │ │ │   ├── ecc-jsbn@0.1.1
  │ │ │ │   ├── getpass@0.1.6
  │ │ │ │   ├── jodid25519@1.0.2
  │ │ │ │   ├── jsbn@0.1.0
  │ │ │ │   └── tweetnacl@0.13.3
  │ │ │ ├── is-typedarray@1.0.0
  │ │ │ ├── isstream@0.1.2
  │ │ │ ├── json-stringify-safe@5.0.1
  │ │ │ ├─┬ mime-types@2.1.11
  │ │ │ │ └── mime-db@1.23.0
  │ │ │ ├── node-uuid@1.4.7
  │ │ │ ├── oauth-sign@0.8.2
  │ │ │ ├── qs@6.2.0
  │ │ │ ├── stringstream@0.0.5
  │ │ │ ├── tough-cookie@2.2.2
  │ │ │ └── tunnel-agent@0.4.3
  │ │ ├─┬ rimraf@2.5.3
  │ │ │ └─┬ glob@7.0.5
  │ │ │   ├── fs.realpath@1.0.0
  │ │ │   ├─┬ inflight@1.0.5
  │ │ │   │ └── wrappy@1.0.2
  │ │ │   ├── inherits@2.0.1
  │ │ │   ├─┬ minimatch@3.0.2
  │ │ │   │ └─┬ brace-expansion@1.1.5
  │ │ │   │   ├── balanced-match@0.4.1
  │ │ │   │   └── concat-map@0.0.1
  │ │ │   ├─┬ once@1.3.3
  │ │ │   │ └── wrappy@1.0.2
  │ │ │   └── path-is-absolute@1.0.0
  │ │ ├── semver@5.2.0
  │ │ ├─┬ tar@2.2.1
  │ │ │ ├── block-stream@0.0.9
  │ │ │ ├─┬ fstream@1.0.10
  │ │ │ │ └── graceful-fs@4.1.4
  │ │ │ └── inherits@2.0.1
  │ │ └─┬ tar-pack@3.1.4
  │ │   ├─┬ fstream@1.0.10
  │ │   │ ├── graceful-fs@4.1.4
  │ │   │ └── inherits@2.0.1
  │ │   ├─┬ fstream-ignore@1.0.5
  │ │   │ ├── inherits@2.0.1
  │ │   │ └─┬ minimatch@3.0.2
  │ │   │   └─┬ brace-expansion@1.1.5
  │ │   │     ├── balanced-match@0.4.1
  │ │   │     └── concat-map@0.0.1
  │ │   ├─┬ once@1.3.3
  │ │   │ └── wrappy@1.0.2
  │ │   ├─┬ readable-stream@2.1.4
  │ │   │ ├── buffer-shims@1.0.0
  │ │   │ ├── core-util-is@1.0.2
  │ │   │ ├── inherits@2.0.1
  │ │   │ ├── isarray@1.0.0
  │ │   │ ├── process-nextick-args@1.0.7
  │ │   │ ├── string_decoder@0.10.31
  │ │   │ └── util-deprecate@1.0.2
  │ │   └── uid-number@0.0.6
  │ └─┬ object.assign@4.0.4
  │   ├─┬ define-properties@1.1.2
  │   │ └── foreach@2.0.5
  │   ├── function-bind@1.1.0
  │   └── object-keys@1.0.11
  └── temporal@0.5.0

npm WARN enoent ENOENT: no such file or directory, open '/root/nodebot/package.json'
npm WARN nodebot No description
npm WARN nodebot No repository field.
npm WARN nodebot No README data
npm WARN nodebot No license field.
```

reconbot, 2016-09-13:
@filyps98 that looks like it installed successfully

rwaldron, 2016-09-13:
👍

dtex, 2018-01-05:
@filyps98 Please feel free to reopen if you are still having an issue.

Closed 2018-01-05.

Thread 1220 (2016-09-11):

Multi arduino issue

drj-io, 2016-09-11:
### Board:
2x Arduino Mega boards
### Shield:
Spark fun big easy driver
https://www.sparkfun.com/products/12859

### Hardware you are having an issue with:
Steppers

### Version of Johnny-Five:
Tested with 0.10.0

### What your expectations are:
Trying to use 2 different boards with Johnny Five, but it always uses the same board.

### What the actual outcome is:
It always uses the same board, usually the first one that was plugged in.

Steps to reproduce (including code samples):
```javascript
var serialport = require('serialport');
var five = require('johnny-five');

serialport.list(function(err,ports){
    var connected_boards = [];
    console.log(ports);
   var ii = 0;
    ports.forEach(function(port,i){
      ii++;
      if(port.manufacturer == 'Arduino (www.arduino.cc)'){
        connected_boards.push({id: "a"+ii, repl:false});
      }
    });
    var boards = new five.Boards(connected_boards);
    boards.on("ready", function() {
      this.each(function(board){
        console.log("-->",board.io.firmware.name)

        if(board.io.firmware.name=="blue.ino"){
          var stepper = new five.Stepper({
            type: five.Stepper.TYPE.DRIVER,
            stepsPerRev: 3200,
            pins: [23,22]
          });
          stepper.rpm(180).ccw().step(6200, function(){
            console.log("ok, turned the knob on ", board.io.firmware.name,"arduino")
          });
        }
      })
    });
  })
```

Using this code, I have 2 arduino's attached (firmware "blue.no" and "red.ino" respectively).  When I run it the first time "red.ino" turns the stepper attached to it.  If I change "blue.ino" to "red.ino", red.ino turns the stepper on the same port.

I can get this to flip by unplugging both devices and plugging them back in in a different order.

arduino with "blue.ino" firmware
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

arduino with "red.ino" firmware
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

 Output:
```
> node app2.js
[ { comName: '/dev/cu.Bluetooth-Incoming-Port',
    manufacturer: undefined,
    serialNumber: undefined,
    pnpId: undefined,
    locationId: undefined,
    vendorId: undefined,
    productId: undefined },
  { comName: '/dev/cu.DavidsiPhone-WirelessiAP',
    manufacturer: undefined,
    serialNumber: undefined,
    pnpId: undefined,
    locationId: undefined,
    vendorId: undefined,
    productId: undefined },
  { comName: '/dev/cu.usbmodem1411',
    manufacturer: 'Arduino (www.arduino.cc)',
    serialNumber: '75533343336351407141',
    pnpId: undefined,
    locationId: '0x14100000',
    vendorId: '0x2341',
    productId: '0x0042' },
  { comName: '/dev/cu.usbmodem1421',
    manufacturer: 'Arduino (www.arduino.cc)',
    serialNumber: '95335343036351304162',
    pnpId: undefined,
    locationId: '0x14200000',
    vendorId: '0x2341',
    productId: '0x0042' } ]
1473621527904 Device(s) /dev/cu.usbmodem1411,/dev/cu.usbmodem1421
1473621527915 Connected /dev/cu.usbmodem1411
1473621527916 Device(s) /dev/cu.usbmodem1421
1473621527917 Connected /dev/cu.usbmodem1421
1473621530609 Board ID:  a3
1473621530609 Board ID:  a4
--> blue.ino
--> red.ino
ok
```

rwaldron, 2016-09-11:
All component instantistions must have the `board` property explicitly set:

```Js
         var stepper = new five.Stepper({
            board: board, // <--- as named in your code above
            type: five.Stepper.TYPE.DRIVER,
            stepsPerRev: 3200,
            pins: [23,22]
          });
```

... Otherwise J5 defaults to the first board created and stored in its internal cache. This is only necessary when using multiple boards.

drj-io, 2016-09-11:
Easy thanks!

rwaldron, 2016-09-11:
No problem! :)

Closed 2016-09-11.

Thread 1245 (2016-10-24):

Ping HC-SR04 timeout error

gpaixao, 2016-10-24:
I'm work with HC-SR04 and my connections is:

Board:GND -> Sensor:GND
Board:˜10(PWM) -> Sensor:Trig
Board:˜9(PWM) -> Sensor:Echo
Board:5V -> Sensor:Vcc

 I searched for instructions but found nothing plausible. Anyone, can you help me? pls 😄
### My log error

```
daybot node server.js                                                                                                                                              node6.4.0  go1.6  ruby-2.3.0
1477330214600 Connected /dev/cu.usbmodem1421
1477330224607 Device or Firmware Error A timeout occurred while connecting to the Board.

Please check that you've properly flashed the board with the correct firmware.
See: https://github.com/rwaldron/johnny-five/wiki/Getting-Started#trouble-shooting

If connecting to a Leonardo or Leonardo clone, press the 'Reset' button on the board, wait approximately 11 seconds for complete reset, then run your program again.
events.js:165
      throw err;
      ^

Error: Uncaught, unspecified "error" event. ([object Object])
    at Board.emit (events.js:163:17)
    at Board.log (/Users/guilhermepaixao/Projects/src/github.com/gpaixao/daybot/node_modules/johnny-five/lib/board.js:630:8)
    at Board.(anonymous function) [as error] (/Users/guilhermepaixao/Projects/src/github.com/gpaixao/daybot/node_modules/johnny-five/lib/board.js:641:14)
    at Board.<anonymous> (/Users/guilhermepaixao/Projects/src/github.com/gpaixao/daybot/node_modules/johnny-five/lib/board.js:390:14)
    at tryOnTimeout (timers.js:232:11)
    at Timer.listOnTimeout (timers.js:202:5)
```

rwaldron, 2016-10-24:
The error has nothing specifically to do with HCSR04. Here's a few things to do and try:

1. If you're using an Arduino, you absolutely **must** have `PingFirmata` uploaded to the board. See [johnny-five.io/api/proximity/#pingfirmata](http://johnny-five.io/api/proximity/#pingfirmata) for more information there.
2. Make sure your wiring matches this example: http://johnny-five.io/examples/proximity-hcsr04/

gpaixao, 2016-10-24:
tks

rwaldron, 2016-11-17:
Any update?

gpaixao, 2016-11-18:
Sorry but I lost my Arduino :/

rwaldron, 2016-11-18:
Oh no! That's awful :(

I'm going to close this for now, we can reopen it in the future if you ever need to.

Closed 2016-11-18.

Thread 1246 (2016-10-31):

pin.read() always returns 1.

derencel20, 2016-10-31:
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

I connected my pin #11 to a DUAL QUAD-INPUT NAND GATE (in it's output Y1), specifically HD74SLS20P (see DIAGRAM for Y1). I think that when the NAND gate's output becomes false, it should return 0, but it doesn't.

derencel20, 2016-10-31:
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
When Y1 returns 0, shouldn't digital read also return 0?

rwaldron, 2016-10-31:
> When Y1 returns 0, shouldn't digital read also return 0?

Yes, absolutely—but it's not clear that all conditions are being met. What are 1A, 1B, 1C and 1D connected to? They must all be "on" for a 1Y to have a value of 0. Otherwise the result is always 1:

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

Side-note: Google produces no results when searching for "HD74SLS20P", can you link to it?

derencel20, 2016-10-31:
it should be all lower case for google to have results.. hahaha. hd74ls20p

derencel20, 2016-10-31:
Here's the link.
http://pdf1.alldatasheet.com/datasheet-pdf/view/247370/RENESAS/HD74LS20P.html

derencel20, 2016-10-31:
Here's the schematic:

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

What i want to do is read the output of the nand gate.

Here's the actual connection. (The NAND gate in the schematic is on RIGHT breadboard and the inputs on the LEFT of the NAND gate)

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

derencel20, 2016-10-31:
The NAND gates purpose is that it'll make the LOAD's state 0. So that the 74190N will reset counting to it's preset value.

rwaldron, 2016-10-31:
Do you have a multimeter or logic analyzer? If so, can you analyze the 1Y pin and confirm that it's in the expected state when the code produces wrong values?

derencel20, 2016-10-31:
I can confirm. Y1 is connect connected both to the pin #11 and the LOAD inputs of the two counters

rwaldron, 2016-10-31:
Sorry, that's not what I was asking. Do you have the means to measure the actual output voltage of Y1?

derencel20, 2016-10-31:
No. T_T

rwaldron, 2016-10-31:
I'm trying to understand the output voltage for that chip. The datasheet appears to have very low voltage outputs. Also, this chip appears to be EOL https://www.renesas.com/en-us/products/general-purpose-logic/hd74ls/device/HD74LS20P.html

rwaldron, 2016-10-31:
From arduino docs:

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

Maybe I'm misunderstanding the datasheet...?

derencel20, 2016-11-01:
Wait sir. I'm getting the output of the counter which is sn74ls190n.

derencel20, 2016-11-01:
maybe, the voltage is always higher than 3V?

derencel20, 2016-11-01:
I am currently using this.

derencel20, 2016-11-01:
What IC could you suggest sir? for dual quad-input NAND gate IC?

derencel20, 2016-11-01:
Is this related to the problem? It's stating something like `decoupling capacitors`.

derencel20, 2016-11-01:
http://www.doctronics.co.uk/4012.htm

derencel20, 2016-11-03:
My teacher said it has something to do with propagation delay. How can I handle this?

rwaldron, 2016-11-03:
I've ordered a pack of dual 4-input Positive NAND gates to reproduce your circuit.

rwaldron, 2016-11-16:
Sorry for the delay getting back to you. I received only one 7420 (I thought I had ordered a pack of 5 0_o) but it's enough to work with. As I begin to build a reproduction of your issue, the first thing I've noticed is the timing in the call to `this.loop`:

```js
  this.loop(500, () => {
    setTimeout(() => {
      clk.high();
    }, 500);
    setTimeout(() => {
      clk.low();
    }, 500);
  });
```

I'd like some clarification about this, but if I had to guess, I'd say that the intention is to create a 1Hz clock (500ms High, 500ms Low)? Whether or not that's the intention, the code above tick is executing the `clk.high()` and `clk.low()` calls in the same millisecond. To illustrate, I changed the code to:

```js
  let count = 0;
  this.loop(500, () => {
    count++;
    setTimeout(() => {
      console.log(`${count} high ${Date.now()}`);
      clk.high();
    }, 500);
    setTimeout(() => {
      console.log(`${count} low ${Date.now()}`);
      clk.low();
    }, 500);
  });
```

And here is the result:

```
$ node eg/pin-read-1246.js
1479308837162 Device(s) /dev/cu.usbmodem1411
1479308837171 Connected /dev/cu.usbmodem1411
1479308838758 Repl Initialized
>> 1 high 1479308839766
1 low 1479308839766
2 high 1479308840266
2 low 1479308840266
3 high 1479308840767
3 low 1479308840767
4 high 1479308841268
4 low 1479308841268
5 high 1479308841768
5 low 1479308841768
6 high 1479308842269
6 low 1479308842269
```

_(Note that there is a drift of approximately 1 millisecond, [here is further explanation](https://github.com/nodejs/node/blob/master/doc/topics/event-loop-timers-and-nexttick.md))_

The results above show that the calls are happening one right after the other in the same millisecond, but the `clk.high()` instruction is applied for less than that millisecond, because the `clk.low()` instruction immediately changes the state.

My next steps:

1. Reproduce with your original code
2. Determine a path forward the produces the results you're expecting.

rwaldron, 2016-11-16:
> 1. Reproduce with your original code

I quickly determined that I wouldn't be able to reproduce the entire circuit without the other ICs, but I could easily write a simulator. The following program writes the appropriate values for each state in the truth table and verifies that the expected output is received.

```js
"use strict";
const five = require("johnny-five");
const board = new five.Board();

board.on("ready", function() {
  const a = new five.Pin(2);
  const b = new five.Pin(3);
  const c = new five.Pin(4);
  const d = new five.Pin(5);
  const output = new five.Pin(11);

  const tests = [
    //         DCBA
    { input: 0b0000, output: 1 },
    { input: 0b0001, output: 1 },
    { input: 0b0010, output: 1 },
    { input: 0b0011, output: 1 },
    { input: 0b0100, output: 1 },
    { input: 0b0101, output: 1 },
    { input: 0b0110, output: 1 },
    { input: 0b0111, output: 1 },
    { input: 0b1000, output: 1 },
    { input: 0b1001, output: 1 },
    { input: 0b1010, output: 1 },
    { input: 0b1011, output: 1 },
    { input: 0b1100, output: 1 },
    { input: 0b1101, output: 1 },
    { input: 0b1110, output: 1 },
    { input: 0b1111, output: 0 },
  ];

  let isAwaitingRead = false;
  let index = -1;
  let expecting = -1;

  this.loop(500, () => {
    ++index;

    if (index === tests.length) {
      index = 0;
    }
    isAwaitingRead = true;

    let test = tests[index];

    a.write(test.input & 1);
    b.write((test.input >> 1) & 1);
    c.write((test.input >> 2) & 1);
    d.write((test.input >> 3) & 1);

    expecting = test.output;
  });

  output.read((error, value) => {
    if (isAwaitingRead && expecting === value) {
      console.log(`${index}, ${tests[index].output}, ${value}`, tests[index].output === value ? "PASS" : "FAIL");
      isAwaitingRead = false;
    }
  });
});
```

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

Here is the resulting output from a test run: https://gist.github.com/rwaldron/116c21231102707647e87670ef271d6d

I believe the timing in the loop function may be the cause of your unexpected output from 1Y.

derencel20, 2016-11-16:
I had a chat with my teacher regarding this, and he said, I used too much ICs. hahaha. That may be the reason as to how the reading detects very low voltage..

derencel20, 2016-11-16:
I used two SN74LS47N, one HD74LS190N, one SN74LS190N, one HD74LS20P, and one HD74LS04P.

With this configuration:
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

derencel20, 2016-11-16:
And additional two COMMON ANODE - SEVEN SEGMENT LED DISPLAY, and 3 led lights.

derencel20, 2016-12-04:
@rwaldron Is it required to upload the code everytime I use it? Because if I use the default arduino IDE to upload the C syntax code, I only have to upload it once.

I followed the instructions here: https://www.youtube.com/watch?v=8s2--hfsJDY&t=653s

derencel20, 2016-12-04:
Whereas, If I upload the firmata, I have to upload the code everytime I use it.

rwaldron, 2016-12-05:
> Whereas, If I upload the firmata, I have to upload the code everytime I use it.

I don't know what you mean here? Uploading StandardFirmata to the Arduino only happens once. When using Johnny-Five with an Arduino, your JavaScript program runs on your local computer and communicates via a serial port. Alternatively, you can use a Tessel 2, Raspberry Pi, BeagleBone Black, Intel Edison or Joule, if you want to run the code on the board itself.

derencel20, 2016-12-06:
Yeah, I want to store the code in the board itself. I observe that once I restart the board, it flashes all the info. Is this behavior normal ?

rwaldron, 2016-12-06:
> Yeah, I want to store the code in the board itself.

The JavaScript code? That's not possible when using Johnny-Five with an Arduino. As I mentioned above, you'd need to use a board that runs Linux and Node.js, ie: Tessel 2, Raspberry Pi, BeagleBone Black, Intel Edison or Joule, Chip,

> I observe that once I restart the board, it flashes all the info.

I don't really follow—do you mean everytime you run your JS code locally? If so, then that's not flashing the board, it's making a serial connection

dtex, 2018-01-16:
@derencel20 I'm going to close this since we haven't heard back. Feel free to re-open if necessary.

Closed 2018-01-16.

Thread 1252 (2016-11-23):

More than one "Multi" I2C device connected in the same I2C bus

aabm00, 2016-11-23:
Hi

The SHT31-D temperature and humidity sensor has two I2C addresses. Can I connect both of them in the same I2c bus in an Arduino Yun?

I would want to connect in the same I2C bus not only the two SHT31-D but 4 PT-100 amplifier (still looking for) so it would be nice to have some examples where shows how to connect more than one "Multi" device (same type or differents) in the same I2C bus with J5 directly in an Arduino board

Thanks

soundanalogous, 2016-11-23:
As long as each I2C device has a unique address, you should be able to connect up to 16 devices to a single I2C port on a board. Of course bandwidth may be an issue as the number of devices increases, but 2 should be no problem. You will need to add a couple of pull-up resistors unless they are already included on each I2C module you are attaching. See the second answer [here for a wiring diagram](http://electronics.stackexchange.com/questions/25278/how-to-connect-multiple-i2c-interface-devices-into-a-single-pin-a4-sda-and-a5).

rwaldron, 2016-11-23:
@soundanalogous thanks!

To illustrate:

```js
var a = new five.Multi({ controller: "SHT31D", address: 0x44 });
var b = new five.Multi({ controller: "SHT31D", address: 0x45 });
```

For the second to work, you'll need to connect the ADDR pin to a HIGH voltage

aabm00, 2016-11-24:
Thanks you both @soundanalogous and @rwaldron for the answers.

Sorry, I know that the post is closed but I have found another problem related with.
As I mentioned I need four PT-100 amplifier but the only I have found was the MAX31865 https://www.adafruit.com/products/3328 and it uses only the SPI protocol.
Looking for information about how to implement it in J5 seems that Firmata doesn't still support the SPI protocol, so some questions came up.

1- ¿There are some way to do it, if finally I can't find an I2C PT-100 amplifier?
2- ¿Can I have UART, SPI and I2C devices connected to the same arduino board (In my case YUN) working together?

Thanks again

soundanalogous, 2016-11-24:
You can have UART, SPI and I2C all connected simultaneously. Firmata won't have SPI support until I get some help on the Firmata SPI proposal: https://github.com/firmata/protocol/pull/27. I really need an expert in SPI to weigh in. It's not as easy to support as I2C because it's not as standardized as I2C and thus there are several edge cases making it very difficult to support in the generic way that Firmata needs.

aabm00, 2016-11-25:
Thanks !!!

I hope that soon someone will help you with the implementation. So the range of devices that can be used is broader.

Good luck

Closed 2016-11-23.

Thread 1253 (2016-11-28):

SHT31D hygrometer / thermometer: always return same values

balda, 2016-11-28:
There's a bug in [SHT31D](https://www.adafruit.com/products/2857) hygrometer / thermometer: it only return first measures. So, `on("changed")` is never called. Measures are "good" when the script is launched, but never change :/ (that's the bug).

Reading Adafruit driver (https://github.com/adafruit/Adafruit_SHT31/blob/master/Adafruit_SHT31.cpp#L69), there's 2 differences:

- i2c write in `SHT31_MEAS_HIGHREP` register (J5 const is `MEASURE_HIGH_REPEATABILITY`) is made before ***each*** read.
- a delay of `500ms` is made before reading values.

J5 SHT31D driver repeatedly read on i2c (`io.i2cRead(address, READLENGTH,  ...`), without "reseting" register (https://github.com/rwaldron/johnny-five/blob/master/lib/imu.js#L117)

I made some update to make it work:

```javascript
SHT31D = {
    // ...
    initialize: {
        value: function(board, opts) {
            var io = board.io;
            var address = opts.address || this.ADDRESSES[0];

            opts.address = address;
            console.log("initialize fixed imu");

            io.i2cConfig(opts);

            // Soft Reset
            io.i2cWrite(address, [
                this.REGISTER.SOFT_RESET >> 8,
                this.REGISTER.SOFT_RESET & 0xFF,
            ]);

            this.ioReadData(board, address);
        }
    },
    ioReadData: {
        value: function(board, address) {
            var READLENGTH = 6;
            var io = board.io;
            var computed = {
                temperature: null,
                humidity: null,
            };
            var self = this;
            io.i2cWrite(address, [
                this.REGISTER.MEASURE_HIGH_REPEATABILITY >> 8,
                this.REGISTER.MEASURE_HIGH_REPEATABILITY & 0xFF,
            ]);
            board.wait(15, function() {
                io.i2cReadOnce(address, READLENGTH, function(data) {
                    computed.temperature = int16(data[0], data[1]);
                    computed.humidity = int16(data[3], data[4]);
                    self.emit("data", computed);
                    self.ioReadData(board, address);
                }.bind(self));
            });
        }
    },
    // ...
};
```

I found a working Python library that only wait `15ms`: https://github.com/ralf1070/Adafruit_Python_SHT31/blob/master/Adafruit_SHT31.py#L109
That's why i write `board.wait(15, ...)` instead of `board.wait(500, ...)`.

I try my fix successfully on an Arduino Uno and an Arduino Micro.

Can i make a pull request to fix this?

fivdi, 2017-03-25:
The issue that @balda discovered here and the proposed solution in backed up by information from the [SHT3x-DIS datasheet](http://adafruit.com/images/product-files/2857/Sensirion_Humidity_SHT3x_Datasheet_digital-767294.pdf). Section 4.3 on page 9 of the datasheet makes the following statement:

"During measurement the sensor generally does not respond to any I2C activity, i.e. I2C read and write
headers are not acknowledged (NACK)."

In addition, table 4 in section 2.2 on page 5 of the datasheet specifies that the high repeatability measurement duration is up to 15 milliseconds. It is therefore appropriate to wait for 15 milliseconds after issuing a measurement command.

@balda Are you working on a PR for this issue? If not, do you mind if create a PR with a fix?

rwaldron, 2017-03-28:
I don't want to add the `ioReadData` method to the controller object. All of the reading can be wrapped up in a function inside of the `initialize` function and called as needed with necessary delay. [Similar approach seen in HTU21D](https://github.com/rwaldron/johnny-five/blob/master/lib/imu.js#L166-L189)

```js
var readCycle = function() {
  io.i2cWrite(address, [
    this.REGISTER.MEASURE_HIGH_REPEATABILITY >> 8,
    this.REGISTER.MEASURE_HIGH_REPEATABILITY & 0xFF,
  ]);
  setTimeout(function() {
    io.i2cReadOnce(address, READLENGTH, function(data) {
      computed.temperature = int16(data[0], data[1]);
      computed.humidity = int16(data[3], data[4]);
      this.emit("data", computed);
      readCycle();
    }.bind(this));
  }.bind(this), 15);
}.bind(this);

readCycle();
```

rwaldron, 2017-03-31:
@fivdi if you're up for writing a patch that fixes both, I would love that :)

fivdi, 2017-03-31:
> if you're up for writing a patch that fixes both, I would love that :)

@rwaldron  ok, I'll write a patch.

balda, 2017-04-01:
@fivdi thanks for making a PR to fix this bug! (i'm sorry: i haven't enough time these days to work on J5)

@rwaldron it's noted: by design, it's preferable to add functions in `initialize` method, instead of creating new controller methods (when it's possible) ;-) Thanks for your code review!

And `Si7021` has the same `uint` bug (with false negative values): https://github.com/rwaldron/johnny-five/blob/master/lib/imu.js#L1952
Must i create a new specific issue or can it be fixed in the same time?

fivdi, 2017-04-01:
@balda A separate issue for the Si7021 would be better. I got a SHT31D recently but don't have Si7021 and don't really want to write a patch/tests for a device I can't physically test with.

balda, 2017-04-02:
I understand @fidvi, it's logical.

I'll post an issue about Si7021 bug. I'm reading your HTU21D pull request to understand what you have done in `oneHundredPercentHumidity` test to adapt it (it's the same bug, but adding the `u` is not the more difficult ;-) )

fivdi, 2017-04-08:
#1319 is a PR for fixing both of the issues mentioned above.

fivdi, 2017-04-17:
Now that #1319 has been merged I think this issue can be closed.

rwaldron, 2017-04-17:
@fivdi excellent!

balda, 2017-04-18:
Thanks!

Closed 2017-04-17.

Thread 1257 (2016-12-04):

Bluetooth Connection Issue

ailaG, 2016-12-04:
Also on Stack Overflow: http://stackoverflow.com/questions/40923908/johnny-five-over-bluetooth-connection-issue

When trying to connect to Arduino via Bluetooth & johnny-five, I get a timeout error.
Setup: Arduino Uno, powered from the wall socket (with a 5V converter, of course), connected to a BT unit at Tx/Rx pins. BT unit (HC-05) was set up as in the instructions, Arduino has StandardFirmata uploaded. Computer is paired with it. Arduino IDE lists the paired device in its device list.

Error message:
```
> var five = require("johnny-five");
> var board = new five.Board({repl: false, port:'/dev/cu.ailaGduino-DevB'})
1480635008609 Connected /dev/cu.ailaGduino-DevB
undefined
> 1480635018633 Device or Firmware Error A timeout occurred while connecting to the Board.

Please check that you've properly flashed the board with the correct firmware.
See: https://github.com/rwaldron/johnny-five/wiki/Getting-Started#trouble-shooting
```

Just to clarify, what I want to do is send it JS commands over the air. e.g. blink a LED from my computer without cables involved.

chrisbward, 2017-02-26:
I also get this randomly - I have to try a couple more times and then it works - intermittent!

Closed 2018-08-28.

Thread 1259 (2016-12-08):

USB serial on Raspberry Pi performance (?)

cylinderStudio, 2016-12-08:
I have a [robotic arm](http://www.trossenrobotics.com/robotgeek-snapper-robotic-arm) comprised of five servos. I'm running Johnny Five on a Macbook Pro and am using the Animation library to run a series of servo animations on the arm. The first segment enqueued after board.on('ready') doesn't always run perfectly, but all subsequent ones (that are triggered by button clicks in my Nodejs app) run fine. I'm connected to the Arduino running the servos via USB serial, and the servos are adequately powered by a separate power supply.

I also have Johnny Five running the identical application on a Raspberry Pi 3 and identical version of NodeJS, etc. When I connect it to the robotic arm and run my application, almost none of the animation segments run as they should. The servos act very erratically and unpredictably, often with one servo in the chain .

Why does it run so poorly from the Raspberry Pi? Does it have to do with USB port speed? I've tried manually setting it to 115200 on the Pi application.

dtex, 2016-12-08:
On the Macbook Pro, if you wait a second or two before enqueueing the first animation segment does it play smoothly?

Re: the Raspberry Pi configuration, try reducing the fps. I suspect the Pi can't keep up with the default (but that's just a hunch).

cylinderStudio, 2016-12-08:
I'll try this when I get back to the lab tomorrow. On both the Macbook and the Pi, I did try delaying steps of the setup by a second, but I didn't fiddle with it much. I didn't think to try the fps.

dtex, 2016-12-08:
Cool. My hypothesis is that the RaspberryPi is only giving you a few frames per second or worse. That means that by the time the next render call rolls around the animation has moved on to the next cuepoint so it never reaches the target position. I've seen this with a Tessel 2 and my hexapod (18 servos) and even more glaringly when trying to control servos with animation() over an Xbee.

cylinderStudio, 2016-12-08:
That makes total sense to me, even in my limited experience.

So I delayed enqueue on the first segment by 3 seconds after the board reports ready, and I dropped the fps to 15 on all other segments. After three or four tests, that seems to have really improved things on the Macbook Pro. When the board first reports ready, the servos do an initial, somewhat strange sequence of movements, but I reckon that's to be expected. Maybe setting a start position would fix that.

As for the Pi, I delayed enqueue on the first segment by 3 seconds and dropped the fps on all segments to as low as 5, and it's still quite erratic. It improved somewhat for the first couple of segments enqueued, but it goes nuts after that. Primarily, you'll see one servo that has a bit of a load on it get behind and go into a rut where it just "ticks" a small movement every second until either it gets to it's originally targeted position, or it throws the rest of the animation(s) into chaos.

cylinderStudio, 2016-12-09:
I'm able to switch the RobotGeek Geekduino board to 3.3v, so I connected the RPi and Arduino via UART, as a possible end-around on the USB issue. No dice/same results.

dtex, 2016-12-10:
I was thinking that the FPS is limited by the processor on the Pi, not by the USB. Would you mind sharing your code? I'd like to see if I can optimize anything in Animation() to help with this.

cylinderStudio, 2016-12-10:
Oh, I didn't think of that. Gotcha.

I don't have the UI code with me, but here's the Johnny-Five code I've been tinkering with:

```
const five = require('johnny-five');
const board = new five.Board();

var base;
var shoulder;
var elbow;
var wrist;
var gripper;

var arm_animation;

board.on('ready', function() {
  base = new five.Servo({pin:3});
  shoulder = new five.Servo({pin:5});
  elbow = new five.Servo({pin:6, offset:-12});
  wrist = new five.Servo({pin:9});
  gripper = new five.Servo({pin:10});

  var joints = new five.Servos([base,shoulder,elbow,wrist,gripper]);

  arm_animation = new five.Animation(joints);

  setTimeout(function() { send_to_queue('ServiceIntent'); }, 3000);
});

// Segment definition

var extended = {
  duration: 3000,
  cuePoints: [0, 1.0],
  fps: 25,
  keyFrames: [
    [null, {degrees: 90,easing: "inOutQuad"}],
    [null, {degrees: 90,easing: "inOutQuad"}],
    [null, {degrees: 90,easing: "inOutQuad"}],
    [null, {degrees: 90,easing: "inOutQuad"}],
    [null, {degrees: 90,easing: "inOutQuad"}]
  ]
};

var grab_and_drop = {
	duration: 8000,
	cuePoints: [0,0.13,0.25,0.38,0.5,0.63,0.75,0.88,1.0],
	fps: 25,
	keyFrames: [
		[null,{degrees: 180,easing: "inOutQuad"},false,false,false,{degrees: 0,easing: "inOutQuad"},false,false,{degrees: 0,easing: "inOutQuad"}],
		[null,{degrees: 90,easing: "inOutQuad"},false,false,false,false,false,false,{degrees: 90,easing: "inOutQuad"}],
		[null,{degrees: 180,easing: "inOutQuad"},{degrees: 90,easing: "inOutQuad"},false,{degrees: 180,easing: "inOutQuad"},false,{degrees: 90,easing: "inOutQuad"},false,{degrees: 180,easing: "inOutQuad"}],
		[null,{degrees: 0,easing: "inOutQuad"},{degrees: 90,easing: "inOutQuad"},false,{degrees: 0,easing: "inOutQuad"},false,{degrees: 90,easing: "inOutQuad"},false,{degrees: 0,easing: "inOutQuad"}],
		[null,{degrees: 180,easing: "inOutQuad"},false,{degrees: 20,easing: "inOutQuad"},false,false,false,{degrees: 180,easing: "inOutQuad"},{degrees: 180,easing: "inOutQuad"}]
	],
	loop: true
};

// When DOM is ready, I have some jQuery buttons in a web UI trigger an enqueue of a segment with a statement like...
// arm_animation.enqueue(grab_and_drop);

```

dtex, 2016-12-10:
Your code certainly looks good. Let's find out the actual FPS...

In ```/node_modules/johnny-five/lib/animation.js``` change these lines (286-287):

````
// call render function with tweened value
this.target[Animation.render](this.tweenedValue(indices, progress));
````

to:

````
// call render function with tweened value
this.emit("animation:render");
this.target[Animation.render](this.tweenedValue(indices, progress));
````

and in your code add a counter:

````
var frames = 0;
arm_animation.on("animation:render", function() {
  frames++;
});
````

Check ```frames``` before and after enqueueing ```grab_and_drop``` and divde by the duration. I'm guessing we're talking single digit FPS. Also, what is the frame rate if you drop the easing?

cylinderStudio, 2016-12-10:
Thanks for whipping this up. I can try it first thing Monday morning. I did try dropping the easing last night, and it had no effect, but I'll try again.

dtex, 2016-12-12:
> It's 145 both before and after enqueueing

Not sure I follow as it should be different. Perhaps you need to wait for the animation to finish before checking the value?

cylinderStudio, 2016-12-12:
Right. Tried again:

before enqueue: 143
after enqueue: 143
on segment start: 143
on segment complete: 212

dtex, 2016-12-12:
Okay, so that's about 8 fps which is low, but not so bad that it should be super wonky (maybe just jittery if your servos are fast). Also, I am assuming that the frame renderings are evenly distributed over the duration of the animation since the formula remains the same.

hmm... Maybe it is the USB after all (I'm surprised).

Let's make sure that the wonkiness is an artifact of the USB and not the frame rate. If you throttle the fps to 8 on your Macbook does it render the same as on the Pi or is it more acceptable?

Thank you for trying all this. It really helps to see how other systems work with Animation.

cylinderStudio, 2016-12-12:
No problem. Happy to help.

If I throttle to 8 fps in the segments on the Mac, the reported/computed fps drops to around 3 fps and gets more erratic.

dtex, 2016-12-12:
Oh, that's very interesting. I'm going to try replicating that tonight.

cylinderStudio, 2016-12-12:
Good deal. Here's a little more info that may or may not help.

Those original frame rates I reported occurred when I capped the fps at 25, on both Mac and Pi. The servos seemed to be completely out of whack, even with straightforward Arduino-based tests.

So as an experiment, I unplugged everything, reset the Geekduino, plugged everything back in, and removed the fps setting from my segments. I ran three tests on the Mac, then the Pi.

Resulting fps ranges reported/computed:
Mac - baudrate not set/default: 24.9 to 34.7 fps
Mac - baudrate 57600: 26.5 to 29.4 fps
Mac - baudrate 115200: 21 to 34.7 fps

Pi - baudrate not set/default: 13 to 25 fps
Pi - baudrate 57600: 19 to 29 fps
Pi - baudrate 115200: 20.2 to 30 fps

The servos ran pretty well on the Mac. A few hiccups in the beginning sometimes, but they smooth themselves out.

The servos really struggle on the Pi. The ones that are running are completely out of sync, and one or two will get bogged down and just tick every second.

cylinderStudio, 2016-12-19:
As an experiment, I forked my project so that the servo animations all live in a sketch on the Arduino, and a Node app without Johnny Five that merely sends characters as commands over serial to run those animations. The animations continue to perform well when the Node app runs from my Macbook, but they perform noticeably worse when the Node app runs from the Raspberry Pi.

dtex, 2016-12-20:
If the animation code is in a custom sketch, it is unclear to me how being connected to a Pi vs your laptop could affect the performance. That custom sketch is not a variation of firmata or anything is it?

cylinderStudio, 2016-12-20:
Nope, it's a clean sketch just using the Servo library and serial.print.

At any rate, it's pretty clear this has nothing to do with Johnny-Five, so I wanted to share. Reckon we can close this out. Thanks for your help.

cylinderStudio, 2016-12-22:
It turns out not to be an issue with commands over serial at all. Whenever I just run an Arduino sketch with servo animations that's not receiving communication of any kind, it runs well when the Arduino is powered by USB from a Mac, but poorly when powered by USB from an RPi.

Closed 2016-12-20.

Thread 1260 (2016-12-09):

Device or Firmware Error A timeout occurred while connecting to the Board.

wilchen558, 2016-12-09:
Hi,

I got an official Arduino Uno and I'm trying to run:
```
var five = require("johnny-five"),
    board = new five.Board();

board.on("ready", function() {
  // Create an Led on pin 13
  var led = new five.Led(13);

  // Strobe the pin on/off, defaults to 100ms phases
  led.strobe();
});
```

It works for a few seconds, then i get:

```
1481312223042 Connected /dev/cu.usbmodem1411
1481312233046 Device or Firmware Error A timeout occurred while connecting to the Board.

Please check that you've properly flashed the board with the correct firmware.
See: https://github.com/rwaldron/johnny-five/wiki/Getting-Started#trouble-shooting

If connecting to a Leonardo or Leonardo clone, press the 'Reset' button on the board, wait approximately 11 seconds for complete reset, then run your program again.
events.js:165
      throw err;
      ^

Error: Uncaught, unspecified "error" event. ([object Object])
    at Board.emit (events.js:163:17)
    at Board.log (/www/learning/arduino/js-hello/node_modules/johnny-five/lib/board.js:630:8)
    at Board.(anonymous function) [as error] (/www/learning/arduino/js-hello/node_modules/johnny-five/lib/board.js:641:14)
    at Board.<anonymous> (/www/learning/arduino/js-hello/node_modules/johnny-five/lib/board.js:390:14)
    at ontimeout (timers.js:365:14)
    at tryOnTimeout (timers.js:237:5)
    at Timer.listOnTimeout (timers.js:207:5)
```

Tried both on mac and windows with StandardFirmata and StandardFirmataPlus.

If I run:

```
var serialport = require("serialport");
serialport.list(function(err, ports) {
    console.log(ports);
});
```
I get:

```
[ { comName: '/dev/cu.Bluetooth-Incoming-Port',
    manufacturer: undefined,
    serialNumber: undefined,
    pnpId: undefined,
    locationId: undefined,
    vendorId: undefined,
    productId: undefined },
  { comName: '/dev/cu.usbmodem1411',
    manufacturer: 'Arduino Srl            ',
    serialNumber: '7543536303835141F040',
    pnpId: undefined,
    locationId: '0x14100000',
    vendorId: '0x2a03',
    productId: '0x0043' } ]
```

I have had no other problems with this board.

Hope you can help find a solution to this problem.

rwaldron, 2016-12-09:
Did you upload StandardFirmata to the Arduino?

soundanalogous, 2016-12-10:
@wilchen558 did you use the version of StandardFirmata that ships with the Arduino IDE or did you clone master from [firmata/arduino](https://github.com/firmata/arduino)?

wilchen558, 2016-12-11:
Yes did a clean installation of Arduino IDE and I'm using Firmata 2.5.3

rwaldron, 2016-12-12:
Any updates? I'm not sure how to help with this issue, as I can only reproduce it with a board that has something other than StandardFirmata (or similar variant)

wilchen558, 2016-12-16:
I have tried on two computers with clean installations of Arduino IDE and the latest version of Firmata, still no luck. Could it be a hardware problem?

rwaldron, 2016-12-16:
That would be my guess—as this will only happen when there is something wrong on that end.

soundanalogous, 2016-12-17:
Could also be the USB cable. Or if you connect the USB cable directly to your monitor USB port rather than computer port, or even some cheap USB hubs may cause issues.

Litz15, 2017-03-21:
I'm having the same issue, any updates on how to fix it?

dtex, 2017-03-22:
@Litz15 The only way this has been reproduced is by one of the following:
* Not having some variant firmata installed on the Arduino
* Bad USB cable
* Cheap USB hub
* Misconfigured USB drivers (Windows)

The most common of these is not having Firmata installed. Can you confirm that it is installed on the Arduino?

Litz15, 2017-03-22:
@dtex Hi! I check all those options and everything was ok. After that, I realize that when I ran the program, there was an error in the ports. It was looking for the board always in COM3, so I check the specific port for my board in arduino's IDE, in this case COM4 and put this in js code:

const board = new five.Board({ port: "COM4" });

Now everything's working fine. Thanks for your help!

dtex, 2017-03-22:
Glad to hear it's working for you now.

@wilchen558 Did you ever determine what was happening in your case?

wilchen558, 2017-03-23:
@dtex No I never got it working. Tried on Mac and PC, tried with different USB cables, tried with different versions of Firmata nothing helped.

Recently got a tip from @markvdesign

Will try this next week and report back.

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

diegogarciaarriaza, 2017-08-07:
Hey!, do continue this post alive?
I have a similar issue. I use firmataethernet with the common port 3030.
I connect with my board, and i can keep comunication with it for severals minutes, but suddenly board is dead, no messages are shown, only stay there. If I try to force to restart the node program then i get the message: "A timeout occurred while connecting to the Board"

Maybe i lost the connection?, maybe i need to use another firmata, for example customizablefirmata?

I have installed firmataethernet on board, and I use johnny-five and etherport on the server.
Copy a pieze of my code:
```
var five = require("johnny-five");
var EtherPort = require("etherport");
var board = new five.Board({
    id: "Board_1",
    port: new EtherPort(3030),
    host: '192.168.1.101',
    timeout: 1e5
});
board.on("ready", function() {
//things
});

```
Any idea?, Thanks!!

dtex, 2017-08-07:
@diegogarciaarriaza Is it possible your board is experiencing a brown out? How are you powering it and what if anything are you powering through it (i.e. servos, motors, etc)?

diegogarciaarriaza, 2017-08-07:
I have plugged it to the wall directly, so i think always is powered correctly.
It has connected 1 motion sensor, 1 thermometer, 1 gas sensor and 1 double relay. This relay can be off all time and the problem happen too.

rwaldron, 2017-08-07:
Does the board have StandardFirmataEthernet firmware uploaded?

diegogarciaarriaza, 2017-08-07:
Yes, i think so. Board can be uploaded with firmataethernet more or less 1 month ago.
Im going to upload with firmatacustom tomorrow, and i will see if the issue persist. I read for there this second one is better now....

rwaldron, 2017-08-07:
>  I read for there this second one is better now....

I'm not sure that's true, let's ask @soundanalogous

diegogarciaarriaza, 2017-08-07:
So then?, What can i do?

soundanalogous, 2017-08-07:
It's the same code it both. Shouldn't make any difference.

What you can do is add debug statements in StandardFirmataEthernet and then keep your board connected to your computer via Serial so you can view the log output.

Uncomment [this line](https://github.com/firmata/arduino/blob/master/examples/StandardFirmataEthernet/StandardFirmataEthernet.ino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) to enable serial debugging.

Then add a counter variable near the top of the file where other variables are declared:
```c++
int counter = 0;
```

Then at the end of [this if block](https://github.com/firmata/arduino/blob/master/examples/StandardFirmataEthernet/StandardFirmataEthernet.ino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) (but within the block), add this code:
```c++
if (counter++ >= 526) {
  DEBUG_PRINT("connected: ");
  DEBUG_PRINTLN(counter);
  counter = 0;
}
```

Compile, upload and open the Serial Monitor in the Arduino IDE (with your board connected via USB Serial) setting it to 9600 baud. You should see "connected: <current count>" printed every 10 seconds. If after a few minutes your application crashes, see if "connected" is still being printed. Then report back to me.

diegogarciaarriaza, 2017-08-08:
Thank you very much!, This afternoon I will try and then tell you something
Regards

alamitina, 2017-09-01:
```javascript
var board = new five.Board({port: "COM3"});
```

Just got a new Arduino and was getting that same error, but changing my board variable to the COM3 seems to work like a charm!

coolhandfluke, 2018-03-09:
I am getting similar issue with windows 7. Just tried to run led-blink.js code with windows7, uploaded standardfirmata that comes with arduino IDE. Below is the error log, any solution for this?

node led-blink.js
1520575717494 Connected COM3
1520575717511 Error  �`☻
(node:13776) UnhandledPromiseRejectionWarning: Unhandled promise rejection (reje
ction id: 1): Error: Uncaught, unspecified "error" event. ([object Object])
1520575727498 Device or Firmware Error A timeout occurred while connecting to th
e Board.

Please check that you've properly flashed the board with the correct firmware.
See: https://github.com/rwaldron/johnny-five/wiki/Getting-Started#trouble-shooti
ng

If connecting to a Leonardo or Leonardo clone, press the 'Reset' button on the b
oard, wait approximately 11 seconds for complete reset, then run your program ag
ain.
events.js:165
      throw err;
      ^

Error: Uncaught, unspecified "error" event. ([object Object])
    at Board.emit (events.js:163:17)
    at Board.log (C:\psnl\learning\arduino\bossabledemo\johnny-five\lib\board.js
:630:8)
    at Board.(anonymous function) [as error] (C:\psnl\learning\arduino\bossabled
emo\johnny-five\lib\board.js:641:14)
    at Board.<anonymous> (C:\psnl\learning\arduino\bossabledemo\johnny-five\lib\
board.js:385:14)
    at ontimeout (timers.js:365:14)
    at tryOnTimeout (timers.js:237:5)
    at Timer.listOnTimeout (timers.js:207:5)

AndreyMartinez, 2018-03-19:
https://www.youtube.com/watch?v=yxl3D5hjWAs

this is a video in which solve your problem is totally recommended

ArielPrez, 2018-09-07:
I had this issue. If you're using it through wifi it might be possible you're connected to the wrong router or connection.

diegogarciaarriaza, 2018-10-20:
Hi again. My last post was in 2017...
Sorry for that.

I just re-try connect with my arduino board via ethernet (firmataethernet) but I am having bad luck.
I am using the same code but now I don't get connect.

I have ping with my board and If I connect the board by USB, I have this exit in the console:

> connecting...
Connection failed. Attempting to reconnect...
connected
Connection failed. Attempting to reconnect...
Connection failed. Attempting to reconnect...
connected
Connection failed. Attempting to reconnect...
Connection failed. Attempting to reconnect...
connected
Connection failed. Attempting to reconnect...
>

All time is the same.

2 hours before, I get the problem installing johnny-five when tried to use serialport@4.0.7 but now I have downgraded to node v6 and that problem is not shown.
Now simply dont connect getting this:

> Please check that you've properly flashed the board with the correct firmware.
3|test2          | See: https://github.com/rwaldron/johnny-five/wiki/Getting-Started#trouble-shooting
3|test2          | If connecting to a Leonardo or Leonardo clone, press the 'Reset' button on the board, wait approximately 11 seconds for complete reset, then run your program again.
3|test2          | Error: Uncaught, unspecified "error" event. ([object Object])
3|test2          |     at Board.emit (events.js:163:17)
3|test2          |     at Board.log (/var/www/domohouse_events/node_modules/johnny-five/lib/board.js:635:8)
3|test2          |     at Board.(anonymous function) [as error] (/var/www/domohouse_events/node_modules/johnny-five/lib/board.js:646:14)
3|test2          |     at Board.<anonymous> (/var/www/domohouse_events/node_modules/johnny-five/lib/board.js:390:14)
3|test2          |     at ontimeout (timers.js:386:11)
3|test2          |     at tryOnTimeout (timers.js:250:5)
3|test2          |     at Timer.listOnTimeout (timers.js:214:5)
>

Honestly I dont know what to do...

Any help?, thank you!

dtex, 2018-10-21:
Thanks for reporting back! Someone else will surely have the same issue and will find your solution.

legoman849, 2020-12-12:
mine is saying this when i try to upload to my arduino uno im using node js

legoman849, 2020-12-12:
1607790942364 Device or Firmware Error A timeout occurred while connecting to the Board.

Please check that you've properly flashed the board with the correct firmware.
See: https://github.com/rwaldron/johnny-five/wiki/Getting-Started#trouble-shooting

If connecting to a Leonardo or Leonardo clone, press the 'Reset' button on the board, wait approximately 11 seconds for complete reset, then run your program again.
node:events:367
    throw err; // Unhandled 'error' event
    ^

Error [ERR_UNHANDLED_ERROR]: Unhandled error. ({
  type: 'error',
  timestamp: 1607790942364,
  class: 'Device or Firmware Error',
  message: 'A timeout occurred while connecting to the Board. \n' +
    '\n' +
    "Please check that you've properly flashed the board with the correct firmware.\n" +
    'See: https://github.com/rwaldron/johnny-five/wiki/Getting-Started#trouble-shooting\n' +
    '\n' +
    "If connecting to a Leonardo or Leonardo clone, press the 'Reset' button on the board, wait approximately 11 seconds for complete reset, then run your program again.",
  data: null
})
    at new NodeError (node:internal/errors:278:15)
    at Board.emit (node:events:365:17)
    at Board.EventEmitter.emit (node:domain:470:12)
    at Board.log (C:\Users\benal\node_modules\johnny-five\lib\board.js:642:8)
    at Board.<computed> [as error] (C:\Users\benal\node_modules\johnny-five\lib\board.js:653:14)
    at Timeout._onTimeout (C:\Users\benal\node_modules\johnny-five\lib\board.js:384:14)
    at listOnTimeout (node:internal/timers:556:17)
    at processTimers (node:internal/timers:499:7) {
  code: 'ERR_UNHANDLED_ERROR',
  context: {
    type: 'error',
    timestamp: 1607790942364,
    class: 'Device or Firmware Error',
    message: 'A timeout occurred while connecting to the Board. \n' +
      '\n' +
      "Please check that you've properly flashed the board with the correct firmware.\n" +
      'See: https://github.com/rwaldron/johnny-five/wiki/Getting-Started#trouble-shooting\n' +
      '\n' +
      "If connecting to a Leonardo or Leonardo clone, press the 'Reset' button on the board, wait approximately 11 seconds for complete reset, then run your program again.",
    data: null
  }
}

legoman849, 2020-12-12:
here is my code
var five = require('johnny-five');
var board = new five.Board();

board.on('ready', function(){
    var heart = [
    "01100110",
    "10011001",
    "10000001",
    "10000001",
    "01000010",
    "00100100",
    "00011000",
    "00000000"
  ];

  matrix = new five.Led.Matrix({
    addresses: [0x70],
    controller: "HT16K33",
    rotation: 1});

  matrix.clear();
  matrix.draw(heart);

});

calabiyauman, 2021-10-05:
Had this same issue and resolved it by specifying the port number with `board = new five.Board({ port: "COM6" });`

Closed 2018-10-21.

Thread 1274 (2017-01-14):

BME280 wrong readings / oversampling mode

xeroxoid, 2017-01-14:
Hi and thanks for the excellent work!

I was trying out j5 on my `Raspberry Pi 2 Model B` and noticed that the readings for `Multi` as well as `Barometer' and 'Humidity' return wrong values for a Sparkfun BME280 breakout.

As I am new in the IoT scene, I am assuming that I am doing something wrong or have not read enough, but here are some assumptions followed by some questions:

1. Using the python library `Adafruit_Python_BME280` I get the following results:

```
Temp      = 24.140 deg C
Pressure  = 991.88 hPa
Humidity  = 41.53 %
```

2. Using another python library I get similar results:

```
Chip ID     : 96
Version     : 0
Temperature :  24.14 C
Pressure :  991.880802123 hPa
Humidity :  41.5296441194 %
```

3. But when I use **NodeJS with j5** and `Multi` I get:

```
--------------------------------------
Thermometer
  celsius      :  21.55
--------------------------------------
Barometer
  pressure     :  76.27
--------------------------------------
Hygrometer
  humidity     :  71.061
--------------------------------------
```

I noticed that both python libraries set (by default) the `oversampling mode` or `oversampling rate` to `8` . When I set it to `1`, even with python I get similar *wrong* values.

For reference I am using an external/handheld barometer and 2 different hygrometers which all report similar values to the oversampled ones (i.e. relative humidity ~ 42 and pressure ~   992 hPa)

My questions are:
1. Is there a way to set the oversampling rate in j5?
2. Why does the BME280 need such a high oversampling mode in order to provide correct values?
3. Can you point me to some reading material about oversampling and how/why it affects the readings so much?
4. I notice that even the temperature is off a bit, can I assume that this is a normal fluctuation?
5. After getting data with node/j5 one of the two python libraries also reports wrong data: i.e.
```
Chip ID     : 96
Version     : 0
Temperature :  21.55 C
Pressure :  762.681500693 hPa
Humidity :  71.0611180087 %
```
but then I run the Adafruit lib again and it *corrects/resets* it. Its like the JS code messes with the sensor in a way I can't explain...

rwaldron, 2017-01-16:
Thanks for the report! When I wrote the BME280 controller-driver I verified output against the output of existing C/C++ libraries, but not Adafruit_Python_BME280. Our implementation is written against the datasheet, instead of as a "port" of any existing code base.

I'm going to spend some time today with Adafruit_Python_BME280 to see what I can learn

xeroxoid, 2017-01-16:
Great!

If it is any help while researching I found that similar results are returned when using [this js implementation](https://github.com/skylarstein/bme280-sensor) by @skylarstein, but only the first result has wrong data, all consecutive results seem correct.

This goes hand-in-hand with the (pretty untechnical) FAQ answer [found here](https://learn.adafruit.com/adafruit-bme280-humidity-barometric-pressure-temperature-sensor-breakout/faq) which states:

> The BMx280 'saves' the last reading in memory for you to query. Just read twice in a row and toss out the first reading!

Also, the only difference I found in the Adafruit_Python_BME280 library is that they use oversampling *8 which might be just taking 8 samples and returning the mean value of those (instead of "tossing" out the first), which in a way would also affect the results when the first result is off by that much.

rwaldron, 2017-01-16:
I suspect that your hunch about oversampling settings might be the right path to explore. Here's what I've done so far:

1. Using just an Arduino UNO...
2. With `Adafruit_BME280_Library`, I ran the following program:

    ```ino
    #include <Wire.h>
    #include <Adafruit_Sensor.h>
    #include <Adafruit_BME280.h>

    Adafruit_BME280 bme;

    void setup() {
      Serial.begin(9600);
      Serial.println(F("BME280 test"));

      if (!bme.begin()) {
        while (1);
      }
    }

    void loop() {
      Serial.print("Temperature = ");
      Serial.print(bme.readTemperature());
      Serial.println(" *C");

      Serial.print("Pressure = ");
      Serial.print(bme.readPressure() / 1000.0F);
      Serial.println(" kPa");

      Serial.print("Humidity = ");
      Serial.print(bme.readHumidity());
      Serial.println(" %");

      Serial.println();
      delay(2000);
    }
    ```

    Here are the first 10 readings output by that program:

    ```
    BME280 test
    Temperature = 19.68 *C
    Pressure = 102.80 kPa
    Humidity = 25.97 %

    Temperature = 19.67 *C
    Pressure = 102.79 kPa
    Humidity = 25.83 %

    Temperature = 19.67 *C
    Pressure = 102.79 kPa
    Humidity = 25.67 %

    Temperature = 19.67 *C
    Pressure = 102.79 kPa
    Humidity = 25.67 %

    Temperature = 19.67 *C
    Pressure = 102.79 kPa
    Humidity = 25.78 %

    Temperature = 19.68 *C
    Pressure = 102.80 kPa
    Humidity = 25.99 %

    Temperature = 19.67 *C
    Pressure = 102.79 kPa
    Humidity = 26.07 %

    Temperature = 19.68 *C
    Pressure = 102.79 kPa
    Humidity = 25.92 %

    Temperature = 19.69 *C
    Pressure = 102.80 kPa
    Humidity = 26.09 %

    Temperature = 19.69 *C
    Pressure = 102.80 kPa
    Humidity = 26.45 %
    ```

3. Next, I uploaded StandardFirmata to the board.
4. With Johnny-Five, I ran the following program:

    ```js
    var five = require("johnny-five");
    var board = new five.Board();

    board.on("ready", function() {
      var multi = new five.Multi({
        controller: "BME280"
      });

      multi.on("data", function() {
        console.log(`Temperature: ${this.thermometer.celsius} C`);
        console.log(`Pressure: ${this.barometer.pressure} kPa`);
        console.log(`Humidity: ${this.hygrometer.relativeHumidity} %`);
        console.log();
      });
    });
    ```

    Here are the first 10 readings output by that program:

    ```
    Temperature: 22.23 C
    Pressure: 70.796 kPa
    Humidity: 54.003 %

    Temperature: 22.23 C
    Pressure: 70.796 kPa
    Humidity: 54.003 %

    Temperature: 22.23 C
    Pressure: 70.796 kPa
    Humidity: 54.003 %

    Temperature: 19.64 C
    Pressure: 102.795 kPa
    Humidity: 25.749 %

    Temperature: 19.64 C
    Pressure: 102.795 kPa
    Humidity: 25.749 %

    Temperature: 19.64 C
    Pressure: 102.795 kPa
    Humidity: 25.749 %

    Temperature: 19.64 C
    Pressure: 102.795 kPa
    Humidity: 25.749 %

    Temperature: 19.64 C
    Pressure: 102.795 kPa
    Humidity: 25.749 %

    Temperature: 19.65 C
    Pressure: 102.794 kPa
    Humidity: 25.792 %

    Temperature: 19.65 C
    Pressure: 102.794 kPa
    Humidity: 25.792 %
    ```

Notes about the above:

1. They are both using the same over-sampling rate (16x). I will next explore different oversampling rates.
1. J5 does a soft reset, which appears to cause the erroneous initial readings. I will fix this.

xeroxoid, 2017-01-23:
Is there a branch where you could commit the soft reset fix or perhaps point me to the code so that I can fork?

cabaret, 2017-03-14:
I am also currently running into a problem with the BME280 where my temperature readings are 5°C too high. The first reading seems to be correct (~22°C, which is close to the actual temperature in my appartment). It then starts reading 27-28°C.. Sensor works, if I place my finger on it, the temperature rises again. Is there a fix for this yet? Thanks!

skylarstein, 2017-03-14:
@cabaret just FYI, the BME280 data sheet has this to say:

"Temperature measured by the internal temperature sensor. This temperature value depends on the PCB temperature, sensor element self-heating and ambient temperature and is typically above ambient temperature."

Your first readings from cold start are accurate since it's been unused and at ambient temperature, but as soon as you start using the sensor it begins to generate its own heat.

Other factors such as proximity to the CPU, installation inside an enclosure, etc can also contribute to divergence from ambient.

rwaldron, 2017-03-30:
@xeroxoid sorry for the delay, I was on parental leave from January 20th until last week and I'm still trying to catch up with everything.

> Is there a branch where you could commit the soft reset fix or perhaps point me to the code so that I can fork?

I will be working on resolving issues as quickly as I can and will ping you here once I have this fixed. Thank you for your patience ❤️

xeroxoid, 2017-03-30:
Yay thanks, no worries! Congrats on the kid 😃

Arthedian, 2017-04-25:
Whats the status of this problem?

rwaldron, 2017-04-25:
@Arthedian I will try to resolve this week, if I have time.

rwaldron, 2017-04-28:
Revisiting this issue... When running the Arduino code I gave above, I can actually reproduce the behavior that Johnny-Five is also displaying:

1. Disconnect 3.3V, then Reconnect
2. Press RESET button on Arduino

```
BME280 test
Temperature = 22.23 *C
Pressure = 70.79 kPa
Humidity = 54.00 %

Temperature = 23.63 *C
Pressure = 101.44 kPa
Humidity = 50.18 %

Temperature = 23.64 *C
Pressure = 101.44 kPa
Humidity = 50.11 %

Temperature = 23.64 *C
Pressure = 101.44 kPa
Humidity = 50.07 %

Temperature = 23.64 *C
Pressure = 101.44 kPa
Humidity = 50.04 %

...
```

Next...

1. Upload StandardFirmata to the Arduino
2. Disconnect 3.3V, then Reconnect

```
$ node eg/multi-BME280-1274.js
1493394045968 Available /dev/cu.usbmodem1411
1493394045990 Connected /dev/cu.usbmodem1411
1493394047709 Repl Initialized
>> Temperature: 22.23 C
Pressure: 70.796 kPa
Humidity: 54.003 %

Temperature: 22.23 C
Pressure: 70.796 kPa
Humidity: 54.003 %

Temperature: 22.23 C
Pressure: 70.796 kPa
Humidity: 54.003 %

Temperature: 22.23 C
Pressure: 70.796 kPa
Humidity: 54.003 %

Temperature: 23.28 C
Pressure: 101.438 kPa
Humidity: 50.207 %

Temperature: 23.28 C
Pressure: 101.438 kPa
Humidity: 50.207 %

Temperature: 23.28 C
Pressure: 101.438 kPa
Humidity: 50.207 %
```

Nearly identical results for the first few seconds.

rwaldron, 2017-04-28:
Of course the status register is not in contiguous order with the pressure and temp registers (which are)...

```
0xF3 status
0xF4 crtl_meas
0xF5 config
0xF6 -
0xF7 MSB Pressure
0xF8 LSB Pressure
0xF9 XLSB Pressure
0xFA MSB Temperature
0xFB LSB Temperature
0xFC XLSB Temperature
```

rwaldron, 2017-04-28:
Setting oversampling to x8 instead of x16 and following the same procedures shown here: https://github.com/rwaldron/johnny-five/issues/1274#issuecomment-298033220 produces nearly identical results; specifically: the incorrect pressure and humidity, which evens off after a 2-3 seconds

rwaldron, 2017-04-28:
Just to address the original report:

>  Its like the JS code messes with the sensor in a way I can't explain...

Yes, this is the soft reset, which the Adafruit library is not doing

rwaldron, 2017-04-28:
I believe I found the answer on Page 8, *1.2 Humidity parameter specification*:

| Parameter | Symbol | Condition | Min | Typ | Max | Unit |
| --------- | ------ | --------- | --- | --- | --- | ---- |
| Response time to complete 63% of step | <sup>τ</sup>63% | 90->0 or 0->90 %RH, 25°C |  | 1 |  | s |

If I prevent any readings from being emitted until after a complete step, which is ~1587ms, then all readings are always accurate!

rwaldron, 2017-04-28:
Same outcome when I limit the standby time to the <sup>τ</sup>63% of 1 second

xeroxoid, 2017-05-03:
Great! Thanks for taking the time to solve this issue and document it in such detail!

dbaarda, 2022-06-24:
FTR, I suspect that the problem is actually failing to wait until the NVM has been loaded in the device before reading the calibration data. This would be particularly important after a soft reset. Any sort of wait is likely to fix this as it gives the device time to load the calibration data from the NVM.

I don't think the "Response time to complete 63% of step" 1s time has anything to do with this. Reading the datasheet, that is how long the device would take to respond to a rise or drop to 63% of a step change in the humidity. There are comments for this value that say it relies on sufficient airflow to the device, so this is a response time of the sensor to changes in humidity, and nothing to do with any sort of delay in conversion or communication with the device.

Closed 2017-05-02.

Thread 1282 (2017-01-27):

SHT31D doesn't change temperature or humidity

aabm00, 2017-01-27:
I am testing SHT31D on YUN

The code is:

```
var five = require('johnny-five');

var board = new five.Board({ port: "/dev/ttyATH0"});

board.on('ready', function() {

  var multi = new five.Multi({
    controller: "SHT31D",
    address: 0x44,
    freq:2000
  });

  console.log('Reading i2c SHT31D');

  //this.repl.inject({ write : write });

  multi.on("data", function() {
    console.log("Thermometer");
    console.log("  celsius           : ", this.thermometer.celsius);
    console.log("  fahrenheit        : ", this.thermometer.fahrenheit);
    console.log("  kelvin            : ", this.thermometer.kelvin);
    console.log("--------------------------------------");

    console.log("Hygrometer");
    console.log("  relative humidity : ", this.hygrometer.relativeHumidity);
    console.log("--------------------------------------");
  });

  console.log('done.');

});
```
But I get always the same lecture it doesn`t matter if I make a breath on the sensor, and the humidity is a negative value.

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

But when I test the program with **SHT31Test.ino** provided by Adafruit I get different values,
 and the humidity is correct (a positive value);

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

And when I breath on the sensor I get:

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

fivdi, 2017-01-28:
There's currently a [similar issue](https://github.com/rwaldron/johnny-five/issues/1278) with the HTU21D. I don't have an SHT31D to perform tests. Does it work if the following [two lines of code in imu.js](https://github.com/rwaldron/johnny-five/blob/master/lib/imu.js#L118-L119) are modified from:
```js
          computed.temperature = int16(data[0], data[1]);
          computed.humidity = int16(data[3], data[4]);
```
to:
```js
          computed.temperature = uint16(data[0], data[1]);
          computed.humidity = uint16(data[3], data[4]);
```
?

balda, 2017-01-30:
I have same issue and find a "fix": https://github.com/rwaldron/johnny-five/issues/1253

But waiting between i2c calls is maybe not a good solution ...

balda, 2017-01-30:
Here is my code change: https://github.com/balda/johnny-five/commit/8c704b367a5953a09df29b76e4c1e9927f0b87b2

aabm00, 2017-01-30:
Hi, thank you both.

@fivdi changing int16 by uint16 doesn't work for SHT31D.
@balda your modification works fine. It will be nice that @rwaldron included it to the download version.

Thanks again!!!

balda, 2017-02-01:
@fivdi i confirm that your fix works: i've encountered the problem when RH >= 50% (value "flip" to negative). With `uint16`, it works perfectly :-)

@aabm00 i have updated my branch with @fivdi fix.

fivdi, 2017-02-01:
I wonder if the int16/uint16 issue is a general problem in imu.js?

aabm00, 2017-02-02:
Ok, So the finally solution is a combination of you both @balda to change the values over time and @fivdi for the negative problem.

Thanks !!! :)

aabm00, 2017-02-06:
Hi.

I have been testing the SHT31D for different intervals between data, freq = 250 and freq = 500 and it works fine, but after about one hour the readings get stuck and do not change any more.

@balda have you notice the same thing or it's working fine for you?

Now I am testing for frequency of 1000 ms.

Thanks

balda, 2017-02-06:
@aabm00 i have 2 SHT31D running (plugged to an Arduino Micro connected to a Raspberry Pi 3). First is running since 08 Dec 2016, second since 31 Jan 2017 (with @fivdi fix).
And i haven't noticed problem: but my frequency is 10000 ms.

I'll try with shorter frequency (but i don't know when ;) )

@fivdi i received a `Si7021` (multi temp/humidity). When i'll have time to test it, i'll check if i encountered same int16/uint16 issue.

aabm00, 2017-02-06:
The SHT31D has been working for 2 hours until now and it works fine so it look that for frequencies less that 1000 ms it fails after an hour.
If the results change I notify it

balda, 2017-02-08:
Thanks @aabm00.

@fivdi i tested a `Si7021` and i confirm same bug (jump from 56% to -68% instead of 57%). With `uint16()` fix, it works perfectly. `SI7021` use same driver than `SI7020`(https://github.com/rwaldron/johnny-five/blob/master/lib/imu.js#L1952)

@rwaldron can we propose a PR to solve this bug?

lyzadanger, 2017-02-13:
@balda If you make sure to add appropriate tests, I think a PR would be greatly appreciated!

aabm00, 2017-02-17:
Hi

The SHT31D has been working for 3 hours with a frequency of 2000 ms and with the imu.js modified from @balda, and it have failed. The readings doesn't change.

aabm00, 2017-02-20:
The same result with interval of 10000 ms, after about 2 hours blocks and don't change the readings.

Some idea from where can come this behaviour

Thanks

balda, 2017-03-06:
@aabm00 i have updated my frequency (down to 1000 ms). I'll tell you soon if i have a bug :)

@lyzadanger thanks! i'll work on tests before submitting a PR.

aabm00, 2017-03-06:
Thanks @balda !!

balda, 2017-03-06:
@aabm00 4h working without problem at 1000ms.

aabm00, 2017-03-07:
Thanks @balda.

If it's working for you, probably i have something going wrong. Because i couldn't find out what was the problem and I can't spend more time at this time I am using the adafruit sketch for now.
If i find out the problem I'll post it.

rwaldron, 2017-03-30:
Hi! Sorry for the delay, I was on parental leave from January 20th until March 20th and I'm still trying to catch up with everything. I'm also sorry that we weren't able to help you resolve this issue :(

I'm going to close this for now, but if anyone wants to take this on, post here and we will re-open.

Closed 2017-03-30.

Thread 1287 (2017-02-01):

I2C MasterReader - SlaveWriter - How to control the interval between readings

aabm00, 2017-02-01:
Hi

I am connecting via I2C an Arduino YUN as a master reader and a Arduino One as slave writer.
The YUN has installed the StandardFirmataYun in the ATmega32u4 and Johnny-Five in the Atheros AR9331, The ONE has an arduino sketch.

The goal is that the ONE has installed different analogic devices like thermistors,  and I want to read in the YUN  the data of this thermistors every 5 seconds. But in Johnny-five in the method:

**this.io.i2cRead(address,` bytesToRead, handler)**

There is no a parameter as "freq" to determine what is the interval between readings.
In the other way in  the method **i2cConfig** I added the **delay** parameter:

**this.io.i2cConfig({delay : 2000000});** but it has no effect.

I finally got the result but not from Johnny-five but from the ONE sketch, but I don't know if it is the best way. The code is:

 ==== YUN ==== MASTER READER

 ```
var five = require('johnny-five'),
       _    = require('lodash');

var board = new five.Board({ port: "/dev/ttyATH0"});

board.on('ready', function() {

	var self = this;

  var read =  function(){
    //self.io.i2cRead(address, bytesToRead, handler)
    self.io.i2cRead(8, 27, function(ArrayOfBytes){

      //console.log(ArrayOfBytes);

      var length = ArrayOfBytes.length;
      var message = "";

      for (var i = 0; i < length; i++){
        var code = ArrayOfBytes[i]
        var char = String.fromCharCode(code);
        if (code != 255){
          message = message.concat(char);
        }

      }
      if (message.length != 1){
        console.log(message.length, message);
      }

    });
  }

  console.log('Reading i2c...');

  this.io.i2cConfig({delay : 2000000});
  //this.repl.inject({ write : write });

  read();

  console.log('done.');

});
```
 ==== ONE==== SLAVE WRITER

```
#include <Wire.h>

// the value of the 'other' resistor
#define SERIESRESISTOR 1000000

// What pin to connect the sensor to
#define THERMISTORPIN A1

float reading;
float ohmios;

void setup() {
  Wire.begin(8);        
  Wire.onRequest(requestEvent);
  Serial.begin(9600);
}

void loop() {
  reading = analogRead(THERMISTORPIN);

  Serial.print("Analog reading ");
  Serial.println(reading);

  // convert the value to resistance
  ohmios = (1023 / reading)  - 1;
  ohmios = SERIESRESISTOR / ohmios;
  Serial.print("Thermistor resistance ");
  Serial.println(ohmios);
  Serial.println("");

  delay(2000);
}

// function that executes whenever data is requested by master
// this function is registered as an event, see setup()
void requestEvent() {
  if(ohmios != 0){
    char buffer[9];
    dtostrf(ohmios, 5, 2, buffer);
    Wire.write(buffer);

    ohmios = 0;
  }
}
```

With this implementation every 2 seconds the data in **ohmios** variable is sent, but actually the data is sent constantly but with value **nul** and I control that this data isn't showed in the YUN by the code:

```
      if (message.length != 1){
        console.log(message.length, message);
      }
```
If I don't add this conditional I get print
1 "\u0000"
1 "\u0000"
....
1 "\u0000"
1 "\u0000"
**7 "9871.67"**
1 "\u0000"
1 "\u0000"
....
1 "\u0000"

Is there another more elegant way to achive it?

Thanks

fivdi, 2017-02-06:
@aabm00 Maybe https://github.com/rwaldron/io-plugins/issues/11#issuecomment-277818700 helps.

fivdi, 2017-02-11:
@aabm00 Can this issue be closed? If so, please hit the `Close issue` button at the bottom of the page :). If I'm not mistaken two ways to resolve the issue were discussed at https://github.com/rwaldron/io-plugins/issues/11

aabm00, 2017-02-13:
Yes, thanks

Closed 2017-02-13.

Thread 1301 (2017-03-08):

Tessel joystick doesn't work

jdnichollsc, 2017-03-08:
Hi guys!

I'm using the following code but the **change** event doesn't work => https://github.com/jdnichollsc/Tessel/blob/master/example3/index.js

Any suggestion?

dtex, 2017-03-08:
Which joystick are you using, and can we see a pic of your wiring?

jdnichollsc, 2017-03-08:
Hi man, thanks for your quickly response!

Check the pic please
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

Thanks, Nicholls

dtex, 2017-03-08:
Cool. A few of more questions:

You are using ```t2 run``` not ```t2 push``` correct?

Where does the "SW" pin on the joystick go?

Who makes this joystick?

jdnichollsc, 2017-03-08:
Thanks!
Yes, I'm using t2 run to test. SW isn't connected and I'm trying to do the following example but using **Tessel 2** => http://johnny-five.io/examples/joystick/

dtex, 2017-03-08:
One thing that comes to mind is the 5v supply might not share a ground with the Tessel port. Can you try using the gnd pin on port B instead of the ground next to the 5v pin?

jdnichollsc, 2017-03-08:
Check the console output:
```js
D:\Electronica\Tessel\Starter\example3>t2 run index.js
INFO Looking for your Tessel...
INFO Connected to Nicholls.
INFO Building project.
INFO Writing project to RAM on Nicholls (986.112 kB)...
INFO Deployed.
INFO Running index.js...
1474488778815 Device(s) Tessel 2 (Nicholls)
1474488778968 Connected Tessel 2 (Nicholls)
1474488779024 Repl Initialized
>> Testing...
Joystick
  x :  0
  y :  0
--------------------------------------
Joystick
  x :  0.005870841443538666
  y :  -0.001956947147846222
--------------------------------------
```

But the change event of the joystick doesn't work

dtex, 2017-03-08:
I missed the confused emoji there. My comment about using the gnd on port B instead of the gnd next to the 5V pin is based on a suspicion that w/o a common baseline on gnd you will not get good analog readings.

Notice in [this diagram](https://cdn.sparkfun.com/assets/learn_tutorials/5/3/7/motor-diagram.png) that they are not using the gnd pin next to 5VIN. Everything is grounded on Port A's gnd pin.

jdnichollsc, 2017-03-08:
Hi @dtex,
My confused emoji is because I have the same issue using the gnd on port B :(

rwaldron, 2017-03-08:
Have you tried any other pin combo on port B? That is, not 0 and 1?

jdnichollsc, 2017-03-08:
Hi @rwaldron! Yes but the same result.

boneskull, 2017-03-09:
@jdnichollsc I have a module just like that. Let me try it.

boneskull, 2017-03-09:
@jdnichollsc I can reproduce wonky behavior here.

Basically, the first few readings are OK (though you'd think a joystick at rest wouldn't produce so much data, but it's a piece of garbage anyhow):

```
1489044263452 Device(s) Tessel 2 (bloath)
1489044263609 Connected Tessel 2 (bloath)
1489044263666 Repl Initialized
>> Joystick
  x :  0
  y :  0
--------------------------------------
Joystick
  x :  0.011741682887077332
  y :  -0.011741682887077332
--------------------------------------
Joystick
  x :  0
  y :  -0.013698630034923553
--------------------------------------
Joystick
  x :  0.017612524330615997
  y :  -0.00978473573923111
--------------------------------------
Joystick
  x :  0.011741682887077332
  y :  -0.017612524330615997
--------------------------------------
Joystick
  x :  0.007827788591384888
  y :  0.003913894295692444
--------------------------------------
Joystick
  x :  0
  y :  -0.005870841443538666
--------------------------------------
Joystick
  x :  0
  y :  0.007827788591384888
--------------------------------------
Joystick
  x :  0.003913894295692444
  y :  -0.005870841443538666
--------------------------------------
Joystick
  x :  0.015655577182769775
  y :  -0.007827788591384888
--------------------------------------
Joystick
  x :  0.015655577182769775
  y :  -0.005870841443538666
^C^C
```

...those are my `SIGINT`s, since it froze at that point.

Speculation:  `Joystick` doesn't extend `Sensor`, so I'm not able to set the read frequency, afaik--it's just a firehose.  Applying [throttle](https://lodash.com/docs/4.17.4#throttle) to the callback doesn't seem to make a difference, so I'd start looking somewhere other than `process.stdout`.

Here's my setup, which is over USB:

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

What is this joystick?  It's a generic clone of a generic Keyes module.  $0.55, shipped free.

dtex, 2017-03-09:
I've ordered one.

jdnichollsc, 2017-03-21:
Any update guys? :)

dtex, 2017-03-21:
Mine hasn't arrived yet. Seller's tracking app doesn't work so I opened a ticket with the seller to find out what's up.

rwaldron, 2017-03-22:
I have that same Keyes joystick, as well as several other brands, but most are in New York and I'm currently in Boston. On hand I have:

- Keyes
- Sainsmart

...And they look very similar—probably produced by same manufacturer, but at different times. I'll use the Keyes joystick, with this program:

```js
var Tessel = require("tessel-io");
var five = require("johnny-five");
var board = new five.Board({
  io: new Tessel()
});

board.on("ready", function() {
  var joystick = new five.Joystick({
    pins: ["B6", "B7"]
  });

  joystick.on("change", function() {
    console.log("Joystick");
    console.log("  x : ", this.x);
    console.log("  y : ", this.y);
    console.log("--------------------------------------");
  });
});
```

Before I dive into my testing, I need to explain something: `t2` will try to connect to your Tessel by USB or Wifi, which it chooses is only determined by which discovery process completes quicker. Deployment is _almost_ identical for both, differing only in the constraints imposed by the method, ie. ssh or usb. Either way, your code is deployed and executed and everything is cool... Unless your program is console.log'ing... If the program was deployed and initiated over USB, it's subject to limited throughput... too much output can overwhelm and subsequently crash the remote process. This behaviour is actually totally ok, because ultimately programs running on a Tessel won't be logging to console anyway (when pushed into flash memory). You can force the deployment to occur over wifi with: `t2 run index.js --lan`.

All of that aside, I was able to run the program above with the Keyes joystick (actually both, but I don't think that makes a difference) and observe the behavior that I expect: a lot of change events, logging at a uselessly high rate. Try the `--lan` flag and report back. We'll work through this together ;)

rwaldron, 2017-03-31:
Any updates?

dtex, 2017-04-02:
I was able to replicate this today. With just the joystick I had the same experience as Rick, but once I started adding devices it would just freeze up after a few seconds.

I think @boneskull is on to something. It would be a good idea to just wrap a pair of sensors here.

boneskull, 2017-04-02:
Is this "USB bottleneck" unique to the Tessel? I've never had any such issue with opening serial ports on other devices. They all dump serial data with impunity.

I'm pretty sure I reproduced the same thing with `--lan`. Regardless, the above output I pasted is literally everything. That's not a terribly large amount of data; color me surprised if it causes a buffer problem.

rwaldron, 2017-04-04:
> Is this "USB bottleneck" unique to the Tessel? I've never had any such issue with opening serial ports on other devices. They all dump serial data with impunity.

It's only a "bottleneck" in the sense that USB connections on the Tessel 2 were never intended to be used for anything like this. Programs that are deployed to the Tessel 2's flash won't be logging to a console.

> That's not a terribly large amount of data; color me surprised if it causes a buffer problem.

Here is the source if you'd like to try and optimize:

- https://github.com/tessel/t2-firmware/blob/master/firmware/usb.c
- https://github.com/tessel/t2-firmware/blob/master/firmware/usbpipe.c
- https://github.com/tessel/t2-firmware/blob/master/firmware/usbserial.c
- https://github.com/tessel/t2-firmware/blob/master/boot/usb.c

boneskull, 2017-04-04:
> Programs that are deployed to the Tessel 2's flash won't be logging to a console.

Yes, but neither will my Arduino.  :smile:  Until I'm ready to stuff it in an enclosure and put my firmware "in production", I use `Serial.println()` extensively--sometimes dumping stupid amounts of data.

If we're sure the culprit is the USB driver and the problem *isn't* already known, a new issue should be created in `t2-firmware`.

@jdnichollsc Can you create a new joystick class which extends `Sensor`, and retains the implementation of the current J5 code?  Then, you can reduce the read frequency.  That might help.

Assuming it works, I'm not convinced this workaround needs to be committed to J5.  Besides the obvious semantic disagreement, *any* large+fast amount of output over Tessel 2's USB could cause the same crash.  Pretty sure neither J5 proper nor `tessel-io` can do anything about it?

dtex, 2017-04-21:
@jdnichollsc So, I found a cure on my end. I'm embarrassed to say that a simple ```t2 update``` did the trick. It was an Tessel I hadn't used in a while and was running 0.0.13. I updated to 0.0.16 and the problem went away.

Note that I haven't left it running for a particularly long time, but so far so good.

rwaldron, 2017-04-21:
Ohhhhhhhh. Gah. I should've remembered to offer this suggestion :(

dtex, 2017-04-26:
@jdnichollsc I spent some more time with this and found that it was still freezing (it was just less consistent). @rwaldron made some changes to tessel-io which are available in version 0.11.0. Using a T2 and the same joystick from your picture (as best I can tell) it now works without freezing.

Just ```npm install tessel-io```

Please let us know if it works for you.

jdnichollsc, 2017-04-26:
Ohh sorry guys, I changed jobs and I was very lost. Let me check your comments and try here!
Thanks for the amazing help! 👍

jdnichollsc, 2017-04-28:
Hi @dtex @rwaldron @boneskull
Works beautiful with the version 0.11.0! Thanks for the amazing help! 💯
Let me follow on Github! I owe you guys a beer! haha 🍻

Guys, what's the correct way to connect via LAN?

```
jdnichollsc:example3 jdnichollsc$ t2 provision
INFO Looking for your Tessel...
INFO Connected to Nicholls.
INFO Authenticating Tessel with public key...
INFO Tessel is already authenticated with this computer.
jdnichollsc:example3 jdnichollsc$ t2 run index.js --lan
INFO Looking for your Tessel...
WARN No Authorized Tessels Found.
jdnichollsc:example3 jdnichollsc$
```
Thanks in advance 🕹 👍

dtex, 2017-04-28:
Have you followed the instructions here:

http://tessel.github.io/t2-start/wifi.html

If so, what's it saying after you run t2 wifi ?

rwaldron, 2017-04-28:
@jdnichollsc so glad to hear that this was resolved.

I'm going to ping @hipsterbrown for additional support on any wifi issues :)

HipsterBrown, 2017-04-28:
:+1: to @dtex pointer to http://tessel.github.io/t2-start/wifi.html

I'll try to help if there are any issues.

dtex, 2017-08-17:
Looks like the original issue was solved so closing.

@jdnichollsc If you are still having issues with the T2 wifi, I'd ask for help over on their [Slack channel](https://tessel.slack.com/messages/C04R290NJ/). You'll find a lot of the same folks that were on this thread as well as a bunch of other Tessel experts who can help.

Closed 2017-08-17.

Thread 1322 (2017-04-12):

motor lib driver for Pololu VNH5019

zoobot, 2017-04-12:
Not sure if this is the right place to ask about this.
The Pololu VNH5019 motor driver is not represented in the johnny-five library but when I looked at the code, starting at line 1022, looks like you support another Pololu motor driver.
I tried calling them about it to see what is needed but all the techs are on lunch right now.

Is this all the code needed for their motor shield? just pin numbers? Could I just as easily use this for my driver (VNH5019)?

Johnny-five is really cool.
Thanks

https://github.com/rwaldron/johnny-five/blob/master/lib/motor.js

  POLOLU_DRV8835_SHIELD: {
    M1: {
      pins: {
        pwm: 9,
        dir: 7
      }
    },
    M2: {
      pins: {
        pwm: 10,
        dir: 8
      }
    }
  },

dtex, 2017-04-12:
Hi @Zoobot

The default pin mappings on your shield are different then the 8835. This shield will work with Johnny-Five, but you have to explicitly set the pin numbers.

'''
var m1= new five.Motor([2, 4, 9]);
var m2= new five.Motor([7, 8, 10]);
'''
This shield also supports a current sensing pin and braking, though it's not yet clear to me how the braking works (tough to read github code on my phone).

zoobot, 2017-04-12:
Thanks @dtex! I will try that shortly. I am almost done wiring everything up.

zoobot, 2017-04-12:
@dtex That did not work...  tried 3 different motors just in case I got all lemons.
I am using a motion sensor too and that is working strangely with the shield. Now if I trigger it, it just keeps triggering forever after.
All is not hopeless though, at least the LED still works with the shield. I can still tell it to blink and it behaves very well! :)

Did I miss anything? (Other than server, etc)
board.on("ready", function() {
    console.log('Arduino connected');
    var led = new five.Led(13);
    var motion = new five.Motion(12);
    // var m1= new five.Motor([2, 4, 9]);
    // var m2= new five.Motor([7, 8, 10]);

    var m1 = new five.Motor({
      pins: {
        pwm: 2,
        dir: 4,
        cdir: 9
      }
    });
    var m2 = new five.Motor({
      pins: {
        pwm: 7,
        dir: 8,
        cdir: 10
      }
    });
m1.start(255);
}

dtex, 2017-04-12:
On that motor shield pin 12 is a diagnostic pin so it will collide with the Motion instance.

Try commenting out the motion code and see if your motor code works. I'm on a real computer now so I'll look at the docs for the shield and see if I overlooked something.

dtex, 2017-04-12:
What are you using to power the motors?

zoobot, 2017-04-12:
A variable power supply for electronic testing.
I talked with the Pololu tech and he said try hooking it up with their test code on Arduino to see if it works at all. I'll try that next. He had me directly power the pwm with 5v to drive it which did not work.
I moved commented out the motion sensor to no avail.
Im now on my phone, will report back once I try on Arduino.
I was so pleased with my soldering job but maybe it wasn't as good as I thought.

zoobot, 2017-04-13:
The Arduino test worked... motors and motor driver works... I'm relieved I didn't immediately fry my motor driver!
https://github.com/photodude/DualVNH5019MotorShieldMod3/blob/master/examples/Demo/Demo.ino

m1A, M1B, M2A, M2B are getting no voltage with the johnny-five, even though there's voltage coming in VIN. It is getting +5 on M1INA, M1INA, M2INA, M2INB though.

Let me know if you think of something to try. Thanks for all your help @dtex!!!

dtex, 2017-04-13:
I'm glad the shield works. So when you call m1.start(255) you read 5v on both M1INA and M1INB? Only one of the two should read a voltage so we're on to something there.

For grins, try ```m1.forward(255)```. I don't think it will make a difference, but it's an easy thing to test, I just want to make sure the direction is being initialized with a default.

I don't have that shield, but I do have some that use cdir pins. I won't be able to get to them until this weekend, but I will run some tests when I get there. If it works as expected, I will need to get one of those boards.

zoobot, 2017-04-13:
Both m1.forward(255) and m1.start(255) show +5 on the M1INA, M2INA pins but not voltage on the M#A or M#B pins..

The reason it was showing on all of them with the test is because it was changing directions so would go high on M1INA then M1INB. Not at the same time.

I tried this too: http://johnny-five.io/examples/motor-enable/ with these enable pins.
Digital 6	M1EN/DIAG	Motor 1 enable input/fault output
Digital 12	M2EN/DIAG	Motor 2 enable input/fault output

I am going to pick up Ada's driver and see if I can get that to work.

Are you in the bay area? If you are nearby, you are welcome to borrow this driver and test it.

dtex, 2017-04-13:
> Are you in the bay area?

I'm in Texas, but thank you for the offer. I've got one on the way from Pololu.

> Not at the same time.

Okay, that makes a lot more sense and is the expected behavior. Have you tried watching the voltage on the PWM pin?

> I tried this too

Those enable pins are a different animal than enable pins on other shields. The library sets them to output pins. I need to read the docs more to understand what they are supposed to do.

zoobot, 2017-04-13:
Cool, thanks! Let me know how it goes!!

The Pololu tech said those enable pins are high by default so shouldn't need to mess with it.

PWM pin is getting nothing with Johnny-five. However, with the test its going to 3V or so.

dtex, 2017-04-21:
Hi @zoobot,

My VNH5019 arrived today and I have it all soldered up. Probably tomorrow before I can actually test it though. I'll report back ASAP.

zoobot, 2017-04-22:
Great!! I am competing this robot on Sunday (if I finish on time). I'm still building and haven't weighed it yet but it feels heavy and I suspect the adafruit and arduino shields may be underpowered.

dtex, 2017-04-22:
Testing now. The problem is with the enable pin in J5. Should have an answer very soon.

dtex, 2017-04-22:
These are the correct signatures:

````
var m1= new five.Motor({
        pins: {
            pwm: 9,
            dir: 2,
            cdir: 4,
            enable: 6
        }
    });

    var m2= new five.Motor({
        pins: {
            pwm: 10,
            dir: 7,
            cdir: 8,
            enable: 12
        }
    });
````

and there was indeed a bug in Johnny-Five. I am the culprit.

I'll get a PR into Johnny-Five here shortly, but in the meantime here's a quick change you can make to get it working:

In /node_modules/johnny-five/lib/motor.js change line 740 from

````
if (typeof this.pins.enable !== "undefined" && !this.enabled) {
````

to

````
if (typeof this.pins.enable !== "undefined") {
````

zoobot, 2017-04-22:
@dtex You are the best!! Thank you so much!!

I'll add that and test ASAP!

dtex, 2017-04-24:
@zoobot Did it work?

zoobot, 2017-04-24:
I changed /node_modules/johnny-five/lib/motor.js line 740 to
if (typeof this.pins.enable !== "undefined") {

It didn’t work on mine. Did you make any other changes?

Am I missing something?
I can’t work on this again until Wednesday but will test again then.

const five = require("johnny-five");

let board = new five.Board();

board.on("ready", function() {
    console.log('Arduino connected');
    var led = new five.Led(13);

    var m1 = new five.Motor({
      pins: {
        pwm: 9,
        dir: 2,
        cdir: 4,
        enable: 6
      }
    });

    var m2 = new five.Motor({
      pins: {
        pwm: 10,
        dir: 7,
        cdir: 8,
        enable: 12
      }
    });
    console.log('motor ahead')
    m1.start(255);

    // m1.forward(255);
    m2.start(255);
});

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

dtex, 2017-04-25:
```start()```` doesn't enable a motor* which seems goofy I know. Try ```forward()``` or ```reverse()```. I'm going to revisit enable pins and state management because it certainly seems like ```start()``` should enable the motor.

dtex, 2017-04-25:
... or ```m1.enable().start(255)```

rwaldron, 2017-04-25:
I'm trying to remember if or why `enable` was treated as a separate operation. I can't help but think there was some rationale that was similar to an `Led` instance's `stop` and `off` semantics, ie. `stop` doesn't implicitly mean `off`...

dtex, 2017-04-25:
The enable state is a property of the motor controller, whereas direction and speed are states of the motor. A motor controller might be disabled by an emergency cut off, proximity sensor, or something like that. It might even be disabled by a system that is completely independent of Johnny-Five (for safety). So, we have this thing that can be independent and at the very least should be able to have an independently (and easily) managed state.

There are some very valid reasons for us not to allow this independent state. For example: It's confusing AF.

Reviewing the code, a newly instantiated motor be enabled by default. I don't see why the motor was ever disabled. I can confirm that when I was testing that shield the motor was disabled. My proposed "hack" was just a hack, it was not a real fix.

zoobot, 2017-04-25:
My bad, I thought I made the change to motor.js but I suspect I made the change on the disable instead of enable.

m2.start(), m2.forward(255) and m2.reverse(255) all work for m2.

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

>

I am confused by m1 because it is hot in both channels, M1A and M1B are both +.

I must have shorted it somehow though it looks fine and and they are somewhat far apart?

I am going to have to unsolder and resolder I guess.

>
Thanks for all your help!!

dtex, 2017-04-25:
> I don't see why the motor was ever disabled.

```if (typeof this.pins.enable !== "undefined" && !this.enabled) {```

Should have been

```if (typeof this.pins.enable !== "undefined" && !state.enabled) {```

I'll get this fixed, some tests written and a new PR in ASAP

mossfrond, 2017-07-02:
Has anyone gotten a VNH5019 shield working with Johnny Five?
Its not clear to me reading the above, and I'm unable to get the shield going using examples /motor.js mod above.
(I have run the shield using the example Pololu sketch, and I have verified the Leonardo works w/ J5. I have also modified the example above to blink its LED, which it does.)
Thanks!

dtex, 2017-08-12:
@mossfrond Sorry for the delayed response.

Yes it works... Or rather it will once [this PR lands](#1372)

zoobot, 2017-10-03:
Did the PR go through for this? Thanks

dtex, 2017-10-03:
Yes it did. As long as you have version 0.11.5 or later you should have this change.

________________________________
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

nofear87, 2017-11-21:
Whats the difference between stopping and braking? In Arduino lib they set bot inputs to low and reduce pwm. But why reducing pwm is useful when stopping the motor over inputs?

Another Question, for what you use enable pin? In Arduino Lib they use it just for reading the motor status (digitalRead)

dtex, 2017-11-21:
@nofear87 Which Arduino library is that?

nofear87, 2017-11-21:
@dtex: sorry I forgot to share it; [click me](https://github.com/pololu/dual-vnh5019-motor-shield/blob/master/DualVNH5019MotorShield.cpp)

dtex, 2017-11-21:
> Whats the difference between stopping and braking?

The VNH5019 supports slow decay breaking (as opposed to coasting). I don't think we've added that into J5 for this particular device.

> for what you use enable pin
In Johnny-Five the enable pin can be pulled low (or set high for some boards) to disable the motor. This driver allows you to also use the pin to check the state of the switch but that is not supported in J5.

nofear87, 2017-11-21:
@dtex: Thank you!

1. So using "brake" has the same affect as call "stop"? When I understand it correctly decay burns the remaining energy to stop the motor immediately. So when I set PWM to 255 the brake effect ist the strongest?

2. When I read it correctly one pin on the driver combine enable and diagnostic for one motor output. so i can simply switch betwenn analogRead and digitalWrite? Isn't the digital state lost when i switch to analogRead?

3. The shield allow me PWM operation up to 20 kHz. Can I configure pwm frequenzy via J5?

dtex, 2017-11-21:
> So when I set PWM to 255 the brake effect is the strongest?

As I understand it, yes but I haven't done a lot of testing on this. Calling brake in J5 on a CDIR motor set PWM to 255 and both inputs to High. It would be easy to add support for variable braking strength but it's not in there yet.

> So i can simply switch between digitalRead and digitalWrite?

I don't know the pin behavior well enough to know if you can just switch whenever you feel like it, and I also don't understand why you would want to use the enable pin to check state from J5 since the state is already known within your app. I think that pin would be valuable when you have two independent systems with the "other" system needing to check the state of a motor in a simple, direct way.

> Whats the difference between disabling and set m1ina, m1inb and pwm to zero?

Setting both m1ina and m1inb to low (or both to high) results in a short with motor braking if (and only if) PWM > 0. This detail is specific thought not exclusive to the VNH. On this device setting PWM to 0 disables both switches, leaving them in a floating state.

> Can I configure pwm frequency via J5?

The firmata protocol (how Johnny-Five ultimately communicates with the Arduino) does not support setting the PWM frequency. There is probably too much risk in letting a user do that because it could disrupt other timer dependent functions. If you really need a specific PWM frequency a custom build of firmata is probably the best way to handle this. Just curious, what do you hope to gain by changing the PWM frequency?

dtex, 2018-01-01:
I'm going to close this. If there are any questions outstanding, or I did a poor job answering before feel free to re-open.

Closed 2018-01-01.

Thread 1340 (2017-05-13):

2+ servos can't handle .to method frequently

under24, 2017-05-13:
I have a nodejs server and 3 servos.

I init the servos like this:

```
var servo1 = new five.Servo({
  address: 0x40,
  controller: "PCA9685",
  pin: 8,
});
...
```

I push values via socketio from front-end to the back-end where I set the values like this:

```
.on('change-angle', function(data) {
    servo1.to(data.value);
    servo2.to(data.value);
    servo3.to(data.value);
})
```

My problem is that the servos get laggy and unresponsive (in other words they begin to pile up the queue).
The issue can be observed only with 2+ servos. If I use it with 1 servo there's no delay and it's perfectly responsive no matter how frequently I push new data from the front-end.

P.S. I also tried like this and it doesn't help:
```
servo1.stop();
servo1.to(data.value);
servo2.stop();
servo2.to(data.value);
servo3.stop();
servo3.to(data.value);
```

dtex, 2017-05-13:
Hi @under24

Can you tell us more about your project? What environment is your host server on? Can you share the complete code? A video of the behavior could also be really helpful.

I'm sure you should be able to control that many servos. I have a project that uses 18 servos and each updates about 60 times per second (with a whole ton of other stuff going on). I will admit that I haven't done it with a PCA9685 so maybe this is an issue with I2C communications.

under24, 2017-05-13:
Here's a video: https://youtu.be/TJq6XeNXwZY
Listen to the servos making noise. With 1 servo it's perfect and as soon as I add one more servo it starts lagging horribly.

The project is in a complete mess. I am in just the middle of rewriting it, but anyway here you go here's the code:
[leg.zip](https://github.com/rwaldron/johnny-five/files/998863/leg.zip)
node server.js --> click and move the red circle

dtex, 2017-05-14:
I've got the code running, but need to run to the lab an pick up a couple of servos so I can test. Assuming I get the same behavior the first thing I'm going to try is bypassing the PCA9685 and see if the behavior still occurs (just hooking the servos up to pins on the Arduino).

under24, 2017-05-16:
@dtex do you have any news on it?

dtex, 2017-05-16:
Sorry, no I haven't been able to get to the servos but I will be at the lab tomorrow.

under24, 2017-05-16:
@dtex actually, I've already found a solution for it.
I2C seems to be unable to transfer data faster than 10 ms. Anything < 10ms will lag horribly.
The solution is very simple:

`    let prevDate = 0;

    const setValue = (value) => {
      a.to(value);
      b.to(value);
      c.to(value);
    }

    client.on('femur-servo-angle-changed', function(data) {
      if (+new Date() - prevDate >= 15 || prevDate == 0) {
        setValue(data.value);
        prevDate = +new Date();
      }
    });`

dtex, 2017-05-16:
Oh wow, that's really interesting. I had a project where I was seeing the same kind of servo jankiness on a Tessel 2 with a PCA9685.  I had assumed that the T2 just couldn't handle the IK calculations and that was my limiting factor, but I was updating 18 servos and each one was updated with a separate I2C message...

This changes my assumption about what the problem was.

I propose that we rename and reopen this issue.

under24, 2017-05-18:
@dtex What do i rename it to?

Here's my solution for this kind of bottleneck with servos:

I've added a new property for the class Servo:
`throttle: [Boolean] [default: false]`

So you just add it to every servo class and push the data as frequently as  you want and it will automatically be throttled down to 20ms per data batch allowing your expander boards to work perfectly.

servo init example:
```
  var a = new five.Servo({
    address: 0x40,
    controller: "PCA9685",
    pin: 8,
    invert: true,
    throttle: true
  });

  var b = new five.Servo({
    address: 0x40,
    controller: "PCA9685",
    range: [0, 180],
    pin: 15,
    throttle: true
  });
```

under24, 2017-06-24:
Hello @dtex.

Could you please review/include my solution to the framework? I think this is pretty neat if you work with sockets and multiple servos.

Or do I make a pull request and do it myself?

dtex, 2017-06-24:
I'm not sure this is something that should be fixed in Johnny-Five. It might belong in firmtata.js or firmata itself. To know where requires truly knowing where the bottleneck actually lies.

Are you certain it is a limitation of I2C, the PCA9685, or maybe it's something higher up the chain?

My assumption would be that socket-io is much more of a bottleneck than I2C. Do you have the same problem when the commands are not sent over socket-io?

Can we solve the problem in a better way. For example, should we update the Servos (note the plural) class and add the ability to pipe down multiple values in a single I2C data push instead of a separate push for each servo spaced out over time?

under24, 2017-06-27:
@dtex
It's not socket for sure. Because I only changed the back-end and it started working the way it should.
Plus I tested the performance and it's blazing fast.

How do we implement it with multiple values? How do we know when to expect multiple values? Do we send a batch and then collect a new batch in a span of some ms? Can you sketch some pseudo code?
Also, can you direct me where I can play with multiple values in one I2C data push?

dtex, 2017-06-27:
To see if writing multiple values in one push even works I would build a test case that requires only firmata.js and sends an I2C message that writes 64 consecutive register values (16 servos * 4 per servo) at once vs just the 4 we need for a single servo.

This is the [part of Johnny-Five](https://github.com/rwaldron/johnny-five/blob/master/lib/expander.js#L578-L729) that handles communication with the PCA-9685 and you can see [here](https://github.com/rwaldron/johnny-five/blob/master/lib/expander.js#L689-L693) where we are only writing to four register values. You can crib code from here and modify it to support writing for N servos at once (this.io is an instance of firmata.js in your case).

If all that works, we would need to modify Johnny-Five Servos so that it has an awareness of situations where writing multiple servo values at once makes sense. I could even see adding a command to the firmata protocol to support this for non-I2C connected servos. We could modify Servos.to so it would handle this new message style and not just delegate to Servo.to.

This is not a trivial investigation so I totally understand if you don't want to take it on. I'm interested in getting to the bottom of it for my own projects, but I can't imagine that I will get around to it anytime soon.

**Practical Alternatives:**
A) Are you only controlling two servos? Ditch the PCA-9685 and just wire directly to the Arduino. Like I said earlier, I've done this with 18 servos at a time (on a mega) with great results.
B) Monkey-patch J5 with your fix
C) Create a wrapper for Servo that throttles write speeds

dtex, 2018-01-11:
Hi @under24 ,

One of the things that came out of this discussion was the realization that it would be helpful to send multiple servo writes in a single i2c message. It's one of those features that will require a fair amount of work and we just haven't gotten to it yet. Rather than leave this languishing as an open issue we have created a [Requested Features](../wiki/Requested-Features) page and added the request for bulk servo writes there.

Closed 2018-01-11.

Thread 1347 (2017-05-26):

Error using Configurable Firmata trough Wifi ESP8266

rikyoshiro, 2017-05-26:
This is my first try using johnny-five as my programming language for arduino and others,
I found something interesting in the net that we can open connection through an ESP8266 module to use a J5 without any serial cable. I try to compile some information from J5 example and other site to set up a thermometer using a DS18B20.
When i try to use configurablefirmata and J5 example using a serial cable it worked well but the problem comes when I try to combine it with ESP8266. Here is what I did:

Download "configurableFirmata" to my UNO,
flash the ESP8266 it with some binary code:

> (https://gist.github.com/ajfisher/5fe60fe7d8c49b3223f0)

then connect it to UNO and set my ESP8266 as an access point,

> (https://medium.com/@imkiran/connecting-johnny-five-arduino-raspberry-pi-etc-over-wifi-to-the-pc-using-esp8266-a10348fdb300)

and then
here is what I got:
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

and here is the code that I use:
```
var VirtualSerialPort = require('udp-serial').SerialPort;
var firmata = require('firmata');
var five = require("johnny-five");
var sp = new VirtualSerialPort({
    host: '192.168.4.1'
});
io.once('ready', function(){
  console.log('Io Connected');
  io.isReady = true;

  var board = new five.Board({io: io,repl:true});

  board.on("ready", function() {
  // This requires OneWire support using the ConfigurableFirmata
    var thermometer = new five.Thermometer({
        controller: "DS18B20",
        pin: 2
        });

    thermometer.on("change", function() {
    console.log(this.celsius + "°C");
    // console.log("0x" + this.address.toString(16));
  });
});
});
```
I am sorry I am really new to this javascript thingies :)

soundanalogous, 2017-05-26:
Which ESP8266 module are you using? The OneWire library bundled with ConfigurableFirmata supports the ESP8266 so you should be able to install ConfigurableFirmata directly on the ESP8266 and not need the Uno at all.

rikyoshiro, 2017-05-26:
Actually I use NODE MCU LUA, yea I know that we can use that single board as a main board but actually I need a lot of port and function like pwm and others. Here the link product that I use

> http://nodemcu.com/index_en.html#fr_54747661d775ef1a3600009e

soundanalogous, 2017-05-27:
Have you tried connecting the Uno directly to your computer to isolate whether or not the issue is related to OneWire or to the WiFi bridge?

rikyoshiro, 2017-05-27:
I have tried connecting uno directly to my PC using configurable firmata, and it worked. Wifi bridge? is that related? I tought my problem above is about 'device read timeout'. Never check about that.

soundanalogous, 2017-05-27:
You have several layers of complexity so it's helpful to isolate exactly which one is causing the issue:

1. OneWire in johnny-five (try using the thermometer with the Uno connected to your computer)
2. ESP8266 Wi-Fi bridge (try blinking an LED on the Uno with the ESP8266 connected to the Uno)

Also check the amount of memory available on the Uno. If you have all of the Firmata features included in ConfigurableFirmata you will be very near the Uno's memory limit which will lead to issues, but it seems OK since the first test case I listed above sounds like it is working for you.

rikyoshiro, 2017-05-27:
Thanks for your advice let me try it first. I will post the result later.

dtex, 2018-01-16:
Hi @rikyoshiro

Wanted to ping you before I close this. Do you have any results to share?

rikyoshiro, 2018-01-16:
Hi @dtex
I still dont have any result tho. I am sorry. but you can close it

Closed 2018-01-16.

Thread 1364 (2017-07-13):

Ping Api is not Available

salmanfarisvp, 2017-07-13:
- http://johnny-five.io/api/ping is not avilable
-
-  where i can connect my ultrasonic(HC-SR04) sensor to arduino. (http://johnny-five.io/examples/radar/)
    ( Servo and webserver is working fine , )

fivdi, 2017-07-13:
The HC-SR04 and additional proximity sensors are documented at http://johnny-five.io/api/proximity
There's an example circuit for a HC-SR04 on the same page at http://johnny-five.io/api/proximity/#hcsr04parallax-ping-

Did you find the link http://johnny-five.io/api/ping somewhere in the documentation? If so, can you say where please as the resource linked to doesn't exist (which you have already noticed)

fivdi, 2017-07-13:
One additional point. As special version Firmata called PingFirmata is needed for HC-SR04 proximity sensors. See http://johnny-five.io/api/proximity/#pingfirmata.

salmanfarisvp, 2017-07-13:
Thanks , i uploaded the `pingfirmata ` ,  where i nedd to connect the `HC-SR04 `pin (Echo and Trig) ..?

fivdi, 2017-07-13:
Please take a look at the first response above. There is a link pointing directly to the information you need.

salmanfarisvp, 2017-07-13:
i connected Echo and Tring on Arduino pin D7 , but did't work

```
 // ping instance (distance detection)
  ping = new five.Ping(7);
```

fivdi, 2017-07-13:
Does it work if `ping = new five.Ping(7);` is replaced with:
```js
ping = new five.Proximity({
  controller: "HCSR04",
  pin: 7
});
```

fivdi, 2017-07-13:
The [Radar](http://johnny-five.io/examples/radar/) example appears to be a little dated. It contains the dead link to http://johnny-five.io/api/ping in section [Component Classes in this example](http://johnny-five.io/examples/radar/#component-classes-in-this-example).

salmanfarisvp, 2017-07-13:
thanks , what i need to work this

```
C:\Users\node radar.js
Option log level is not valid. Please refer to the README.
1499934123487 Available COM24,COM1
1499934123527 Connected COM24
1499934127412 Repl Initialized
```

fivdi, 2017-07-15:
@salmanfarisvp Is the HC-SR04 working now or are there still issues? The message `Option log level is not valid. Please refer to the README.` is related to socket.io.

salmanfarisvp, 2017-07-15:
@fivdi yeah , facing same issue , can you please solve it .
we are organizing a johnny five meetup today after-noon
https://www.meetup.com/Hackster-Hardware-Meetup-Kerala/events/241597915/

fivdi, 2017-07-15:
I can take a look at it but I'm afraid not by this afternoon.

salmanfarisvp, 2017-07-15:
thank , that's ok  :-)

fivdi, 2017-07-15:
The following program works fine for me:
```js
var five = require("johnny-five");
var board = new five.Board();

board.on("ready", function() {
  var proximity = new five.Proximity({
    controller: "HCSR04",
    pin: 7
  });

  proximity.on("data", function() {
    console.log("cm: ", this.cm);
  });
});
```
Here's some output:
```
$ node ping.js
1500109626850 Available /dev/ttyACM0
1500109626872 Connected /dev/ttyACM0
1500109630570 Repl Initialized
>> cm:  6.306
cm:  6.306
cm:  6.186
cm:  6.186
cm:  6.186
cm:  6.306
cm:  6.306
cm:  6.306
cm:  6.168
cm:  6.168
cm:  6.168
cm:  6.254
cm:  6.254
cm:  6.254
cm:  5.808
cm:  5.808
cm:  5.808
cm:  5.808
cm:  5.808
cm:  5.808
cm:  5.79
cm:  5.79
cm:  5.79
cm:  5.79
cm:  5.79
cm:  5.79
cm:  5.79
cm:  5.79
cm:  5.704
cm:  5.704
cm:  5.704
cm:  5.808
cm:  5.808
cm:  5.808
cm:  5.808
cm:  5.808
cm:  5.808
cm:  5.79
cm:  5.79
cm:  5.79

(To exit, press ^C again or type .exit)
>> cm:  5.808
cm:  5.808
cm:  5.808
cm:  5.704
cm:  5.704
cm:  5.704
cm:  5.704
cm:  5.704
cm:  5.704

1500109631874 Board Closing.
$
```
The version of PingFirmata used can be found at:  https://gist.githubusercontent.com/rwaldron/0519fcd5c48bfe43b827/raw/f17fb09b92ed04722953823d9416649ff380c35b/PingFirmata.ino

It doesn't look like there's an issue with Johnny-Five.

salmanfarisvp, 2017-07-15:
yeah , it  works fine , but problem while running the radar.js  `(http://johnny-five.io/examples/radar/)`

fivdi, 2017-07-16:
The radar example (unmodified) works fine for me. Note that radar.js was last modified on Dec 17 2013. At the time the latest version of socket.io was v0.9.16 so this was the version I installed (`npm i socket.io@0.9.16`)

Today the latest version of socket.io is v2.0.3. If you want to used socket.io v2.0.3 you'll need to update the  relevant code accordingly.

salmanfarisvp, 2017-07-17:
thanks , i Depreciated  socket.io v0.9.16 , and now i got this error .

```
info  - socket.io started
(node:4792) DeprecationWarning: process.EventEmitter is deprecated. Use require('events') instead
```

fivdi, 2017-07-17:
That's only a warning not an error. It can be ignored. I saw it too.

salmanfarisvp, 2017-07-17:
and nothing happen

fivdi, 2017-07-17:
As mentioned above it works fine for me. What does localhost:8080 display?

salmanfarisvp, 2017-07-17:
just the image (green radar screen )

fivdi, 2017-07-17:
What's the output of the following program?
```js
var five = require("johnny-five");
var board = new five.Board();

board.on("ready", function() {
  var proximity = new five.Ping(7);;

  proximity.on("data", function() {
    console.log("cm: ", this.cm);
  });
});
```

salmanfarisvp, 2017-07-17:
yeah , it's working fine and thanks a lot for your help , now working fine ,
i just used
 `ping = new five.Ping(7);`
instead of
```
board.on("ready", function() {
  var proximity = new five.Proximity({
    controller: "HCSR04",
    pin: 7
  });
```

Closed 2017-07-17.

Thread 1382 (2017-08-24):

Issue with servo.ccw(1)

ritesh2014, 2017-08-24:
I am testing a continuous servo - Tower Pro MG995 for clockwise and anticlockwise movement.

While this works - servo.cw(1) ----servo rotates in the anticlockwise direction continuously
This does not works - servo.ccw(1) ------actually the servo move a bit in the clockwise direction and then stops.
I am testing on Edison. Here is the code -

var five = require("johnny-five");
var Edison = require("edison-io");
var board = new five.Board({
  io: new Edison()
});

board.on("ready", function() {

  var servo = new five.Servo({
    pin: 5,
    type: "continuous"
  });
     servo.cw(1); //works fine
   //servo.ccw(1);//does not works...it stops after moving a little in the opposite direction
});

I am not using any motor shield. The servo is directly connected to the arduino board pins.

dtex, 2017-08-24:
Are you using external power for the servo or is it powered off the Edison?

ritesh2014, 2017-08-25:
Its powered off the Edison but the edison is connected to external power source (via DC adapter NOT through USB). The servo rotates fine in one direction but when I use CCCW(), it moves a bit in the opposite direction (say about 30 to 40 degree) and then stops.

dtex, 2017-08-25:
If invert is true then ccw becomes cw (the same value is sent to the servo).

I'm curious if your program crashes when this happens or if otherwise it keeps on working. For example, if you set an LED to blink does it keep blinking even after the servo stops?

If blink keeps working this could be an issue with the PWM range on your servo. I checked the TowerPro site and couldn't find PWM range info, but it should be standard so this may just be an anomalous servo.

Fortunately there is an undocumented feature (that needs to change) in Johnny-Five that let's you control the PWM range. The default pwmRange is ```[450, 1850]```.

Try this:
````
var servo = new five.Servo({
    pin: 5,
    type: "continuous",
    pwmRange: [650, 1650]
});
````

I honestly don't know what the expected behavior should be when the pwm range of the servo is exceeded, but I do know that when you don't reach the limit on either end you are not getting full speed. If narrowing the range works, you could experiment to find the max and min values for your specific servo.

ritesh2014, 2017-08-25:
When I use pwmRange: [650, 1650] , I get the error -

>> ERROR: /home/root/.node_app_slot/node_modules/johnny-five/lib/servo.js:56
          this.io.servoConfig(this.pin, opts.pwmRange[0], opts.pwmRange[1]);
                  ^

TypeError: this.io.servoConfig is not a function
    at Servo.Controllers.Standard.initialize.value (/home/root/.node_app_slot/node_modules/johnny-five/lib/servo.js:56:19)
    at new Servo (/home/root/.node_app_slot/node_modules/johnny-five/lib/servo.js:188:8)
    at Board.<anonymous> (/home/root/.node_app_slot/main.js:9:18)
    at emitNone (events.js:72:20)
    at Board.emit (events.js:166:7)
    at nextTickCallbackWith0Args (node.js:420:9)
    at process._tickDomainCallback (node.js:390:13)
    at Function.Module.runMain (module.js:443:11)
    at startup (node.js:139:18)
    at node.js:968:3

dtex, 2017-08-25:
Doh! I forgot... edison-io doesn't have that method. Let's fake it. Try:
````servo.ccw(0.9)````

dtex, 2017-08-25:
Oh wait... edison-io/galileo-io does have that method. What version are you running?

ritesh2014, 2017-08-25:
So I updated to latest version -
edison-io - 0.10.0
johnny-five - 0.11.6

The code pwmRange: [650, 1650] does not throws an error now but the servo does not works both for CW() and CCW().
It does not works even if I use the default pwmRange: [450, 1850] as you mentioned before.

rwaldron, 2017-08-25:
> I am testing a continuous servo - Tower Pro MG995 for clockwise and anticlockwise movement.

The Tower Pro MG995 isn't a continuous rotation servo by default, but can be modified to support that mode. Did you modify the servo?

ritesh2014, 2017-08-25:
Tower Pro MG995 servo has both continuous and standard version. I purchased the continuous one and it rotates fine in one direction. I did not modify it.

rwaldron, 2017-08-25:
Can you link to wherever you bought it from? All the documentation that I've seen shows that Tower Pro MG995 can being modified to support continuous rotation, but is not a continuous rotation servo by default. Incidentally, the behavior you're seeing is what happens when trying to control a standard servo by using a `Servo` instance with `type: "continuous"`, ie. only one direction works.

ritesh2014, 2017-08-25:
I checked couple of sites when looking for continuous servo but bought it from a local shop (same servo) since the delivery was taking long. Here are the online links -
http://www.ebay.in/itm/TowerPro-MG995-Continuous-rotation-360-Metal-Gear-Servo-Motor-9-2kg-/172695698943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

https://robu.in/product/towerpro-mg995-continuous-rotation-360-metal-gear-servo-motor-9-2kg/

rwaldron, 2017-08-25:
Also, there is no continuous rotation variant on the Tower Pro website: http://www.towerpro.com.tw/product-category/servos-parts/x-large-servo/

dtex, 2017-08-25:
Well, that's not progress is it? Does it work if you remove the pwmRange option completely?

rwaldron, 2017-08-25:
On this page: https://robu.in/product/towerpro-mg995-continuous-rotation-360-metal-gear-servo-motor-9-2kg/

> TowerPro MG995 Metal Gear Servo Motor is a high-speed standard servo can rotate approximately 120 degrees (60 in each direction).

Which is standard servo behavior, not continuous. The other link is the same source "robu.in".

You should pop the case open and see if there is a stopper, as shown here: http://www.instructables.com/id/Convert-Towerpro-MG995-servo-to-continuous-rotatio/#step5

ritesh2014, 2017-08-25:
ok, I will proceed to open the case now but just mentioning again that the servo moves continuously (rotates 360 degrees) when I use cw()

rwaldron, 2017-08-25:
@ritesh2014 wait! Don't open it yet! I read:

> servo rotates in the anticlockwise direction continuously

And must of lost that while reading through the rest of the thread. Let me see if I can try to reproduce (I will open one of my Tower Pro MG995)

ritesh2014, 2017-08-25:
:) waiting...lol
I was searching for the screwdriver now!

rwaldron, 2017-08-25:
Let's try something... Switch your code to the following:

```js
var five = require("johnny-five");
var Edison = require("edison-io");
var board = new five.Board({
  io: new Edison()
});

board.on("ready", function() {
  var servo = new five.Servo(5);

  servo.to(180); // what happens?

  setTimeout(function() {
    servo.to(0); // what happens?
  }, 3000);

});
```

ritesh2014, 2017-08-25:
I ran the code...

servo.to(180); // what happens? ----- the servo rotates 360 degrees continuously for 3 seconds till the below code is called and then stops

 setTimeout(function() {
    servo.to(0); // what happens? --------- stops the servo
  }, 3000);

rwaldron, 2017-08-25:
> servo.to(180); // what happens? ----- the servo rotates 360 degrees continuously for 3 seconds till the below code is called and then stops

Good.

> servo.to(0); // what happens? --------- stops the servo

Bad.

-------------------------------------------------

Now try this:

```js
var five = require("johnny-five");
var Edison = require("edison-io");
var board = new five.Board({
  io: new Edison()
});

board.on("ready", function() {
  var degree = 180;
  var servo = new five.Servo(5);

  function update() {
    console.log("Setting degree: ", degree);
    console.log("Observe and record behavior!");
    servo.to(degree);

    setTimeout(function() {
      degree -= 10;
      if (degree) {
        update();
      } else {
        process.exit();
      }
    }, 3000);
  }

  update();
});
```

ritesh2014, 2017-08-25:
Well, something interesting happened...
The servo rotates 360 degrees (anticlockwise) till the countdown to 150 degrees and then after that moves in the opposite direction (clockwise) in small spikes for every 10 degree decrements till the end of countdown to 10 degrees and stops.
Here is the log -

>> Setting degree:  180
Observe and record behavior!
Setting degree:  170
Observe and record behavior!
Setting degree:  160
Observe and record behavior!
Setting degree:  150
Observe and record behavior!
Setting degree:  140
Observe and record behavior!
Setting degree:  130
Observe and record behavior!
Setting degree:  120
Observe and record behavior!
Setting degree:  110
Observe and record behavior!
Setting degree:  100
Observe and record behavior!
Setting degree:  90
Observe and record behavior!
Setting degree:  80
Observe and record behavior!
Setting degree:  70
Observe and record behavior!
Setting degree:  60
Observe and record behavior!
Setting degree:  50
Observe and record behavior!
Setting degree:  40
Observe and record behavior!
Setting degree:  30
Observe and record behavior!
Setting degree:  20
Observe and record behavior!
Setting degree:  10
Observe and record behavior!

dtex, 2017-08-25:
Do you have another one of those servos you can test with?

ritesh2014, 2017-08-25:
Yep, I have two servos (same ones) and tested on both with the same behavior.

dtex, 2017-08-25:
Are those "small spikes" actually ten degree movements? I wonder if these were incorrectly converted standard servos. Does the packaging look legit and actually say "Continuous Rotation" on it?

ritesh2014, 2017-08-25:
I think its a 10 degree movement. Both the servos came with no legit packaging so maybe its a converted servo. But if it is then can I make it move smoothly in clockwise direction (how it moves 360 degrees anticlockwise)

dtex, 2017-08-25:
On a standard servo there is a pot that is used to provide feedback so the servo can be positioned. It will regulate voltage being sent to the motor. CR servos don't need that pot. Given the results of Rick's clever test, it really sounds like the pot is still doing its job... sorta... In one direction only, which is like super weird.

In that conversion guide Rick linked to, one of the steps is to remove the pot altogether "for use in another project". The pot must still be in yours for it to even be able to move in 10 degree increments.

ritesh2014, 2017-08-25:
hmm...so I guess I have to open the case and take a look inside...will let you know the findings...thanks guys for all your help...really appreciate!!

rwaldron, 2017-08-26:
I think we just need to set a `deadband` high/low?

Try...

```js
var five = require("johnny-five");
var Edison = require("edison-io");
var board = new five.Board({
  io: new Edison()
});

board.on("ready", function() {
  var degree = 180;
  var servo = new five.Servo({
    pin: 5,
    type: "continuous",
    deadband: [155, 155] // some where around here?
  });
});
```

ritesh2014, 2017-08-26:
So I tried with the deadband range also -
board.on("ready", function() {
  var degree = 180;
  var servo = new five.Servo({
    pin: 5,
    type: "continuous",
    deadband: [155, 155] // i changed this to different values [150, 150], [157, 157], [160, 160] etc with no luck
  });
    servo.ccw(1);//does not works but cw(1) works
});

Then I opened the servo case. Here are the pics -
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

I cannot see the knob (or protrusion) which prevents the rotation. I could see a pot though - b5k-210. Do I need to do anything here...adjust or replace with resistors maybe. Will that work?

dtex, 2017-08-26:
I do think you will need to replace the pot with the resistors for it to work. Seeing the pic, I think I might have one of those servos at my lab. I'd be happy to try it out before you risk your servo, but now it looks like I may not be able to get to there until Thursday or Friday due to the storm.

ritesh2014, 2017-08-26:
I don't have the 2.2 k Ohm resistors handy. Lets see if I can get some tomorrow. If I get it then nothing's stopping me to try!!

ritesh2014, 2017-08-27:
It works!!!
But I did not use the resistors (though I managed to get the 2.2k ohms from an old tape player).
After opening the servo case, I removed the pot. The pot was connected to the gear assembly so I figured it was sending the feedback to the circuit.
I sent a servo.stop() signal but the servo kept moving. Then I adjusted the pot to stop the servo. I used some glue to hold that position.
After that I used the below code -
var five = require("johnny-five");
var Edison = require("edison-io");
var board = new five.Board({
  io: new Edison()
});

var five = require("johnny-five");
var Edison = require("edison-io");
var board = new five.Board({
  io: new Edison()
});

board.on("ready", function() {
   var servo = new five.Servo({
    pin: 5,
    type: "continuous",
  });
servo.cw();
    setTimeout(function() {
    servo.ccw(1); // what happens?
  }, 10000);

    setTimeout(function() {
    servo.stop(); // what happens?
  }, 20000);
});

The pot moved anticlockwise for 10 seconds and then clockwise for 10 seconds and then stopped after 10 more seconds.
Phew! and Eureka!!!

Closed 2017-08-27.

Thread 1386 (2017-08-31):

Ultrasonic sensor error

ritesh2014, 2017-08-31:
I was using the below code to read ultrasonic sensor (HC-SR04) value -
 new five.Proximity({
  controller: "HCSR04",
  pin: 7
but then I got the error - TypeError: this.io.pingRead is not a function.
Then I read somewhere that ping is not supported on edison so I used the - controller: "HCSR04I2CBACKPACK" code as @rwaldron had mentioned ----

var five = require("johnny-five");
var Edison = require("edison-io");
var board = new five.Board({
  io: new Edison()
});
board.on("ready", function() {
var proximity = new five.Proximity({
    controller: "HCSR04I2CBACKPACK",
    freq: 500,
  });
proximity.on("data", function() {
    console.log("Proximity: ");
    console.log("  cm  : ", this.cm);
    console.log("  in  : ", this.in);
    console.log("-----------------");
});
proximity.on("change", function() {
    console.log("The obstruction has moved.");
});

Now I am getting the below error -
ERROR: I2C: Could not read 2 Bytes from peripheral with address 0x27
ERROR: I2C: Could not read 2 Bytes from peripheral with address 0x27
Proximity:
  cm  :  0
  in  :  0
-----------------
The obstruction has moved.
ERROR: I2C: Could not read 2 Bytes from peripheral with address 0x27
ERROR: I2C: Could not read 2 Bytes from peripheral with address 0x27

I followed the same circuit diagram as mentioned on the J5 website. Somehow it felt weird that both the Trig and Echo pins are connected together in the diagram but I followed the same thing (soldered both these points and connected it to the I2C jack on my grove shield which is mounted on the arduino board).
Am I doing anything wrong? Is the sensor fine?

ritesh2014, 2017-09-11:
Just wanted to check if anyone looked into this...

rwaldron, 2017-09-11:
There's no way to troubleshoot this without seeing your actual circuit. Please provide a close up of your circuit's wiring and components, as clear as possible.

ritesh2014, 2017-09-12:
Here is how I have soldered the pins. The echo and trigger are soldered together as indicated in the J5 page. The wiring is then connected to the I2C jack on my grove shield.
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

Pls let me know if you need any other details.

fivdi, 2017-09-12:
If I'm not mistaken, the HC-SR04 should be connected to a backpack and not directly to the I2C jack on the grove shield. The I2C backpack should then be connect to the I2C jack on the Edison. Something like what's shown [here](http://johnny-five.io/api/proximity/#hcsr04-and-friends-i2c-backpack-) except an Edison is used rather than an Arduino.

rwaldron, 2017-09-12:
> If I'm not mistaken, the HC-SR04 should be connected to a backpack and not directly to the I2C jack on the grove shield.

@fivdi yep—this is what I was hoping to eliminate from potential issues, but wanted to see if my hunch appeared in the circuit itself.

ritesh2014, 2017-09-14:
In examples like - http://www.instructables.com/id/Intel-Edison-Distance-Bug-HC-SR04/ when using Arduino code, the Echo and Trig pins are connected to D7 and D8 on Grove shield. Is it possible to replicate this using Node Serial port? Or do we have to use I2C back pack?

fivdi, 2017-09-14:
@ritesh2014 Some Johnny-Five IO Plugins support what's call "ping" functionality and some don't. Whether or not an IO Plugin supports ping can be seen at http://johnny-five.io/platform-support/.

[Edison IO](http://johnny-five.io/platform-support/#intel-edison-arduino) doesn't support ping. If an IO Plugin doesn't support ping then an I2C backpack is required.

> Is it possible to replicate this using Node Serial port?

I'm afraid I don't understand how serialport could be used to help here.

ritesh2014, 2017-09-14:
Since I saw some examples (using Arduino program) where they are not using I2C backpack, I thought will it be possible to implement this in Javascript. Not necessarily using Johnny five but maybe lets say node mraa library or something else (bad choice when I mentioned serial port)...I am very new to IOT so maybe I am causing confusion here but I want to explore options before I go out and purchase an I2C backpack.

fivdi, 2017-09-14:
The Arduino program in the instructable linked to above uses `pulseIn` to measure distance. Here's the code:
```c
 digitalWrite(trigPin, LOW);
 delayMicroseconds(2);

 digitalWrite(trigPin, HIGH);
 delayMicroseconds(10);

 digitalWrite(trigPin, LOW);
 duration = pulseIn(echoPin, HIGH);

 //Calculate distance based on speed of sound
 distance = duration/58.2;
```

`pulseIn` is a blocking synchronous function. There are scenarios where `pulseIn` will run for 200 milliseconds, for example, if there is nothing in front of the sensor to detect and the sensor times out after 200 milliseconds. Synchronous calls that take so long to run are not a good idea in a large number of Johnny-Five programs as they will mess up the timing for many other things like pulsing LEDs and servos.

The synchronous nature of `pulseIn` is why backpacks are preferred in Johnny-Five. The blocking code can then run on the backpack.

There are asynchronous techniques that can measure distance using a HC-SR04. For example, there's an IO Plugin for the Raspberry Pi that uses a technique called alerts to [measure distance asychronously](https://github.com/fivdi/pi-io#measure-proximity-with-a-hc-sr04-using-separate-pins-for-trigger-and-echo). I'm not familiar enough with the Edison to say if something similar is possible there.

ritesh2014, 2017-09-14:
Thanks for the detailed explanation. One last thing. Will this I2C work -
https://www.amazon.com/Adafruit-i2c-SPI-character-backpack/dp/B00OKCON84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

Or can you please send me a link to buy the right one? I maybe asking for too much but I cannot figure out which I2C backpack I should buy

fivdi, 2017-09-14:
You're not asking too much. Lots of this stuff isn't easy to figure out.

The "Adafruit i2c / SPI character LCD backpack" linked to above is not the correct backpack to use.

As far as I remember the term "backpack" comes from Adafruit originally. It's basically a small expansion board for an Arduino UNO. There are other terms used in similar contexts. For example, expansion boards for the Raspberry Pi are often called "Hats", expansion boards for the BeagleBone are often called "Capes".

Johnny-Five borrowed the term "backpack" from Adafruit. In the Johnny-Five world a backpack is an Arduino Nano that runs custom software to control something, for example, a HC-SR04. The backpack communicates with the Johnny-Five world via I2C. A Johnny-Five backpack isn't restricted to communicating with an Arduino UNO via I2C. It can also communicate with a Raspberry Pi, BeagleBone or Edison via I2C.

There's an example of a Johnny-Five backpack [here](https://github.com/rwaldron/johnny-five/blob/master/docs/proximity-hcsr04-i2c.md). The Arduino Nano is the backpack. The backpack controls the HC-SR04 and communicates with the Arduino UNO via I2C.

Strictly speaking a Johnny-Five backpack need not be a Arduino Nano, it can be any type of microcontroller. If you have a Arduino UNO that could be used as a backpack too.

 A sketch or firmware is needed for the backpack. The sketches for some backpacks can be found [here](https://github.com/rwaldron/johnny-five/tree/master/firmwares). The sketch for HC-SR04 backpacks can be found [here](https://github.com/ajfisher/nodebots-hcsr04/tree/master/firmware/src/controller_src/hcsr04_backpack).

Additional Information:
http://johnny-five.io/news/introducing-i2c-component-backpacks/
http://johnny-five.io/news/hcsr04-i2c-backpack-support-lands/

What you need to buy is and Arduino Nano, something like [this](https://www.amazon.com/Arduino-Elegoo-ATmega328P-without-compatible/dp/B0713XK923). As mentioned above, if you already have an Arduino UNO that could also be used.

ritesh2014, 2017-09-15:
I can't thank you enough for providing all the information. I will procure the Nano board and configure. I will keep the issue open till then (incase if I run across any problems). Or if it needs to be closed then please go ahead and close it.

ritesh2014, 2017-09-19:
So, this is what I did after getting the Nano -

Followed this site for instructions - https://github.com/johnny-five-io/nodebots-interchange
Executed - `npm install nodebots-interchange`
Then executed -
```
C:\Program Files\nodejs\node_modules\npm\node_modules\.bin>interchange install hc-sr04 -a nano -p COM6 -i 0x27
Installing hc-sr04 from npm
+ nodebots-hcsr04@0.5.0
added 1 package and removed 330 packages in 61.751s
Manifest file incorrect
Manifest file error
The batch file cannot be found.
```

Connected the wires as shown in the J5 site -
VCC on sensor to +5V on Nano
Ground on sensor to Ground on Nano
Trig and Echo are soldered together and connected to D8 on Nano
A5 on Nano to SCL on Edison
A4 on Nano to SDA on Edison
VIN and Ground on Nano connected to Edison

After running the program I get -
ERROR: I2C: Could not read 2 Bytes from peripheral with address 0x27
ERROR: I2C: Could not read 2 Bytes from peripheral with address 0x27
ERROR: I2C: Could not read 2 Bytes from peripheral with address 0x27
Proximity:
  cm  :  0
  in  :  0
-----------------
The obstruction has moved.
ERROR: I2C: Could not read 2 Bytes from peripheral with address 0x27
ERROR: I2C: Could not read 2 Bytes from peripheral with address 0x27
ERROR: I2C: Could not read 2 Bytes from peripheral with address 0x27

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

Where am I going wrong? Is there any other way to test this?

fivdi, 2017-09-19:
It looks like the firmware wasn't flashed onto the Nano with the command `npm install nodebots-interchange` as the output indicates that there were errors:
```
C:\Program Files\nodejs\node_modules\npm\node_modules\.bin>interchange install hc-sr04 -a nano -p COM6 -i 0x27
Installing hc-sr04 from npm
+ nodebots-hcsr04@0.5.0
added 1 package and removed 330 packages in 61.751s
Manifest file incorrect
Manifest file error
The batch file cannot be found.
```
@ajfisher do you know what the problem could be here?

fivdi, 2017-09-19:
@ritesh2014 The output of `interchange install hc-sr04 -a nano -p COM6 -i 0x27` should look something like this:
```
Installing hc-sr04 from npm
+ nodebots-hcsr04@0.5.0
updated 1 package in 12.162s
connected
reset complete.
flashing, please wait...
flash complete.
Setting firmware details
Cleaning up. Installation complete.
```

ritesh2014, 2017-09-20:
Does this work on Windows? My Nano is connected to Windows on COM6 port and I am executing the commands. Or do I have to use a Linux machine?

ajfisher, 2017-09-20:
@ritesh2014 this looks like a pathing problem to me.

Please execute interchange from your project folder as it's looking for a path to your node_modules folder and not finding it is what I suspect.

Two options for you:

* cd to your project folder then run as `./node_modules/.bin/interchange ...` and that should work
* install interchange globally and then just run `interchange install... ` from your project folder and that should work as well.

ritesh2014, 2017-09-20:
@ajfisher I installed interchange globally and then executed - interchange install hc-sr04 -a nano -p COM6 -i 0x27. I got the same error -
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

And now npm again does not works. Executing npm -v gives error so I guess I have to repair it again!

ajfisher, 2017-09-20:
Try it using interchange install --interactive and see what happens?

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

ritesh2014, 2017-09-20:
This is what I get when using interactive -
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

ritesh2014, 2017-09-21:
There must be some kind of way out of here :)
@fivdi @ajfisher Okay so since this is not working...is there any alternate distance measuring sensor that I can use which does not uses this backpack thing...something which can directly plug into Edison? Basically I want to put this sensor in my vehicle to measure distance from a couple of centimeters to 5-6 meters.

ajfisher, 2017-09-21:
I'm really unsure what's going on here as it otherwise works ok.

Maybe try it this way instead:

```
interchange install git+https://github.com/ajfisher/nodebots-hcsr04 -a nano -p COM6
```

ritesh2014, 2017-09-21:
@ajfisher  This actually worked!!! Closing this issue. Thanks everyone for their help.

ajfisher, 2017-09-21:
Thanks @ritesh2014 can you do me a favour and just post all the details on your machine here as well so I can follow up and make sure there's nothing else the matter with the way the npm install is working?

Just need:

- OS
- Node Version
- NPM version

ritesh2014, 2017-09-22:
OS - Windows 10 Home
Node - 6.11.3
NPM - 5.4.2

Closed 2017-09-21.

Thread 1407 (2017-10-26):

Stepper: Runstate / Position tracking

Triadager, 2017-10-26:
Hey guys!

Sorry to be a pain but googling and experimenting for hours didn't get me anywhere.

I'm trying to control some steppers with an Arduino which gets its commands via Firmata. I want to implement some check whether to stepper is already moving if I issue another command. I figured this would be done with checking out the steppers "Runstate", but I couldn't get it to work at all. Did I misunderstand to what the "Runstate"-table on the stepper API page is referring to? If not, how can I access it? Could you maybe provide some example code on how to use these "Runstates"?

Another question regarding steppers: If I issue a different command while the stepper is moving, it'll interrupt the motion and the new command will be executed. Is there any possibility to track how many steps it already took? I'm using stepper driver boards like the A4988, so I'm thinking about just using another pin to monitor the pulses to the step pin, but I'm not sure if that's the most elegant solution. Any ideas?

Kind regards,

Triadager

dtex, 2017-10-26:
Hi @Triadager

I will try and help. I believe those runstate values were inserted for future functionality that was never implemented. They don't appear to do anything. I could be just looking in the wrong place, but I don't think that's the case here. There is an isRunning state but it is private. You could create your own isRunning variable that is set to true whenever you call step, and set to false in a step callback.

> Is there any possibility to track how many steps it already took?

Not yet. There is a new version of [configurableFirmata](http://firmatabuilder.com/) that adds a new AccelStepperFirmata feature that when coupled with [this pull request](https://github.com/firmata/firmata.js/pull/179) for firmata.js will let you know actual position reached, even when the stepper is interrupted by another command. I expect that PR to land soon. It is just waiting to be blessed by @rwaldron.

The new version of the Johnny-Five stepper class that supports AccelStepperFirmata is in progress but likely won't be ready for weeks, but you can totally use the firmata.js stepper stuff directly on the board.io object. It's much higher level than the other firmata methods so it feels very J5'ish when using it.

dtex, 2017-10-29:
I'm going to close this. If you have more questions, feel free to reopen, or open a new issue on the applicable repo.

Closed 2017-10-29.

Thread 1408 (2017-11-01):

How can I read temperature from a MAX31855K Thermocouple?

jazzpeh, 2017-11-01:
I am trying to read temperature output from my connected thermocouple sensor. I am using a breakout (MAX31855K Thermocouple Breakout) module which is not supported by johnny-five at the moment. Are there any ways to make this work?

Here's the link to the setup that I did: https://learn.sparkfun.com/tutorials/max31855k-thermocouple-breakout-hookup-guide/all

Thanks!

fivdi, 2017-11-01:
The MAX31855K is an SPI (Serial Peripheral Interface) device but Johnny-Five currently doesn't support SPI.

Relates issues:
https://github.com/rwaldron/io-plugins/issues/3
https://github.com/rwaldron/johnny-five/labels/Protocol%3ASPI

> Are there any ways to make this work?

It may be possible to bit bang SPI using [Pin](http://johnny-five.io/api/pin/) objects.

dtex, 2018-01-01:
Two paths you could pursue to add support:

1. Contribute to firmata and add SPI https://github.com/firmata/arduino/issues/245
2. Create a component backpack for this device http://johnny-five.io/news/introducing-i2c-component-backpacks/

dtex, 2018-01-11:
Hi @jazzpeh ,

Johnny-Five contributors and maintainers are loathe to close issues where someone has a need. We don't want anyone to ever feel that we don't care, but we just haven't gotten to this feature yet. Rather than leave it languishing as an open issue we have created a [Requested Features](../wiki/Requested-Features) page and added your request for the MAX31855K there.

Closed 2018-01-11.

Thread 1409 (2017-11-03):

GPIO pins on Raspberry Pi Zero

zoobot, 2017-11-03:
Hi
I want to use the moto zero motor controller with the raspberry pi zero.
Ideally I'd like to use Johnny-five but not sure if this is supported?

Are there any examples of Johnny-five Motors using GPIO pins? I'm trying to use raspi-io but getting errors:

so far looks like raspi-io is not supporting the Motor functions.
getting this error
/node_modules/raspi-io/node_modules/raspi-io-core/dist/index.js:489
        throw new Error('Unknown pin "' + pin + '"');
        ^
Error: Unknown pin "undefined"

the Johnny-five motors look like this
var motor3 = new five.Motor({
pins: {
dir: 'P1-23', // dir: 'GPIO11' ??
cdir: 'P1-16',
enable: 5,
invertPWM: true
}
});

With the python GPIO lib it looks like this:
import RPi.GPIO as GPIO
GPIO.setmode(GPIO.BCM)
Motor1A = 27
Motor1B = 24
Motor1Enable = 5

https://cdn.shopify.com/s/files/1/0176/3274/files/MotoZero_User_Guide_1.2.pdf

I just noticed raspi-io says it is fermata compatible. I am confused about that, isn't the point of using raspi-io to use the raspberry pi GPIO pins directly instead of going through an fermata arduino or something?... How does fermata come into this situation?
https://github.com/nebrius/raspi-io/wiki/Pin-Information

Thanks!

rwaldron, 2017-11-20:
> I just noticed raspi-io says it is fermata compatible. I am confused about that, isn't the point of using raspi-io to use the raspberry pi GPIO pins directly instead of going through an fermata arduino or something?..

It's interface "compatible" with https://github.com/firmata/firmata.js

> With the python GPIO lib it looks like this: ...

Which Raspberry Pi are you using?

> https://cdn.shopify.com/s/files/1/0176/3274/files/MotoZero_User_Guide_1.2.pdf

This document includes the following:

> All examples in this document use the GPIO.BCM mode

We'll have to ask @nebrius what impact this has on raspi-io

nebrius, 2017-11-20:
Related: https://github.com/nebrius/raspi-io/issues/100

> All examples in this document use the GPIO.BCM mode

Oh pin numbering on the Raspberry Pi, will you always be so complicated? /sarcasm

There are a variety of ways to refer to pin numbers on the Raspberry Pi, and each library takes a slightly different approach to how to number them.

Raspi IO follows the [Wiring Pi](https://projects.drogon.net/wiringpi-pin-numbering/) pin numbering scheme, but adds the ability to alias pins on top of this. The base number that Raspi IO uses is the _Wiring Pi_ number, which is neither the GPIO.BCM number _nor_ the GPIO.Board number. That said, you can use the BCM number in the format `GPIO##` or the Board number in the format `P#-#`.

In this case though, as we mentioned in the Raspi IO issue, there seems to be some sort of issue with aliasing though in this specific API. I haven't had a chance to test it yet though, so I'm not sure. I'll try and run some tests later today.

zoobot, 2017-11-20:
Thanks for answering!

I am using the raspberry pi zero w.
Sort of got the pins working with the motozero.
Didn’t get motor.forward to work, only reverse works. If I switch the physical motor wires, reverse works either way so I think something software is not quite right.

//works with reverse for motozero/raspberry pi zero
const raspi = require('raspi-io');
const five = require('johnny-five');
const board = new five.Board({
  io: new raspi({ enableSoftPwm: true, includePins: ['GPIO24', 'GPIO27', 'GPIO5', 'GPIO6', 'GPIO22', 'GPIO17', 'GPIO23', 'GPIO16', 'GPIO12', 'GPIO13', 'GPIO18', 'GPIO25']})
});

board.on('ready', () => {
  //pins for MotoZero and Raspberry Pi Zero W
  var motor1 = new five.Motor(['GPIO24', 'GPIO27', 'GPIO5']);
  var motor2 = new five.Motor(['GPIO6', 'GPIO22', 'GPIO17']);
  var motor3 = new five.Motor(['GPIO23', 'GPIO16', 'GPIO12']);
  var motor4 = new five.Motor(['GPIO13', 'GPIO18', 'GPIO25']);

  //console.log("Go dog go");
  //motor1.forward(200);
  //motor1.start(255)
  // board.wait(5000, function () {
  //  motor1.stop();
  // });

  console.log("Back dog back");
  motor1.reverse(200);
  board.wait(5000, function() {
    motor1.stop();
  });
});

I ran out of time so ended up using python version with Flask instead of Node/Express/raspi-io/johnny-five. Would love to test with Johnny-five/express though because I am having a timeout issue with the python version, it would be helpful to rule out Flask as the problem. Not sure if timeout is Nginx load balancing issue, websockets disconnect issue, or something with Flask.

rwaldron, 2017-11-20:
> , there seems to be some sort of issue with aliasing though in this specific API.

`Motor` class?

rwaldron, 2017-11-20:
For this...

> Didn’t get motor.forward to work, only reverse works.

Based on this...

```js
const raspi = require('raspi-io');
const five = require('johnny-five');
const board = new five.Board({
  io: new raspi({ enableSoftPwm: true, includePins: ['GPIO24', 'GPIO27', 'GPIO5', 'GPIO6', 'GPIO22', 'GPIO17', 'GPIO23', 'GPIO16', 'GPIO12', 'GPIO13', 'GPIO18', 'GPIO25']})
});

board.on('ready', () => {
  //pins for MotoZero and Raspberry Pi Zero W
  var motor1 = new five.Motor(['GPIO24', 'GPIO27', 'GPIO5']);
  var motor2 = new five.Motor(['GPIO6', 'GPIO22', 'GPIO17']);
  var motor3 = new five.Motor(['GPIO23', 'GPIO16', 'GPIO12']);
  var motor4 = new five.Motor(['GPIO13', 'GPIO18', 'GPIO25']);
```

- Perhaps you might not want all three pins to be PWM? (I have no idea, but I would check any documentation available)
- Did you try this test? http://johnny-five.io/api/motor/#situations-where-invertpwm-true-is-required

zoobot, 2017-11-20:
It looks like with enableSoftPwm, it just enables it as a blanket across any pins in includePins? I am not sure how to enable it only for certain pins. Some of those pi zero pins do have hardware PWM if I remember correctly...
https://cnpmjs.org/package/raspi-io <https://cnpmjs.org/package/raspi-io>

haven’t tried that test, I will do it this week. I would guess that invertpwm is not necessary if motor.reverse worked...
> Did you try this test? http://johnny-five.io/api/motor/#situations-where-invertpwm-true-is-required <http://johnny-five.io/api/motor/#situations-where-invertpwm-true-is-required>

I assumed the 3rd pin was enable after looking at the comments in motor.js inside the node lib but I am not really sure...
var motor1 = new five.Motor(['GPIO24', 'GPIO27', 'GPIO5']);

I couldn’t get this to work, I got errors about ‘pins’ undefined or something.
new five.Motor({
  pins: {
    cdir:'GPIO24',
    dir:'GPIO27',
    enable: 'GPIO5'
  }
});

I did not try this, should I?
new five.Motor({
  pins: {
    pwm:'GPIO24',
    pwm:'GPIO27',
    enable: 'GPIO5'
  }
});

>

nebrius, 2017-11-20:
> Motor class?

Maybe? I can't say for sure till I put a debugger on it.

nebrius, 2017-11-20:
> includePins: ['GPIO24', 'GPIO27', 'GPIO5', 'GPIO6', 'GPIO22', 'GPIO17', 'GPIO23', 'GPIO16', 'GPIO12', 'GPIO13', 'GPIO18', 'GPIO25']

I just noticed this part in the constructor. Is there a reason you only wanted to include a subset of all pins? Normally this option isn't necessary except in very rare edge cases.

zoobot, 2017-11-20:
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

Just thought it was necessary to access those pins. The wording(except for ‘optional') makes it sound like the pins will be unavailable if I did not do that?
It was late and I was just mashing keys like a monkey.

includePins (optional)	Array<Number|String>	A list of pins to include in initialization. Any pins not listed here will not be initialized or available for use by Raspi IO
>

nebrius, 2017-11-20:
> Just thought it was necessary to access those pins. The wording(except for ‘optional') makes it sound like the pins will be unavailable if I did not do that?
It was late and I was just mashing keys like a monkey.

🤔  good point. I'll update the README, thanks!

nebrius, 2017-11-22:
I finally had a chance to stick a debugger on the [code specified here](https://github.com/nebrius/raspi-io/issues/100#issuecomment-342628966), and I figured out what's going on.

At [this line of code](https://github.com/rwaldron/johnny-five/blob/master/lib/motor.js#L600), `this.pins.pwm` is `undefined`, which makes sense given that `pwm` was never specified as an option to the Motor constructor. The code crashes because the Motor constructor called `this.io.pinMode(undefined, 3)`. This is the expected behavior for `pinMode`, but is this the expected way/best way for Johnny-Five to handle this situation?

rwaldron, 2017-11-27:
> At [this line of code](https://github.com/rwaldron/johnny-five/blob/master/lib/motor.js#L600), `this.pins.pwm` is `undefined`, which makes sense given that `pwm` was never specified as an option to the Motor constructor

Yep, that would do it. @dtex we should update the docs to include a table of required properties when `pins: { ... }` is used.

dtex, 2017-11-28:
Sure. How does this look:

* **pins object**     An object with pins required for the motor controller being used

 | Pin name | Required | Description |
 |-----------|----------|------------|
 | pwm         | Yes          | Controls motor speed |
 | dir             | Yes         | Controls motor direction |
 | cdir           | No           | Only necessary for 3-pin motor controllers. Is used in conjunction with dir to control direction and braking |
 | brake        | No           | Engages high impedance braking. Only a few motor controllers have a brake pin |

It would appear under [parameters](http://johnny-five.io/api/motor/#parameters)

nebrius, 2017-11-29:
What do you all think about adding a check in J5 as well so that if the required pins aren't specified, J5 throws a nice human-readable error, e.g. `Required "pwm" pin property not specified`, as opposed to letting Raspi IO throw with the generic (and not really helpful) error of `Unknown pin "undefined"`?

dtex, 2017-11-30:
Yes, I think that's a good idea. I'll try and get a PR in today.

dtex, 2018-01-01:
The PR has been merged and I've updated the wiki so I'm closing this issue

Closed 2018-01-01.

Thread 1411 (2017-11-09):

LCD not initialising properly

dolencd, 2017-11-09:
Hi!

When I connect the RPI with a LCD display to power and run a NodeJS program that uses J5 to communicate with the LCD this happens:

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

In the top lone the text is as bright as it should be, but all the other pixels are light half way, while the bottom line is completely blank.

Before I used a Python script to control the LCD and it worked fine. Even now, starting that python script just for a few seconds fixes the issue and the display works fine after that (even with NodeJS and j5).

Here's all the code that isn't writing or moving the cursor:
`
lcd = new five.LCD({
	pins: ["P1-7", "P1-11", "P1-12", "P1-13", "P1-16", "P1-15"]
});
lcd.off();
lcd.on();
`

Another thing: If I remove the lcd.off() and lcd.on() it all works as before, but weird characters are displayed on the screen instead of normal ones.

I'm using:
Raspberry Pi 3 Model B Rev 1.2
NodeJS 8.9.1
j5 0.11.6
raspi-io 8.1.0

Thanks in advance for any help :)

fivdi, 2017-11-14:
The program posted above doesn't actually print anything to the LCD. Can you post a complete program that can be used to reproduce the problem please?

Please also post a link to a description of LCD being used.

> In the top lone the text is as bright as it should be, but all the other pixels are light half way, while the bottom line is completely blank.

This may be related to how the contrast pin on the LCD is being controlled. How is the contrast pin being controlled? Is there a contrast pot like to one shown at http://johnny-five.io/api/lcd/#component-initialization. If the pot is twisted does anything improve?

Overwatchh, 2017-11-16:
Sorry for the late response. I've been very busy these past few days.

I now have new (but identical) hardware, and the rows are light up the same as before but no characters are showing. Same as before, initializing the display with the Python script fixes the issue.
I don't have the exact LCD (I didn't assemble the hardware myself), but it is HD44780 compliant.

The contrast pin is wired correctly and I tried turning it, but it just changes the contrast of the top row. Characters are always invisible and the bottom row is always completely blank.

I wrote this just for debugging. The other program is too large to post, but it works the same way:

`
"use strict";
const Raspi = require("raspi-io"),
    five = require("johnny-five");

const board = new five.Board({
    io: new Raspi(),
    repl: false,
    debug: true
});
let lcd;
function writeToLCD (row1, row2) {
    lcd.clear();
    lcd.cursor(0, 0).print(row1);
    lcd.cursor(1, 0).print(row2);
}

let number = 0;
board.on("ready", function() {
    lcd = new five.LCD({
        pins: ["P1-7", "P1-11", "P1-12", "P1-13", "P1-16", "P1-15"]
    });
    lcd.off();
    lcd.on();
    setInterval(function () {
        writeToLCD(''+number, '' + ++number)
    }, 1000)
});

`

fivdi, 2017-11-16:
I just wired up a 16x2 LCD and ran the above program exactly as it is. The problem can be reproduced every second or third run of the program. If I end up having some free time at the weekend I'll take a closer look and try to figure out what's going on.

fivdi, 2017-11-18:
In `node_modules/johnny-five/lib` there is a file called `lcd.js` which contains two calls to function `sleepus`. The first call which is supposed to wait for 1 microsecond is [here](https://github.com/rwaldron/johnny-five/blob/v0.11.6/lib/lcd.js#L841) and the second call which is supposed to wait for 37 microseconds is [here](https://github.com/rwaldron/johnny-five/blob/v0.11.6/lib/lcd.js#L850). Please edit `lcd.js` on your Raspberry Pi and replace both of these calls to `sleepus` with a call to `sleep(1)` which should wait for 1 millisecond:
```js
sleep(1);
```
Then give it a try to see if it works.

Please also try out the below program. It's a variant of your program form above that initializes the LCD, waits a second, displays text on the LCD, waits a second and repeats the process. Let it run for about 100 iterations while observing the LCD to ensure that everything works correctly.
```js
"use strict";
const Raspi = require("raspi-io"),
    five = require("johnny-five");

const board = new five.Board({
    io: new Raspi(),
    repl: false,
    debug: true
});
let lcd;
function writeToLCD (row1, row2) {
    lcd.clear();
    lcd.cursor(0, 0).print(row1);
    lcd.cursor(1, 0).print(row2);
}

let number = 0;
board.on("ready", function() {
    lcd = new five.LCD({
        pins: ["P1-7", "P1-11", "P1-12", "P1-13", "P1-16", "P1-15"]
    });
    lcd.off();
    lcd.on();
    setInterval(function () {
        writeToLCD(''+number, '' + ++number)
    }, 1000)
});
```

Overwatchh, 2017-11-18:
Progress!
After the first change it started working the way it did with the earlier hardware. The bottom row is  empty and in the top row the text is visible and was fully dark as it should be, but the rest of the pixels are half way dark. The text is visible, but not very well. Especially if I look at it straight on.

Turning the contrast dial up makes the background pixels darker making the text more difficult to read. Turning it down makes the text more clear up to the point when the text becomes invisible (i guess too low contrast), but until that point the text is always the same.

I tried your program, but the result is the same as described above.

fivdi, 2017-11-18:
That sounds like nothing much has changed to me, is this correct?

Overwatchh, 2017-11-18:
Yes.
The progress is that on the new hardware the text is visible as it was with the old hardware. It is strange since they should be identical.

fivdi, 2017-11-18:
Try increasing the values in the calls to sleep [here](https://github.com/rwaldron/johnny-five/blob/v0.11.6/lib/lcd.js#L681-L685), [here](https://github.com/rwaldron/johnny-five/blob/v0.11.6/lib/lcd.js#L917) and [here](https://github.com/rwaldron/johnny-five/blob/v0.11.6/lib/lcd.js#L923) to see if it improves things.

Add additional calls to sleep directly before and after [this](https://github.com/rwaldron/johnny-five/blob/v0.11.6/lib/lcd.js#L681-L685) block of code. Start with `sleep(16)` before the block and `sleep(4)` after the block.

fivdi, 2017-11-18:
So everything works correctly on the new hardware?

Overwatchh, 2017-11-18:
At first with the new hardware it was like the picture, but without the text. With the changes I made earlier it is now just like the picture.

I quadrupled the values and added the extra sleep calls, but it's still the same.

fivdi, 2017-11-18:
If the test programs from above are being used I'm afraid I'm out of ideas.

Overwatchh, 2017-11-18:
:(

Maybe this will help. A previous version of the program used this LCD driver for python. Now, if I run this so that it initializes, stop it, and then run the program (mine or yours, even without the extra sleep) everything works the way it should. There must be something in this driver that changes some setting or something and fixes the issue.
[lcddriver.zip](https://github.com/rwaldron/johnny-five/files/1484522/lcddriver.zip)

fivdi, 2017-11-18:
One difference is that the python driver has a 200 millisecond delay after the clear in __ init __. A sleep(200) could be added after the [clear in lcd.js](https://github.com/rwaldron/johnny-five/blob/v0.11.6/lib/lcd.js#L702) to see if it helps.

Overwatchh, 2017-11-18:
It doesn't help :(

Overwatchh, 2017-11-18:
Ok so I tried [this library](https://www.npmjs.com/package/lcd) and it seems to work perfectly. I just copied the example and set the correct pins, columns and rows.

And just after that I found out it was yours :D

So I guess I should use this instead of j5 to control the LCD. The other things I use j5 for are just some relays and a LED (which I have to control by setting pins manually because of hardware limitations)
At this point I'm thinking of just switching away from j5. What do you think?

fivdi, 2017-11-19:
I guess switching over to the lcd module is an option. On the other hand I wish I could figure out why J5 LCD doesn't function correctly on your system. The same J5 code works fine on my Raspberry Pi.

Overwatchh, 2017-11-23:
I'll switch the lcd module, but if you want to pursue this I can help

Closed 2019-01-03.

Thread 1416 (2017-11-19):

DRV8833 Motor Driver

nofear87, 2017-11-19:
Is there support for the DRV8833 dual motor driver?

I try to get it working with the dual h bridge example. But no chance :(

Next Problem is, that I need more PWM then a raspberry pi 2b can offer, right?

Thank you!

ghtomcat, 2017-11-19:
I'm successfully using the Adafruit DRV8833 Breakout Board with an ESP8266. I'm using direct setPWM and setPin calls however, since the ESP8266 uses 10-bit PWM

rwaldron, 2017-11-20:
@dtex @nebrius

dtex, 2017-11-20:
I haven't user a DRV8833, but I would think the h bridge example would be the right one to follow. Can you tell me what is happening?

Possible problems:
 * Using ```invertPWM: true``` when you don't need it. Some boards handle the logic inversion for you and don't need this property. The DRV8833 is a pretty humble device so I doubt this is the case.
 * No common ground. You must join the ground between the Arduino and the motor driver so that the devices have a common baseline for low (this is a common mistake).
 * Some other wiring problem.

If none of these are the problem, can you share your code and a picture of your wiring?

Deferring to nebrius re: pi questions.

rwaldron, 2017-11-20:
w/r to @dtex's wiring request, here's Pololu's reference:

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

Fromt this page: https://www.pololu.com/product/2130 , under the section "Pinout":

PIN | Default State | Description
--- | ------------- | ------------
AIN1 | LOW | A logic input control for motor channel A. PWM can be applied to this pin.
AIN2 | LOW | A logic input control for motor channel A. PWM can be applied to this pin.
BIN1 | LOW | A logic input control for motor channel B. PWM can be applied to this pin.
BIN2 | LOW | A logic input control for motor channel B. PWM can be applied to this pin.

nebrius, 2017-11-20:
> Next Problem is, that I need more PWM then a raspberry pi 2b can offer, right?

If you pass in `enableSoftPwm: true` to the [Raspi IO constructor](https://github.com/nebrius/raspi-io#new-raspioptions), you can use any pin on the Raspberry Pi as PWM.

nofear87, 2017-11-21:
Thank you guys for all your usefull hints! I got it working. The problem was a to low voltage, so that the motors did not start running.

dtex, 2017-11-21:
Excellent! Have fun.

Closed 2017-11-21.

Thread 1457 (2018-03-31):

HC-SR04 I2C Backpack with Tessel 2 - Socket: Error: write EPIPE

JeanMichelBoeuf, 2018-03-31:
Hi everyone !

I'm trying to use HC-SR04 ultrasonic sensor with Tessel 2 through an I2C backpack, unsuccessfully for the moment. I can't have any reading from the sensor :

the 1st time I launch the test program (available below ), I have the following error:

```
1522525570883 Available Tessel 2 (MrBot)
1522525571065 Connected Tessel 2 (MrBot)
1522525571147 Repl Initialized

Socket: Error occurred: Error: write EPIPE
/usr/lib/node/tessel-export.js:337
        throw new Error('Socket: The Port socket has closed.');
        ^

Error: Socket: The Port socket has closed.
    at Socket.Port.sock.on (/usr/lib/node/tessel-export.js:337:15)
    at emitOne (events.js:96:13)
    at Socket.emit (events.js:188:7)
    at Pipe._handle.close [as _onclose] (net.js:497:12)
````
Just after that I'm lauching it again, no error this time but no value either :
````
Proximity:
  cm  :  0
  in  :  0
-----------------
````
**Since the Port A led is turned off, it's not surprising that it doesn't work. There's no current in any of the A ports.**

The material I'm using :

* Tessel 2
* arduino nano (installed as I2C backpack with "*interchange install hc-sr04 -a uno*")
* HC-SR04
* SparkFun Logic Level Converter - Bi-Directional

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

The test code :
````
const five = require('johnny-five');
const Tessel = require('tessel-io');

const board = new five.Board({
  io: new Tessel(),
});

board.on('ready', () => {

  const proximity = new five.Proximity({
    controller: "HCSR04I2CBACKPACK",
  });

  proximity.on('data', function () {
    console.log('Proximity: ');
    console.log('  cm  : ', this.cm);
    console.log('  in  : ', this.in);
    console.log('-----------------');
  });

  proximity.on('change', () => {
    console.log('The obstruction has moved.');
  });
});
````

What I have tested so far :

* Arduino nano is working
* HC-SR04 is working; tested with arduino nano only and pingFirmata (installed with "interchange install hc-sr04 -a uno --firmata")
* I2C backpack install confirmed with no error during installation then "*interchange read -p /dev/ttyUSB0*"
* Tessel 2 ports A have been tested with another project.
**weird behavior : I have tried to use I2C on port B (B0 and B1). Surprisingly there's no error and Port A led is light on and testing port a1 with a multimter read 3.3V.**

Maybe it's a Tessel 2 issue and not Johnny-five but I don't have the level to judge that.
Any help would be greatly appreciate, I'm quite lost now.

rwaldron, 2018-04-04:
> Error: Socket: The Port socket has closed.

This is usually caused by some failure that crashes the actual port (Port A or B). Can you try this:

```js
const five = require('johnny-five');
const Tessel = require('tessel-io');

const board = new five.Board({
  io: new Tessel(),
});

board.on('ready', () => {
  console.log('ready!');
});
```

And report back the outcome? Thanks!

JeanMichelBoeuf, 2018-04-12:
I've finally been able  to test it, so here is the result :
```
INFO Looking for your Tessel...
INFO Connected to MrBot.
INFO Building project.
INFO Writing project to RAM on MrBot (1080.32 kB)...
INFO Deployed.
INFO Running componentTest/proximity.js...
1523568442146 Available Tessel 2 (MrBot)
1523568442322 Connected Tessel 2 (MrBot)
1523568442400 Repl Initialized
>> ready!
```

Closed 2019-04-14.

Thread 1475 (2018-06-08):

SI7021 does not capture a proper temperature or update

jc78, 2018-06-08:
I'm trying to use the [Sparkfun Si7021](https://www.sparkfun.com/products/13763) temp\humidity sensor, but it never seems to register a proper temp. It's always at -52.42. Additionally, when using this in combination with a [Sharp IR sensor](https://www.sparkfun.com/products/12728), the IR sensor no longer functions. Both are plugged into the analog inputs of my Arduino Uno. If I comment out the creation of the Hygrometer in my JS code, the IR sensor works again.

```
// Create the Temp sensor
var tempSensor = new five.Multi({
  controller: "SI7021"
});
tempSensor.on("data", function() {
    console.log("Current Temp: ", tempSensor.thermometer.fahrenheit};
));

// Create an IR sensor to measure distance values
var proximity = new five.Proximity({
  controller: "GP2Y0A41SK0F",
  pin: "A0",
  freq: 20
});
proximity.on("data", function() {
    console.log("Current Distance: ", proximity.cm);
});
```

- Are two analog devices permitted at the same time?
- Are these two incompatible with each other?

It appears as if the Si7021 is never capturing a changed temp from when it is first initialized. I may end up switching to a DHT22 with a backpack if this doesn't work out. But that seems like more work to manage and I'd like to keep things as simple as possible.

Thanks for any help.

dtex, 2018-06-08:
@jc78 This should work and it's fine to use these two devices together (one is simply an analog input and the other is i2c). Can you send a picture (or pictures) of your wiring?

jc78, 2018-06-08:
@dtex, thanks for responding. I'm currently at work, but I'll send a picture later tonight.

What I can tell you is that I tried wiring the Si7021 based off of what was in the [johnny-five docs](http://johnny-five.io/img/breadboard/multi-SI7021-uno.png) and also [Sparkfun's wiring diagram](https://cdn.sparkfun.com/assets/learn_tutorials/4/6/7/Si7021Fritzing2.png). Neither of them worked for me.

Something else that I'll check when I get home is my soldering job and wire connector. I soldered the wires directly to the board, and added a connector to the other end. I did visually check those connections and all looked good. But I didn't perform a continuity test with my multimeter, which I'll try tonight.

jc78, 2018-06-09:
Problem Solved.

This ended up being a pour solder connection on the 3.3v line. Once I cleaned it up, both the Si7021 and the IR sensor started working as expected.

@dtex, thanks for the quick response!

Closed 2018-06-09.

Thread 1483 (2018-07-06):

Device or Firmware Error A timeout occurred while connecting to the Board

ulfahputribisba, 2018-07-06:
Hi, I'm new in Arduino and Johnny-Five. I have problems during my final assignment. I'm using Arduino Uno R3 ATMega328p on Windows 10. Here's my code :
`var five = require('johnny-five');

five.Board().on('ready', function() {
  var temperature = new five.Thermometer({
    controller: 'DHT11',
    pin: 13
  });

  temperature.on('data', function() {
    console.log(this.celsius + '°C', this.fahrenheit + '°F');
  });
});`

And here's the message that I've got :
`1530883460513 Available COM3,COM5
1530883460776 Connected COM3
1530883470778 Device or Firmware Error A timeout occurred while connecting to the Board.

Please check that you've properly flashed the board with the correct firmware.
See: https://github.com/rwaldron/johnny-five/wiki/Getting-Started#trouble-shooting

If connecting to a Leonardo or Leonardo clone, press the 'Reset' button on the board, wait approximately 11 seconds for complete reset, then run your program again.
events.js:188
      throw err;
      ^

Error: Unhandled "error" event. ([object Object])
    at Board.emit (events.js:186:19)
    at Board.log (C:\Users\owner\nodejsjohnny\node_modules\johnny-five\lib\board.js:648:8)
    at Board.(anonymous function) [as error] (C:\Users\owner\nodejsjohnny\node_modules\johnny-five\lib\board.js:659:14)
    at Board.<anonymous> (C:\Users\owner\nodejsjohnny\node_modules\johnny-five\lib\board.js:395:14)
    at ontimeout (timers.js:498:11)
    at tryOnTimeout (timers.js:323:5)
    at Timer.listOnTimeout (timers.js:290:5)`

Hope you can help me to find the solutions.
Thanks a lot :)

dtex, 2018-07-06:
This error can appear when the firmata firmware is not installed on the board. Here are some [instructions for installing firmata](https://github.com/rwaldron/johnny-five/wiki/Getting-Started#trouble-shooting)

ulfahputribisba, 2018-07-06:
I've installed the firmware and uploaded it to the board, and it's just the same error

dtex, 2018-07-06:
Excellent! Almost there...

For thermometer (or any other analog sensor), you will need to use an Analog input pin "A0" - "A5"

dtex, 2018-07-06:
Oh wait! Doesn't the DHT11 need a backpack?

ulfahputribisba, 2018-07-06:
A backpack? What do you mean "backpack"? Can you tell me more please?

dtex, 2018-07-11:
@ulfahputribisba Was that a show stopper?

ulfahputribisba, 2018-07-11:
Hi, sorry. The Arduino Nano just come to my hand.  So, I've wired the DHT11 and Arduino Nano to the board.  When I upload this code http://johnny-five.io/examples/multi-DHT11_I2C_NANO_BACKPACK/ using ConfigurableFirmata firmware, it showed like this :

> 1531323483921 Connected Com5
1531323489094 Repl Initialized
>> Thermometer
  celsius           :  0
--------------------------------------
Hygrometer
  relative humidity :  0
--------------------------------------

Should I upload this firmware https://github.com/rwaldron/johnny-five/blob/master/firmwares/dht_i2c_nano_backpack.ino to the board and run the johnny five code?

ulfahputribisba, 2018-07-11:
Hi, sorry. The Arduino Nano just come to my hand. So, I've wired the DHT11 and Arduino Nano to the board. When I upload this code http://johnny-five.io/examples/multi-DHT11_I2C_NANO_BACKPACK/ using ConfigurableFirmata firmware, it showed like this :

1531323483921 Connected Com5
1531323489094 Repl Initialized
>> Thermometer
  celsius           :  0
--------------------------------------
Hygrometer
  relative humidity :  0
--------------------------------------

When I upload this firmware (https://github.com/rwaldron/johnny-five/blob/master/firmwares/dht_i2c_nano_backpack.ino) to the board and run the johnnyfive, it showed error.

What should I do?

ulfahputribisba, 2018-07-11:
Hi, sorry. The Arduino Nano just come to my hand. So, I've wired the DHT11 and Arduino Nano to the board. When I upload this code http://johnny-five.io/examples/multi-DHT11_I2C_NANO_BACKPACK/ using ConfigurableFirmata firmware, it showed like this :

1531323483921 Connected Com5
1531323489094 Repl Initialized
Thermometer
celsius : 0
Hygrometer
relative humidity : 0

When I upload this firmware (https://github.com/rwaldron/johnny-five/blob/master/firmwares/dht_i2c_nano_backpack.ino) to the board and run the johnnyfive, it showed error.

What should I do?

dtex, 2018-07-11:
Your Uno should have StandardFirmataPlus installed and your Nano should have dht_i2c_nano_backpack.ino installed. Is that what you have?

If so, what error are you getting?

ulfahputribisba, 2018-07-12:
@dtex can you show me the example of multi dht11 and the result? I'm really confused

ulfahputribisba, 2018-07-12:
I've uploaded dht_i2c_nano_backpack.ino to my Nano and StandardFirmataPlus to my Uno, then I upload this .js code ( http://johnny-five.io/examples/multi-DHT11_I2C_NANO_BACKPACK/ ) through Windows Command Line and I got this :

1531417744190 Connected Com5
1531417745868 Repl Initialized
Thermometer
  celsius           :  0

Hygrometer
  relative humidity :  0

How to make the DHT11 sensor read the temperature and humidity?

rwaldron, 2018-07-12:
Let's do a step by step check:

1. Connect your Nano to your computer via USB & upload dht_i2c_nano_backpack.ino via Arduino IDE.
2. Connect your UNO to your computer via USB & upload StandardFirmataPlus via Arduino IDE.
3. Create the circuit as shown in the illustration here: http://johnny-five.io/examples/multi-DHT11_I2C_NANO_BACKPACK/
4. Make a file called "dht11.js" and put the _exact_ following code:

```js
var five = require('johnny-five');
var board = new five.Board({port : "COM5"})

board.on("ready", function() {
  var multi = new five.Multi({
    controller: "DHT11_I2C_NANO_BACKPACK"
  });

  multi.on("change", function() {
    console.log("Thermometer");
    console.log("  celsius           : ", this.thermometer.celsius);
    console.log("  fahrenheit        : ", this.thermometer.fahrenheit);
    console.log("  kelvin            : ", this.thermometer.kelvin);
    console.log("--------------------------------------");

    console.log("Hygrometer");
    console.log("  relative humidity : ", this.hygrometer.relativeHumidity);
    console.log("--------------------------------------");
  });
});
```
5. Run this from the command line: `node dht11.js`
6. If that runs correctly, replace the contents of `dht11.js` with the _exact_ following code:

```js
var five = require('johnny-five');
var board = new five.Board({port : "COM5"})

board.on("ready", function() {
  var thermometer = new five.Thermometer({
    controller: "DHT11_I2C_NANO_BACKPACK"
  });

  thermometer.on("change", function() {
    console.log("Thermometer");
    console.log("  celsius           : ", this.celsius);
    console.log("  fahrenheit        : ", this.fahrenheit);
    console.log("  kelvin            : ", this.kelvin);
    console.log("--------------------------------------");
  });
});
```

Let us know how each step goes

ulfahputribisba, 2018-07-12:
Step 1. Checked.
Step 2. Checked.
Step 3. Checked.
Step 4 and 5. The result is as below :
`1531420164992 Connected COM5
1531420166674 Repl Initialized
Thermometer
  celsius           :  0
  fahrenheit        :  32
  kelvin            :  273.15
--------------------------------------
Hygrometer
  relative humidity :  0
--------------------------------------`
and the result just show once, not continuously.

Step 6. The result is as below :
`1531420336415 Connected COM5
1531420341487 Repl Initialized
Thermometer
  celsius           :  0
  fahrenheit        :  32
  kelvin            :  273.15
--------------------------------------`
and the result just show once, not continuously.

Can this DHT11 I2C backpack shows the temperature and the humidity continuously like LM35?

ulfahputribisba, 2018-07-12:
Step 1. Checked.
Step 2. Checked.
Step 3. Checked.
Step 4 and 5. The result is as below :

`1531420164992 Connected COM5
1531420166674 Repl Initialized
>>Thermometer
celsius : 0
fahrenheit : 32
kelvin : 273.15

Hygrometer
relative humidity : 0
--------------------------------------`

and the result just show once, not continuously.

Step 6. The result is as below :

`1531420336415 Connected COM5
1531420341487 Repl Initialized
>>Thermometer
  celsius           :  0
  fahrenheit        :  32
  kelvin            :  273.15
--------------------------------------`

and the result just show once, not continuously.

Can this DHT11 I2C backpack shows the temperature and the humidity continuously like LM35?

ulfahputribisba, 2018-07-12:
Step 1. Checked.
Step 2. Checked.
Step 3. Checked.
Step 4 and 5. The result is as below :

`1531420164992 Connected COM5
1531420166674 Repl Initialized

Thermometer
celsius : 0
fahrenheit : 32
kelvin : 273.15
--------------------------------------

Hygrometer
relative humidity : 0
--------------------------------------`

and the result just show once, not continuously.

Step 6. The result is as below :

`1531420336415 Connected COM5
1531420341487 Repl Initialized

Thermometer
celsius : 0
fahrenheit : 32
kelvin : 273.15
 --------------------------------------`

and the result just show once, not continuously.

Can this DHT11 I2C backpack shows the temperature and the humidity continuously like LM35?

ulfahputribisba, 2018-07-12:
Step 1, checked.
Step 2, checked.
Step 3, checked.
Step 4 and 5, the result is as below :

`1531420164992 Connected COM5
1531420166674 Repl Initialized
  Thermometer
  celsius           :  0
  fahrenheit        :  32
  kelvin            :  273.15
--------------------------------------
Hygrometer
  relative humidity :  0
--------------------------------------`

and it just show once, not continously.

Step 6, the result is as below :

`1531420336415 Connected COM5
1531420341487 Repl Initialized
>> Thermometer
  celsius           :  0
  fahrenheit        :  32
  kelvin            :  273.15
--------------------------------------`

and it just show once, not continuously.

Can this DHT11 I2C Backpack show the temperature and humidity continuously like LM35?

ulfahputribisba, 2018-07-12:
Step 1, checked.
Step 2, checked.
Step 3, checked.
Step 4 and 5, the result is as below :

`1531420164992 Connected COM5
1531420166674 Repl Initialized
  Thermometer
  celsius           :  0
  fahrenheit        :  32
  kelvin            :  273.15

Hygrometer
  relative humidity :  0
--------------------------------------`

and it just show once, not continously.

Step 6, the result is as below :

`1531420336415 Connected COM5
1531420341487 Repl Initialized
 Thermometer
  celsius           :  0
  fahrenheit        :  32
  kelvin            :  273.15
--------------------------------------`

and it just show once, not continuously.

Can this DHT11 I2C Backpack show the temperature and humidity continuously like LM35?

dtex, 2018-07-15:
Just stumbled across open issue #1273 where others are having the same problem.

Closed 2019-07-17.

Thread 1499 (2018-09-02):

TypeError: keyFrames.map is not a function

arindamghoshal, 2018-09-02:
Not sure what I am doing. I am getting this error while animating servos based on the code in eg/phoenix.js. I am trying to animate 4 legs. Attached is the code file. The error gets triggered while executing bot.sleep(); [line 109 in the attached file]

TypeError: keyFrames.map is not a function
    at Servo.(anonymous function) [as @@normalize] (/home/pi/projects/quadBot/node_modules/johnny-five/lib/servo.js:346:20)
    at Servos.<anonymous> (/home/pi/projects/quadBot/node_modules/johnny-five/lib/servo.js:646:46)
    at Array.map (<anonymous>)
    at Servos.(anonymous function) [as @@normalize] (/home/pi/projects/quadBot/node_modules/johnny-five/lib/servo.js:620:22)
>>

[index.js.zip](https://github.com/rwaldron/johnny-five/files/2343521/index.js.zip)

dtex, 2018-09-02:
Hmmm, it looks like you've properly written your code to handle just four legs so the problem doesn't jump out at me. I'll have to some hardware from the lab this afternoon to run the code (and console.log a lot).

One thing does jump out at me, though it has nothing to do with your current issue... I've never successfully controlled multiple servos at a high rate of speed over I2C. I think there is some limit as to how fast those messages can be sent, and even though the PCA9685 can receive instructions for multiple servos in one message, we are only sending one at a time from Johnny-Five.

Also, there is a newer, better way to control walking robots. It's not as well documented (there is no book to go with it), but https://github.com/dtex/tharp uses an inverse kinematics layer on top of Johnny-Five to make controlling the robot much easier (and dynamic).

I guess I really only need an Arduino to run the code with little modification. I'll see if I can replicate the error.

arindamghoshal, 2018-09-02:
Thanks @dtex. I will look into https://github.com/dtex/tharp library.

dtex, 2018-09-03:
I was able to replicate. Still investigating.

dtex, 2018-09-03:
We have a collection of a collection of servos. Your code (like mine) expects the coxa, femur, tibia collections to all be passed the same value so we should be normalizing them using the Servo normalize method instead of the Servos normalize method. For some reason they are being normalized as Servos even though we have insufficient keyFrames (which is why the error is being thrown).

I changed the ```sleep``` object to this dirty hack and it got past the error:

````js
const sleep = {
        target: bot.joints,
        duration: 500,
        cuePoints: [0, 0.5, 1.0],
        fps: 100,
        oncomplete: function() {
            bot.state = "sleep";
        },
        keyFrames: [
            [
                [null, false, { degrees: 45, easing: easeOut }],
                [null, false, { degrees: 45, easing: easeOut }],
                [null, false, { degrees: 45, easing: easeOut }]
            ],
            [
                [null, { degrees: 136, easing: easeInOut }, { degrees: 180, easing: easeInOut }],
                [null, { degrees: 136, easing: easeInOut }, { degrees: 180, easing: easeInOut }],
                [null, { degrees: 136, easing: easeInOut }, { degrees: 180, easing: easeInOut }]
            ],
            [
                [null, { degrees: 120, easing: easeInOut }, { step: 60, easing: easeInOut }],
                [null, { degrees: 120, easing: easeInOut }, { step: 60, easing: easeInOut }],
                [null, { degrees: 120, easing: easeInOut }, { step: 60, easing: easeInOut }]
            ]
        ]
    };
````

Unfortunately it just hit another error so it really needs to be fixed properly. I'm going to try some old versions of Johnny-Five and see if I can find where we stopped getting the expected behavior.

dtex, 2018-09-03:
It broke at v0.10.1 so if you roll back to v0.10.0 it should work. I'll get to work on the real fix.

dtex, 2018-09-11:
Hi @arindamghoshal

I think I have a fix for you at [this PR](https://github.com/rwaldron/johnny-five/pull/1503). It passes unit tests, but I'd really appreciate real world testing if you have a chance.

arindamghoshal, 2018-09-11:
Thanks, @dtex. Happy to test on my bot which is still work in progress.

arindamghoshal, 2018-09-14:
I took the updated servo.js and tested the same code and received a different error in animation.js

>> /home/pi/projects/quadBot/node_modules/johnny-five/lib/animation.js:473
        calcValue = this.target[Animation.keys].reduce(function(accum, key) {
                                                ^

TypeError: Cannot read property 'reduce' of undefined
    at Animation.<anonymous> (/home/pi/projects/quadBot/node_modules/johnny-five/lib/animation.js:473:49)
    at Array.map (<anonymous>)
    at Animation.tweenedValue (/home/pi/projects/quadBot/node_modules/johnny-five/lib/animation.js:422:41)
    at Animation.loopFunction (/home/pi/projects/quadBot/node_modules/johnny-five/lib/animation.js:293:38)
    at Immediate.processQueue (/home/pi/projects/quadBot/node_modules/temporal/lib/temporal.js:195:20)
    at runCallback (timers.js:693:18)
    at tryOnImmediate (timers.js:664:5)
    at processImmediate (timers.js:646:5)
    at process.topLevelDomainCallback (domain.js:121:23)

dtex, 2018-09-15:
Ah, my tests only checked the keyframe normalization, not the rendering. I see the cause of this new error now and am working on a solution.

dtex, 2018-09-15:
Okay, it's good for another go. I've updated servo.js again. Servo animation was originally crafted to receive keyFrame values with the property ```degrees```, but was changed to expect the more generic property ```value```. I was catching that in the normalization method for a single Servo, but not a collection of Servos.

arindamghoshal, 2018-09-15:
Just ran the same code, the servos are reacting good. No more errors. My movement degrees are off, which I need work on. Thanks @dtex.

dtex, 2018-09-15:
This is great news. This issue will close when I land that PR. I want to add some tests and bump the version so it'll be a couple of days, but keep an eye out for version 1.0.1.

Best of luck with your bot. Oh, and please share video(s) when you get it up and running. Nothing makes us happier than seeing nodebots.

dtex, 2018-09-22:
The fix has landed

Closed 2018-09-22.

Thread 1505 (2018-09-25):

Device or Firmware Error with WeMos D1 Mini

RiLe1806, 2018-09-25:
Hey guys,
I have been trying for days now to get my Wemos D1 Mini working. I couldn't find an issue that actually solved my problem.

The board itself is working fine. I can upload sketches without any problems. My other Wemos board has the same issue. I did upload the StandardFirmata beforehand. I also tried the StandardfirmataPlus and the StandardFirmataWifi with Etherportclient. Drivers are installed and the device-manager shows the board correctly.

But I keep getting this error:

***1537888667249 Connected COM3
1537888677253 Device or Firmware Error A timeout occurred while connecting to the Board.***

***Please check that you've properly flashed the board with the correct firmware.
See: https://github.com/rwaldron/johnny-five/wiki/Getting-Started#trouble-shooting***

***If connecting to a Leonardo or Leonardo clone, press the 'Reset' button on the board, wait approximately 11 seconds for complete reset, then run your program again.
events.js:173
    throw err; // Unhandled 'error' event
    ^***

***Error [ERR_UNHANDLED_ERROR]: Unhandled error. ([object Object])
    at Board.emit (events.js:171:17)
    at Board.EventEmitter.emit (domain.js:442:20)
    at Board.log (C:\Users\GLaDoS\Documents\Smartlock\smartlock_server\node_modules\johnny-five\lib\board.js:648:8)
    at Board.(anonymous function) [as error] (C:\Users\GLaDoS\Documents\Smartlock\smartlock_server\node_modules\johnny-five\lib\board.js:659:14)
    at Board.<anonymous> (C:\Users\GLaDoS\Documents\Smartlock\smartlock_server\node_modules\johnny-five\lib\board.js:395:14)
    at ontimeout (timers.js:425:11)
    at tryOnTimeout (timers.js:289:5)
    at listOnTimeout (timers.js:252:5)
    at Timer.processTimers (timers.js:212:10)***

#### My Code looks like this:

```javascript
const SerialPort = require("serialport");
const five = require("johnny-five");
const board = new five.Board({
  port: "COM3"
});

board.on("ready", function() {
  console.log("READY!");

  var led = new five.Led(2);
  led.blink(500);
});

SerialPort.list(function(err, ports) {
    console.log(ports);
});
```

#### The SerialPort.list() returns the following:

***[ { comName: 'COM1',
    manufacturer: '(Standardanschlusstypen)',
    serialNumber: undefined,
    pnpId: 'ACPI\\PNP0501\\1',
    locationId: undefined,
    vendorId: undefined,
    productId: undefined },
  { comName: 'COM3',
    manufacturer: 'wch.cn',
    serialNumber: '5&e658374&0&10',
    pnpId: 'USB\\VID_1A86&PID_7523\\5&E658374&0&10',
    locationId: 'Port_#0010.Hub_#0003',
    vendorId: '1A86',
    productId: '7523' } ]***

Any ideas? I really want to get this working but I'm out of ideas

Thanks!

dtex, 2018-09-25:
The Wemos D1 Mini is an ESP8266 based board so it expects to communicate over standardFirmataWifi. I did this for the first time this past weekend so I'm no expert, but here is the [article I found most helpful](https://www.instructables.com/id/ESP8266-Firmata-J5-NodeBot/) (note that a lot of the other how-to's out there were written as the support itself was being developed so many are no longer current).

The hiccups I ran into that weren't covered in this article are:

1. Getting the IP addressed that was assigned to the ESP8266 by your DHCP server was not covered. If you open the serial monitor in the Arduino IDE and turn the board on, the wifi specs will be output when the board finished booting/connecting (you may need to fiddle around withthe baud to get something you can read).
2. Your wifi network may have support for 2.4 and 5ghz networks. You must make sure that your computer and the board are both connected to the same network. The easiest way to do this is to rename the 2.4 Gig network at your wi-fi router so that it is easy to differentiate the two.

RiLe1806, 2018-09-25:
I have tried it via Wifi before and it didn't work out. But you gave me the right clue, thanks.

I changed my DHCP range and well ... it works now.

dtex, 2018-09-25:
That's great! I'll close this for now. If you have any other problems feel free to re-open.

Closed 2018-09-25.

Thread 1511 (2018-10-15):

DC Motors on RPi turn on and off randomly

ntatko, 2018-10-15:
This is my first issue on github, so I'm sorry if this isn't how it's done.

I'm making a robot with a Raspberry Pi 3 B+ and 3 Sparkfun DRV8871's. They work properly when I test them with an arduino, but with I use them with any Raspberry Pi, the motors turn on and off randomly, and I am rather confused. When the motors are commanded to run, they do so at the proper speeds, but 3-5 seconds later, the motors change direction randomly, change speeds to full power, and behave erratically.

My GPIO wiring is correct, I've checked it many times, and all of the driver chips are grounded to both the external power supply and the RPi.

```js
var five = require("johnny-five");
var keypress = require("keypress");
var Raspi = require("raspi-io");
var board = new five.Board({io: new Raspi(
  { enableSoftPwm: true, includePins: ['GPIO4', 'GPIO17', 'GPIO27', 'GPIO22', 'GPIO9', 'GPIO11'] }
)});

board.on("ready", function() {
  var motors = new five.Motors([
    {pins: {pwm: "GPIO4", dir: "GPIO17"}, invertPWM: true, enableSoftPwm: true},
    {pins: {pwm: "GPIO27", dir: "GPIO22"}, invertPWM: true, enableSoftPwm: true},
    {pins: {pwm: "GPIO9", dir: "GPIO11"}, invertPWM: true, enableSoftPwm: true},
  ]);

  function stop() {
    motors[0].stop();
    motors[1].stop();
    motors[2].stop();
  }

  stop();
  process.stdin.on("keypress", function(ch, key) {
    console.log(key.name);
    if(key.name === "up") {
      stop();
      motors[1].forward(125);
      motors[2].reverse(125);
    } else if (key.name === "down") {
      stop();
      motors[1].reverse(125);
      motors[2].forward(125);
    } else if (key.name === 'right') {
      stop();
      motors[0].forward(125);
      motors[1].forward(125);
      motors[2].forward(125);
    } else if (key.name === 'left') {
      stop()
      motors[0].reverse(125);
      motors[1].reverse(125);
      motors[2].reverse(125);
    } else {
      stop();
    }
  });
});
```

My code is fairly simple, and I'm wondering why the motors are responding this way. The motors are programmed to move at about half speed, and the erratic behavior is always at full power to the motors. Any thoughts?

dtex, 2018-10-15:
Only one tip on the subission of your issue, if you surround your code with three tickmarks instead of one, it will make a nice little codeblock. You could even write "```js" and it will add color to your code. It's really nice:

```js
const five = require("johnny-five");
```

Otherwise your submission is perfect.

I know motor really well, but since this is a Raspberry Pi I'm going to loop in @nebrius because he is the expert on that topic.

First I'd like to isolate out keypress so could you try this code:

```js
var five = require("johnny-five");
var Raspi = require("raspi-io");

var board = new five.Board({io: new Raspi(
  { enableSoftPwm: true, includePins: ['GPIO4', 'GPIO17', 'GPIO27', 'GPIO22', 'GPIO9', 'GPIO11'] }
)});

board.on("ready", function() {
  var motors = new five.Motors([
    {pins: {pwm: "GPIO4", dir: "GPIO17"}, invertPWM: true, enableSoftPwm: true},
    {pins: {pwm: "GPIO27", dir: "GPIO22"}, invertPWM: true, enableSoftPwm: true},
    {pins: {pwm: "GPIO9", dir: "GPIO11"}, invertPWM: true, enableSoftPwm: true},
  ]);

  function stop() {
    motors[0].stop();
    motors[1].stop();
    motors[2].stop();
  }

  stop();
  console.log("Forward");
  motors[1].forward(125);
  motors[2].reverse(125);

  setTimeout(() => {
    console.log("Reverse");
    stop();
    motors[1].reverse(125);
    motors[2].forward(125);
  }, 5000);

  setTimeout(() => {
    console.log("Right");
    stop();
    motors[0].forward(125);
    motors[1].forward(125);
    motors[2].forward(125);
  }, 10000);

  setTimeout(() => {
    console.log("Left");
    stop();
    motors[0].reverse(125);
    motors[1].reverse(125);
    motors[2].reverse(125);
  }, 15000);

  setTimeout(() => {
    console.log("Stop");
    stop();
  }, 20000);

});
```

nebrius, 2018-10-16:
Can you link to the specific device you're using to drive the motors? I searched on Sparkfun, but couldn't find a DRV8871 device there.

I'm wondering if this has something to do with switching from 5V logic of the Arduino to the 3.3V logic on the Raspberry Pi, but I'll need to see the details of this board to tell.

And yes, I'd also recommend trying @dtex's suggestion above too.

nebrius, 2018-10-16:
A quick note on your code: the `enableSoftPwm` flag is only supported on the Raspi IO constructor, so you can remove it from your `new five.Motors([ ... ])` call.

Also, is there a reason you're using the `includePins` option in the constructor?

ntatko, 2018-10-18:
Sorry, @nebrius, I was wrong, it's Adafruit DRV8871. The link is [here.](https://www.adafruit.com/product/3190) I decided to use includePins to try and hard-code everything I could in case it was some arbitrary, ill-defined constructor. I've just been trying a bunch of stuff to see if it helped.

I ran the above code, @dtex, and it seems like the commands all work, as in, when the motor speeds are set, each of them move in that direction, but given 2 or 3 seconds, occasionally a motor will change direction or kick up to full speed. As far as I can tell, it's seemingly random.

They also turn on when the Pi boots. I have everything powering up at the same time. The motors spin then, as well, but I figure that's just a GPIO test sequence running on the Pi, or something. Also, when the program starts (```$ sudo node programName.js```), motor[0] starts spinning. Dunno if that means anything.

nebrius, 2018-10-18:
> I decided to use includePins to try and hard-code everything I could in case it was some arbitrary, ill-defined constructor.

FYI if you leave `includePins` out, it includes _everything_. It's there in case there's something you want to _exclude_, and is something of a twin to `excludePins`. Think of it like this: `includePins` is a white list filter, `excludePints` is a black list filter, and specifying neither means no filter.

> Sorry, @nebrius, I was wrong, it's Adafruit DRV8871

Thanks. Looking at the datasheet, the RPi _should_ be able to drive it fine, even though it's a 3.3v device (compared to the 5v Arduino).

> They also turn on when the Pi boots. I have everything powering up at the same time. The motors spin then, as well, but I figure that's just a GPIO test sequence running on the Pi, or something.

I'm about 99% certain it's not a test sequence. What's more likely is that this is caused by changing pin modes throughout the lifecycle of the startup sequence. When the RPi first boots up, the pins are in input mode, meaning you have to worry about floating pins. Then, when Johnny-Five starts up, the pin is switched to output mode, which could in theory cause the signal to go from logic high to logic low, which the controller may read as a PWM pulse (causing the spin). Then, once the code is fully running, it's switched to PWM mode and all is well.

To fix this, I'd recommend adding a [~10k pull-down resistor](http://www.resistorguide.com/pull-up-resistor_pull-down-resistor/) to your control signals heading to the motor controller.

Let's see what happens after adding the pull down resistor and go from there.

ntatko, 2018-10-25:
Just ordered those resistors; I'll update you then. Thanks so much for all the help!

nebrius, 2018-10-26:
Thanks, I'll keep an eye out for your response. We'll figure it out yet!

ntatko, 2018-11-01:
So, here's the update. The pull-down resistors didn't seem to make a whole lot of difference. I re-wrote the code to try it on an Arduino in both Johnny Five and Arduino-C, and I have the same issue, but this time, only on one of the three motors. I'm guessing that the issue lies more in my voltage regulation and less in the control code. It seems as though this is no longer a Johnny-Five issue, and thanks for your help!

nebrius, 2018-11-13:
I'm glad you got it working @ntatko!

dtex, 2018-11-14:
Thanks everyone.

@ntatko if something else comes up, feel free to re-open this or open a new issue.

ntatko, 2018-12-02:
Got it working! I drove the motors with an arduino, and was having a similar problem as [this](https://github.com/rwaldron/johnny-five/issues/309), but removed some arduino controls. She's working now.
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
Thanks for all y'all's help!

Closed 2018-11-14.

Thread 1536 (2018-11-23):

Can not run with brand new uno board

liesislukas, 2018-11-23:
following instructions from https://github.com/rwaldron/johnny-five/wiki/Getting-Started#trouble-shooting

> Flash the arduino board via arduino --board "arduino:avr:uno" --upload ./path/to/firmware/firmware.ino. Remember to change your board according to what you use. See below on how to figure out that identifier.

This command is probably old. as well as `arduino --install-library "Firmata,Servo"`

This is the output if i run `arduino board` (--board flag is unknown):

```
Arduino board commands.

Usage:
  arduino-cli board [command]

Examples:
  # Lists all connected boards.
  arduino-cli board list

  # Attaches a sketch to a board.
  arduino-cli board attach serial:///dev/tty/ACM0 mySketch

Available Commands:
  attach      Attaches a sketch to a board.
  details     Print details about a board.
  list        List connected boards.
  listall     List all known boards and their corresponding FQBN.

Flags:
  -h, --help   help for board

Global Flags:
      --config-file string   The custom config file (if not specified ./.cli-config.yml will be used).
      --debug                Enables debug output (super verbose, used to debug the CLI).
      --format string        The output format, can be [text|json]. (default "text")

```

My JavaScript code:
```javascript
var five = require("johnny-five");
var board = new five.Board();

board.on("ready", function () {

  // Create a standard `led` component instance
  var led = new five.Led(13);

  // "blink" the led in 500ms
  // on-off phase periods
  led.blink(500);
});
```
Output:

```
1543013398208 Available /dev/tty.usbmodem145230
1543013398215 Connected /dev/tty.usbmodem145230
1543013408220 Device or Firmware Error A timeout occurred while connecting to the Board.

Please check that you've properly flashed the board with the correct firmware.
See: https://github.com/rwaldron/johnny-five/wiki/Getting-Started#trouble-shooting

If connecting to a Leonardo or Leonardo clone, press the 'Reset' button on the board, wait approximately 11 seconds for complete reset, then run your program again.
events.js:188
      throw err;
      ^

Error: Unhandled "error" event. ([object Object])
    at Board.emit (events.js:186:19)
    at Board.log (/Users/lukas/Desktop/arduino/firmata_1/node_modules/johnny-five/lib/board.js:648:8)
    at Board.(anonymous function) [as error] (/Users/lukas/Desktop/arduino/firmata_1/node_modules/johnny-five/lib/board.js:659:14)
    at Board.<anonymous> (/Users/lukas/Desktop/arduino/firmata_1/node_modules/johnny-five/lib/board.js:395:14)
    at ontimeout (timers.js:498:11)
    at tryOnTimeout (timers.js:323:5)
    at Timer.listOnTimeout (timers.js:290:5)
[nodemon] app crashed - waiting for file changes before starting...
```

I'm on MacOS 10.14.1 (Mojave)
nodejs v8.12.0

I upload empty code to Uno:
```
void setup() {
  // put your setup code here, to run once:
}

void loop() {
  // put your main code here, to run repeatedly:
}
```

If i upload this:

```
void setup() {
  // put your setup code here, to run once:
 pinMode(13, OUTPUT);
}

void loop() {
  // put your main code here, to run repeatedly:
digitalWrite(13, HIGH);
}
```
LED shines as expected.

liesislukas, 2018-11-23:
All i needed is to go to examples and upload StandardFirmata to Uno. Now it started to work.

liesislukas, 2018-11-23:
http://johnny-five.io/examples/board/ first example should have short paragraph saying what you need to do to run any sample.

dtex, 2018-11-26:
We should also update the troubleshooting section of the Getting Started wiki page.

liesislukas, 2018-11-27:
the best thing would be a short video. From stock UNO board to working for the johnny-five board. I missed it a lot. Also, I had issues with Windows, glad I have also a macos machine, so just switched to that one. So would be best to have a video of the same thing for each platform. Windows, MacOS and probably Ubuntu. First of all, it would be great material to learn from and also great content to share & find on youtube.

Caine78, 2018-11-30:
> the best thing would be a short video. From stock UNO board to working the johnny-five board.

Yes. I don't know when we will convince them to start doing the videos. It is so much easier to follow somebody else, rather than picking it up from multiple pages and posts like this one. In a video, you can add comments and people can also discuss it. Like a post, just a bit more 21 century.

I was thinking in the past to create the website, where there will be an option to add the extra text or video, between the lessons. You will be sort of doing 101 courses, but you can always skip to the bit that you need and read the additional information about troubleshooting. Done by users and admins to find the workarounds. All in 1 place. Unfortunately, it is a way too big project for me. I was more thinking about how to layout the page, rather than fill it in. Maybe users will be able to create own menus and sort the way how they would like to view the tutorials, base on the key skills of the user. You would come there to find or share something that you did and you will contribute to the project. Almost like over here, but based on video, images and text.

I just love how the 3ds max used to have the manual on the website, back to 2017. I think that they just started messing around with it. It was almost perfect, just more videos were needed. They were using a lot of animation gif's, to show the steps. Step by step you were introduced to this world. I started using it over 20 years ago. I am still coming back to manual and I can find what I want within seconds. The old manual, not the new one. (I think they changed something, as I was just playing around with the new version a few months back. I am not 100% sure, that they actually broke it.

AtomicCons, 2019-01-25:
@dtex
i updated https://github.com/rwaldron/johnny-five/wiki/Getting-Started#troubleshooting on using IDE to put the board in the proper state

uxmarinho, 2021-02-19:
> Tudo que eu precisava era ir aos exemplos e fazer o upload do StandardFirmata para o Uno. Agora começou a funcionar. Essa página wiki é enganosa.

Running StandardFirmata worked for me, Arduino Mega 2560

Closed 2020-01-27.

Thread 1554 (2019-02-13):

led rgb and smd rgb not working

darkworks, 2019-02-13:
hi i have led rgb and smd rgb i tried to run default example code on it through my arudio mega 2560 board and i found that its not working ,

```
    var led = new five.Led.RGB({
      pins: {
        red: 34,
        green: 38,
        blue: 36
      }
    });

  // Add led to REPL (optional)
  this.repl.inject({
    led: led
  });

  // Turn it on and set the initial color
  led.on();
  led.color("#FF0000");

  led.blink(1000);
```

and this one is working but only white light cant set rgb value

```
    var rgb_red_led  = new five.Pin(34);   // Red LED
    var rgb_blue_led  = new five.Pin(36);  // Blue LED
    var rgb_green_led  = new five.Pin(38);  // Green LED
    rgb_red_led.write(100);
    rgb_green_led.write(200);
    rgb_blue_led.write(25);
```

dtex, 2019-02-13:
Hi @darkworks can you send us a picture of your wiring?

darkworks, 2019-02-13:
ok sure
main LED picture

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

LED on breadBoard , gray is ground ,  blue is blue , green is green and purple is red

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

digital pins : red = 34 , blue 36 , green 38

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

dtex, 2019-02-13:
So the wiring looks right. What's that shield? Is that where the ground wire attaches (I don't see it in your Arduino pic)? Is it possible there is a separate ground circuit on that shield and that's what your grey wire is plugged into?

Based on the behavior, it sounds like 34, 36, and 38 are not handling PWM signals, though I'm pretty sure they should. Is it possible you have a REALLY old version of firmata on there? One quick test would be to hook the RGB pins up to 8, 10, 12 and see if it works there. At least then we'd know if we are on the right track.

darkworks, 2019-02-13:
hmmmm ya right its CNC shield am taking ground and v5 from it to bread board  , i have flashed the board with latest version of https://github.com/firmata/ConfigurableFirmata  ,

darkworks, 2019-02-13:
i directly insert the rgb led in mega2560 GND 13,12,11 pins   , now its on but only green ,

dtex, 2019-02-13:
Which includes did you uncomment from the .ino file? Or did you use firmataBuilder?

darkworks, 2019-02-13:
i download ConfigurableFirmata library into Arduino IDE from sketch menu > include library menu , after that went to FILE menu > examples > ConfigurableFirmata > ConfigurableFirmata  and then uploaded it to board

dtex, 2019-02-13:
Ah, that's the problem. You have to [enable the features you need in configurableFirmata](https://github.com/firmata/ConfigurableFirmata#usage).

The easier way is to create a custom .ino at http://firmatabuilder.com

Are you sure you need configurable? I know nothing about that CNC shield but if you are only using configurable for stepper support, I think this shield controls the steppers for you and you'd be fine with standardFirmataPlus.

darkworks, 2019-02-13:
ok i will try the builder , ya i have stepper motors , initially i had standardFirmdata plus on board but stepper motor was not working , also http://johnny-five.io/api/stepper/   here its mentioned to flush board with advance firm data , i used advance firm data and then was able to operate motors and then later i came across ConfigurableFirmata

darkworks, 2019-02-13:
no success just flush board with standardFirmData plus and  when run

```
    var led = new five.Led.RGB({
      pins: {
        red: 13,
        green: 12,
        blue: 11
      }
    });

  // Add led to REPL (optional)
  this.repl.inject({
    led: led
  });

  // Turn it on and set the initial color
  led.on();
  led.color("#eddc47");
```

its still white color :(

darkworks, 2019-02-24:
fixed it not sure how but now working on had to use  PWM pins

Closed 2019-02-24.

Thread 1576 (2019-05-19):

Metro Mini ttyusb0 issue

thelaplage, 2019-05-19:
Hi, I'm having an issue with some working Johnny-five code that works with an arduino uno (on port ttyACM0), I can't get it to work with a Metro Mini (port ttyUSB0), but i'm not getting any errors so i'm having a difficult time diagnosing the problem. It runs, connects, but doesn't respond to any javascript commands. I feel like that means it's a socket.io issue, but I've found nothing on this issue.

I'm using the johnny-five stepper motor code and configurable firmata. And again, the code works as intended with an Uno connected, javascript controlling a stepper.

With the Metro mini, my node script runs and connects with no errors!
Socket.io recognizes the Metro and, says port is available, and connects to ttyUSB0. I get all the right debug info, down to "websocket writing 1"
But then I get nothing back when I actually try to interact with it!
I'm expecting something with console.log when I emit, but nothing. But exact same code works on the Uno!

I feel like I must be missing something very obvious. I've reuploaded configurable firmata. The Metro Mini is supposed to be treated like an Uno in the Arduino IDE. Any guesses as to what this could be? Thanks!

dtex, 2019-05-19:
It sounds like there is a lot more going on than just Johnny-Five talking to the Metro (socket.io, console.log, specifying different USB ports). Have you tried just blinking the LED on pin 13 straight from node, without all the websocket stuff?

thelaplage, 2019-05-19:
Hi, thanks for reply
It was an issue with ConfigurableFirmata on the Metro
I can confirm that stepper-driver.js works on the Metro with AdvancedFirmata

here's details for anybody in similar boat that wants to reference:

---

Here's what I get from running stepper-driver.js example  (http://johnny-five.io/examples/stepper-driver/) with ConfigurableFirmata on the Metro

```
pi@raspberrypi:/var/www/html/0515 $ node stepper-driver.js
1558279453008 Available /dev/ttyUSB0
1558279453056 Connected /dev/ttyUSB0
1558279458114 Repl Initialized
```
and then nothing in the console...

Running that exact same code on the exact same Pi, but with AdvancedFirmata gives me:

```
pi@raspberrypi:/var/www/html/0515 $ node stepper-driver.js
1558280628303 Available /dev/ttyUSB0
1558280628347 Connected /dev/ttyUSB0
1558280632141 Repl Initialized
>> Done moving CCW
Done moving CW
```

Not sure why, but there seems to be an issue with using a Metro Mini and ConfigurableFirmata

dtex, 2019-05-19:
Oh, interesting. Are you using http://firmatabuilder.com/ ?

Closed 2020-08-16.

Thread 1582 (2019-06-05):

Dimmer control for an LED on an AC circuit using ESP8266

communque, 2019-06-05:
I'm hoping it's possible to control Dimmable AC-powered LEDs using J5 on an ESP8266.

Using the following:

- 	ESP8266 Microcontroller
- 	[RobotDyn AC Dimmer](https://robotdyn.com/ac-light-dimmer-module-1-channel-3-3v-5v-logic-ac-50-60hz-220v-110v.html)

**Question**: First up, Is this even possible using J5 over WiFi with an ESP8266?
I've read there are latency issues that cause flickering.

Assuming it is nonetheless possible...

Here's what I understand so far:
	Connect the Dimmer's PWM pin to a PWM-enabled ESP GPIO
	Connect Dimmer's ZC pin to another ESP GPIO set for Digital *Read*? or *Write*?

**Question**: On the J5 side, then what?
Been looking at [this StackExchange page](https://arduino.stackexchange.com/questions/51852/arduino-code-for-pulse-skip-modulation-psm/51859#51859) for clues
Among the key commands in Arduino IDE is `attachInterrupt` (e.g. `attachInterrupt(0, zero_crosss_int, RISING)`
**Question**: Is there an equivalent to `attachInterrupt()` in J5?  If not, is there a way to directly call the command from J5?

dtex, 2019-06-18:
> Is this even possible using J5 over WiFi with an ESP8266?

Yes. There is no official documentation, but check out [this post](https://boneskull.com/how-to-use-an-esp8266-with-johnny-five/), or [this one](https://www.instructables.com/id/ESP8266-Firmata-J5-NodeBot/).

> I've read there are latency issues that cause flickering.

Yes, that's a reasonable concern. The ESP8266 will be running firmata which takes simple commands like "turn pin 1 on". There is nothing like a "fade pin 1 to 0" in firmata so instead Johnny-Five would send many commands in short order, decreasing the value by one each time until it reached zero. Depending on how quickly you are fading, the J5 + firmata.js + wi-fi combo may not be able to keep up.

> Digital Read? or Write?

You would want to read the ZC pin

> Is there an equivalent to attachInterrupt() in J5?

No. and on first blush it looks like the timing is critical enough that you could not monitor ZC with a digital pin and respond in "just Javascript".

>  is there a way to directly call the command from J5?

It would have to be added to firmata first and I think a custom build of firmata that added a fade command (with target and duration) would be the best approach for this.

ScreamZ, 2023-04-03:
@communque Thanks for this quick reply,
I would be pleased to take a look at this.

It's not a problem flickering my use case is for an escape room with some "haunted" ambiance so I'll looking for this kind of junky effect;

I was looking to use a "relay/bridge arduino" that would read a PWM from another Arduino on a specific pin and dispatch the proper dim to be light dimmer AC. This way I could drive the light module dimmer using J5

communque, 2023-04-13:
@ScreamZ Hi Adréas, apologies for the delay.  Got caught up in work and lost this thread.

I ended up not using J5 for testing A/C dimming.  If you can live w/ flickering you're in luck.

The C++ code is brief and relatively straightforward.
Of course you have to get familiar with the terms AND you have to build the MCU code to support the snippet below, but here are the basic commands.  The three methods below are built-in.

```
ledcSetup(PwmChannel, Freq, Res);
ledcAttachPin(Gpio, PwmChannel);
ledcWrite(PwmChannel, DutyCycle);
```
More here: https://randomnerdtutorials.com/esp32-pwm-arduino-ide/
and here: https://espressif-docs.readthedocs-hosted.com/projects/arduino-esp32/en/latest/api/ledc.html

I ended up building a whole system in C++ that can receive cURL calls from terminal or NodeJS child_process.exec / child_process.spawn.  The cURL allow you to run minimal code on the MCU, leaving the bulk of the logic to the JS context.

I know it's a bit brief as far as an explainer, but I hope it's at least somewhat helpful.

Let me know if you have questions

Closed 2019-08-14.

Thread 1596 (2019-08-15):

Update examples / documentation

dtex, 2019-08-15:
**Destructure modules requires, using relative paths**
````js
const {Board, GPS} = require("../lib/johnny-five.js");
````

**Switch to const and let where appropriate (consider scope and whether the values changes)**
````js
const board = new Board();
````

**Use arrow functions on callbacks, replacing uses of ```this``` with ```board``` or the device instance wherever necessary***
````js
gps.on("change", position => {
    console.log("position");
    console.log("  latitude   : ", position.latitude);
    console.log("  longitude  : ", position.longitude);
    console.log("--------------------------------------");
  });
````

**If an arrow function is a single statement**
````js
gps.on("change", () => console.log("Data Received"));
````

**If an arrow function is a function call with no parameters, and is NOT a callback for an event listener**
````js
board.wait(1000, motor.stop);
````

**Shorthand Properties**
````js
const bar = "bar";
const foo = {
   read() {
      //
   },
   bar
}
````

Here is a recent example:

https://github.com/rwaldron/johnny-five/blob/master/eg/esc-keypress.js

- [x] accelerometer.js (@rwaldron)
- [x] altimeter.js
- [ ] barometer.js
- [ ] board.js
- [ ] board.options.js
- [ ] board.pins.js
- [ ] button.js (@monteslu)
- [ ] color.js
- [x] compass.js
- [x] esc.js (@HipsterBrown)
- [ ] evshield.js
- [ ] expander.js
- [ ] fn.js
- [x] gps.js (@dtex)
- [ ] gripper.js
- [ ] gyro.js
- [ ] hygrometer.js
- [ ] imu.js
- [ ] johnny-five.js
- [ ] joystick.js
- [ ] keypad.js
- [ ] lcd-chars.js
- [ ] lcd.js
- [x] light.js (@reconbot)
- [ ] motion.js
- [x] motor.js (@dtex)
- [ ] orientation.js
- [ ] piezo.js
- [ ] pin.js
- [ ] ping.js
- [x] proximity.js
- [ ] reflectancearray.js
- [ ] relay.js
- [ ] repl.js
- [ ] sensor.js (@ajfisher)
- [x] servo.js (@dtex)
- [x] shiftregister.js
- [x] sleep.js
- [x] sonar.js (@dtex)
- [x] stepper.js (@dtex)
- [x] switch.js (@dtex)
- [x] thermometer.js (@dtex)
- [x] digits.js (@dtex)
- [x] led-chars.js
- [x] led.js (@ryanjgill)
- [x] ledcontrol.js (@ryanjgill)
- [x] leds.js (@ryanjgill)
- [x] matrix.js (@ryanjgill)
- [x] rgb.js
- [x] rgbs.js

ryanjgill, 2019-08-17:
Can I combine a few of the led examples in to a single push or should I just do them all as separate PR's? I was thinking about doing some of the led sub sections together like `blink`, `pulse` and `pulse with animation` as one.

dtex, 2019-08-17:
Grouped together is fine. It might be nice to have each group of examples (by class) as a separate commit, JIC.

reconbot, 2019-08-18:
Are object shorthands ok?

eg

from
```js
const foo = {
   read: function() {
      //
   }
}
```

to
```js
const foo = {
   read() {
      //
   }
}
```

reconbot, 2019-08-18:
I checked the object shorthand is aok with supported node versions. I submitted #1601 and before I realized I should have scoped down to just the docs I updated the class too. Let me know if I should take that out.

dtex, 2019-08-19:
@ryanjgill put in some shorthand properties on some LED examples as well. Let's get sign-off from @rwaldron before we do any others.

dtex, 2019-08-19:
Shorthand properties are OK

Closed 2020-09-20.

Thread 1614 (2019-08-27):

Sensor.Digital.on('change') way slower than board.digitalRead

Pimentoso, 2019-08-27:
Board: Arduino nano
Hardware you are having an issue with: in my case, phototransistors
Version of Johnny-Five: 1.1.0
What your expectations are: Sensor.Digital.on('change') callback called as fast as possible
What the actual outcome is: on very rapid events firing, lots of callback calls are lost
Steps to reproduce (including code samples):

- connect phototransistor (in my case, a TEMT6000) to digital pin 6, 5v, and ground
- point a laser LED to it
- place a USB fan between the laser and the phototransistor (or something that can fire events at like 100hz)

Run the following code

```
var five = require("johnny-five"),
  board = new five.Board(),
  i = 0;

board.on("ready", function() {
  sensor1 = new five.Sensor.Digital({pin: 6, freq: 1});
  sensor1.on("change", function(val) {
    if (val == 0) {
      console.log(i++);
    }
  });
});
```

This one will show very slow readings.

```
var five = require("johnny-five"),
  board = new five.Board(),
  i = 0;

board.on("ready", function() {
  this.samplingInterval(1);
  this.pinMode(6, five.Pin.INPUT);
  this.digitalRead(6, function(val) {
    if (val == 0) {
      console.log(i++);
    }
  });
});
```

This one will be way faster.

Looks like there's some overhead when using the Sensor.Digital class. I haven't dived into the code a lot, but the Sensor class code fires the digital events first and then returns immediately if type == 'digital' so I don't think the problem is there.

dtex, 2019-09-06:
@Pimentoso I suspect nobody has a rig suitable for testing this so that's why no response.

Glancing at the second example, does it actually wait for changes? On the surface, it looks like it would blast increments as long as the laser is blocked.

Pimentoso, 2019-09-07:
@dtex it actually waits for changes, as per documentation

> Note: digitalRead will only call its handler when the value of the pin changes.

dtex, 2019-09-07:
Simple test rig. A 10k resistor bridging pin 6 and 3 with this code:

````js
const {Board, Led} = require("johnny-five");
const board = new Board();

const frequency = 100;
const period = 1000 / frequency;

let changes = 0;
let observedChanges = -1; // always one on intialization

board.on("ready", () => {
  board.samplingInterval(1);

  const led = new five.Led(3);

  board.pinMode(6, five.Pin.INPUT);
  board.digitalRead(6, function(val) {
    observedChanges++;
  });

  setInterval(() => {
    led.toggle();
    changes++;
  }, period);

  setTimeout (() => {
    console.log(`${observedChanges} of ${changes} state changes observed`);
    process.exit();
  }, 10000);

});
````

dtex, 2019-09-07:
At 100hz both digitalRead and sensor change events are working perfectly for me using the above code. At 200hz the sensor change event misses a few. In both cases, changes are not emitted at the requested frequency due to either initialization time or code overhead. Still testing to figure out why.

dtex, 2019-09-07:
I should have asked more about your setup. I assumed you were using an Arduino connected to your computer. Is that right?

Pimentoso, 2019-09-08:
Yes indeed it's a cheap nano clone with micro usb, connected directly to a MBP, also tried variable length usb cables, nothing changed. I was not really expecting 1 read per millisecond even with "freq:1"  because of the usb protocol, j5 being javascript and other factors, but in my test script similar to yours (checking the number of reads in 10 seconds) I always got oscillating values, averaging 120 hz which is quite low for my need.

Again I solved it using board.digitalRead which works fine up to 250 hz so it's fine, but I opened this issue for reference.

Closed 2020-09-11.

Thread 1650 (2020-01-07):

433mhz RF support - RC Switch / ConfigurableFirmata / RCSwitchFirmata

MintyMods, 2020-01-07:
Hi Rick/Guys,

I came here after seeing the NodeConf 2012 presentation on You tube, and I totally love the idea of Johnny-five (and of course the film - who doesn't right). Controlling hardware via Javascript is exactly what I am needing being a web developer and new to Ardunio etc. This will allow me to provide an advanced UI / scheduling font end while being able to control various aspects of the environment.

I really want to use this for a Hydroponic project which involves switching remote 433mhz socket outlets as well as reading thermometers, and controlling pumps, etc. Most of my requirements seem to be covered in your excellent example resources apart from the support for controlling the outlets via 433mhz RF.

I can record and playback the required codes using Ardunio and [RCSwitch](https://github.com/sui77/rc-switch/releases/tag/v2.52) but I need to be able to send these codes on demand via the javascript controller.

I have tried searching before raising an issue and found #534 which looked promising but unfortunately didn't provide any solutions.

I also found a feature request for exactly what I need #1307 which suggests this requires [support via Firmata](https://github.com/firmata/ConfigurableFirmata/issues/68) which now seems to have been [completed via RCSwitchFirmata](https://github.com/git-developer/RCSwitchFirmata/tree/v2.0.0).

My problem is that both these issues are now closed and I still see no way to control the RF transmitter via Johnny-five.

Apologies if this is simply something I have missed while searching but I have tried to investigate and just seem to go around in circles with this part. Any information or guidance with this would be gratefully appreciated.

Thank you for your time and your excellent library.

P.S. Johnny Five is such a cool name for a project like this. Off to watch the film again after many years :)

MintyMods, 2020-01-10:
Going to close this as the 'lack of support' is probably down to my lack of experience working with Ardunio/hardware.

I have managed to get a working solution using [RCSwitchFirmata](https://github.com/git-developer/RCSwitchFirmata/tree/v2.0.0) on the Ardunio and using a modified script on the Johnny-Five side which I am posting here in case it points anyone else in the right direction:-

```
const Serialport = require("serialport");
const Encoder7Bit = require('encoder7bit');
const five = require("johnny-five");
const serial = new Serialport("COM7");
const board = new five.Board({ port: serial });

const RC_OUT_PIN = 2;
const RC_PULSE_LENGTH = 185;

const START_SYSEX = (0xF0);
const END_SYSEX = (0xF7);
const RCOUTPUT_DATA = (0x5C);
const RCOUTPUT_ATTACH = (0x01);
const RCOUTPUT_DETACH = (0x02);
const RCOUTPUT_PULSE_LENGTH = (0x12);
const RCOUTPUT_CODE_LONG = (0x22);

board.on("ready", function(){
    console.log("Sending...");
    sendRcCode("8950877"); // ON
    setTimeout(function () {
       sendRcCode("8950876"); // OFF
    }, 500);
});

// rework of https://github.com/git-developer/RCSwitchFirmata
sendSerialCommand = function(subcommand, pin, val) {
    var data = [];
    data.push(START_SYSEX);
    data.push(RCOUTPUT_DATA);
    data.push(subcommand);
    data.push(pin);
    if (val){
      if (Array.isArray(val)) {
        for (var i = 0; i < val.length ; i++) {
          data.push(val[i]);
        }
      }else{
        data.push(val & 0x7F);
        val = val >> 7 ;
        data.push(val & 0x7F);
        val = val >> 7 ;
        data.push(val & 0x7F);
      }
    }
    data.push(END_SYSEX);
    console.dir(data);
    serial.write(data);
};

sendRcCode = function(code) {
  sendSerialCommand(RCOUTPUT_DETACH, RC_OUT_PIN);
  sendSerialCommand(RCOUTPUT_ATTACH, RC_OUT_PIN);
  if(RC_PULSE_LENGTH) {
      sendSerialCommand(RCOUTPUT_PULSE_LENGTH, RC_OUT_PIN, RC_PULSE_LENGTH);
  }

  let bytes = Encoder7Bit.to7BitArray([0x18, 0x00].concat(longToByteArray(code)));
  sendSerialCommand(RCOUTPUT_CODE_LONG, RC_OUT_PIN,  bytes);
}

// Utility function gratefully stolen from:-
// https://stackoverflow.com/questions/8482309/converting-javascript-integer-to-byte-array-and-back
longToByteArray = function(long) {
  var byteArray = [0, 0, 0, 0, 0, 0, 0, 0];
  for ( var index = 0; index < byteArray.length; index ++ ) {
      var byte = long & 0xff;
      byteArray [ index ] = byte;
      long = (long - byte) / 256 ;
  }
  return byteArray;
};

byteArrayToLong = function(byteArray) {
  var value = 0;
  for ( var i = byteArray.length - 1; i >= 0; i--) {
      value = (value * 256) + byteArray[i];
  }
  return value;
};
```

This is working for me now so sorry for raising the issue against something that was clearly not a bug.

On a side note the main page documentation:
> Need help? Ask a question on the NodeBots Community Forum.

This advice points to a dead link.

Closed 2020-01-10.

Thread 1658 (2020-02-14):

Grove TH02 Humidity/Temperature sensor reporting incorrect (minus) values

MintyMods, 2020-02-14:
Hi,

Could someone provide me with some assistence as I seem to have hit a dead end with trying to get temperature and humidity reading via Johnny-Five.

I have tried numerous different sensors (TH02, BME280, DH11, DH22) and I can not get a valid reading out of any of them when used with Johnny-Five. I am sure this is something I am doing wrong but do not really know how to debug the issue further.

Bsaically running the following Johnny-five sample produces incorrect results for my testing with an Arduino Leonardo:-

```
 const I2C_GROVE_TEMP_HUMIDITY_ADDR = (0x40);
 var humidity = new five.Multi({
    controller: "TH02"
    // address: I2C_GROVE_TEMP_HUMIDITY_ADDR,
  });

  humidity.on("change", function() {
    console.log("Thermometer");
    console.log("  celsius           : ", this.thermometer.celsius);
    console.log("  fahrenheit        : ", this.thermometer.fahrenheit);
    console.log("  kelvin            : ", this.thermometer.kelvin);
    console.log("--------------------------------------");
    console.log("Hygrometer");
    console.log("  relative humidity : ", this.hygrometer.relativeHumidity);
    console.log("--------------------------------------");
  });
```

The output I receive is as follows:-

```
1581616962327 Available COM7,COM1
1581616962332 Connected COM7
1581616967343 Repl Initialized
>> Thermometer
  celsius           :  -50
  fahrenheit        :  -58
  kelvin            :  223.15
--------------------------------------
Hygrometer
  relative humidity :  -24
--------------------------------------
```

The change event only fires once which I guess is because the reading are not changing (this I can confirm by using the `'ondata' `event rather than the `'onchange'`) and seeing the same incorrect readings being output.

The TH02 is connected via I2C as per the [diagram from the API](http://johnny-five.io/examples/multi-TH02/) docs. I have verified the I2C channel to be the default `(0x40)` as shipped by Grove and I have checked the J5 source code for IMU which shows it is also using address 0x40.

Checking the code against the [source code](https://github.com/Seeed-Studio/Grove_Temper_Humidity_TH02/blob/master/TH02_dev.cpp) from seed studio for the TH02 suggests it is not an issue with the Johnny-five TH02 IMU module as both contain the same formula etc.

The sensor and hardware seem fine and running the [sample code](http://wiki.seeedstudio.com/Grove-TemptureAndHumidity_Sensor-High-Accuracy_AndMini-v1.0/) provided with the sensor does produce valid readings with temperature about 26 celsius and humidity about 38%.

I am using [ConfigurableFirmata ](https://github.com/firmata/ConfigurableFirmata) rather than StandardFirmata as I require support for sending RF433 codes so it may be possible there is an issue here and I will try to test again against StandardFirmata.

I have seen various other posts/issues where the readings are correct or at least not minus figures so suspect this must be something I am doing or that the TH02 support is not compatible with the Leonardo?

Any help is greatly appreciated as I have already put a lot of work into using Johnny-five for my solution and all the other aspects (motors, RF senders, relays, etc) are all working as expected.

Thank you.

dtex, 2020-02-14:
I have a bundle if Grove stuff. I'll swing by the lab this afternoon and see if there is a TH02 in there I can try to replicate with.

Are any of your other devices using i2c and do they work ok?

Let us know how it goes with standardFirmata.

MintyMods, 2020-02-14:
Hi Dtex,

I also have a [Whitelabs Tenticle Shield](https://www.whiteboxes.ch/shop/tentacle/) with PH, EC and  temperature circuits which are I2C and these seem to work correctly using the following addresses:-

```
const I2C_ATLAS_PH_SENSOR_ADDR = (0x63);
const I2C_ATLAS_EC_SENSOR_ADDR = (0x64);
const I2C_ATLAS_TEMP_SENSOR_ADDR = (0x66);
```

These are being used via the `board.i2cReadOnce` so not sure it is a valid comparison

```
// Communicate with the Atlas Tenticle Shield, Motor Shields, etc via I2C
sendI2C = function(channel, command, callback) {
  console.log('I2C[' + channel + '] Sending Command: ' + command);
  board.io.i2cWrite(channel, command);
  board.wait(ATLAS_DELAY, function() {
      board.i2cReadOnce(channel, ATLAS_BYTES_TO_READ, function(bytes) {
        console.log('I2C[' + channel + '] Result: ' + decode(bytes));
        callback(bytes);
      });
  });
};
```

I also have a Grove MotorBoard and Ada Fruit MotorBoard running at the following address:-

```
const I2C_GROVE_MOTORBOARD_ADDR = (0x14);
const I2C_ADAFRUIT_MOTORBOARD_A_ADDR = (0x60);
const I2C_ADAFRUIT_MOTORBOARD_B_ADDR = (0x70);

```

But to be honest other than connecting them to resolve any address conflicts I have not actually run any motors via them yet as not being able to read humidity and temperature puts a stop to my (Hydroponic) project so I kind of got tunnel locked into that.

I will test using the I2C motor boards with my current configuration and then test all scenarios against StandardFirmata and report back.

Thank you so much for the support.

MintyMods, 2020-02-14:
OK, tested against `StandardFirmata` and all tests behaved identical to when run against  `ConfigurableFirmata` (apart from the RF433 scenarios which are only supported by `ConfigurableFirmata `and my reason for using it).

- The Tenticle Shield works correctly against both Firmata via the I2C channels mentioned above.
- The AdaFruit Motor Shield works correctly against both Firmata via the I2C channels mentioned above.
- The I2C Grove Motor Shield **does not work** against either Firmata (connected via any Grove Base Shield socket)
- The I2C Grove TH02 **does not work** against either Firmata (connected via any Grove Base Shield socket)

I noticed that the temperatures / humidity values being reported when the TH02 sensor is not even  connected are the same as I originally reported:-

```
// Values reported when TH02 not connected
[1] Thermometer
[1]   celsius           :  -50
[1]   fahrenheit        :  -58
[1]   kelvin            :  223.15
[1] --------------------------------------
[1] Hygrometer
[1]   relative humidity :  -24
[1] --------------------------------------
```

 So it seems the I2C sockets on the Grove Base Shield are not working? I have tried each of the four sockets and tried multiple different Grove leads without luck.

I am not really sure how to debug that further apart from purchasing another Grove Base Shield which is going to take a few days to arrive.

One possible idea I have is to use the breakout section of the AdaFruit Motor Board v2 to solder a Grove Socket/Header (which I did purchase) and connect this to the standard Arduino pins for 5v, Gnd, SCL, SDA which I am guessing would allow me to connect a single device for testing?

Going to start by RTFM/Google for the base shield and see where that takes me but I now doubt this is Johnny-Five issue but will leave it open for a while  just so I can document anything I find that might help others hitting the same problem.

I am very noob to this Hardware journey but so excited to be able to control it using JavaScript.

Thank you again for your help.

MintyMods, 2020-02-14:
Rather than mess with the motor board I just cut one of the grove cables in half, tinned the ends and connected directly to the Arduino with the same results. Johnny-Five reports as if the TH02 is not connected while running the demo TH02 code works and produces valid results:-

```
/*
 * Demo name   : TH02_dev demo
 * Usage       : DIGITAL I2C HUMIDITY AND TEMPERATURE SENSOR
 * Author      : Oliver Wang from Seeed Studio
 * Version     : V0.1
*/

#include <TH02_dev.h>
#include "Arduino.h"
#include "Wire.h"

void setup()
{
  Serial.begin(9600);        // start serial for output

  Serial.println("****TH02_dev demo by seeed studio****\n");
  /* Power up,delay 150ms,until voltage is stable */
  delay(150);
  /* Reset HP20x_dev */
  TH02.begin();
  delay(100);

  /* Determine TH02_dev is available or not */
  Serial.println("TH02_dev is available.\n");
}

void loop()
{
   float temper = TH02.ReadTemperature();
   Serial.println("Temperature: ");
   Serial.print(temper);
   Serial.println("C\r\n");

   float humidity = TH02.ReadHumidity();
   Serial.println("Humidity: ");
   Serial.print(humidity);
   Serial.println("%\r\n");
   delay(1000);
}

```
Gives the following correct results:-

```
Temperature:
27.25C

Humidity:
54.19%
```

dtex, 2020-02-14:
Thanks for doing all that. I did not have a TH02 in my box of Grove stuff so I'll have to order one. I'll see if I have any of those other sensors at home tonight. The fact that you can't get a valid value out of any of those leads me to believe it may indeed by a J5 error... we'll see.

MintyMods, 2020-02-14:
I feel bad making you purchase a Grove TH02 to help me trouble shoot was could potentially be a mistake on my side and I really appreciate the help so If I can donate a TH02 in anyway I would be willing to do so?

Also just to clarify my original comment about the sensors so as not to miss lead you.

I have tried the [BME280 sensor example](http://johnny-five.io/examples/multi-BME280) using a kit obtained from Amazon [KeeYees BME280](https://www.amazon.com/KeeYees-Temperature-Atmospheric-Development-Raspberry/dp/B07KYKP8TW) but this only had 4 pins rather than 8 so I connected it to GND, 5v, SCL & SDA via a grove cable plugged directly into the Grove Base Shield.

Running the following J5 example code:-

```
const I2C_BME280_SENSOR_ADDR = (0x76);
var multi = new five.Multi({
    controller: "BME280",
    address: I2C_BME280_SENSOR_ADDR
  });
  multi.on("change", function() {
    console.log("  celsius           : ", this.temperature.celsius);
    console.log("  fahrenheit        : ", this.temperature.fahrenheit);
    console.log("  relative humidity : ", this.hygrometer.relativeHumidity);
    console.log("--------------------------------------");
  });
```

Produces the following incorrect results:-

```
[1] >> Johnny-Five Board Init - COM7
[1] Thermometer
[1]   celsius           :  215
[1]   fahrenheit        :  419
[1]   kelvin            :  488.15
[1] --------------------------------------
[1] Hygrometer
[1]   relative humidity :  0
[1] --------------------------------------

```

Running the following example code BMx280_I2C.ino from Arduino UI (_comments and whitespace removed_)

```
#include <Arduino.h>
#include <Wire.h>
#include <BMx280I2C.h>
#define I2C_ADDRESS 0x76
BMx280I2C bmx280(I2C_ADDRESS);

void setup() {
	Serial.begin(9600);
	while (!Serial);
	Wire.begin();
	if (!bmx280.begin())	{
		Serial.println("begin() failed. check your BMx280 Interface and I2C Address.");
		while (1);
	}
	if (bmx280.isBME280())
		Serial.println("sensor is a BME280");
	else
		Serial.println("sensor is a BMP280");

	bmx280.resetToDefaults();
	bmx280.writeOversamplingPressure(BMx280MI::OSRS_P_x16);
	bmx280.writeOversamplingTemperature(BMx280MI::OSRS_T_x16);
	if (bmx280.isBME280())
		bmx280.writeOversamplingHumidity(BMx280MI::OSRS_H_x16);
}

void loop() {
	delay(1000);
	if (!bmx280.measure())	{
		Serial.println("could not start measurement, is a measurement already running?");
		return;
	}
	do {
		delay(100);
	} while (!bmx280.hasValue());
	Serial.print("Pressure: "); Serial.println(bmx280.getPressure());
	Serial.print("Pressure (64 bit): "); Serial.println(bmx280.getPressure64());
	Serial.print("Temperature: "); Serial.println(bmx280.getTemperature());

	if (bmx280.isBME280())	{
		Serial.print("Humidity: ");
		Serial.println(bmx280.getHumidity());
	}
}
```

Produces the following correct results (I guess, not sure how 'high' I am :0)

```
Pressure: 101296.00
Pressure (64 bit): 0.00
Temperature: 25.97
Humidity: 35.78
```

The `DH11` & `DH22` I have **not actually tested** yet (Sorry for any confusion) as these needed a [Nano Backpack](http://johnny-five.io/examples/temperature-DHT22_I2C_NANO_BACKPACK/) and I was not clear on how to make these _as the resister confused me_ and I need it to wire it into the Grove Base Shield so I just decided to go with the TH02 example which looked 'Plug-N-Play' :o)

I did purchase the following hardware and can test these sensors (I just need to read up on resisters first) but the newer sensors I presume are better?

- [USB Nano V3.0 ATMEGA328P](https://www.amazon.co.uk/gp/product/B06XT5LYJ4/ref=ppx_yo_dt_b_asin_title_o08_s00?ie=UTF8&psc=1)
- [DHT22 Temperature And Humidity Sensor Module Geekcreit](https://www.banggood.com/AM2302-DHT22-Temperature-And-Humidity-Sensor-Module-p-937403.html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)
- [DHT11 Temperature Humidity Sensor Module Geekcreit](https://www.banggood.com/KY-015-DHT11-Temperature-Humidity-Sensor-Module-p-916173.html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)

I also just spotted this [BME680](https://www.seeedstudio.com/Grove-Temperature-Humidity-Pressure-and-Gas-Sensor-BME680.html) which looks awesome but I am bit reluctant to buy anymore Grove hardware at the moment as my project is totally committed to Johnny-Five but for me at least - Grove seems to be a problem.

MintyMods, 2020-02-14:
I don't know if it makes a difference but this is the [Arduino](https://www.banggood.com/Leonardo-R3-ATmega32U4-Development-Board-With-USB-Cable-p-906441.html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) I purchased which was a cheap alternative from China.

> Leonardo R3 ATmega32U4 Development Board With USB Cable Geekcreit for Arduino - products that work with official Arduino boards

MintyMods, 2020-02-15:
The issue seems to be around the TH02 conversion promise within `imu.js` which is always resolving with values of `[0,0]`

```
TH02: {
... snipped ...
          conversion.then(function() {
            Promise.all([
              new Promise(function(resolve) {
                io.i2cReadOnce(address, 0x01, 1, function(data) {
                  resolve(data[0]);
                });
              }),
              new Promise(function(resolve) {
                io.i2cReadOnce(address, 0x02, 1, function(data) {
                  resolve(data[0]);
                });
              })
            ]).then(function(data) {

 ===>  Always resolves to [0,0]
```

The following comment against that function is interesting:-

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

Checking the code from the working Grove example show it seems to be using an array of 3 and  discarding the first value:-

```
uint16_t TH02_dev::TH02_IIC_ReadData2byte() {
    uint16_t TempData = 0;
    uint16_t tmpArray[3] = {0};

    int cnt = 0;
    TH02_IIC_WriteCmd(REG_DATA_H);

    Wire.requestFrom(TH02_I2C_DEV_ID, 3);
    while (Wire.available()) {
        tmpArray[cnt] = (uint16_t)Wire.read();
        cnt++;
    }
    /* MSB */
    TempData = (tmpArray[1] << 8) | (tmpArray[2]);
    return TempData;
}
```

So as a test I hacked `imu.js` to do what I think the comments suggests

```
          conversion.then(function() {
            Promise.all([
              new Promise(function(resolve) {
                io.i2cReadOnce(address, 0x01, 3, function(data) {
                  resolve(data[1],data[2]);
                });
              }),      
            ]).then(function(data) {
```

Which gave me a result although not a very accurate one (actual temp was 26.7 and humidity 40%)

```
[1] TH02 Thermometer
[1]   celsius           :  26
[1]   fahrenheit        :  78.8
[1]   kelvin            :  299.15
[1] --------------------------------------
[1] Hygrometer
[1]   relative humidity :  58
[1] --------------------------------------
[1] TH02 Thermometer
[1]   celsius           :  26
[1]   fahrenheit        :  78.8
[1]   kelvin            :  299.15
[1] --------------------------------------
[1] Hygrometer
[1]   relative humidity :  57
[1] --------------------------------------

```

MintyMods, 2020-02-15:
Regarding the Grove Motor Board not working, I don't think the one I have is compatible with the `GROVE_I2C_MOTOR_DRIVER` controller as the one I have is a version one and is marked with `TB6612FNG` on the back.

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

I managed to get it working within Arduino using the following:-

```
#include "Grove_Motor_Driver_TB6612FNG.h"
#include <Wire.h>

MotorDriver motor;

void setup()
{
    // join I2C bus (I2Cdev library doesn't do this automatically)
    Wire.begin();
    Serial.begin(9600);
    motor.init();
}

void loop()
{
    // drive 2 dc motors at speed=255, clockwise
    Serial.println("run at speed=255");
    motor.dcMotorRun(MOTOR_CHA, 255);
    motor.dcMotorRun(MOTOR_CHB, 255);
    delay(1000);

    // brake
    Serial.println("brake");
    motor.dcMotorBrake(MOTOR_CHA);
    motor.dcMotorBrake(MOTOR_CHB);
    delay(1000);

    // drive 2 dc motors at speed=200, anticlockwise
    Serial.println("run at speed=-200");
    motor.dcMotorRun(MOTOR_CHA, -200);
    motor.dcMotorRun(MOTOR_CHB, -200);
    delay(1000);

    // stop 2 motors
    Serial.println("stop");
    motor.dcMotorStop(MOTOR_CHA);
    motor.dcMotorStop(MOTOR_CHB);
    delay(1000);
}
```

I did try modifying the `motor.js` based on [the code from Seed Studio](https://github.com/Seeed-Studio/Grove_Motor_Driver_TB6612FNG) but kind of got lost in the API for J5 in terms of how pins are being used with I2C boards. The `GROVE_I2C_MOTOR_DRIVER` seems to be implemented using `setPWM `and `setPin `to determine speed and direction although the API from Seed Studio shows a run method that sets both speed and direction within the same I2C write while specifying which motor channel to work with.

```
 void MotorDriver::dcMotorRun(motor_channel_type_t chl, int16_t speed) {
    if (speed > 255) {
        speed = 255;
    } else if (speed < -255) {
        speed = -255;
    }

    if (speed >= 0) {
        _buffer[0] = GROVE_MOTOR_DRIVER_I2C_CMD_CW;
    } else {
        _buffer[0] = GROVE_MOTOR_DRIVER_I2C_CMD_CCW;
    }

    _buffer[1] = chl;
    if (speed >= 0) {
        _buffer[2] = speed;
    } else {
        _buffer[2] = (uint8_t)(-speed);
    }

    I2Cdev::writeBytes(_addr, _buffer[0], 2, _buffer + 1);
    delay(1);
}
```

All good fun :)

dtex, 2020-02-15:
Regarding TH02: That's good detective work!

> Which gave me a result although not a very accurate one (actual temp was 26.7 and humidity 40%)

Are these roughly the same value you get when running the sample Grove code?

> So as a test I hacked imu.js to do what I think the comments suggests

I found the [commit](c6405faff50061c5e5be7b8384c21528e7119ef7) where it switched from reading 3 bytes beginning at 0 to reading bytes from 1 and 2 separately.

Would you like to contribute and submit a fix?

Note: I have a nagging worry that reading from any register position other than 0 isn't working. This has nothing to do with J5 or any specific device. We've fixed some other reported errors in J5 by switching to read from 0 and dropping unnecessary bytes instead of reading from a specific register position. Since the error would be in firmata, J5 tests would never have caught it and it would be working on every other platform. It really would explain a lot.

dtex, 2020-02-15:
Regarding the Grove Motor Board:

Ya, it looks like the register locations to write to are completely different and a new controller needs to be added for this board.

MintyMods, 2020-02-16:
> Regarding TH02: That's good detective work!

Thanks, I have been watching a few Johnny-Five presentations on YouTube and the enthusiasm you guys have for J5 is addictive.

> Are these roughly the same value you get when running the sample Grove code?

The temperature was not to far out with Actual = `26.7` and J5 TH02 reporting = `26`  but the temperature is way out with Actual = `40%` and J5 TH02 reporting `58%` on one tick and `57%` on the next etc.

> I found the [commit](c6405faff50061c5e5be7b8384c21528e7119ef7) where it switched from reading 3 bytes beginning at 0 to reading bytes from 1 and 2 separately.
>
> Would you like to contribute and submit a fix?

Yes, I would love to get involved but not sure my hack is the correct fix at the moment so would need to do a little more digging around first. The commit link you posted is not returning any results for me so let me look back at the commit history to see the changes.

> Note: I have a nagging worry that reading from any register position other than 0 isn't working. This has nothing to do with J5 or any specific device. We've fixed some other reported errors in J5 by switching to read from 0 and dropping unnecessary bytes instead of reading from a specific register position. Since the error would be in firmata, J5 tests would never have caught it and it would be working on every other platform. It really would explain a lot (but is a separate issue from this).

Thanks for the hint, I will have another look around.

MintyMods, 2020-02-16:
> Regarding the Grove Motor Board:
>
> Ya, it looks like the register locations to write to are completely different and a new controller needs to be added for this board.

I have moved this into a separate issue to make tracking easier.

MintyMods, 2020-02-16:
Back to the TH02 - I have played around a little and found the following code changes to `imu.js` resolve the issue (for me at least) and the results are now consistent with the example `TH02_demo` from Grove/Arduino UI.

I have submitted a PR #1660 for review and there seems to be two parts to this change:-

- The first part we already discussed with having to read the 3 bytes from `0x01` rather than a single byte from `0x01` & `0x02`.
- The 2nd part was with using the `uint16(data[0], data[1])` as this resulted in no precision within the results (e.g. temperature would change from 25 to 26 rather than hitting 25.1, etc).

The results seem good now and the change event is also firing correctly now it is producing decimal places.

Values reported via Johnny-five example from the original post (starts of with an initial negative read but quickly corrects itself):-
```
[1] >> Johnny-Five Board Init - COM7
[1] TH02 Thermometer
[1]   celsius           :  -50
[1]   fahrenheit        :  -58
[1]   kelvin            :  223.15
[1] --------------------------------------
[1] Hygrometer
[1]   relative humidity :  57.69
[1] --------------------------------------
[1] TH02 Thermometer
[1]   celsius           :  27.3
[1]   fahrenheit        :  81.14
[1]   kelvin            :  300.45
[1] --------------------------------------
[1] Hygrometer
[1]   relative humidity :  57.69
[1] --------------------------------------
[1] TH02 Thermometer
[1]   celsius           :  27.3
[1]   fahrenheit        :  81.14
[1]   kelvin            :  300.45
[1] --------------------------------------
[1] Hygrometer
[1]   relative humidity :  57.63
[1] --------------------------------------
```

Values reported via Serial Monitor in Arduino running Grove TH02_demo:-
```
Temperature:
27.06C

Humidity:
58.19%

Temperature:
27.03C

Humidity:
58.31%

Temperature:
27.03C

Humidity:
58.25%
```

MintyMods, 2020-02-16:
I can't reproduce that initial negative read so will ignore for now...

Nadiaaaaaaaaaaaa, 2024-03-29:
Hello everyone,

I’m encountering an issue with the Grove Temperature and Humidity Sensor (High Accuracy AndMini-v1.0) when using it with an Arduino Uno. The sensor is giving me strange readings - it shows -50.00°C for temperature and -24.00% for humidity.

I’ve checked my code and connections, but I’m still getting these incorrect values. Has anyone else experienced this issue before? If so, do you know what might be causing it and how to fix it?

This is the code I used :

```
#include <TH02_dev.h>

#include “Arduino.h”

#include “Wire.h”

#include “THSensor_base.h”

#define ShowSerial Serial

#ifdef AVR

#include <SoftwareSerial.h>

SoftwareSerial SSerial(2, 3); // RX, TX

#define COMSerial Serial

#define ShowSerial Serial

TH02_dev TH02;
#endif

#ifdef ARDUINO_SAMD_VARIANT_COMPLIANCE

#define COMSerial Serial1

#define ShowSerial SerialUSB

TH02_dev TH02;
#endif

#ifdef ARDUINO_ARCH_STM32F4

#define COMSerial Serial

#define ShowSerial SerialUSB

TH02_dev TH02;
#endif

void setup() {

ShowSerial.begin(9600);        // start serial for output

ShowSerial.println("****TH02_dev demo by seeed studio****\n");

/* Power up,delay 150ms,until voltage is stable */

delay(150);

/* Reset HP20x_dev */

TH02.begin();

delay(100);

/* Determine TH02_dev is available or not */

ShowSerial.println("TH02_dev is available.\n");
}

void loop() {

float temper = TH02.ReadTemperature();

ShowSerial.print("Temperature: ");

ShowSerial.print(temper);

ShowSerial.println("C\r\n");

//Serial.print("%\t");

float humidity = TH02.ReadHumidity();

ShowSerial.print("Humidity: ");

ShowSerial.print(humidity);

ShowSerial.println("%\r\n");

delay(1000);
}
```

I appreciate any help or insights you can provide!

Thank you.

Closed 2022-01-09.

Thread 1659 (2020-02-16):

Grove Motor Board V1 type `TB6612FNG` is not compatible with GROVE_I2C_MOTOR_DRIVER

MintyMods, 2020-02-16:
Grove Motor Board version one is not working against J5 built in support for `GROVE_I2C_MOTOR_DRIVER`

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

I managed to get it working within Arduino using the following:-

```
#include "Grove_Motor_Driver_TB6612FNG.h"
#include <Wire.h>

MotorDriver motor;

void setup()
{
    // join I2C bus (I2Cdev library doesn't do this automatically)
    Wire.begin();
    Serial.begin(9600);
    motor.init();
}

void loop()
{
    // drive 2 dc motors at speed=255, clockwise
    Serial.println("run at speed=255");
    motor.dcMotorRun(MOTOR_CHA, 255);
    motor.dcMotorRun(MOTOR_CHB, 255);
    delay(1000);

    // brake
    Serial.println("brake");
    motor.dcMotorBrake(MOTOR_CHA);
    motor.dcMotorBrake(MOTOR_CHB);
    delay(1000);

    // drive 2 dc motors at speed=200, anticlockwise
    Serial.println("run at speed=-200");
    motor.dcMotorRun(MOTOR_CHA, -200);
    motor.dcMotorRun(MOTOR_CHB, -200);
    delay(1000);

    // stop 2 motors
    Serial.println("stop");
    motor.dcMotorStop(MOTOR_CHA);
    motor.dcMotorStop(MOTOR_CHB);
    delay(1000);
}
```

I did try modifying the `motor.js` based on [the code from Seed Studio](https://github.com/Seeed-Studio/Grove_Motor_Driver_TB6612FNG) but kind of got lost in the API for J5 in terms of how pins are being used with I2C boards. The `GROVE_I2C_MOTOR_DRIVER` seems to be implemented using `setPWM `and `setPin `to determine speed and direction although the API from Seed Studio shows a run method that sets both speed and direction within the same I2C write while specifying which motor channel to work with.

```
 void MotorDriver::dcMotorRun(motor_channel_type_t chl, int16_t speed) {
    if (speed > 255) {
        speed = 255;
    } else if (speed < -255) {
        speed = -255;
    }

    if (speed >= 0) {
        _buffer[0] = GROVE_MOTOR_DRIVER_I2C_CMD_CW;
    } else {
        _buffer[0] = GROVE_MOTOR_DRIVER_I2C_CMD_CCW;
    }

    _buffer[1] = chl;
    if (speed >= 0) {
        _buffer[2] = speed;
    } else {
        _buffer[2] = (uint8_t)(-speed);
    }

    I2Cdev::writeBytes(_addr, _buffer[0], 2, _buffer + 1);
    delay(1);
}
```

All good fun :)

_Originally posted by @MintyMods in https://github.com/rwaldron/johnny-five/issues/1658#issuecomment-586633172_

MintyMods, 2020-02-16:
Confirmed as not compatible due to using different register locations.

MintyMods, 2020-02-16:
For reference the register values the board requires:-

```
    REGISTER: {
      value: {
        ADDRESS: 0x14,
      }
    },
    COMMANDS: {
      value: {
        BRAKE: 0x00,
        STOP: 0x01,
        CW: 0x02,
        CCW: 0x03,
        STANDBY: 0x04,
        NOT_STANDBY: 0x05,
        STEPPER_RUN: 0x06,
        STEPPER_STOP: 0x07,
        STEPPER_KEEP_RUN: 0x08,
        SET_ADDR: 0x11,
      },
```

MintyMods, 2020-02-16:
Picture showing the front of the [board](https://www.seeedstudio.com/Grove-I2C-Motor-Driver-TB6612FNG-p-3220.html):-

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

MintyMods, 2020-02-16:
Controlling the board directly using I2C does work using the following test code

```
    // "Grove_Motor_Driver_TB6612FNG.h"
    const I2C_GROVE_MOTORBOARD_ADDR = (0x14);
    const COMMAND = {
      BRAKE: 0x00,
      STOP: 0x01,
      CW: 0x02,
      CCW: 0x03
    }
    const MOTOR = {
      A: 0,
      B: 1
    }
    let speed = 127;

    // FORWARD Motor A @ speed
    board.io.i2cWrite(I2C_GROVE_MOTORBOARD_ADDR, COMMAND.CW, [MOTOR.A, speed]);
    board.wait(1000, function() {

      // REVERSE Motor A
      board.io.i2cWrite(I2C_GROVE_MOTORBOARD_ADDR, COMMAND.CCW, [MOTOR.A, speed]);
      board.wait(1000, function() {
  
          // STOP Motor A
          board.io.i2cWriteReg(I2C_GROVE_MOTORBOARD_ADDR, COMMAND.STOP, MOTOR.A);
          board.wait(1000, function() {

            // REVERSE Motor B
            board.io.i2cWrite(I2C_GROVE_MOTORBOARD_ADDR, COMMAND.CCW, [MOTOR.B, (speed + 100)]);
            board.wait(1000, function() {

                // FORWARD Motor B
                board.io.i2cWrite(I2C_GROVE_MOTORBOARD_ADDR, COMMAND.CW, [MOTOR.B, (speed + 100)]);
                board.wait(1000, function() {

                    // BRAKE Motor B
                    board.io.i2cWriteReg(I2C_GROVE_MOTORBOARD_ADDR, COMMAND.BRAKE, MOTOR.B);

                });
            });
        });
      });
    });
```

MintyMods, 2020-02-16:
If someone could point me in the right direction for what is required to provide a new `Motor Board` _(for this [Grove V1 TB6612FNG](https://www.seeedstudio.com/Grove-I2C-Motor-Driver-TB6612FNG-p-3220.html))_ as well as new `Shield` implementation for the [Atlas Tenticle Shield](https://www.whiteboxes.ch/docs/tentacle/t1/#/) within the Johnny-Five API?

I would like to contribute both if this is possible?

They are both controlled via I2C so I just need to understand how to integrate these I2C calls into Johnny-Five callbacks? Also my current usage for the Atlas Shield is by requesting readings so not sure how this fits with the J5 event driven aspect.

Any tips on the testing framework (grunt, spy) you guys are using are using would also be appreciated as I tried to 'un-comment' the `onchange` test within the `TH02 imu.js test` but got lost with the spy.calls being null.

Thank you for any pointers.

dtex, 2020-02-16:
I can help a lot more with motor.js than I could with imu.js.

## Grove

The GROVE_I2C_MOTOR_DRIVER controller was built for the Grove L298 based motor controller, so we will need to distinguish the two. I would rename ```GROVE_I2C_MOTOR_DRIVER``` to ```GROVE_I2C_L298``` and then add an undocumented alias for ```GROVE_I2C_MOTOR_DRIVER``` so legacy code continues to work.

Then I would create a new controller called ```GROVE_I2C_TB6612FNG```. This new controller is unlike any motor controller that we support (and we support a lot) so you're gonna have to override some stuff, but fortunately, this class was designed with that in mind.

It's tricky because a single register is used to set the direction for both motors and we have always managed motors independently. Further, the pattern of bits used to represent direction is just completely bonkers. That's not a hard problem to solve, it just requires an unnecessarily messy conditional when setting direction (instead of just using bitwise operators on two bits). Note: I'm being whiny about this thing I don't like but it's really not a big deal to overcome.

You will also have to manage board state, not just motor state, since each board will always need to know direction data for both motors and you could have more than one of these boards attached. I would probably just add a state object to the controller that uses i2c addresses as keys so you can store state for multiple boards.

## Atlas Tentacle Shield

Except for Temperature, we don't have classes that these sensors would fit in. I think they might be best suited for a [Johnny-Five plug-in](http://johnny-five.io/examples/plugin/).

MintyMods, 2020-02-17:
Thanks again @dtex for your prompt assistance.

I am still a little confused over the use of pins when it comes to these I2C devices. Is it simply a case of the pin API is just being re-used to specify a unique identifier to determine which of the (2 in this case) motors we are dealing with within the board.

Are there any existing example J5 plugins that I could take a look at?

I will have a play and see where I can get with this.

MintyMods, 2020-02-17:
I think I am understanding some of the basics but hitting this:-

    [1] Debugger attached.
    [1] H:\Development\MintyHydro\node_modules\firmata-io\lib\firmata.js:831
    [1]     this.pins[pin].value = value;
    [1]                          ^
    [1]
    [1] TypeError: Cannot set property 'value' of undefined
    [1]     at Firmata.pwmWrite (H:\Development\MintyHydro\node_modules\firmata-io\lib\firmata.js:831:26)
    [1]     at Motor.setPWM (H:\Development\MintyHydro\node_modules\johnny-five\lib\motor.js:795:11)
    [1]     at Motor.speed (H:\Development\MintyHydro\node_modules\johnny-five\lib\motor.js:834:10)
    [1]     at Motor.stop (H:\Development\MintyHydro\node_modules\johnny-five\lib\motor.js:867:8)
    [1]     at Motor.value (H:\Development\MintyHydro\node_modules\johnny-five\lib\motor.js:476:14)
    [1]     at new Motor (H:\Development\MintyHydro\node_modules\johnny-five\lib\motor.js:774:8)

While I am still getting to grips with this *(I seriously didn't know you could attach the Chrome debugger to node until just now!)* Stepping via my new found **debugger** friend shows it is going into the standard Motor.setPWM

    Motor.prototype.setPWM  =  function(pin, value)  {
    this.io.analogWrite(pin,  __.map(value,  0,  255,  0,  this.board.RESOLUTION.PWM));
    };

rather than what I hoped would be my overridden function (based on nothing other than the other one works):-

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
I am assuming the error is caused because the standard motor code is running rather than what should be my overridden I2C alternative?

Is there some registration required for new boards such as the following which I remember from the `imu.js` I was recently playing with:-

    TH02:  {
    initialize:  {
    value:  function(opts)  {
    Components.call(this,  "TH02",  opts);
    }
    },
    components:  {
    value: [HYGROMETER, THERMOMETER]
    },
    },

MintyMods, 2020-02-17:
> ## Atlas Tentacle Shield
> Except for Temperature, we don't have classes that these sensors would fit in. I think they might be best suited for a [Johnny-Five plug-in](http://johnny-five.io/examples/plugin/).

I assume this would be a standalone project hosted on GitHub with NPM support for the Johnny-Five API?

MintyMods, 2020-02-19:
> I think I am understanding some of the basics but hitting this:-
>
Please ignore my previous post regarding the breakpoints etc.

A syntax error typo put the `setPWM` and `setPin` functions **within** the `initialize` function and I just couldn't spot the mistake:-

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

Correcting that and I can now see the overrides and hit the breakpoints.

Happily moving on...

MintyMods, 2020-02-20:
### **Wow!**
Really Sorry, I did not mean to publish all that GitHub traffic from my Fork of Johnny-Five...

I do struggle a little with Git still, as you can tell :)

On a plus note I _think_ I have made a progress and can now control the motors using J5.

I just need to get to grips with Grunt and produce the test and I will submit a PR for review.

I still don't understand how all the `STEPPER` functionality from the board will be used but it doesn't look like this belongs in `motor.js` anyway?

dtex, 2020-02-20:
> I did not mean to publish all that GitHub traffic

No big deal, it's just a bunch of references. If that's the worst thing that happens you're doing really good.

You're right about stepper. It has its own class and unless you need to control steppers, I wouldn't worry about it.

MintyMods, 2020-02-21:
@dtex Can you please expand on your following comment and/or point me in **_any_** direction for more information about this?

> It's tricky because a single register is used to set the direction for both motors and we have always managed motors independently. Further, the pattern of bits used to represent direction is just completely bonkers. That's not a hard problem to solve, it just requires an unnecessarily messy conditional when setting direction (instead of just using bitwise operators on two bits). Note: I'm being whiny about this thing I don't like but it's really not a big deal to overcome.

Currently I am just overriding `setPWM` and `setPin` and this seems to be working fine in terms of actually controlling the motor direction and speed :-

```
    setPWM: {
      value: function(pin, value) {
        var state = priv.get(this);
        var direction = state.shared.direction[state.pin];
        var speed = Board.constrain(value, 0, 255) | 0;
        state.shared.speed[state.pin] = speed;
        this.io.i2cWrite(this.address, direction, [this.MOTOR[state.pin], speed]);
      }
    },
    setPin: {
      value: function(pin, value) {
        var state = priv.get(this);
        var speed = state.shared.speed[state.pin];
        var direction = value ? this.COMMANDS.CW : this.COMMANDS.CCW;
        state.shared.direction[state.pin] = direction;
        this.io.i2cWrite(this.address, direction, [this.MOTOR[state.pin], speed]);
      }
    },
```

But I am struggling to write sensible tests for `forwardControlBoth` and `reverseControlBoth` as using more than one motor seems to complicate things and I don't see the I2C traffic I would expect from the `this.i2cWrite.getCall(X)`. Any help with this is appreciated but I suspect it has something to do with your previous comment.

> You will also have to manage board state, not just motor state, since each board will always need to know direction data for both motors and you could have more than one of these boards attached. I would probably just add a state object to the controller that uses i2c addresses as keys so you can store state for multiple boards.
>

I need to purchase an additional board to be able to understand, work on and test this functionality but can I ask if the existing `GROVE_I2C_MOTOR_DRIVER` supports this board state as this new controller is basically just a copy of that one.

Thank you again for helping me with **all** my issues.

Closed 2022-01-09.

Thread 1675 (2020-04-21):

How to create functions that are reusable with an instance of the board ?

ademarCardoso, 2020-04-21:
Hello everyone, I'm using the jhonny-five lib to create a project for a braille printer, I'm using a stepper motor and a relay, the code below is one of the printer's functions, but I can't start the motor and neither the relay the way I set it up, I need separate functions but I don’t know how to use the Board instance that way, at the moment this code doesn’t give any error, it connects to the Arduino but doesn’t do anything else. Does anyone know how to set up functions that run the relay and stepper separately, so that I can call certain parts of the code?

// Example code
```js
const five = require("johnny-five")
const board = new five.Board()
let text = [['1','0'],['0','0'],['0','0']]
let size = text.lenght

// This Loop will be executed several times, this is just an example
for (let init = 0; init < text.length; init++) {
    mark(text[init][0], 0)
  }

function next(direction, steps = 500) { // Change the steps number
  board.on("ready", () => {
    let stepperMotor = new five.Stepper({
      type: five.Stepper.TYPE.DRIVER,
      stepsPerRev: 200,
      pins: {
        step: 3,
        dir: 2
      }
    })

    stepperMotor.rpm(300).step({ steps: steps, direction: direction }, function () {
      console.log("jump to next mark")
    });
  })
  return
}

function mark(text, direction) {
  board.on("ready", () => {
    let relay = new five.Relay(4)

    if (text[0] === '0') {
      next(direction)
    }
    if (text[0] === '1') {
      relay.open()
      relay.close()
    }
    if (text[1] === '0') {
      next(direction)
    }
    if (text[1] === '1') {
      relay.open()
      relay.close()
    }
  })
}
```

ademarCardoso, 2020-04-28:
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

dtex, 2020-04-28:
In most apps the board.on("ready") listener is something you attach only once when first starting your program. I can give an example later, after work.

dtex, 2020-04-29:
Sorry, I forgot to do this last night. Note that this is just one way and I did not test with hardware of course:

````js
const five = require("johnny-five")
const board = new five.Board()
let text = [['1','0'],['0','0'],['0','0']]
let size = text.lenght

board.on("ready", () => {

  // Initialize the components (happens just one time)
  const stepperMotor = new five.Stepper({
    type: five.Stepper.TYPE.DRIVER,
    stepsPerRev: 200,
    pins: {
      step: 3,
      dir: 2
    }
  });

  const relay = new five.Relay(4)

  // Let's define our methods that use those componenets
  function next(direction, steps = 500) { // Change the steps number
    stepperMotor.rpm(300).step({ steps: steps, direction: direction }, function () {
      console.log("jump to next mark"); // Happens when motor finishes move
    });
    return; // This will happen right away
  }

  function mark(text, direction) {
    if (text[0] === '0') {
      next(direction)
    }
    if (text[0] === '1') {
      relay.open()
      relay.close()
    }
    if (text[1] === '0') {
      next(direction)
    }
    if (text[1] === '1') {
      relay.open()
      relay.close()
    }
  }

  // And here is where would start to use those methods
  for (let init = 0; init < text.length; init++) {
    mark(text[init][0], 0)
  }

});
````

dtex, 2020-04-29:
I submitted a reply but quickly realized it was flawed. I didn't forget about you, it's just a little trickier. Here's an incomplete solution:
````js
const five = require("johnny-five")
const board = new five.Board()
let text = [['1','0'],['0','0'],['0','0']]
let size = text.lenght

board.on("ready", () => {

  // Initialize the components (happens just one time)
  const stepperMotor = new five.Stepper({
    type: five.Stepper.TYPE.DRIVER,
    stepsPerRev: 200,
    pins: {
      step: 3,
      dir: 2
    }
  });

  const relay = new five.Relay(4)

  // Let's define our methods that use those componenets
  function next(direction, steps = 500) { // Change the steps number
    stepperMotor.rpm(300).step({ steps: steps, direction: direction }, function () {
      console.log("jump to next mark"); // Happens when motor finishes move
    });
    return; // This will happen right away
  }

  function mark(text, direction) {
    if (text[0] === '0') {
      next(direction)
    }
    if (text[0] === '1') {
      relay.open()
      relay.close()
    }
    if (text[1] === '0') {
      next(direction)
    }
    if (text[1] === '1') {
      relay.open()
      relay.close()
    }
  }

  // Your actual program goes here

});
````
The reason I say "incomplete" is that I didn't try and add your logic code. The flaw in my earlier post and your original code was that all the commands are sent to the Arduino right away instead of waiting for each move and then waiting for each relay cycle to execute.

ademarCardoso, 2020-05-01:
Thanks @dtex  for remembering me, at the moment almost everything is working, only that the chambers go all at once, would there be any way to avoid it, or do I add setTimeOut everywhere? And thanks for the answer above, it helped me a lot :)

dtex, 2020-05-01:
I would create an array that works as a FIFO queue for commands that will be sent to your printer. You can take a single command (next, mark, reverse) from the queue, and then call an async function that executes each command.

This sounds like a super cool project. I hope you share some videos of it in action.

ademarCardoso, 2020-05-01:
I'll try to implement this today, if everything goes well, I'll send a video of everything working, I'm building a Braille printer :)

Closed 2020-06-19.

Thread 1682 (2020-05-15):

Uncaught 1-Wire timeout

misterzirillo, 2020-05-15:
Board: Arduino Uno R3 and Arduino Nano (clone)
ConfigurableFirmata: 2.10.1
J5 version: 1.4.0
Node.js version: v10.15.2 (raspbian)

I'm using some DS18B20 1wire devices via `var sensor = new five.Thermometer({ controller: "DS18B20" })`. The devices work properly however when the board is disconnected (in software or otherwise) node quits with the following error:

```
./node_modules/firmata-io/lib/firmata.js:1632
      callback(new Error("1-Wire device read timeout - are you running ConfigurableFirmata?"));
               ^
Error: 1-Wire device read timeout - are you running ConfigurableFirmata?
    at Timeout._onTimeout (./node_modules/firmata-io/lib/firmata.js:1632:16)
    at listOnTimeout (internal/timers.js:549:17)
    at processTimers (internal/timers.js:492:7)
```

I have on "error" handlers for both the board and sensor objects but they don't make a difference.

I've also looked at [the offending line in firmata-io](https://github.com/firmata/firmata.js/blob/a94b8cceaee6e08d5c60deeafed8788b345dcf75/packages/firmata-io/lib/firmata.js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). Searching the function `sendOneWireWriteAndRead` in this codebase I came across [this line](https://github.com/rwaldron/johnny-five/blob/d278bc46b506277f088412ef556f7659e61cfa47/lib/thermometer.js#L102) where an error might not be accounted for.

Could this be the problem?

If it's as simple as what I've got below then I can submit a PR. Otherwise, I'm having trouble understanding how to get from `five.Thermometer` to `sendOneWireWriteAndRead`.

```javascript
if (err) {
  this.emit("error", err);
  return;
}
```

misterzirillo, 2020-05-15:
Looking through the open issues I can see this is possibly a duplicate of #1665. However I've got no issues using one or multiple thermometers for extended periods of time. I only see the timeout after the board is disconnected.

saksholm, 2020-05-26:
@misterzirillo I struggled a long time with that DS18B20 '1-Wire device read timeout' problem on #1665 . If more than 2 sensors were attached it crashes after some ~20mins. I need at least 14 for my project and stable reading. I never found a reason for that and solved this with a backpack. [My dirty hack](https://github.com/saksholm/i2c-backpack) not cleaned and really messy. That sends 2bytes per temperature reading (integers which are multiplied by 100). Total 28bytes (32maximum per time)

Attached sensors to Uno board and created a program for that. Now it communicates via I2C, reads all sensor data once a second, and then I can do whatever I want.

Sounds stupid hack for me but I have lived with that unless I or someone else found an easy solution for this timeout problem.

Closed 2022-01-09.

Thread 1691 (2020-07-04):

Query not returning callback

fencer, 2020-07-04:
when querying the pin state on beaglebone green wireless using the example code below the callback function is never executed.

```
var pin = new five.Pin("P8_29");

pin.query(function(state) {
  console.log(state);
});
```

(using the same pin will fire the high / low event so it's not a hardware issue)

dtex, 2020-07-04:
```query()``` just wraps the IO plugin's ```queryPinState()``` method. I don't have a Beaglebone to try and recreate, but a quick test to see if this is a Johnny-Five issue, or something that should be asked over in beaglebone-io could be:
````js
// Let J5 configure the pin
var pin = new five.Pin("P8_29");

// Query beaglebone-io directly (assumes your board is named "board")
board.io.queryPinState("P8-29", function(state) {
  console.log(state);
});
````

dtex, 2020-07-04:
This [test file](https://github.com/julianduque/beaglebone-io/blob/56779176904acdd95932bff5318ee35edfc9173f/test/not-implemented.js) suggests to me that queryPinState has not been implemented in beaglebone-io.

fencer, 2020-07-04:
Wow! Wouldn't have expected this! What other alternative methods I can use instead?

dtex, 2020-07-04:
Tell me what you are trying to do. Typically J5 programs do not need pin.query.

fencer, 2020-07-04:
My use case isn't the typical J5 implementation but what i have is a number of analogue sensor that I need to read the value of. Along with those I have other circuitry that will send a digital high when the state changes. To display these readings I have a websocket application. I am currently changing the values onthe page by listening to the high / low events but when the server application is loaded the value is not updated untill the pin state is toggled (which will fire the high/low event). To solve this I would need to query the pin state on application start

dtex, 2020-07-04:
Can you just read the pin value property after calling ```read()```?
````js
console.log(pin.value);
````

fivdi, 2020-07-04:
If a Pin is created and its mode is set to `INPUT` or `ANALOG` then its `value` property will be updated at regular intervals by Johnny-Five automatically. However, there may be issues if the `value` is accessed before Johnny-Five has a chance to update it for the first time. If the `value` is accessed before Johnny-Five has updated it for the first time then Johnny-Five will say that the value is 0 although it may be 1. It's possible to workaround this issue by adding a short delay before accessing `value` for the first time. The below program attempts to show this.

```js
var five = require('johnny-five');
var BeagleBone = require('beaglebone-io');

var board = new five.Board({
  io: new BeagleBone()
});

board.on('ready', function() {
  var pin = new five.Pin({
    pin: 'P8_29',
    mode: this.MODES.INPUT
  });

  console.log('pin.value (may print incorrect value): ' + pin.value);
  console.log('readSync() HACK (will print correct value): ' + board.io._pins[board.io.normalize('P8_29')].gpio.readSync());
  setInterval(function () {
    console.log('pin.value (will print correct value): ' + pin.value);
  }, 1000);
});
```

This program also shows a terrible hack that relies on implementation details of beaglebone-io that could also be used to workaround the issue.

Closed 2022-04-17.

Thread 1697 (2020-08-08):

No data from Adafruit BNO055

pauldb126, 2020-08-08:
Hi, first of all, really appreciate Johnny-five.
Everything I have tried works just as I would expect, apart from the Adafruit BNO055 IMU.

I have tried it hooked up to an Arduino Uno and a Nano. I am running Node on a Raspberry Pi and connecting to the Arduino via USB. Everything seems fine. Board initializes. I have an Adafruit Ultimate GPS hooked up aswell and that gives readings.

In order to test the BNO055 board and Arduino, I unplugged the Raspberry Pi. I then connected the Arduino board, with BNO055 attached, to my PC and used the Ardiuno IDE to install and run their example programs. All work fine, readings as I would expect. This indicates to me that the pin connections between the Arduino and the BNO055 are correct.

So, returning the Arduino connection to the Raspberry Pi, I tried specifying the Port used for the board in order that I could specify different baud rates. However, despite following the examples. That did not seem to work either, I get an error related to the board pins.

Any help would be greatly appreciated. Many thanks, Paul

pauldb126, 2020-08-08:
It's just occurred to me that maybe I cannot have both the BNO055 and GPS breakouts hooked up to the same Arduino controller. I will experiment more.
In the meantime, I have found someone that seems to experience the same issue:

https://forum.arduino.cc/index.php?topic=494127.0

pauldb126, 2020-08-09:
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

Tried again without the GPS breakout hooked up. Same result.
There's either an issue with my setup or Johnny-Five is failing to get readings from the BNO055. As I said in my original post, the breakout and Arduino board respond perfectly when connected to the Arduino IDE.

pauldb126, 2020-08-11:
The example eg/imu-bno055.js does not work for me either.

dtex, 2020-08-11:
Just curious, have you tried using the BNO055 with Johnny-Five running on your computer instead of the Pi?

pauldb126, 2020-08-11:
> Just curious, have you tried using the BNO055 with Johnny-Five running on your computer instead of the Pi?

Thanks for the suggestion. I will try that.

One thing I noticed during installation of npm packages on the pi, there were a number of warnings when installing 'serialport' but none seemed fatal to me.

Anyhow, I will try from the PC. Thanks.

pauldb126, 2020-08-12:
>
>
> Just curious, have you tried using the BNO055 with Johnny-Five running on your computer instead of the Pi?

Tried it. Same result. All readings giving zero values. That is not the case when I use the Arduino IDE and run their sample programs which makes me think I am using the right pin connections.

If the baud rate on the USB port was wrong, would I see an error? Also, as I have mentioned, I have a GPS breakout attached to the same Arduino controller and I get results from that.

pauldb126, 2020-08-16:
I retried connected to my PC rather than the Pi and I managed to get it to work by moving the BNO055 around in order to calibrate it.
However, it still would not work when connected to the Pi. However, I connected it to a separate Arduino Nano - i.e. not the same one that the GPS was connected to. Then it worked. However, it was sensitive to the USB port on the Pi to which the board was connected.
So, if there is an issue - then it's that two breakouts cannot work off the same Arduino Nano - but that might not be a Johnny-Five issue. There is also a question about the sensitivity of the USB port used. Again, that might be an issue with the Pi or with me, not necessarily with Johnny Five (I will try specifying the port for the board).
In any case, the reason why I created this issue in the first place no longer seems valid so I will close it.

Closed 2020-08-16.

Thread 1707 (2020-10-18):

Servo interfering with AnalogWrite on other pins

kula124, 2020-10-18:
Hello! It's me again.

I'm having the following code:
```js
const five = require('johnny-five')
const motorAction = require('./constants/motor')
const servoAction = require('./constants/servo')
const motor = require('./customMotor')

const servo = new five.Servo({
  pin: process.env.SERVO_PIN,
  startAt: process.env.SERVO_BALANCE_ANGLE,
  range: [0, 180],
  center: true
})

function act (type, data) {
  switch (type) {
    case motorAction.FORWARD:
      motor.forward(data)
      break
    case motorAction.REVERSE:
      motor.reverse(data)
      break
    case motorAction.SWITCH:
      motor.switchSide()
      break
    case motorAction.STOP:
      motor.stop()
      break
    case servoAction.RIGHT:
      servo.to(parseInt(servo.startAt) + parseInt(data))
      break
    case servoAction.LEFT:
      servo.to(servo.startAt - data)
      break
    case servoAction.RESET:
      servo.to(servo.startAt)
  }
}
```
And this is my CustomMotor.js:
```js
const five = require('johnny-five')

const dir = new five.Pin(7)
const cdir = new five.Pin(8)
const pwm = new five.Led(9)

const cMotor = {
  forward: (value) => {
    pwm.brightness(value)
    dir.high()
    cdir.low()
  },

  stop: () => {
    // pwm.brightness(0)
    dir.low()
    cdir.low()
  },

  reverse: (value) => {
    pwm.brightness(value)
    cdir.high()
    dir.low()
  }
}

module.exports = cMotor
```

Controller is called by keyboard interface or by joystick via web socket.
I have connected LEDs on the breadboard to pins 7,8,9. I can 100% conclude that PWM pin is NOT working if Servo class is defined. However, if I comment it out and unplug/plug the board (RESET won't help) it begins to work fine.

Creation of Servo kills the PWM. Can you please confirm this?
I have lost 10+ hours until I found this bug. All I see is PWM not firing, but couldn't figure out why. This is 100% reproducible

dtex, 2020-10-18:
Arduino Uno? What pin is the Servo on?

n00ne1mportant, 2020-10-18:
Yes, it's Uno, servo on pin 11
Motor on pin 9

dtex, 2020-10-18:
Try the servo down on pin 5. I think it's a shared timer issue.

n00ne1mportant, 2020-10-18:
I changed it to pin number five and left everything else unchanged, still the same problem.

If it helps, I changed the order of the creation so I create and use the motor first. The PWM LED on the board goes off, then it blinks and stays off after that. No longer responding. If Servo is not used, it stays on and behaves as expected.

n00ne1mportant, 2020-10-19:
I have found the problem.
Even the official Arduino library for servo has the same issue.

When servo is attached pins 9 and 10 can no longer be used as PWM pins. Attaching PWM to pin 5 seams to work fine even with servo on 11.

This is a problem for me doe since I'm using motor driver shield and it defaults on pins 9 and 10 for motor drivers. I'm figuring out workaround as we speak and then I will close the issue.
I think docs should be updated to highlight this problem in Servo section. I'll send you the PR later today.

References:
https://forum.arduino.cc/index.php?topic=64845.0

https://www.arduino.cc/reference/en/libraries/servo/

^Usage section

Prath06, 2020-10-27:
I faced such problems due to broken jumper wires.
Check the jumper wires or soldering points.

n00ne1mportant, 2020-10-28:
Hi, I fixed it.
Pins 9 and 10 are not working when servo is connected, it's not bad wiring or anything like that.
The way I fixed it is hackish. Since I need pin 9 to make the motor shield run and it won't work with servo, I soldered the pin on the upside of the shield so it doesn't connect to pin 9. Then I just connected that pin to PWM pin 3.

Picture is a thousand words:
[1000 words](https://prnt.sc/v8ul0q)

Pull request is opened

Closed 2022-04-17.

Thread 1713 (2020-11-09):

Sensor on A2 stops Button on 2 from working

tysseng, 2020-11-09:
**Board:** Arduino Uno
**Hardware:** 1 button on pin 2, one potentiometer on pin A2
**Version:** 2.0.0

**My expectations:** It should be possible to have a button on digital pin 2 and a potentiometer on analog pin 2
**Actual outcome:** Button on digital pin 2 stops working (no events are triggered) when initialising sensor on A2. If I initialise the sensor on A2 first, the button works.

**Details:**
I suspect that there is something wrong on line 61 in sensor.js:

`this.io.pinMode(this.pin, this.mode);`

When initializing a sensor with pin "A2" or "16", this is translated to "2" before reaching this line. Is it possible that the line above actually sets mode on (digital) pin 2 instead of analog pin 2?

When I have a button on "2", this stops working if I add a sensor on pin "A2". If I add the button AFTER the sensor in the code, everything works fine. Example:

**Steps to reproduce:**

Non working:
```
var five = require("johnny-five"), button, led, pot;
new five.Board().on("ready", function() {
  led = new five.Led(7);

  button = new five.Button({ pin: 2, isPullup: true });
  button.on("down", () => led.on());
  button.on("up", () => led.off());

  pot = new five.Sensor("A2");
});
```

Working:
```
var five = require("johnny-five"), button, led, pot;
new five.Board().on("ready", function() {
  led = new five.Led(7);
  pot = new five.Sensor("A2");

  button = new five.Button({ pin: 2, isPullup: true });
  button.on("down", () => led.on());
  button.on("up", () => led.off());
});
```

Removing the pinMode on  line 61 in sensor.js also fixes the issue.

rwaldron, 2020-11-15:
It's possible that what you're saying accurately describes the issue, but that shouldn't happen. There is a flow through Board.Component and Board.Options that should normalize pins to whatever the IO plugin defines. In this case "A*" _should_ be normalized to an index that matches analog pin 2. It's possible that logic has gone missing. I'll take a look this week.

rwaldron, 2020-11-17:
Looks like there may be a bug in Firmata.js. IIRC, `pinMode(pin, mode)` should reconcile `pin` to the correct index  based on `mode`.

rwaldron, 2020-11-17:
Looks like Firmata has always done it the way it currently is. It's possible this bug has existed forever and people either didn't hit it or did and just worked around it without reporting it.

rwaldron, 2020-11-17:
@tysseng please try the following:

```
npm uninstall johnny-five; npm install johnny-five;
```

Then re-run your program and report back whether the problem is resolved. Thanks!!

Closed 2022-04-17.
