rwaldron/johnny-five/(list of files, drawings)

Other design files:
docs/breadboard/accelerometer-adxl335.fzz
docs/breadboard/accelerometer-adxl345.fzz
docs/breadboard/accelerometer-LIS3DH.fzz
docs/breadboard/accelerometer-lis344al.fzz
docs/breadboard/accelerometer-mma7361.fzz
docs/breadboard/accelerometer-MMA8452.fzz
docs/breadboard/accelerometer-mpu6050.fzz
docs/breadboard/accelerometer.fzz
docs/breadboard/attiny-programmer.fzz
docs/breadboard/attiny-slave.fzz
docs/breadboard/ball-switch.fzz
docs/breadboard/barometer-mpl3115a2.fzz
docs/breadboard/board-multi.fzz
docs/breadboard/button-bumper.fzz
docs/breadboard/button-collection-AT42QT1070.fzz
docs/breadboard/button-options.fzz
docs/breadboard/button-pullup.fzz
docs/breadboard/button.fzz
docs/breadboard/compass-hmc5883l.fzz
docs/breadboard/compass-hmc6352.fzz
docs/breadboard/compass-MAG3110-tessel.fzz
docs/breadboard/compass-MAG3110.fzz
docs/breadboard/directional-motor.fzz
docs/breadboard/esc-array.fzz
docs/breadboard/esc-bidirectional-forward-reverse.fzz
docs/breadboard/esc-bidirectional.fzz
docs/breadboard/esc-dualshock.fzz
docs/breadboard/esc-keypress.fzz
docs/breadboard/esc-PCA9685-b.fzz
docs/breadboard/esc-PCA9685.fzz
docs/breadboard/escs-2-controllers.fzz
docs/breadboard/esplora.fzz
docs/breadboard/expander-74HC595.fzz
docs/breadboard/expander-ADS1115-4-pots.fzz
docs/breadboard/expander-CD74HC4067-14-pots.fzz
docs/breadboard/expander-CD74HC4067_NANO_BACKPACK.fzz
docs/breadboard/expander-LIS3DH.fzz
docs/breadboard/expander-MCP23008-basic.fzz
docs/breadboard/expander-MCP23008.fzz
docs/breadboard/expander-MCP23017-basic.fzz
docs/breadboard/expander-MCP23017.fzz
docs/breadboard/expander-MUXSHIELD2-analog-read.fzz
docs/breadboard/expander-MUXSHIELD2-mixed.fzz
docs/breadboard/expander-PCA9685.fzz
docs/breadboard/expander-PCF8574-basic.fzz
docs/breadboard/expander-PCF8574.fzz
docs/breadboard/expander-PCF8575-basic.fzz
docs/breadboard/expander-PCF8575-led-button.fzz
docs/breadboard/expander-PCF8575.fzz
docs/breadboard/expander-PCF8591.fzz
docs/breadboard/flex.fzz
docs/breadboard/GP2Y0D810Z0F.fzz
docs/breadboard/gps-adafruit.fzz
docs/breadboard/gps-GP-20U7.fzz
docs/breadboard/gps-hardware-serial.fzz
docs/breadboard/gps.fzz
docs/breadboard/grove-lcd-rgb-temperature-display.fzz
docs/breadboard/grove-lcd-rgb.fzz
docs/breadboard/gyro-lpr5150l.fzz
docs/breadboard/gyro-mpu6050.fzz
docs/breadboard/hc-sr04.fzz
docs/breadboard/humidity-htu21d.fzz
docs/breadboard/humidity-sht31d.fzz
docs/breadboard/imp-led.fzz
docs/breadboard/imu-bno055.fzz
docs/breadboard/imu-lsm303c.fzz
docs/breadboard/ir-proximity.fzz
docs/breadboard/joystick-adafruit.fzz
docs/breadboard/joystick-motor-led.fzz
docs/breadboard/joystick-pantilt.fzz
docs/breadboard/joystick-sparkfun.fzz
docs/breadboard/keypad-3X4_I2C_NANO_BACKPACK.fzz
docs/breadboard/keypad-4X4_I2C_NANO_BACKPACK.fzz
docs/breadboard/keypad-MPR121.fzz
docs/breadboard/keypad-MPR121QR2.fzz
docs/breadboard/keypad-MPR121QR2_SHIELD.fzz
docs/breadboard/keypad_4X4_I2C_NANO_BACKPACK.fzz
docs/breadboard/kinect-arm-controller.fzz
docs/breadboard/lcd-16x2-tessel.fzz
docs/breadboard/lcd-enumeratechars.fzz
docs/breadboard/lcd-i2c.fzz
docs/breadboard/lcd-JHD1313M1.fzz
docs/breadboard/lcd-pcf8574.fzz
docs/breadboard/lcd-rgb-bgcolor-previewer.fzz
docs/breadboard/lcd-rgb-tessel-grove-JHD1313M1-external.fzz
docs/breadboard/lcd-rgb-tessel-grove-JHD1313M1.fzz
docs/breadboard/lcd-runner-20x4.fzz
docs/breadboard/lcd-runner.fzz
docs/breadboard/lcd.fzz
docs/breadboard/led-1-edison-miniboard.fzz
docs/breadboard/led-11-pwm.fzz
docs/breadboard/led-13-edison-arduinoboard.fzz
docs/breadboard/led-13-galileo.fzz
docs/breadboard/led-13-mega.fzz
docs/breadboard/led-13-raspberry-pi.fzz
docs/breadboard/led-13.fzz
docs/breadboard/led-array-2-controllers.fzz
docs/breadboard/led-array-controller.fzz
docs/breadboard/led-array.fzz
docs/breadboard/led-digits-clock-arduino.fzz
docs/breadboard/led-digits-clock-dual.fzz
docs/breadboard/led-digits-clock-galileo.fzz
docs/breadboard/led-digits-clock-HT16K33.fzz
docs/breadboard/led-digits-clock.fzz
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
