rwaldron/johnny-five/(commit log)

2012-04-08 Adds basic led example; eg/led.js
2012-04-09 Update to support testable board objects
2012-04-09 Ported Led module; tweaks to Board constructor
2012-04-10 New tests for board hardware caching
2012-04-10 Led module
2012-04-10 Button module
2012-04-11 Add Board.mount() api and tests
2012-04-11 All board instances now have bound repl sessions
2012-04-11 Implement per instance rep; Board.mount() api; instance ready flag
2012-04-11 Update modules to use Board.mount();
2012-04-11 Adding an _E_xtended grep line for ACM devices
    -E is a POSIX flag for grep that allows extended grep searches. This
    should be portable, although some rough testing might be needed (This
    is part of the POSIX standard, so we should be OK)
2012-04-11 First pass at sensor module support
2012-04-21 lazy commit. progress with sensors: ping (broken), pir (awesome)
2012-04-23 Initial servo module
2012-04-23 set mode once, reuse instance prop
2012-04-23 led todo
2012-04-23 led example
2012-04-23 Create method pass-through from Board constructor to Firmata
2012-04-23 Add comments to led example
2012-04-23 Break led into 3 different examples
2012-04-23 Led examples: on/off, fade, strobe
2012-04-23 Initial framework for Board prototype timer functions
2012-04-23 Remove led instance
2012-04-23 Cleanup, additional servo comments
2012-04-23 Adds new Board module example
2012-04-25 Rename servo event "moved"=>"move"
2012-04-25 Initial motor module, demo and doc file
2012-04-25 Use board.wait() api
2012-04-25 Joystick, Motor & Led demo
2012-04-25 Adds video of Joystick, Motor & Led demo
2012-04-26 Board.range(), Board.range.prefixed(); Board.Pin.is__(); Serial.online;
2012-04-26 Servo: switch to use Board.Pin.is__(); Document continuous speeds
2012-04-26 Sensor, Joystick: update analog pin mapping
2012-04-26 Breadboards: Board, Button, Button-options, Continuous, Motor, PIR, Repl, Servo
2012-04-27 Breadboards: Servo, Continuous, Joystick, Joystick Motor Led, Led, Led Fade, Led On/Off, Led Strobe
2012-04-27 Add Fritzing files @ docs/breadboard/*
    [button-options.fzz, continuous.fzz, joystick-motor-led.fzz, joystick.fzz, led-fade.fzz, led-on-off.fzz, led-strobe.fzz, motor.fzz]
2012-04-27 Add support for simple constructor args ie. 'new five.Servo(pin)`
2012-04-27 Adds joystick-claw example and video
2012-04-27 Regenerate Readme and new joystick-claw.md
2012-04-27 Adds Sonar module
2012-04-27 Sonar Module. v0.1.6
2012-04-28 Update Button module to use a state mapping similar to Motor
2012-04-28 Move test/johnny-five_test.js => test/board.js
2012-04-28 Implement Board.options(arg) for normalizing module options; Reduces boilerplate
2012-04-28 Update modules to use Board.options(arg) normalization
2012-04-28 Update eg/servo.js to use short form args list
2012-04-30 Implements Board.map() & Board.constrain() -- equiv of Arduino functions by same name
2012-04-30 Implement clamped ranges, mapped and constrained values
2012-04-30 Implement reference to board on each module instance
2012-04-30 Update Button examples to use real values for pins
2012-04-30 Improved Servo API: min, max, center: all range constrained.
2012-04-30 Better inline comments on Board
2012-04-30 Dual servo via repl example program
2012-04-30 Fix linting in lib/sensor.js
2012-04-30 Improved Servo.prototype.sweep, Servo.prototype.move
2012-04-30 Board <-> Serialport logging
2012-05-01 Implement custom range support for Servo.prototype.sweep()
2012-05-01 Add Sensor tutorial link
2012-05-01 Support user defined Servo ids
2012-05-01 Adds Servo.Array example program
2012-05-01 Drop Switch and Ping
2012-05-02 Add move(deg) support to Servo.Arrays
2012-05-03 Updated servo array demo
2012-05-03 New servo + joystick + laser program
2012-05-05 Adds initial Accelerometer module, example program and doc file
2012-05-05 Improved Accelerometer "axischanged" event
2012-05-05 Adds scale( low, high ) method to Sensor instances
2012-05-05 Update Board to use __ privates.
2012-05-05 Updates to Sensor docs
2012-05-06 Prefer Led "intensity" property over "level" property
2012-05-06 Fixes to Servo.Array
2012-05-06 Major Led module refactoring; Implements Led.Array()
2012-05-07 Noise reduction improvements to Sonar and Sensor
2012-05-08 Example Program: Slider Panning a Servo
    [slider-pan.fzz]
2012-05-10 Update led-strobe example
2012-05-11 Update example programs, removes explicit debug param
    [slider-pan.fzz]
2012-05-14 Rebuild Example programs
    [accelerometer.fzz, ping.fzz, potentiometer.fzz, servo-digital.fzz, sonar.fzz]
2012-05-14 Fix RangeError: Maximum call stack size exceeded in Led class
2012-05-15 Reduce the default speed of Led.prototype.strobe()
2012-05-15 Note the default speed of Led.prototype.strobe() in readme example
2012-05-16 Add led.isRunning property; New Force Sensitive Resistor program
    [sensor-fsr.fzz]
2012-05-20 Board constructor cleanup
2012-05-25 Updates to slider-pan diagram
    [slider-pan.fzz]
2012-05-26 Measure sonar distance detection for changes events by 10th of inch
2012-05-27 Fix occurrences of "current".
    commit 3c52a2b02f21dea02f25d9913458a5eacea565bf
    Author: Mads Føhns <madsfohns@gmail.com>
    Date: Sun May 27 11:58:50 2012 +0200
    #4 Replaced "current" with "now" in lib/piezo.js
    commit 269b06a386896e85caac85b17cee443279f901fb
    Author: Mads Føhns <madsfohns@gmail.com>
    Date: Sun May 27 11:54:26 2012 +0200
    #4 Replaced "current" with "now" in lib/accelerometer.js
    commit e27ec030c7c2cbd379ece230e28a97bb2fbc2c76
    Author: Rick Waldron waldron.rick@gmail.com <waldron.rick@gmail.com>
    Date: Mon Apr 30 18:24:39 2012 -0400
    Initial piezo module
    Signed-off-by: Rick Waldron waldron.rick@gmail.com <waldron.rick@gmail.com>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
2012-06-03 Updates to servo and sensor inline docs
2012-06-03 servo and sonar combo program
2012-06-03 laser program
2012-06-04 Continuous servo's should always be manually adjusted, do not account for incorrect calibrations.
2012-06-04 More compass/magnetometer work
2012-06-11 Implements multi-usb device detection and program support!
2012-06-11 Overhaul of compass constructor, fixes value issues, allows for multiple compass devices to be supported via single API
    Negative number, nT spike correction was derived and adapted from Jeff Hoefs' Breakout.js > MagnetoMeterHMC5883.js
2012-06-11 Rename eg/compass=>eg/magnetometer. Adds breadboard image for doc file
2012-06-14 Improved logging messages from primary Board constructor
2012-06-14 Documentation: Accelerometer API
2012-06-14 Documentation: Button API
2012-06-25 Experimental switch from tty to cu
2012-06-25 Sample Magnometer programs (need board diagrams)
2012-06-27 Breadboard updates: navigator-joystick, sensor-fsr (fzz & png)
    [navigator-joystick.fzz, sensor-fsr.fzz]
2012-06-27 Simplify the sensor-fsr program code
2012-06-30 Update Led docs
2012-07-02 Rename eg/magnometer-servo.js => eg/magnometer-log.js
2012-07-09 LED api cleanup and bug fixes. Closes #14
    [navigator-joystick.fzz]
2012-07-10 Update readme to include direct links to supported Arduino IDE downloads
2012-07-12 Button: Switch Object.defineProperty to Object.defineProperties
2012-07-16 Button constructor updates, event debouncing
2012-07-16 New example program: Button/Bumper switch (eg/button-bumper.js)
    [button-bumper.fzz]
2012-07-22 Removed: eg/servo-diagnostic.js; New dir: util; Adds util/servo-lab.js
2012-07-22 Minor tweaks to lib/nunchuk.js for consistency with other I2C device constructors
2012-07-27 Extend full Led API to Led.Array
2012-07-27 Tweak servo.center() to be absolute degrees
2012-07-30 Removes PWMServo constructor. I2C writing issues abound
2012-07-31 Adds breadboard image and fritzing source for LCD. Closes #33
    [lcd.fzz]
2012-07-31 Adding generic Board.Event. Closes #34, #35
2012-07-31 Adding nunchuk button support and events. Fixes #27, Closes #36
2012-08-03 Moving setters from the Nunchuk.Button scope to a private WeakMap per @rwaldon's request
2012-08-03 Clearing potential hold timeout conflict on buttons due to global holdTimeout use.
2012-08-03 Moved accelerometer to weak map use.
2012-08-04 Add new Board.Device initializer. TODO: Migrate all constructors
2012-08-04 Ported from Liquid Crystal: write=>print, write, home, display, noDisplay, cursor, noCursor, blink, noBlink, createChar. Closes #41
2012-08-04 Add LCD.prototype.useChar example
2012-08-08 ShiftRegister API, test with 8-Bit 74HC595 IC
    [shiftregister.fzz]
2012-08-15 Gripper construction and API; example program
2012-08-15 Device tag supprot
2012-08-15 Device list
2012-08-15 Gripper board photo (not breadboard, actual photo)
2012-08-15 Add in missing fzz, remove erroneous links
    [sensor-slider.fzz, servo.fzz]
2012-08-21 Switch to matching servos for Biped/ED hip joints; walking.
2012-08-21 REPL and Board updates for process closing, error handling etc.
2012-08-22 Parts: Triple Axis Magnetometer Breakout - HMC5883L
2012-08-28 Adds Photoresistor program, includes breadboard png & fzz. Closes gh-64
    [photoresistor.fzz]
2012-08-29 Move signal wire to pin 7 in ping.fzz, re-export png. Fixes gh-66
    [ping.fzz]
2012-08-29 Switch IDE download version back to 1.0. This will temporarily mitigate the issues users are having with StandardFirmata 2.3
    References:
    https://github.com/jgautier/firmata/issues/8#issuecomment-6697732
    https://github.com/rwldrn/johnny-five/issues/57
2012-09-07 Create shiftOut method on board instances. Closes gh-68, gh-69
2012-09-08 seven segment display example & wiring diagram. Closes gh-70
    [seven-segment.fzz]
2012-09-16 first stab at rgb led
2012-10-02 LedControl, ported from LedControl.cpp by Eberhard Fahle
    [led-control.fzz]
2012-10-02 Minor tweaks to LedControl constructor. Added to lib namespace
2012-10-02 Renames breadboard files
    [led-matrix.fzz]
2012-10-02 Add new led-matrix program to program index
2012-10-02 led-matrix example program updates
2012-10-03 Fix addr check bugs introduced by LedControl refactors
2012-10-03 Make LedControl pins option and instance property match existing APIs
2012-10-19 Removed extra LED constructor & timer var. Closes gh-82
2012-10-19 Servo own property "moving" => "isMoving"
2012-10-19 lib/board.js; removes unused instance var, adds opts normalization to Board.Device initializer
2012-12-01 fixed button example
2012-12-01 Update docs/button.md. Closes gh-94
2012-12-01 ShiftRegister.prototype.send returns this
2012-12-01 Basic change sensitivity settings for Sensor instances
2012-12-01 LedControl, alias: latch -> cs
2012-12-07 Make descriptor part of the DeviceMap
2012-12-10 Sonar to not send read event when nothing was read since previous interval. Closes gh-97. Related gh-95
2012-12-15 Adds ADXL326 to supported Accelerometers. Updates parts.md
    * 'sonorfix' of https://github.com/twalker/johnny-five:
    sonor to not send read event when nothing was read since previous interval
    Conflicts:
    lib/sonar.js
2012-12-15 DeviceMap => Devices
2013-01-01 Added a basic 2-way switch as type of hardware
2013-01-01 Added breadboard and documentation
    [toggle-switch.fzz]
2013-02-11 Creates range controlled claw example.
2013-02-16 add option.invert to the button class
2013-02-16 clear the previous timer if one exists when calling Led.strobe
2013-02-17 Breaking change to the servo constructor options. opt.startAt is now a numeric value passed to move();
2013-02-18 Updated hand-claw program files
2013-02-24 Added eg/servo-options.js to explain startAt and center behavior
    And show off the other options other than 'id' which I don't understand yet.
2013-03-05 Cross-platform board detection with Windows support
2013-03-06 Support for translating arbitrary pin aliases/mapping (initial support for TinkerKit)
2013-04-14 Allow the user to set a serial port in board options. Ex. new Board({ port: "/dev/tty.usbfoo1234" }). Closes gh-52. Closes gh-111. Closes gh-51
2013-04-14 Updates to lib/board.js (see description)
    - Style nits;
    - Removes else clause from Serial.detect (either it has a port or it needs to find one)
    - Revert self = this aliasing
    - Explicit this to all callback call sites.
2013-04-14 Adds example program illustrating use of Board constructor's |port| option
2013-04-14 Direct Pin control: new five.Pin(#). Closes gh-87
    [pin.fzz]
2013-04-14 LedControl.prototype.setLed: lets you use setled n a similar way to how it's used in the native LedControl library. Closes gh-109
2013-04-14 Make setLed an alias for led, thanks @divanvisagie!
2013-04-29 Migrate all modules to use the shared Board.Device constructor as the super/base
2013-04-29 Introduce "cw" and "ccw" methods for continuous servos
2013-04-29 Implement customizable "Boolean Barrier" settings to allow scaling any sensor value directly to a boolean value
2013-04-29 Emit "high" and "low" events on Pin instances when the Board's pin state is changed by non-program means (physical changes)
2013-04-29 Commit pin-circuit-event assets (fzz and png)
    [pin-circuit-event.fzz]
2013-04-29 pin-circuit-event example program
2013-04-29 Adds pin-circuit-event, tinkerkit-* example programs to listed programs for generated readme
2013-05-01 document button invert option
2013-05-05 fix operator precedence error in Servo.center()
2013-05-21 Fix Pin.prototype.{read, write} method declaration's arguments
2013-05-25 Minor Board nits
2013-05-26 v0.6.2 Kinect controlled robot arm program
2013-05-30 Add @thieman's Power Glove to awesome nodebots
2013-06-02 Add @opheliasdaisies LED pressure sensor to awesome nodebots
2013-06-04 Default to max speed when leaving out the speed on servo.cw or servo.ccw
2013-06-10 Tinkerkit Accelerometer support
2013-06-10 atan2 is what you want for pitch computations
2013-06-11 Add smoother and first cut of noise filtering
    Simple blending smoother added. Will test and evaluate against more
    complex methods.
2013-06-12 Fixes missing semicolon and missing var declaration in board.js
2013-06-13 Board.prototype.serialize, first draft
2013-06-13 Board.prototype.serialize, v2
2013-06-14 Accelerometer style nits, clean up
2013-06-14 Board.prototype.serialize(filter); Allows custom filtering of serialized data properties
    board.serialize(function( prop, value, device ) {
    return "replacement value";
    });
2013-06-15 Fixes #130. Improved Multi-board support
    Boards.Array (alias: Boards)
    See: eg/board-multi.js
2013-06-15 Add sweep method to Servo.Array objects
2013-06-15 Upgrade servo-lab.js to support continuous servos
2013-06-15 v0.6.5 Improved multi-board support (initial API implementation)
2013-06-16 Progress #129, replace UNO-centric pin mapping => capabilities based pin mapping
2013-06-16 Fixes #128. Identify/indicate to user that Firmata is possibly missing from board
2013-06-18 v0.6.6 Documents multi board improvements; add contributors list
    [board-multi.fzz]
2013-06-18 Multi board docs
2013-06-18 note about board readiness
2013-06-23 Fixes #146. Crash on board.js when no type exists for translations.
2013-06-24 Rename duplicated keys in test/board.js
2013-06-24 MEGA2560 tinkerkit pin mapping support
2013-06-24 Start placing PWM enforcers. #129
2013-06-24 Remove irrelevant pin object declarations
2013-06-25 Add exponential smoother to eg and update data structure
    * Exponential smoother added to examples
    * Organize properties of accelerometer
    * Add getters and setters for data, remove 'last' object and just store
    a queue
    * bind smoother to accelerometer regardless of choice.
2013-06-25 update pitch and roll with getters
    also some ogranization for properties and getting everything inside
    80chr.
2013-06-28 remove binding for accelerometer and avoid side effects
    * default smoother now accepts an arguments object as well
    * and also does not rely on the binding of this for the inner or outer
    function.
2013-06-30 adding temperature sensor example
2013-07-03 Added Arduino Attack! to the awesome list.
2013-07-03 led.off() should clear intervals if any exist
2013-07-03 Simplify Nodebot.prototype.{ right, left }
2013-07-03 Add breadboard to temperature example
    [sensor-temperature.fzz]
2013-07-05 Led class overhaul (see commit detail)
    - `on` always turns an Led "on", whether digital or analog
    - `off` always turns an Led "off", whether digital or analog
    - `pulse`, `fade`, `strobe` can be _stopped_ (ie. the interval is terminated) with `stop`
    - `pulse`, `fade`, `strobe` can be _turned_ _off_ (ie. the interval continues, but the Led appears "off") with `off`
    - `pulse`, `fade`, `strobe` can be _turned_ _on_ (ie. the interval continues, the Led is either "on" or "off", based on the operation) with `on`
    - multiple calls to the same method do not pile up
    - unnecessary dependencies on instance methods are removed in favor of direct calls.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
2013-07-05 v0.6.14
    Led overhaul
2013-07-08 simplify pin capability mapping
2013-07-08 Gyroscope Constructor
    Similar structure to accelerometer
    Angle integration returns a single number per axis, not a stream.
2013-07-08 add documentation for gyro
    Also make johnny-five.js aware of Gyroscope constructor
2013-07-08 v0.6.16
    - Gyroscope class
2013-07-09 pvector use undefined
    pvector is normally inside the processing IIFE which puts "undef" in
    the signature and doesn't pass it in. Not the case here.
2013-07-10 switch to temporal implementation
2013-07-11 add example program and schematic to repo
2013-07-14 `this` referred to the board here from scope creep. If you ran this code before this patch, it would error out. So, quick change to ensure that we're referring to the correct thing.
2013-07-14 AdvancedFirmata based asynchronous stepper motor control implemented using functionality defined in https://github.com/jgautier/firmata/pull/25 fixed formatting, pin referencing, and scoping to remov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
    [stepper-driver.fzz, stepper-four_wire.fzz]
2013-07-14 Refactoring Stepper code
    - Allow an array of pins (in addition to object)
    - Create reasonable defaults where possible
    - Adds stepper-sweep example
    - General code refactoring
2013-07-15 Removes @device tags and replaces with arbitrary @markdown regions
2013-07-15 A4988 Stepper Motor Driver Carrier diagram
2013-07-15 RGBLed => LED.RGB; includes examples and breadboards
    [led-rainbow.fzz]
2013-07-21 Added a directional motor as controlled by an H-Bridge with PWM
2013-07-21 commit to refactor pin usage, update eg and test it
2013-07-21 moved directionalmotor to motor in all instances and updated docs
2013-07-21 Restored old motor library behaviour for backwards compatibility.
    Made modifications to the motor library so that the old style pin: x version
    will work for non-directional motors. Inclusion of a motor type now used
    internally to specify the type of motor being used.
    Reinstated the old motor demo and tested that it works with the new library and
    moved the newer demo with directions to its own demo.
2013-07-21 updated docs with new directional motor example, including schematic
    [directional-motor.fzz]
2013-07-21 Motor constructor refactoring, clean up, additional example program (motobot.js)
    [motor-directional.fzz]
2013-07-21 v0.7.0
    - Stepper Class
    - Motor/Bi-Directional DC support
    - Upgraded node-firmata
2013-07-22 Fix opposing motor direction calls
2013-07-26 Add Photoresistor Servo example - Controls a servo based on the scaled value of light from a photoresistor.
    [photoresistor-servo.fzz]
2013-07-26 Adds actual led-rainbow.js
2013-07-27 Added entry for photoresistor-servo.js to programs.json Removed reference to led-rainbow.js in programs.json since the file isn't present. Used grunt docs to generate the docs Fixed a spacing issue i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
2013-07-28 Added led-rainbow.js back, my fork was out of date.
2013-07-31 Only emit PWM error when Servo is in debug mode (ie. debug:true)
2013-08-01 Board constructor updates. Adds "type" property to Board instances
2013-08-01 Alias Led.prototype.strobe to Led.prototype.blink
2013-08-01 Disable incomplete pin instance checking APIs. Adds Pin.prototype.query to query the current state of the pin
2013-08-01 Removes redundant Sensor.prototype.pinMode and obsolete "normalized" property
2013-08-01 Make cw/ccw speeds 0-1. Remove obsolete "fireEvent" boolean arg from Servo.prototype.move
2013-08-02 Board.Pins really wants a firmata object
2013-08-02 Adds "rep" param to board constructor options. Defaults to true.
2013-08-02 Tests: Pin, Led, Sensor
2013-08-05 Automatically detect LED type (for setting mode) based on pin address
2013-08-08 Fixes bug where PWM Leds start with 0 and therefore on() sends a 0 value. Includes tests
2013-08-09 [fix] Sonar doesn't emit timesampt
2013-08-09 [fix] Correct temperature formula
2013-09-05 Led RGB test and added board option
2013-09-07 added button tests
2013-09-09 Basic button tests
2013-09-09 added switch tests
2013-09-09 LCD Fixes
    - Remove use of "g" regex
    - Parse printed strings for ":placeholders:" that match LCD.Character entries
    - Simplify string printing
2013-09-10 Simple switch and sonar tests
2013-09-11 Implement string parsing for special character support for LCD.prototype.print(…)
2013-09-11 Cleanup test/Led.js
    commit 515f53b
    Author: Francis Gulotta <wizard@roborooter.com>
    Date: Wed Sep 11 11:30:50 2013 -0400
    use spies in the test/pin.js
    commit c5ac503
    Author: Francis Gulotta <wizard@roborooter.com>
    Date: Wed Sep 11 11:04:42 2013 -0400
    Cleanup color tests to use spies instead of midi
    commit 9a9e5b9
    Author: Francis Gulotta <wizard@roborooter.com>
    Date: Wed Sep 11 00:30:57 2013 -0400
    Don't test strobe twice, useFakeTimers, spy on digitalWrite and analogWrite instead of looking at midi data.
    In most places. Still a few tests that need cleaning up. Also there's a timer still running when we stop testing so the test doesn't quit right away.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
2013-09-11 Lint and style nits
    - LCD: moves Words constructor to top of file
    - test/pin.js Make all things use double quotes
    - test/led.js Make all things use double quotes
2013-09-11 Remove references to and emitting of servo 'move' event
2013-09-13 Modify Board() to allow passing in a connected firmata, create a MockFirmata() object for testing, and update led tests to use MockFirmata().
2013-09-13 Update test/pin.js to use the MockFirmata()
2013-09-14 Add button and Capabilities to the list of MockFirmata users.
2013-09-14 Rewrite sensor.js to use fakeTimers and mockFirmata
2013-09-14 Added sonar data events
2013-09-14 sinon based event testing for sonar and switch
2013-09-15 added button event tests
2013-09-28 Fixes #236, LED on pin 0 gets set to pin 9
    Explicitly check that opts.pin is undefined
2013-09-28 Fixes #237. More comprehensive servo.sweep controls
2013-09-29 hc-sr04 ping example
    [hc-sr04.fzz]
2013-09-29 Fixes #238. Ensure the current value is at least the number 0 (it may be null or 0)
2013-09-29 Adds "analog" accessor property to Sensor
2013-09-30 IR.Distance class
    - Inherits from Sensor
    - Requires a device/model id for initialization.
2013-10-25 Updated fritzing
    Update Fritzing ping.png and ping.fzz
    [ping.fzz]
2013-10-25 Update ping.md
    Updated ping.png|fzz with HC-SR04 sensor replacing infrared sensor.
    Adding place holder. Learning how to fork, update and submit pull request.
2013-10-25 Update ping.png, ping.fzz
    Update Fritzing with a HC-SR04 ultrasonic sensor. Replacing infrared sensor.
2013-11-12 Support specified time in ms for servo moves. Now compatible with Torque programs
2013-11-14 Torque Servo class compatibility
2013-11-29 Allow digital pin numbers to address analog pins. Fixes #267
2013-11-29 servo-lab accepts a "global" range in args.
    eg.
    Setup servos for 9, 10, 11, 12. Apply a limited range of 45-135degrees
    node utils/servo-lab.js 9 10 11 12 R:45:135
2013-11-29 Drop upValue and downValue from Button
2013-11-29 Servo "inversion" support
    When dealing with multiple servos eg. wheels, legs etc. servo positions may be opposing ie. `0` on one servo is `180` on its opposing servo. To make it easier to reason about, the Servo class now accepts an optional `isInverted` property which will automatically invert servo position values before writing the value to the device.
2013-11-29 v0.7.8
    - Servo position value inversion
    - Removal of (up|down)Value from Button
2013-12-02 Sensors will emit upper/lower boundary events by specifying a limit: [lower, upper]
2013-12-02 Repl.prototype.inject copies property descriptors, instead of property values
2013-12-02 Board: minor implementation detail nits
2013-12-02 Servo: move history off the instance
2013-12-17 pin objects emit a write event
2013-12-17 Update all servo.move => servo.to
2013-12-17 Servo cleanup
2013-12-17 Update generated servo example programs
2013-12-17 Rename led `pinMode` => `mode`. Adds tests for auto mode switching
2013-12-17 Initial Servo unit tests
2013-12-21 first attempt at Sonar within method
2013-12-22 Sonar within implementation + tests
2014-01-01 Allow new device type to be passed as an object
2014-01-02 Fixes gh-282. Query on analog pins gets state from digital pins
    - Use analogPins index to determine correct analog pin address
2014-01-02 Fixes gh-267. Treat analog pins as digital output pins when provided pin is a valid numerically addressed pin
    eg. on an UNO, A0-A5 can be addressed as 14-19
2014-01-02 Fixes gh-275. Recording magnitude on 3 axis accelerometer
2014-01-03 Added within mixing to Sensor
2014-01-05 Added guard for classes that don’t support units
2014-01-07 Added constructor and tests for relay
2014-01-08 Created and generated docs/examples for relay constructor
    [relay.fzz]
2014-01-08 regenerated pin doc
2014-01-08 v0.7.12
    Relay
2014-01-20 Rewrite Gyro class
2014-01-20 Accelerometer should emit a standard data event
2014-01-20 Store the startAt for servo instances
2014-01-20 Fix gyro example
2014-01-20 Adds the I2C Ultrasonic sensor support
2014-01-20 #293 - Moves most of the specific code inside Device
2014-01-20 Consolidate I2CSonar and Sonar into a single class
2014-01-20 Adds test/gyro; moves sum to lib/fn.js
2014-01-20 Adds test/sonar.js; Update mock firmata to include i2c method names
2014-01-20 Adds test/gyro.js
2014-01-20 Adds eg/sonar-i2c.js, docs/sonar-i2c.md
2014-01-20 Update existing and add new Gyro examples
2014-01-28 Pin didn't match diagram
    So we don't lose the change made in PR #297
2014-02-01 Transiton rate option added to Servo.to() method
2014-02-02 v0.7.16
    - Fixes to servo, adds rate argument
    - Adds Taha Hesham as contributor
2014-02-15 Tweaks to process and board disconnection
2014-02-15 Devices implementation for motor.js
    Includes support for 3-pin directional, brake and current sensing pins.
    Also adds tests and additional documentation.
    [motor-3-pin.fzz, motor-brake.fzz, motor-current.fzz]
2014-02-15 v0.7.18
    - Complete motor.js refactor by @dtex
2014-02-19 Initial draft of dedicated ESC class and tests
2014-02-19 Fix esc-dualshock scaling values
2014-02-19 ESC speed values refactor. Uses 0...1 (fractional values) as percent of total speed.
2014-02-23 Update awesome.md
    Update Leap Motion + Arduino Led Control Example
2014-02-27 Update awesome.md
    added clawbot.
2014-03-06 added test for Board.Array
2014-03-06 Board.Array property unaware of initialized boards
2014-03-06 Board.Array this.length under Array.call
2014-03-06 Board.Array test ammend
2014-03-06 v0.7.20
    - Board.Array length bug, #310
    - Contributor: Alfonso de la Osa
2014-03-06 Board class refactoring
    - Move Firmata and SerialPort to conditional load
    - consistent behavior when explicit IO plugin is provided
    - base support for "guessing" platform (ie. Galileo or everything else)
    - Updated tests
2014-03-07 Move the Device logging
2014-03-10 Add fps option and throttle rate so that it does not exceed the servo resolution
2014-03-12 Constrain degrees to within the known range for a given servo
2014-03-19 Fix board initialization failure caused by user specified port names
2014-04-02 Feature: Implement Common Anode Led RGB
2014-04-02 Add breadboard diagram for Led RGB Anode
    [led-rgb-anode.fzz]
2014-04-02 [Led] Constrain value to ensure 8-bits
2014-04-21 Remove the `mock` code path in Board's constructor. Allow disabling of debug mode.
    The mock code path is not necessary with new 'isReady' io object flag. Without mock it is now desirable to allow disabling of debug mode. It still defaults to true.
2014-04-30 Accelerometer refactor
2014-05-02 Continued refactoring of Accelerometer class
2014-05-08 Track value via state side table for pin.write(val) in Pin class
2014-05-09 Support for Digital sensors
    - Sensor constructor accepts type property of "digital" or "analog", defaults to "analog"
    - Sensor constructor aliases:
    - Analog (pass-through)
    - Digital (wraps implicit type="digital" setup)
2014-05-13 Update board.js
    Applying Meteor/Arduino fix
2014-05-13 Map Digital sensor constructor alias to Sensor.Digital
2014-05-14 making some tests for stepper
2014-05-14 Initial support for the Raspberry Pi
2014-05-14 Cleaned up README wording about the Raspberry Pi
2014-05-14 Clean up raspi-io board detection
2014-05-14 v0.7.34
    - Raspi-io on-board support
2014-05-17 tests added for stepper
2014-05-21 Fix for LED status isOn()
2014-05-21 Refactor Led state.isOn fix to avoid getting stuck in an infinite interval. Closes gh-341
2014-05-21 Servo.Continuous alias class
2014-05-21 Abstract pin normalization for IO Plugins #344
2014-05-21 Rename temperature sensor example
2014-05-21 Remove initialization cruft from test/board.pins.js
2014-05-21 continuous servo eg should use cw() & ccw()
2014-05-21 Servo.prototype.move renamed to Servo.prototype.to
2014-05-22 Restore Raspberry Pi host/client capabilities. Closes gh-346
2014-05-23 Add constructor option to Relay for NC. Closes gh-349
2014-05-24 Decouple state creation and storage, allow Led constructor access to state reference
2014-05-24 Led isOn now determined solely by state.value. state.isRunning responsible for all interval based ops. Closes gh-351
2014-05-24 Callbacks on completion of led animations. Closes gh-330
2014-05-25 New example: Multiple LED fades with callbacks.
2014-05-25 Add led-fade-callback.js to programs.json
2014-05-25 Generate example markdown for led-fade-callback.js, regenerate readme
2014-05-25 Fritzing diagram for led-fade-callback example.
    [led-fade-callback.fzz]
2014-05-25 Generate example markdown for led-fade-callback.js
2014-05-25 Fix for meteor and multiple boards.
2014-05-26 Use "addr" property for Pin internals. Fixes gh-357
2014-05-28 Update Servo from last stash; adds value property
2014-05-28 Servo instance "value" property test
2014-05-31 Updated repl to not use global contex. Removed test for domain, can't get it to fail on fake board.
2014-06-01 Update led-fade.md
    fix a tiny error in a comment
2014-06-01 stepper conversions ok
2014-06-02 Basic `led` example updated with additional comments, clarification, fritzing.
2014-06-02 And we'll be wanting those Fritzing diagrams for the LED example now...
    [led.fzz]
2014-06-02 Update ESC to match Motor api
2014-06-03 A few additional comments and fritzing diagram for the `piezo` example.
    [piezo.fzz]
2014-06-03 ESC.prototype.speed(0-100%): additional fixes and tests
2014-06-03 Fritzing diagram for led-rgb example
    [led-rgb.fzz]
2014-06-03 generate led-rgb docs
2014-06-05 typo in led-fade example comments
2014-06-06 Arguments to Led.RGB not passed correctly
    Now uses apply()
2014-06-09 LED examples
    Adds intermediate LED examples, consolidates breadboard diagrams
    [led-analog.fzz, led-demo-sequence.fzz, led-digital.fzz, led-pulse.fzz, led-rainbow.fzz, led-rgb-anode.fzz, led-rgb.fzz, led-status.fzz]
2014-06-09 Missing blink alias for Led.RGB and Led.Array
    Regular Led sets blink==strobe, so we should probably be consistent on
    RGB and Array.
2014-06-10 servo example updates
    Consolidated some near duplicates, added breadboard diagrams, renamed
    several to be consistent, added a few intermediate examples.
    [continuous.fzz, sensor-slider.fzz, servo-array.fzz, servo-continuous.fzz, servo-diagnostic.fzz, servo-digital.fzz, servo-drive.fzz, servo-keypress.fzz]
2014-06-16 Edits to `sensor-temperature-tmp36` example for somewhat pedantic clarity; adding fritzing.
    Also note: docs regenerated. Should fix some currently-broken links for newer LED examples.
2014-06-16 Adding new docs files and new breadboard diagrams.
    [sensor-temperature-tmp36.fzz]
2014-06-20 corrected and simplified HC-SR04 breadboard, fzz and png
    [hc-sr04.fzz]
2014-07-01 cleaned up wiring diagram for hc-sr04
    [hc-sr04.fzz]
2014-07-03 Speed up ESC writes
2014-07-03 LedControl updates. Fixes gh-295
    - LedControl initialization
    - Adds tests for LedControl
    - row, column and led demo
2014-07-06 Enable test/ledcontrol.js
2014-07-07 v0.7.50
    - Adds license for fma, moves fma to lib/fn.js
    - LedControl
    - Fixes for 8x8 matrix device MAX7219
    - ESC
    - Speed up for writes
    - Ping
    - Minor internal tweaks
    - New diagrams/breadboards
    - Updates for jshint/jshintrc
    - Update dependencies
2014-07-07 v0.7.51
    - Pass through explicitly defined SerialPort objects to prevent crashing Board
2014-07-08 Adding invertPWM option to support basic h-bridge
    Necessary for motor controllers that do not invert PWM value on
    h-bridge when digital pin is set to high.
    Previously PR #367
    [motor-hbridge.fzz]
2014-07-08 Relay API aliases: open => off, close => on
2014-07-08 v0.7.52
    - Motor
    - invertPWM for DIY H-Bridge
    - Relay
    - Aliases: open => off, close => on
2014-07-08 Add Led.Matrix => LedControl(isMatrix: true) wrapper
2014-07-08 Copy LedControl static properties
2014-07-08 Led.Matrix: adds missing space character
2014-07-08 LedControl.prototype.char(deviceIndex, [string character | array of rowbytes]);
2014-07-08 v0.7.53
    Updates to LedControl/Led.Matrix
2014-07-09 Led.Matrix: device(index). Additional MATRIX_CHAR cleanup
2014-07-09 v0.7.54
    - Led.Matrix.prototype.device
2014-07-14 LedControl/Led.Matrix redesign; Includes tests
2014-07-14 v0.7.56
    - Redesigned LedControl API
2014-07-15 Make sure that noTone cancels the tone timer
    Note the failing test. this.clock.tick() doesn’t work for us here
    because Piezo uses nanotimer. I can’t figure out how to progress the
    clock to make the test pass.
2014-07-15 Make sure that existing timers get cleared when new tones are played
2014-07-15 Remove the race condition with clearing the timers. Because stopping the tone was based on a timeout. Two consecutive notes could cause the first timer to clear, but then the callback would clear the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
2014-07-15 v0.8.0
    - Piezo class redesign
    - Led.Matrix, LedControl class redesign
2014-07-16 Fix goofy call to start()
    This was highlighted by tableflip/nodebot-workshop#9 and
    nodeschool/discussions#298 and fixes those issues. Added new method
    resume() which resumes the motor’s last set speed instead of depending
    on start().
2014-07-22 Remove unused ESC parameters
2014-07-30 Fixes Led.Digits decimal handling
2014-08-06 Expose Gyro isCalibrated accessor property
2014-08-06 Double the number of readings for gyro calibration
2014-08-06 Allow gyro recalibrations
2014-08-07 Gyro emit data or change event when calibrated
2014-08-12 Clean up in test/board.js
2014-08-12 Enable initializing Servo instances on analog pins.
2014-08-12 Initial Led.Digits.prototype.print
2014-08-12 LedControl defaults to on
2014-09-06 More IR sensor alias entries
2014-09-17 Feature implementation and bug fixes on RBG.
    Adds isOn property for RGB that looks to see if ANY of the colors are
    on. When calling .on(), it leaves the led as-is if it’s already on.
    Adds chaining capability to .on() and .off()
    Supports saving previous color as requested in #375
    Updates toggle/strobe/stop functions to work with RGB.
    Removes functions not applicable to RBG
    (fade, fadeIn, fadeOut, pulse, brightness)
    Note, we could potentially implement these later with appropriate calculations.
2014-09-19 Adafruit Motor Shield V2 support
    In addition to Adafruit support, address these issues:
    * Tests were not checking to make sure that pins were being set in the
    right order #433
    * Fixes the unrelated start(), stop(), start() issue brought up by
    @meshy in the #433 discussion thread
    * Broke out resume, setPin and setPWM to wrapper functions for
    simplicity
2014-09-19 v0.8.10
    - Motor class upgrade: Adafruit Motor Shield V2 support
2014-09-22 Piezo.prototype.tone will no longer attempt to play a NaN tone. Fixes #413
2014-10-06 Minor cleanups in Led class
2014-10-06 Led.prototype.strobe doesn't need to change the mode to OUTPUT
2014-10-10 run motor.js through jsbeautifier
2014-10-10 Don't assign a new object to Board.Drivers[this.opts.address]
2014-10-16 Adds HT16K33 I2C Matrix support to LedControl
    * Refactored LedControl to move methods into Devices interfaces.
    * Added a new device interface to support HT16K33 matrices based on port of AdaFruit I2C LED Backpack library.
    * Added tests for the new device
    The following options have been added to the Led.Matrix constructor to support the new device:
    _isBicolor_ (default = false) If set to true the _led_ function will use the state param to set the color e.g. 0 = off, on = any value from LedControl.COLORS and the led will be set to that color. The existing behaviour of 0 = off, 1 = on still applies for monochrome matrixes
    _addresses_ optional array of I2C addresses for devices e.g. [0x70, 0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
2014-10-16 Ran ledcontrol through jsbeautifier
2014-10-16 Refactoring HT16K33 support in LedControl
    Rename devices to controllers
    Move common functions (on, off, brightness) back into LedControl.prototype and add associated tests
2014-10-16 Allow LedControl.row value param to be a string This is backwards compatible with existing API but makes it easier to use the function (don't have to convert binary string to number) and is more flex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
2014-10-16 Fix indentation in lib/ledcontrol.js
2014-10-19 v0.8.18
    - LedControl rewrite to support devie profiles.
    - Extended to support I2C devices
    - Updates to Animation
    - map => fmap, scale => fscale.
    - Breaking changes:
    - map/scale returns int
    - fmap/fscale returns float
    - JSCS tooling
2014-10-23 Remove doSend Rewrite test that uses LedControl.prototype.send directly so that it still works with send function in controllers
    lib/ledcontrol.js
    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
2014-10-28 First pass at adding support for AdaFruit Motor Shiled v1.*
2014-10-28 Supporting named motors since it is on a specific board
2014-10-28 Set Stepper pins to MODES.STEPPER. Fixes gh-467
2014-11-02 Add support for AdaFruit 16x8 HT16K33 matrix device
2014-11-03 Pin init as => mode
2014-11-04 Add dims constructor option for Led.Matrix devices Supports array, object or string e.g. dims: "16x8" dims: [16,8] dims: {columns: 16, rows: 8} Valid dimensions are 8x8, 16x8 or 8x16 Also make sure l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
2014-11-05 Simplify dims constructor option for Led Matrix
2014-11-06 Allow custom servo PWM range via SERVO_CONFIG/servoConfig
2014-11-07 a silly mistake. driver is working again
2014-11-07 added comment for Motor.start to mention optional speed argument
2014-11-07 Revert "added comment for Motor.start to mention optional speed argument"
2014-11-08 Supporting a generic ShiftRegister motor controller
2014-11-08 Adding tests for the ShiftRegister motors
2014-11-08 Support running 'just' one test suite. [4mRunning "nodeunit:just:motor" (nodeunit:just) task [24m
    [4mRunning "nodeunit:tests" (nodeunit) task [24m
    Testing motor.js...................................................... [32mOK [39m
    [32m>> [39m370 assertions passed (170ms)
    [32mDone, without errors. [39m
2014-11-08 taking the registry off the board, and into a private mapping
2014-11-08 Adding all the motors that we document
2014-11-10 Adding calibration function
2014-11-10 Let the user set the calibration data. Allows them to store a calibration and use it later
2014-11-10 adding a convienience method for calibrating until an arbitrary condition is met.
2014-11-10 added comment mentioning optional speed parameter in Motor.start
2014-11-12 expose a property telling us if the module has been calibrated
2014-11-13 Sensors should return some float values
2014-11-13 this.values returns calibrated (0-1000) values if calibration exists
2014-11-19 Fix jshint and jscs failures
    [line-follower.js]
2014-11-19 fix for issue where both accelerometer and joystick are required and cant work independantly of each other
2014-11-21 Removing contains
    String#contains → String#includes per 2014-11-19 TC39 meeting
2014-11-22 add Derek Wheelden as a contributor
2014-12-03 Add link to supported Arduino boards too
2014-12-03 Fix test failures that occur when board.js is loaded prior to es6-shim
2014-12-03 LCD, I2C: JHD1313M1 tests
2014-12-03 Fix Board.mount tests
2014-12-06 Adding GP2Y0A41SK0F to supported ir-distance devices
2014-12-07 define Stepper
    Fixes error: Cannot read property "TYPE" of undefined
2014-12-08 Allow arbitrary address for I2C LCD
2014-12-11 Make easing tests more tolerant
    We don’t have a timed test here, but sometimes Travis runs slow enough
    that even simple things take a few more ms than expected. This just
    relaxes the tolerance on the test to allow for that.
2014-12-15 Fix Compass device negotiation
2014-12-17 Add missing Board and run grunt docs
    Missing Board was causing tests to fail
2014-12-19 Button: allow button instances on analog pins with "A*" name.
2014-12-19 Button: add hold tests, remove release tests (dups)
2014-12-19 switch travis badge to better looking svg
2014-12-20 multi board ready test
    Fixes #533
2014-12-23 Adding IMU support for the MPU6050
2014-12-23 Removing board.breakouts and resolving IMU.Drivers at runtime
2014-12-23 v0.8.35
    - IMU class
    - Temperature
    - Refactored:
    - Accelerometer
    - Gyro
2014-12-23 IMU MPU6050 basic example
    [imu-mpu6050.fzz]
2014-12-23 adding examples for the Temperature, Acclerometer, and Gyro for the MPU6050
    [accelerometer-mpu6050.fzz, gyro-mpu6050.fzz, temperature-mpu6050.fzz]
2014-12-23 Github doesn't handle symlinks so I have to copy the files.
    [accelerometer-mpu6050.fzz, gyro-mpu6050.fzz, temperature-mpu6050.fzz]
2014-12-28 updating the temperature examples
2014-12-28 updating the groove example to use five.Temperature
2014-12-28 Adding the Groove device as a Temperature controller option
2014-12-30 Adding support for ADXL335 accelerometer
    [accelerometer-adxl335.fzz]
2014-12-30 Board.Device => Board.Component
2014-12-30 Add tests for existing Board.Component behavior
2014-12-30 Board.Component warns on attempted pin re-use
2014-12-30 Accelerometer: ADXL345, support, test, example, breadboard, etc.
    commit 5a23788d92b3d4114b55173cc6fc39cd80ac1552
    Author: Rick Waldron <waldron.rick@gmail.com>
    Date: Tue Dec 30 12:29:10 2014 -0500
    Fix broken test
    commit 46c6f984cad1723ecb3dad2f35922b8faadafba4
    Author: Rick Waldron <waldron.rick@gmail.com>
    Date: Tue Dec 30 12:27:24 2014 -0500
    Cleanup breadboard circuit diagrams
    commit 2f16b90f2cf0a0caac87b7c2fbdd50e0e730fed6
    Author: Rick Waldron <waldron.rick@gmail.com>
    Date: Tue Dec 30 12:25:08 2014 -0500
    Use read register 0x32
    commit d4cfa969fa68aa7e982e36ccdabfdcb2908f3764
    Author: Rick Waldron <waldron.rick@gmail.com>
    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
    [accelerometer-adxl345.fzz]
2014-12-30 proxying change events through the IMU
2014-12-31 Update ADXL345 diagrams
    [accelerometer-adxl345.fzz]
2015-01-02 Convert Compass/Magnetometer to Controller pattern
2015-01-15 Update Stepper capability detection. Fixes gh-394
2015-01-15 Simplify Stepper test pins
2015-01-15 Pin: Multi-pin control (Pin.Array === Pins). Fixes gh-546
2015-01-15 ESC, Led, Servo: Update collection implementations; add tests.
2015-01-15 Fix Servo.to(degrees, time, rate) so that if you enter in the same value for degree it returns this
    Return this is the distance between the current and the last .to() command is zero
    Value = null instead of 0
2015-01-16 Test for calling emit "move:complete" in the case where you call the same degree value twice
2015-01-19 Update LED docs based upon feedback from the latest Nodebots NYC.
    - Remove LED-Digital docs as they are too similar to other docs
    [led-digital.fzz]
2015-01-23 LedControl: Compare character length to both rows and columns
2015-01-23 Move debounce function to constructor
    Prevents “cross-debouncing” of events across button instances
2015-01-23 Update grove-servo and relay examples
2015-01-23 Example: relay lamp controller
2015-01-23 Remove component image from relay example
2015-01-23 Add link to http://bocoup.com/weblog/javascript-relay-with-johnny-five/
2015-01-23 Example: Robotic Claw updates
2015-01-23 Examples: Pin updates
2015-01-23 Examples: broad cleanups
    [led-anode.fzz, led-array.fzz, led-digits-clock.fzz, led-matrix-HT16K33-16x8.fzz, led-matrix-HT16K33.fzz, led-matrix-tutorial.fzz, led-matrix.fzz, led-rainbow.fzz]
2015-01-23 Examples: update led digits clock
2015-01-23 Examples: led status, clock
2015-01-24 Examples: cleanups, new diagrams, etc.
    [accelerometer-adxl335.fzz, accelerometer-lis344al.fzz, ball-switch.fzz, esc-keypress.fzz, servo-PCA9685.fzz, servo-drive.fzz, servo-slider.fzz, servo.fzz]
2015-01-26 Occupied pins must account for controller and address variants: multiple pin support
2015-01-26 Led: Support PCA9685 controller
    [led-rgb-PCA9685.fzz]
2015-01-26 Remove erroneous Board.Device call in Led.RGB constructor
2015-01-26 Accelerometer: MMA7361 controller support
    [accelerometer-mma7361.fzz]
2015-01-29 extracted string-to-song functionality into Piezo.prototype.stringToSong
2015-01-29 added test to Piezo.prototype.stringToSong
2015-02-02 Compass Docs breadboard diagram. Closes gh-599
    [compass-hmc5883l.fzz, compass-hmc6352.fzz]
2015-02-02 Gyro Docs breadboard diagram. Closes gh-600
    [gyro-lpr5150l.fzz]
2015-02-03 Sonar, Motor, ESC: examples updates
    [sonar-srf10.fzz, sonar.fzz]
2015-02-03 More example updates
    [sonar-srf10.fzz]
2015-02-03 IR.Motion, IR.Proximity
    [ir-motion.fzz, ir-proximity.fzz]
2015-02-03 Joystick: updated examples and images
    [joystick.fzz]
2015-02-03 Temperature: examples and breadboards
    [temperature-ds18b20.fzz, temperature-lm35.fzz, temperature-tmp36.fzz]
2015-02-03 Temperature: breadboards
2015-02-03 Ping: examples and breadboards
    [ping.fzz]
2015-02-03 Relay: examples and breadboards
    [relay.fzz]
2015-02-04 Stepper: examples, breadboards. "Readme: Make: JavaScript Robotics"
    [ping.fzz, stepper-easy-driver.fzz]
2015-02-04 Switch: fix test, apply debounce patch
2015-02-04 Fix stepper program
2015-02-08 Led: restore pinMode call inside initialize
2015-02-08 Led: PCA9685 example and breadboard
    [led-PCA9685.fzz]
2015-02-11 Simplify board init example. Fixes gh-618
2015-02-11 Board: add missing pass-throughs "i2cConfig", "i2cWrite", "i2cWriteReg", "i2cRead", "i2cReadOnce",
2015-02-11 Board: board.MODES => board.io.MODES
2015-02-12 Board: fix port assignment location. fix passthrough method arguments
2015-02-12 Attiny Slave diagrams
    [attiny-slave.fzz]
2015-02-12 Attiny Programmer
    [attiny-programmer.fzz]
2015-02-13 Temperature: Grove sensor math corrections.
    - http://www.seeedstudio.com/wiki/Grove_-_Temperature_Sensor
2015-02-13 Examples: updates to sensor and stepper
2015-02-22 Migrating the Tinkerkit Thermistor to be included in Temperature component
2015-02-24 extract jscs config into .jscsrc; resolves #632
    - removed JSCS config from `Gruntfile.js`; config now lives in `.jscsrc`
    - added `util/` to paths covered by JSCS
    - fixed JSCS errors in `util/xbee.js`
    - a couple formatting problems
    - you can't `return` a `process.exit()` call
    - fixed what appeared to be a logic error when no port name specified; would exit too early
    - the above three issues were reported by JSCS
2015-02-26 Accelerometer: MMA7361 diagram fixups
    [accelerometer-mma7361.fzz]
2015-02-26 Examples: cleanups and removals
    [sensor-slider.fzz, servo-slider.fzz, slider-pan.fzz]
2015-03-01 Add isAnode to LED state. Fixes gh-629
2015-03-01 Revert Led.RGB anode color test
2015-03-01 Use blink for LED anode example
2015-03-02 Examples: LED anode
2015-03-02 Examples: Led.RGB anode and standard
    [led-rgb-anode.fzz, led-rgb.fzz]
2015-03-02 Examples: LED, various
    [led-anode.fzz, led-resistor.fzz, led-rgb-PCA9685.fzz, led.fzz]
2015-03-02 Examples: Button
    [button.fzz]
2015-03-02 Examples: Button & Grove LCD
    [grove-lcd-rgb-temperature-display.fzz, grove-lcd-rgb.fzz]
2015-03-02 Diagram: relay, normally open
    [relay-breadboard-closed.fzz, relay-breadboard-open.fzz]
2015-03-03 LCD: PCF8574A, PCF8574AT => 0x3F; PCF8574, PCF8574T => 0x27
    Fix LCD default I2C slave addresses
2015-03-08 Board: Allow port object to specify what kind of transport it is in the repl output.
2015-03-09 Button: Fix breadboard diagram, update example code. Fixes gh-645
    [button.fzz]
2015-03-13 add feature to send to daisy-chained shift registers
    - `ShiftRegister.prototype.send` now accepts *n* parameters.
    - Each parameter is shifted out in series.
    - If multiple parameters are given, the `value` of the `ShiftRegister` is an array.
    - added test
    - added example
    [shift-register-daisy-chain.fzz]
2015-03-13 Titles/Programs: Remove board with serial example (temporary)
2015-03-16 Examples: grove touch, led
    - Update grove touch image
    - Simplify Led
2015-03-16 Examples: led notes
2015-03-16 Examples: led (array, blink, fade)
2015-03-18 Board: update grey strings to chalk.grey(string)
2015-03-18 remove LED anode examples
    isAnode should only be used for RGB LEDs, so removing these example
    programs.
    [led-anode.fzz]
2015-03-19 Board: add link to wiki/Getting-Started#trouble-shooting. gh-655
2015-03-20 Update LED Pulse example
2015-03-20 Revert "Update LED Pulse example"
2015-03-20 Use correct Fritzing diagram to generate png
    This doesn’t have the curvy wires, but the pins are right
2015-03-25 use environment to declare test mode flag; resolves #669
    - Relevant files check `process.env.IS_TEST_MODE` instead of a global prop
    - The value of `IS_TEST_MODE` is assumed to be a boolean
    - Individual suites do not set `IS_TEST_MODE`
    - `bootstrap.js` is no longer necessary and has been removed
    - `Gruntfile.js` sets the `IS_TEST_MODE` flag; as long as you run the tests via `npm test` or `grunt`, your environment will be correct. Otherwise, you must manually set the `IS_TEST_MODE` environment variable.
    - simplified test targets within `Gruntfile.js` with globs
    - remove `bootstrap.js` reference within `nodeunit:just`; while I was in there, corrected a potential Windows incompatibility, made s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
2015-03-25 ESC: Update to controller model. Adds PCA9685. Closes gh-647
    [esc-PCA9685.fzz]
2015-03-26 ESC: Bidirectional speed controller (Forward/Reverse) support. Fixes gh-530
    [esc-bidirectional-forward-reverse.fzz, esc-bidirectional.fzz]
2015-03-27 ESC: multi-Device support. Fixes gh-530
2015-04-01 additional Led.RGB.color signatures
    Fixes #681
2015-04-01 add Led.RGB.color returns this test
2015-04-01 param validation for Led.RGB.color
2015-04-01 test bad values for Led.RGB.color
2015-04-03 Refactored analog sensors, updated tests
2015-04-03 Fixes to servo
    Addresses #666
    1) Range was being constrained after offset was applied which was
    wrong. User should not have to think in two different coordinate spaces.
    2) Invert was based on global coordinate range which led to incorrect
    values being passed to the servo. Invert has to be based on the
    physical range of the servo in local coordinate space. We need to
    maintain to ranges, the global coordinate range for ease of use and the
    physical device range of the servo. We are assuming 180° servos for
    now. We will have to add in 45° and 270° servos as Devices.
    3) Added tests
2015-04-04 Support auto-calibration for reflectance array
2015-04-04 All sensors should be controllers, not devices
2015-04-05 Getting DS18B20 to work with multiple sensors at the same time
2015-04-05 example cleanup
    General example cleanup that includes:
    * consolidating (nearly) identical examples
    * consistent naming
    * consistent example ordering (simple->complex) in programs.json
    * sort titles.json to match programs.json
    * added missing titles to titles.json
    * consistent curvy wires on breadboard diagrams (except complex
    diagrams)
    * consolidated functionally equivalent breadboards
    * regenerated all example docs
    [attiny-programmer.fzz, attiny-slave.fzz, button-bumper.fzz, button-options.fzz, button-pullup.fzz, directional-motor.fzz, esc-dualshock.fzz, hc-sr04.fzz]
2015-04-05 servo-slider example consolidation
2015-04-06 simpler led breadboards, add back board-with-port
    [board-with-port.fzz, led-11-pwm.fzz, led-13.fzz, led-blink.fzz, led-demo-sequence.fzz, led-fade.fzz, led-pulse.fzz, led-rainbow.fzz]
2015-04-06 Motor: add POLOLU_DRV8835_SHIELD config
    https://www.pololu.com/product/2511
2015-04-06 use Array.prototype.includes instead of _.contains
2015-04-06 Board.Component: Allow a component to opt out of requesite pin occupancy
2015-04-06 Board.Component: Fix pin occupancy to account for normalization.
2015-04-06 Allow specifying multiple breadboards for docs
    Can add entries to breadboards.json if you want multiple breadboards
    for an example or to use an existing one with a different name.
    (Defaults to example name as before)
    [board.fzz, led-resistor.fzz, led.fzz]
2015-04-07 included latest Led.RGB.color validation
2015-04-07 breakout LED-related code into led/ folder; closes #668
    - Moved all the things
    - killed sharing of private state and associated functionality between `Led`, `Led.Array` and `Led.RGB` (and tests)
2015-04-07 eg/led.js: additional breadboard diagrams
    [led-13-edison-arduinoboard.fzz, led-13-galileo.fzz, led-13-mega.fzz]
2015-04-07 Breadboard: re-export "led-13-galileo" without selection lines
    [led-13-galileo.fzz]
2015-04-08 Combines eg json files
    [board-with-port.fzz, board.fzz, joystick-adafruit.fzz, joystick-pantilt.fzz, joystick-sparkfun.fzz, joystick.fzz, led-blink.fzz, led-demo-sequence.fzz]
2015-04-08 Servo: call sweep in basic examples. simplify servo-sweep example.
2015-04-08 Examples: grove sensor, images, etc.
2015-04-08 Add examples for io-plugins
    Needs additions for other io-plugins
    [spark-led.fzz]
2015-04-08 move grove-led image to grove-led.js eg
2015-04-08 IO Plugins: edison, galileo, pcduino
    [led-1-edison-miniboard.fzz]
2015-04-08 remove unused joystick-laser.md
    now joystick-pantilt.md
2015-04-08 add imp breadboard
    [imp-led.fzz]
2015-04-08 grove-led.jpg back to grove-sensor
    It's used in the example, so I should have left it in.
2015-04-09 Adding example files, breadboards images and Fritzing files
    [proximity-sonar-srf10.fzz, proximity-sonar.fzz, proximity.fzz]
2015-04-09 Added raspberry pi docs
    [led-13-raspberry-pi.fzz]
2015-04-09 Add MB1003 example, clean up Proximity docs
    [proximity-mb1003.fzz, proximity-srf10.fzz]
2015-04-09 Removing renamed proximity-sonar example
2015-04-09 Examples: embeds, externals, name overrides file
    - Adds example that demonstrates new features
    [led-digits-clock-arduino.fzz, led-digits-clock-galileo.fzz]
2015-04-10 copy Led.RGB API changes to Led refactor
2015-04-10 test pin assignment for constructors in Led.RGB
2015-04-10 Led: Clear interval after animation
2015-04-10 Led: Add a callback for .blink()
    Ref #716
2015-04-11 Led: Add basic tests for animation
2015-04-15 Led: Make duration and complete optional in .animate()
2015-04-15 Led: Remove TODO about default step for .animate()
2015-04-15 Led: Remove explicit default duration for .pulse() and .fade()
2015-04-15 dup code from led refactor removed
    apparently it was added back in somewhere in a merge/rebase step.
2015-04-15 fix RGB.prototype.stop()
    Also adds tests for stop/toggle
2015-04-16 Examples: Updated HC-SR04
    [hc-sr04.fzz]
2015-04-16 Port HC-SR04 sensor, incomplete tests
2015-04-19 typo fix in Board.Component doc comments
2015-04-20 Examples: more intuitive Servos collection example
2015-04-20 Test: Use Board-io to implement MockFirmata. Closes gh-735
2015-04-23 stepper max per board; err if no dir; tests
2015-04-23 Restore unused variables in the board module
    These are part of the temporarily disabled code for supporting
    execution-on-board environments properly.
2015-04-23 Fix HC-SR04 toCm issue, add docs
    [proximity-hcsr04.fzz]
2015-04-23 Stepper: fix jshint nits
2015-04-24 Led: Cleanup
2015-04-24 Breadboard: ESC PCA9685-b
    [esc-PCA9685-b.fzz]
2015-04-24 Don't short circuit read handlers for digital sensor. Related to gh-750
2015-04-24 Fix disparate analog and digital read reporting for Pin class. Related to gh-750
2015-04-25 Ensure that Pin.read, pin.read and pin.on("data", ...) have matching behavior. Related to gh-750
2015-04-25 Add Pin class unit tests
2015-04-26 Throw exception when attempting to create Pin without pin number
2015-04-27 Board: update missed properties to chalk.foo calls.
2015-04-28 Minor cleanup for Board.Options
2015-04-28 Cleanup for Board.Pins
2015-04-28 Button: value property. Closes gh-754
2015-04-29 Relay: add value property. Related to gh-754
2015-04-29 Use Animation() class for Led.fade() and Led.pulse()
    * Changed some property names in animation to be more generic
    ```degrees``` became ```value```
    * Created @@normalize and @@render methods for Led
    * Removed LED’s custom animation feature
    * Added the ability to pass in an opts object to pulse or fade (same
    opts as Animation.enqueue)
    * Tweaked servo.[“@@normalize”] to use new generic value instead of
    degrees
    * Updated animation tests to use new generic name
    * Move time based Led test to extended/led.js
    * Removed redundant pulse() and fade() test from PCA-9685 group
2015-04-30 Motor, Servo: Update I2C API
2015-04-30 Examples: Remove erroneous parameters and logging from Motor examples
2015-04-30 Proximity: LIDAR-Lite support.
    [proximity-lidarlite.fzz]
2015-04-30 Breadboards: fix LIDAR-Lite 5V line color
    [proximity-lidarlite.fzz]
2015-05-01 Update I2C API
2015-05-01 Remove an unused spy in the motor tests
2015-05-01 Proximity: GP2Y0A710K0F
    [proximity-GP2Y0A710K0F.fzz]
2015-05-02 Proximity: additional confirmed Ultrasonic pulse components
2015-05-03 Board: comment cleanup
2015-05-03 Board: typeof foo === "undefined" is sufficient.
2015-05-03 Update stepper-four_wire.js
    Tiny change to make it actually go clockwise. Totally missed this for about 10 mins.
2015-05-04 Board: Document that serialport.list() never errors. Fixes #768
2015-05-04 Led.Matrix: Adds built-in characters for 00-99
2015-05-04 Led.Matrix: Reuse the "left" digits, by shifting each row's bits 4 bits to right
2015-05-04 Board: Don't overwrite "transport" property.
2015-05-04 Breadboards: Fix LED PCA9685 connection. Fixes #772
    [led-PCA9685.fzz]
2015-05-05 Keypad class
    - MPR121 cap touch Keypad
    - Vkey Voltage Keypad
    - Analog 4x4 Keypad
2015-05-05 Tests: Accelerometer, calledWith => args[explicit]
2015-05-05 stepper tests getCall/args consistency
2015-05-05 Tests: Motor, calledWith => args[explicit], or firstCall.calledWith
2015-05-05 fix RGB-PCA9685 lead mismatch in fzz
    [led-rgb-PCA9685.fzz]
2015-05-05 Led: Test cleanup
2015-05-06 Led: Fix initialization of successive pins on PCA9685.
    Ref #762
2015-05-07 Examples: Add common anode RGB with PCA9685 controller
    [led-rgb-anode-PCA9685.fzz]
2015-05-07 Breadboards: Fix common lead for common anode RGB with PCA9685
    [led-rgb-anode-PCA9685.fzz]
2015-05-07 Led.Matrix: Improve addressing and initialization; adds tests.
2015-05-07 Examples: add LED RGB Anode PCA9685 to generated examples
2015-05-08 Switch: new examples
    [switch-spdt.fzz, switch-spst-rocker.fzz]
2015-05-09 Added motion class with PIR controller
    [motion.fzz]
2015-05-10 Add GP2Y0D805Z0F plus tests and examples
    [motion-gp2y0d805z0f.fzz]
2015-05-12 Servo: Fixes tests that would break due to reliance on a polluted environment.
2015-05-12 Led: consolidate Object.defineProperties(this, ..) mode def.
2015-05-12 Servo: fix non-firmata non-normalization test
2015-05-13 Motion/Proximity: updates to aliases, examples, breadboards
    [motion-gp2y0d805z0f.fzz]
2015-05-18 Joystick: Controller refactor, Esplora support.
    - Includes Sparkfun Joystick Shield example
    [esplora.fzz]
2015-05-18 Accelerometer: Whitespace cleanup
2015-05-18 Accelerometer: Remove duplicate definition for ADXL335 controller
2015-05-18 Accelerometer: Add support for Esplora
2015-05-21 Motion: Support for GP2Y0D810Z0F & GP2Y0D815Z0F
    [GP2Y0D810Z0F.fzz, PCF8574.fzz]
2015-05-22 Expander: MCP23017, MCP23008, PCF8574, PCF8574A, PCF8575, PCA9685
    - Can create standalone Expander instances
    - Use as virtual boards
    [expander-MCP23008.fzz, expander-MCP23017.fzz, expander-PCA9685.fzz, expander-PCF8574.fzz, expander-PCF8575.fzz]
2015-05-23 Sensor: Add microphone example
    [microphone.fzz]
2015-05-24 Led.RGB: Refactor to device/controller model
    Ref #742
2015-05-25 Led, Led.RGB: Move interval to private state
2015-05-26 Led.RGB: Make write() writable to clean up tests
    Add tests for PCA9685
2015-05-26 Led.RGB: Add BlinkM support
    Fixes #742
2015-05-26 Led: DRY out the shape tests
2015-05-26 Led.RGB Tests: Add assertions for non-PWM pins
2015-05-27 Led.RGB: Add Esplora support
2015-05-27 Led.RGB: Move internal value writing out of controllers
2015-05-27 Led: Remove type option
2015-05-27 Led.RGB: Minor cleanup
    Use `this.io` instead of `this.board.io`
    Rename `writeColor()` to `update()`
2015-06-01 Boards: restore "lost" ready event for multi-board cases. Fixed gh-810
    This may also correct an issue that I think @brianshaler was trying to explain to me at JSConf, but that needs to be confirmed.
2015-06-01 Expander/Virtual updates
    Expander:
    - Support direct controller string argument
    Virtual:
    - Support direct expander instance argument
    Examples:
    - Basic examples for all expanders
    [expander-MCP23008-basic.fzz, expander-MCP23017-basic.fzz, expander-PCF8574-basic.fzz, expander-PCF8575-basic.fzz, expander-PCF8575-led-button.fzz]
2015-06-01 Button: refactor to controller design.
2015-06-02 Led.RGB: Handle special value for fully off common anode LEDs
    Fixes #782
2015-06-02 Expander: switch examples to simplified API
2015-06-02 Expander: PCF8591
    [expander-PCF8591.fzz]
2015-06-03 Examples: fix typo in motor doc
2015-06-06 Led: Fix indentation
2015-06-09 Examples: kinect update; regenerate
    [kinect-arm-controller.fzz]
2015-06-10 Led.RGB: Add intensity method
    Fixes #737
2015-06-12 Barometer/Temperature/Multi: New class; MPL115A2 & BMP180 support
    [multi-bmp180.fzz, multi-mpl115a2.fzz]
2015-06-12 BMP180 diagram updates
    [multi-bmp180.fzz]
2015-06-13 Fixing broken links and images
    * Fixing broken link to the MPU-6050
    * fixed broken images for grove temperature and rotary
    * updated examples
2015-06-15 Led.RGB: Use constrain() utility method
2015-06-16 Expander: PCF8591 diagram correction
    [expander-PCF8591.fzz]
2015-06-17 Switch: add isOpen property
2015-06-18 Interval is no longer a property on LED's
    Was causing extended tests to fail.
2015-06-18 Button: limit dataHandler call to changes.
2015-06-18 Button: no false positive changes on initialization.
2015-06-18 Expander: skip pin normalization calls.
2015-06-18 Board.Component: update default componentOpts
2015-06-18 Expander: PCF8574 ensure that pin state byte is tracked
2015-06-18 Cleanup tests, purge boards. Fixes gh-827
2015-06-21 Update motor-hbridge wiring
    [motor-hbridge.fzz]
2015-06-23 Sensor: simplify basic example
2015-06-28 Fix mode descriptions in pin tests and add constant name verification
2015-06-30 Expand test cases for the sensor class, and fix median value handling
    Restructure analog sensor shape test to check that all and only expected properties and methods exist
    Verify that expected default property values are set
    Check that data events are emitted at the expected time tick
    Check that median processing give the expected results and emitted events
2015-07-03 Keypad: examples
    [keypad-MPR121QR2.fzz]
2015-07-03 wrong diagram/desc for RGB rainbow example
    Also made description in led-rgb consistent with other examples
2015-07-03 change rgb-anode eg to use same pins as rgb cathode
    [led-rgb-anode.fzz]
2015-07-04 changed servo reference to led
    cut-n-paste error in Animation.render function
2015-07-04 Pin: Remove console.log
2015-07-07 Update list of contributors—thanks to all these rad folks <3
2015-07-07 Board: emit logging as events.
    - log
    - info
    - warn
    - error
    - fail
2015-07-07 Board: emit logging as events, pt. 2 clean up and tests
2015-07-08 LED: Add draw examples for 8x8 Matrix, add LED characters file.
2015-07-08 Test Issues
    Explicit test is timing out so I’ve commented it out for now. Addresses
2015-07-15 Update tests to use fresh board instances
2015-07-16 Add missing calls to Board.purge()
2015-07-16 Tests: Make board instances the value of a property of the current test
2015-07-16 Controllers: update all controllers to forward opts param as argument to i2cConfig
    This is needed by platforms that have > 1 active I2C bus
2015-07-19 Implement changing freq (interval) property after instance creation
    lib/sensor.js
    Move median calculation function definition outside of the constructor function
    Move latest median value storage to closure scope, to provide history between calls
    Add read only, test mode only, state property to expose internal instance state information
    Use a local (constructor function scope) variable to access the private state properties
    Replace (in constructor) references to the private state information with the local variable
    test/sensor.js
    Add test cases for freq, threshold, id, limit properties
    Extend expected instance shape information
    Expand testing for analog noise filtering
    Expand testing for dat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
2015-07-19 Tests: Plug board instance leak
2015-07-21 Fix path to servo-lab in comments
2015-07-23 Boards: ensure logging methods are correctly defined. Fixes gh-875
2015-07-24 Button hold, continually trigger action. Fixes gh-873
2015-07-30 Added LM335 temperature controller and sundries
    [temperature-lm335.fzz]
2015-08-03 Examples: generate led chars md
2015-08-03 Temperature: Update LM335 component
    [temperature-lm335.fzz]
2015-08-08 Clean up temperature examples
2015-08-08 Missed file from temperature example updates
2015-08-08 Button: don't coerce pin to number unless safe to do so. Closes https://github.com/rwaldron/spark-io/issues/63
2015-08-14 Temperature: SI7020
    [temperature-SI7020-uno.fzz, temperature-SI7020.fzz]
2015-08-19 Update si7020 fzz
    [temperature-SI7020.fzz]
2015-08-23 Temperature: Add C, K, F values to the data event and temperature objects
2015-08-25 Motor: LUDUS Shield
2015-08-26 Temperature: add analog reference to TMP36 controller
2015-09-05 EV3: Button
2015-09-05 EV3: Motor
2015-09-05 EV3: NXT Button; Update Proximity:EV3 => EV3_IR
2015-09-05 EV3: NXT Motors, EV3 Ultrasonic
2015-09-05 Light: TSL2561
    [light-TSL2561.fzz, light-ambient-TSL2561.fzz]
2015-09-07 Accelerometer: MMA7660 support
2015-09-21 Adding support for Sparkfun TMP102 Temperature Sensor
    [temperature-tmp102.fzz]
2015-09-22 Support Led.Digits with HT16K33 controller
    - Moves print() and digits() to parent controller for reuse.
    - Adds separate sendDigit() function for controller-specific concerns.
    - Adds ":" support for ##:## displays.
    - Column order is *not* reversed on HT16K33 controller. Add per-controller override.
    - Segment order is reversed, so bits in led-chars.js are reordered for HT16K33.
    - Adds tests for HT16K33 with segmented displays.
2015-09-23 Allow digital sensor constructor to take string pin names
2015-09-28 Temperature: use newer tmp102 layout
    [temperature-tmp102.fzz]
2015-09-30 Boards: implement byId method for Boards collection instances.
2015-09-30 LedControl: If message is not a string, do coercion
2015-09-30 4 digit 7 segmant examples
    [led-digits-clock-HT16K33.fzz]
2015-09-30 Led.Digits: additional test, example using HT16K33
2015-09-30 Led.Digits: Dual clock display example
    [led-digits-clock-dual.fzz]
2015-10-05 Adding initial support for MPL3115A2 barometer/temperature. Altimiter to come
2015-10-05 Removed unused variable
    Removed unused variable sensor
2015-10-05 Pin: add isHigh, isLow properties
2015-10-05 Sensor: support enable(), disable()
2015-10-05 Examples: Photon Weather Shield, moisture sensor
2015-10-06 adding wiring example
    [barometer-mpl3115a2.fzz]
2015-10-06 Adding support for the htu21d hygrometer and temperature
2015-10-06 Adding wiring diagram
    [humidity-htu21d.fzz]
2015-10-08 Update mpl3115a2 diagrams
    [barometer-mpl3115a2.fzz]
2015-10-12 MPL3115A2: Calibration, requires a base altitude.
    To get base elevation, use: http://www.whatismyelevation.com/
2015-10-13 Multi: make altitude calibration contingent on user specifying opts.elevation
2015-10-14 Board.Controller: manage component controller decorator & required parameters
2015-10-14 Migrate component classes to Board.Controller
2015-10-14 Board.Controller: fix warn messages
2015-10-16 IMU/Altimeter: Finesse elevations that are below sea level. It's magic.
2015-10-19 Deps: work in progress, temp switch to firmata.js repo
2015-10-21 Controllers can use Expanders. Migrate Servo and ESC
2015-10-21 Switch to use expander for PCA9685 in motor
    Also there was a bug in the old code and the brake test for PCA9685 was
    flat out wrong.
2015-10-21 Fixes Servo tests by purging Expanders after Motor tests
2015-10-21 Switch to use expander for PCA9685 in LED
2015-10-22 Switch to use expander class for PCA9685 in LED/RGB
2015-10-22 Expander: Add MUXSHIELD2. Fixes gh-927
    [expander-MUXSHIELD2-analog-read.fzz, expander-MUXSHIELD2-mixed.fzz]
2015-10-23 Fix default pwmRange for PCA9685
    These new values were tested with an eMax and a Hitec. Our new
    Servo.sweep() with easing really made it clear that we were hitting the
    top of the range too early and through experimentation I found we were
    missing some of the low end range.
2015-10-23 Add support for Tessel Servo module
    Shorten path to io.name
2015-10-29 Fix default pwmRange for PCA9685
    Revert "Add to .tesselignore"
    This reverts commit 9f0bd313619e02702085b16a619709302d43dc01.
    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
2015-10-29 Normalize pin values on components that use expanders
    Re: [this
    comment](https://github.com/rwaldron/johnny-five/pull/943#issuecomment-1
    52048671)
    We need something like this. It is incomplete (it doesn’t handle pin
    arrays). Thoughts?
2015-10-29 Led.RGB: Fix PCA9685 pin normalization
2015-11-05 Led/Led.RGB: update tests and fix BlinkM controller options
2015-11-05 Led/Led.RGB: safely clear intervals; tests.
2015-11-05 Led: test for correct returns (fade was incorrect, this will test all)
2015-11-09 LedControl: Fix missing opts.address reassignment
2015-11-10 HCSR04 I2C backpack code and examples, and docs
    [proximity-hcsr04-i2c.fzz]
2015-11-10 Tessel diagrams
    [temperature-HTU21D.fzz]
2015-11-10 HTU21D diagrams
    [temperature-HTU21D-F.fzz, temperature-HTU21D.fzz]
2015-11-10 Temperature: re-do SI7020 diagram
    [temperature-SI7020.fzz]
2015-11-10 Thermometer: Migrating Temperature to Thermometer
    Temperature class still works as expected.
2015-11-10 Multi: temperature => thermometer, per @briangenisio review
2015-11-10 Sensor: Default to 50% of scaled values for boolean barrier
    Fixes #955
2015-11-11 tests included for the new proximity HCSR04-I2C backpack
2015-11-12 Doc fixes for hcsr04 I2C backpack
2015-11-15 Increase PWM frequency for PCA9685
    This will reduce visible PWM flashing with the PCA9685. Mostly noticeable when recording video but also visible with the eye under certain circumstances.
2015-11-18 Ensure that continuous servos respect deadband when calling stop().
2015-11-19 Proximity: Update examples to use similar format as other sensor examples
2015-11-30 Suggested bug fix for issue #972 - SI7020 Thermometer: Wrong Temperature Calculation
2015-11-30 Suggested bug fix for issue #972 - HTU21 Thermometer: Wrong Temperature Calculation
    Changed calculation for HTU21, too. Same error. See page page 15 at https://www.adafruit.com/datasheets/1899_HTU21D.pdf
2015-12-01 Thermometer: MCP9808
    [temperature-MCP9808-tessel.fzz, temperature-MCP9808.fzz]
2015-12-03 Stop continuous rotation servo on instantiation
    I can think of no reason why we would not want this to happen. Servo
    state is a crap shoot otherwise.
2015-12-10 ran test for sensor-fsr
2015-12-15 Motor: adds SPARKFUN_EDISON_DUAL_HBRIDGE config
2015-12-15 Motor: rename SPARKFUN_DUAL_HBRIDGE_INTEL_BLOCK => SPARKFUN_DUAL_HBRIDGE_EDISON_BLOCK
2015-12-15 ESC, Led, Motor, Servo: allow user defined PWM frequency for PCA9685
    See gh-965
2015-12-15 Board.Pins: allow IO Plugin or Expander to override the default "isType" methods
2015-12-16 Add Servo.home()
    Returns the servo to its startAt position
2015-12-16 Add two servo fuzz and png
    [servos.fzz]
2015-12-16 Add two controllers servos and missing ground wire from servos
    [servos-two-controllers.fzz, servos.fzz]
2015-12-16 Add Leds 2 controllers diagram
    [led-array-2-controllers.fzz]
2015-12-17 Artwork for ESCs wiki page
    Also added an ESCs example
    [esc-array.fzz, escs-2-controllers.fzz]
2015-12-17 Motor: Grove I2C Driver support. Closes gh-987
2015-12-17 Examples: fixes bad image markup for Motor GROVE I2C programs
2015-12-19 IMU/Hygrometer: Correction to SI7020 data read length. Ref gh-981
2015-12-19 IMU/Thermometer: read from Si7020's cached temperature register. Ref gh-981
2015-12-19 Board: Adds samplingInterval example. Ref gh-981
    [so-many-boards.fzz]
2016-01-07 adafruit_MPL3115A2
    Fixed connection error Arduino UNO ---- Adafruit-MPL3115A2.
    [barometer-mpl3115a2.fzz]
2016-01-09 Board.Options: use Object.assign instead of _.assign
2016-01-10 LED controller documentation
2016-01-12 Fix blinking for the HT16K33 LED controller.
2016-01-12 Board: Add some leonardo specific guidance for connection timeouts
2016-01-12 Examples: wiring corrections for HTU21D. Fixes gh-1007
    [humidity-htu21d.fzz, temperature-HTU21D.fzz]
2016-01-13 Suggested fix for #1009. Corrected sketches for expander MCP23017. Added note to README about address pins with link to data sheet.
    [expander-MCP23017-basic.fzz, expander-MCP23017.fzz]
2016-01-13 Contributors: Adds @nloding and @ericandrewlewis—thanks!!
2016-01-15 make sure all the devices are ready for conversion before reading values
2016-01-17 adding documentation for the MAX31850 OneWire thermometer sensor
    [temperature-max31850k.fzz]
2016-01-25 IMU: BNO055 rough draft
2016-01-26 Proximity: allow analog pins to be used with HCSR04 controller. Fixes gh-1020
    [proximity-hcsr04-analog.fzz]
2016-01-27 Examples: led array controller for sfe
    [led-array-controller.fzz]
2016-01-27 Expander: add 74HC595
    [expander-74HC595.fzz]
2016-01-28 print the address of the OneWire device
2016-01-31 Remove superfluous speed param
    The dir method was never documented and is only used internally. If
    someone chose to use this internal method (can’t imagine why they
    would) then this change would break that call.
2016-01-31 Add motor enable pin
    [motor-enable.fzz]
2016-02-02 Motor: Add "enable" to SPARKFUN_DUAL_HBRIDGE_EDISON_BLOCK config
    [motor-sparkfun-edison-hbridge.fzz]
2016-02-02 Sensor: refactor unused, undocumented scaleTo, add fscaleTo
2016-02-12 Fix a typo
    `anotated` → `annotated`
2016-02-17 Board: improvements to event forwarding. Addresses bug in first gh-1037. Closes gh-1037
2016-02-18 modify set up to wait for chip calibration not individual components. add external crystal initialisation option add orientation wrapper class
2016-02-18 FIX: correct passing of data into acceleromter data handler. was passing in bno magentometer, not the acclerometer data.
2016-02-18 revert calibration checks to all values
2016-02-18 add calibration fetch to temperature fetch since registers are side by side
2016-02-18 add in calibration to core driver and orientation
2016-02-18 clean up component in wrong place.
    lib/imu.js
    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
2016-02-18 modify set up to wait for chip calibration not individual components. add external crystal initialisation option add orientation wrapper class
    lib/orientation.js
    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
2016-02-18 Add documentation, wiring example and orientation example
    [imu-bno055.fzz]
2016-02-18 FIX: Correct scaling in gyro to represent default state of device ADD: Clarifications to some things around default values.
2016-02-18 break reads into smaller chunks due to lots of squiddly 32 byte buffers throughout both firmata and the wire library
2016-02-18 IMU: BNO055, add basic tests, add to programs.json and generate examples
    [imu-bno055.fzz]
2016-02-18 Examples: Adds Sparkfun BMP180 to existing examples
    [multi-bmp180-sfe.fzz]
2016-02-22 Stepper: make sure tests pass with updates to MockFirmata
2016-02-22 add in calibration events, primarily to the orientation class, and lower level bno/imu controller/driver add in configuration option to supply mask for determining calibration state
2016-02-23 Correct test case for BNO055 to factor in additional data event that will be emitted one per readCalibration call
2016-02-23 update the isCalibrated on the main imu controller
2016-02-23 Examples: LCD, diagrams and cleanups
    [lcd-16x2-tessel.fzz, lcd-enumeratechars.fzz, lcd-i2c.fzz, lcd-runner-20x4.fzz, lcd-runner.fzz, lcd.fzz]
2016-02-24 handle the read error case
2016-02-25 Change calibration events from using data to calibration
    emit calibrated event when device is calibrated
    emit calibration event when calibration state changes
    I think two are needed as the device does, depending on conditions, lose calibration and it is also fussy about how you calibrate it so it is useful to see the state changes as they happen.
2016-02-25 Switch: overhaul to support NO/NC
    [switch-magnetic-door-tessel.fzz, switch-magnetic-door.fzz]
2016-02-26 update tests for BNO-055 to test for calibration events
2016-02-29 Fix button fritzing schematics
    [button.fzz]
2016-03-01 Examples: board cleanup on exit event
2016-03-01 Led: add "blink" to Leds prototype
2016-03-01 Led/Led.RGB: make DEFAULT controller a regular property (not string access)
2016-03-01 Collection: add forEach, which matches Array.prototype.forEach
2016-03-03 Soft-reset board to support new sensitivity setting.
2016-03-04 Now properly skipping 9 i2cWrite calls
2016-03-04 Motor: only consider ["clock", "data", "latch"] relevant for making a register key (ignores possible "reset" key)
2016-03-04 ShiftRegister: accept shorthanded pin lists
    new ShiftRegister({
    pins: [ 6, 7, 8 ]
    new ShiftRegister({
    pins: [ 6, 7, 8, 9 ]
    new ShiftRegister([ 6, 7, 8 ]);
    new ShiftRegister([ 6, 7, 8, 9 ]);
    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
2016-03-04 LedControl: update tests to use appropriate methods for stubs
2016-03-04 Board: optimize and refactor shiftOut
2016-03-04 ShiftRegister: generated examples
    Also, I realized too late that I accidentally committed the source for these about 4 commits ago. Whoops.
    [shift-register-daisy-chain-anode.fzz, shift-register-multiple-anode.fzz, shift-register-seven-segment-anode.fzz]
2016-03-04 ShiftRegister: rotate example diagram
    [shift-register.fzz]
2016-03-04 added node-open-pilot project
    Node Open Pilot is an opensource software and openhardware project yo build your own drone using a firmata-board compatible and johnny-five
2016-03-04 ShiftRegister: resize cathod daisy chain example
2016-03-04 ShiftRegister: remove unused wire from seven-segment-anode example
    [shift-register-seven-segment-anode.fzz]
2016-03-04 ShiftRegister: more cleanup in led example
    [shift-register.fzz]
2016-03-04 ShiftRegister: seven segment anode diagram fixes
    [shift-register-seven-segment-anode.fzz]
2016-03-04 Specify board for test piezos. Remove unused test helper properties.
2016-03-07 Expander: I2C backpack firmware for CD74HC4067
2016-03-07 Expander: CD74HC4067 support (see full commit details for caveats)
    CD74HC4067 is a 16 channel analog input mux/demuxer. In order to use such a thing, an intermediary µC with special firmware is required.
    Arduino/Firmata notes: The Firmata protocol is limited to 32 bytes received from an i2c peripheral—which should be enough, except that Firmata actually uses two of those bytes. In order to use this Expander controller, you MUST change the i2cRxData length to 34 in StandardFirmataPlus, then flash your board.
    Other platforms: should work just fine, unless those platforms have restrictions on the number of i2c rx bytes
    [expander-CD74HC4067-14-pots.fzz, expander-CD74HC4067.fzz]
2016-03-08 Made board ready timeout configurable
2016-03-08 Keypad: 3X4_I2C_NANO_BACKPACK
    [keypad-3X4_I2C_NANO_BACKPACK.fzz]
2016-03-08 Board: timeout property tests.
2016-03-10 Firmwares: move to new directory; update file names
    [expander-CD74HC4067_NANO_BACKPACK.fzz]
2016-03-10 Keypad: complete upgrade to multi-touch
    [keypad-MPR121.fzz, keypad-MPR121QR2_SHIELD.fzz]
2016-03-11 Multi: MS5611 Support
    [multi-MS5611.fzz]
2016-03-14 Multi: BMP085 (which is functionally equivalent to BMP180)
    [multi-bmp085-sfe.fzz, multi-bmp085.fzz]
2016-03-14 Gyro: use identifier name controllers, not strings
2016-03-16 GPS: update examples
    [gps.fzz]
2016-03-17 Stub board.serial
2016-03-18 Multi: TH02 support. Fixes gh-1039
    [multi-TH02.fzz]
2016-03-21 Bypass auto-calibration by explicitely setting VDD limits and target VDD
2016-03-21 Updated i2cWrite count to match the no-calibration setup
2016-03-21 Keypad: MPR121 test for: Bypass auto-calibration by explicitely setting VDD limits and target VDD
2016-03-23 Stepper: existance checks for driver, 2 wire and 4 wire pin validation. Fixes gh-1065
2016-03-24 Multi: DHT11 support via DHT11_I2C_NANO_BACKPACK
    [multi-DHT11_I2C_NANO_BACKPACK.fzz]
2016-03-28 IMU/Multi: MPL3115A2 stopTX: true
2016-03-28 IMU/Multi: Cannot be considered "ready" until all subcomponents have at least emitted a "change" event
2016-03-28 IMU/Multi: MPL115A2 store computed values in "computed" object
2016-03-28 IMU/Multi: MS5611 computed outside of then
2016-03-28 IMU/Multi: TH02, example nitpicking
2016-03-28 IMU/Multi: use stopTX: true
2016-03-28 IMU/Multi: TH02 refinements
2016-03-28 IMU/Multi: ironing out junk from TH02 refactor
2016-03-31 Common SPI pin name aliases
2016-03-31 Common SPI pin name aliases (cont)
2016-04-02 Deprecate .Array; Adds aliases and renaming for .Collection (retains backward compatibility). Fixes gh-1063
    [brat.js, line-follower.js]
2016-04-02 Relay: implement Relays/Relay.Collection
    [relay-collection.fzz]
2016-04-02 Servo: test spy/stub cleanups
2016-04-02 Led: ensure call throughs
2016-04-02 Test/Extended: enforce Board.purge(), tearDown, sandbox spy/stub
2016-04-02 RGBs: Collection class for RGB leds
2016-04-02 IMU: strange failure workaround, with notes for follow up
2016-04-03 Collection.Emitter: Sensors and Buttons
2016-04-03 Buttons: Collection example with AT42QT1070
    [button-collection-AT42QT1070.fzz]
2016-04-03 Button: AT42QT1070 example initialization exlanation
2016-04-03 IMU/Multi: bogus fix for bogus bug
2016-04-03 Sensor: nit-picking
2016-04-06 Fix line follower example
    [line-follower.js]
2016-04-09 Keypad/Switch: debouncing
2016-04-13 Tests: eliminate need for requiring mock-firmata from within board.js
    Relevant to gh-1101
2016-04-13 Board: millis() method, returns milliseconds since "ready"
2016-04-15 Thermo-humidity sensor SHT31D (#1103)
    * Initial commit for SHT31-d controller
    * Added controllers for SHT31D multi sensor (thermometer, hygrometer)
    * Added examples and docs for SHT31D multi sensor
    * Added fritzing diagram and tests for SHT31D controller
    [humidity-sht31d.fzz]
2016-04-15 Update sht31d diagram
    [humidity-sht31d.fzz]
2016-04-17 LCD: Fix i2cConfig address forwarding for JHD1313M1 controller
2016-04-18 Board: Allow IO plugin to control initialization of repl.
    If an IO plugin wants to control the repl, it may do so by explicitly setting its own `this.repl = false;`
2016-04-19 IMU/Multi: register naming/nitpicking
2016-04-19 IMU/Multi: use Fn.POW_2_*
2016-04-19 IMU/Multi: initial BMP280 support
    Needs examples and tests
2016-04-19 IMU/Multi: BMP280 examples
    Needs diagrams;
2016-04-19 IMU/Multi: fix lint nits
2016-04-20 Motion: Tessel example
    [motion-tessel.fzz]
2016-04-22 Board: update previously missed "mock-firmata" removal.
2016-04-25 IMU/Multi: tests for SHT31
2016-04-25 IMU/Multi: BME280 support
2016-04-26 Add tilt switch switch with clean commit. #1107 (#1111)
    [switch-tilt-SW_200D.fzz]
2016-04-27 Suggested fix for #1113 (#1114)
    * Suggested fox for #1113
    Add "includes" Array.prototype function as a non-enumerable member
    * make jshint happier
2016-05-03 Compass: MAG3110 (incl. tests & diagrams)
    [compass-MAG3110-tessel.fzz, compass-MAG3110.fzz]
2016-05-05 IMU/Multi: HTU21D maintenance and improvements
2016-05-05 Gyro/Accelerometer: precision => fixed. Fixes gh-1124
2016-05-06 Servo: fixes to sweep + tests
2016-05-07 Board: make loop method stoppable & tests.
2016-05-09 Sensor: minor cleanups and nitpicks; Removes untested alias events
2016-05-10 Collection: Collection.prototype.byId, get a single entry from a collection by its id
2016-05-10 Switches/Switch.Collection: implement Collection.Emitter
2016-05-17 Accelerometer: ADXL345 support user defined range. Fixes gh-1135
2016-05-19 Examples: Fix "Intel Edison + Grove - Accelerometer (ADXL345)"
2016-05-19 Sensor: remove unused dep
2016-05-26 Motors, Servos, ShiftRegisters: clean up Collections
2016-06-02 Accelerometer: MMA8452 Support (includes odr and tap support)
    [accelerometer-MMA8452.fzz]
2016-06-02 IMU: use less string literals and more "const-ish" bindings. Eventually move these to actual const.
2016-06-08 Led: intensity(0-100) to match RGB
2016-06-08 Led/RGB: time/rate etc => duration
2016-06-08 Leds/RGBs: resolve callbacks from each entry into a single handler
2016-06-09 Led/Leds/RGB/RGBs: refactoring animation for LEDs; support for collections
2016-06-20 Rewrite the arduino starter kit in johnny-five
2016-06-20 Button: adds TINKERKIT controller for Tinkerkit Button and Touch. Fixes gh-1142
2016-06-20 LCD: Tessel + Grove LCD JHD1313M1
    [lcd-rgb-tessel-grove-JHD1313M1.fzz]
2016-06-21 Servo: limit history to 5 records to prevent potential memory leaks
2016-06-30 Led.RGB: make sure pin warnings are opt-in
2016-07-01 Piezo: I2C Backpack draft
2016-07-01 Led: More test coverage
2016-07-07 LedControl/Led.Digits/Led.Matrix: 100% coverage
2016-07-08 Led.RGB/Led.RGB.Collection: 100% coverage
2016-07-08 Led: Never break blink() again.
2016-07-08 LedControl: Fix duplicate test with renaming: "led" => "ledOutOfBounds"
2016-07-08 Led: Update test expect count
2016-07-09 Expander/Accelerometer: LIS3DH Support
    Missing:
    - Optional tap
    [accelerometer-LIS3DH.fzz, expander-LIS3DH.fzz]
2016-07-11 Improve LCD millisecond delay handling (#1174)
2016-07-11 Fianl removal of Board.Device (replaced by Board.Component)
2016-07-11 Expander: (PCF8591) Use correct var for pin number event name. Fixes gh-1175
2016-07-12 Accelerometer: remove unnecessary array path for analogInitialize; Update ESPLORA controller to assign pins correctly.
2016-07-12 Accelerometer: 100% coverage
2016-07-12 Button: 100% coverage
2016-07-12 Board: 89.79% coverage
2016-07-13 Board: Improved coverage (followup)
2016-07-15 Board: remove commented out require("os")
2016-07-15 Board: decouple component state snapshotting and serialization
2016-07-15 Fn: 2π as τ (Fn.TAU)
2016-07-15 Sensor: Board.* => Fn.* where applicable
2016-07-15 Board: add test for wait
2016-07-15 Stepper: use Fn.TAU const instead of expr
2016-07-18 Proximity: HCSR04_I2C_BACKPACK collection diagram
    [proximity-collection-HCSR04_I2C_BACKPACK-tessel.fzz]
2016-07-27 Add Rhys van der Waerden to contributors. References gh-1187
2016-08-01 fix pin 7->8. docs/breadboard/button-options.fzz pin '8' (#1194)
2016-08-02 LCD: Use RGB.ToRGB for bgColor() on supported devices
2016-08-02 Led/Led.RGB: tests split into separate files
2016-08-03 LCD: More Grove RGB LCD examples. Closes gh-1195
    [lcd-JHD1313M1.fzz, lcd-i2c.fzz, lcd-rgb-bgcolor-previewer.fzz, lcd-rgb-tessel-grove-JHD1313M1-external.fzz]
2016-08-23 Renaming to lower case with dashes
2016-08-26 Let's temporarily stopped pin-nannying and see what happens.
    This "feature" has been nothing but a "bug". Unless your doing basic GPIO, this is not useful and more often then not it's wrong.
2016-08-29 Servo/Servo.Collection: 100% coverage
    - Animation.normalize now normalizes to `value` property from `degrees`
    - Use `value` for internal keyFrames
2016-09-08 Add support for enabling built-in pull-down resistor
    opts.pulldown enables the built-in pull-down resistor
    on platforms that support it (raspi-io)
2016-09-08 Typo in documentation (#1215)
    * Let's temporarily stopped pin-nannying and see what happens.
    * Fixed a typo
    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
2016-09-08 IMU: nitpicking comment notations
2016-09-12 Examples: updates and new (BME280, HIH6130)
    [multi-BME280-arduino.fzz, multi-BME280-tessel.fzz, multi-HIH6130.fzz]
2016-09-16 IMU/Multi: rename "state" => "calibration" to disambiguate from broader used "state" var.
2016-09-16 Removes comments that no longer provide valuable insight or credit to original source/inspiration material.
2016-09-16 IMU/Multi: define generic Components that initializes and defines get accessors for IMU controller wrappers, based on components property value
2016-09-16 IMU/Multi: remove code that has been replaced by Components mechanism
2016-09-16 Thermometer: remove "temperature" properties. Re-order components lists as needed.
2016-09-16 Sensors: normalize examples to follow like-naming conventions
2016-10-04 Servo: remove specs because it's not a thing.
2016-10-04 Examples: regen servo.md
2016-10-07 LCD: move i2cConfig call to after opts.address is resolved for specific variants of PCF8574
2016-10-14 Multi: DHT11 refactored to support DHT11, 21, 22. Fixes gh-1216, gh-112
    [multi-DHT11_I2C_NANO_BACKPACK.fzz, multi-DHT22_I2C_NANO_BACKPACK.fzz]
2016-10-14 Accerometer/Gyro/IMU: Remove alias MPU-6050
2016-10-14 Board: remove unnecessary .js extensions
2016-10-14 Board: const-ing "undefined" (only fake const until we drop 0.10.x)
2016-10-14 Board.Component: remove dashes from controller names
2016-10-14 Hygrometer/Multi/Thermometer: adds missing DHT21 & DHT22 examples and diagrams
    [multi-DHT21_I2C_NANO_BACKPACK.fzz, multi-DHT22_I2C_NANO_BACKPACK.fzz]
2016-10-17 Led.RGB: Fix example "LED - Rainbow" (#1239)
    Loop didn't go through entire rainbow array. The last element was
    omitted.
2016-10-24 Motor: TB6612FNG example program (w/ Tessel 2)
    (cherry picked from commit cd6e68f7aeff0ee669b1cd641a3ee811484b8006)
    [motor-TB6612FNG.fzz]
2016-10-26 Button: tests for explicit pulldown constructor property
2016-11-01 Light: re-writing TSL2561 driver
2016-11-07 Test/Bootstrap: add generic Board.Controller call count and controller resolution test mechanism
2016-11-07 Servo: Update to accept custom, user defined controller objects.
2016-11-07 Thermometer: adds generic Board.Controller call enforcement test
2016-11-07 RGB: adds generic Board.Controller call enforcement test
2016-11-07 Proximity: adds generic Board.Controller call enforcement test
2016-11-07 Motor: adds generic Board.Controller call enforcement test
2016-11-07 Motion: adds generic Board.Controller call enforcement test
2016-11-07 Altimeter: adds generic Board.Controller call enforcement test
2016-11-07 Color: adds generic Board.Controller call enforcement test
2016-11-07 Accelerometer: adds generic Board.Controller call enforcement test
2016-11-07 Barometer: adds generic Board.Controller call enforcement test
2016-11-07 Button: adds generic Board.Controller call enforcement test
2016-11-07 Compass: adds generic Board.Controller call enforcement test
2016-11-07 Gyro: adds generic Board.Controller call enforcement test
2016-11-07 Joystick: adds generic Board.Controller call enforcement test
2016-11-07 Light: adds generic Board.Controller call enforcement test
2016-11-21 Update fritzing for H-bridge example
    Connect IC pin 16 to +5V; realign power rails
    [motor-hbridge.fzz]
2016-11-21 Update fritzing for motor-enable example
    Connect IC pin 16 to 5V from Uno; reroute grounds
    [motor-enable.fzz]
2016-11-21 Add fritzing for dual h-bridge example
    [motor-hbridge-dual.fzz]
2016-11-23 GPS: Sparkfun GP-20U7
    [gps-GP-20U7.fzz]
2016-11-23 Multi/Thermometer/Hygrometer: SI7021
    [multi-SI7021-uno.fzz, multi-SI7021.fzz]
2016-11-25 Multi: BMP180 SF version fix to +/3.3V
    [multi-bmp180-sfe.fzz]
2016-12-12 LCD: bgOn/bgOff for applicable devices
2016-12-13 Relay: Fix typo (#1261)
2017-03-10 Added support for BH1750 light sensor
2017-03-20 Accelerometer: ADXL345 use typical sensitivity (#1300)
2017-03-30 Sensor: update to use assigned bit resolution
2017-03-30 Sensor/Sensor.Collection: 100% coverage
2017-03-30 Sensor: use io-plugin provided ADC bit resolution, when available. gh-1276
2017-03-31 Repl: test coverage 100%, await pending for exit; Board: await pending for exit. Fixes gh-1306
2017-04-06 Board: changing "Device(s)" to "Available"
2017-04-10 Proximity: Adds power jumpers to HCSR04 Backpack example.
    [proximity-hcsr04-i2c.fzz]
2017-04-13 Add support for CSS color function notation to Led.RGB.color() (#1320)
    * Add support for CSS functional notation to Led.RGB.color
    Adds support for CSS functional notation (e.g. `"rgb(255, 255, 0)"`) to the `color()` method on the Led.RGB prototype.
    Supports:
    - `rgb(r, g, b)`
    - `rgba(r, g, b, a)` where the alpha value in the range 0-1 modifies the color as an intensity function using `RGB.ToScaledRGB()`
    - `rgba(r, g, b)` and `rgb(r, g, b, a)` to comply with the [CSS Color Module Level 4 Draft](https://drafts.csswg.org/css-color/#rgb-functions)
    * Add support for functional notation without commas
    Also part of the CSS color level 4 spec.
    * Fix lint errors
2017-04-14 Sensor: Add digital microwave example
    [sensor-digital-microwave.fzz]
2017-04-21 Fix Piezo.prototype.note() (#1328)
    * Fix Piezo.prototype.note()
    The `note()` method was passing a frequency (Hz) to the `tone()` method, which is expecting to receive a duty cycle (μs), leading to the wrong note being played. The solution is for `note()` to call `frequency()` instead, which will do the appropriate conversion.
    Since it took me a while to understand the relationships between `tone`, `frequency` and `note` I've added some documentation to those methods to clear things up for the next person. I've also made some unit tests more aggressive about checking that values are converted appropriately as they're passed around, and commented note-frequency-duty equivalencies to h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
2017-05-26 Fix board tests
    Updates board snapshot and serialize tests to account for the new thermometer `freq` property.
2017-07-12 This adds support for having multiple driver instances for the DS18B20 on different pins (1wire bus) concurrently.
2017-07-12 Sensor: value emitted via event should match sensor.value
2017-07-31 Fix `this` usage in Board - Specify Port Example. Closes gh-1369
2017-08-18 Handle number as first value of servo keyframes
    When number is passed as the first keyframe of a servo animation it should be treated as a step from the most recent position.
    Also adds tests for led to ensure that number values in first keyframe are still treated as explicit values.
2017-08-18 Fix bug that occurs when enable pin is used with Motor
2017-08-18 Add l298 example
    In response to #1308
    [motor-l298-breakout.fzz]
2017-08-18 Servo values were being inverted twice when to was called with a time
    Fixes #1255
2017-08-24 Examples: Add BH1750 & TSL2561 programs and fritzing diagrams. Ref gh-1302
    [light-ambient-BH1750-arduino.fzz, light-ambient-BH1750-tessel.fzz]
2017-10-09 Relay: initialize state after Board.Component
2017-10-23 Button: remove undocumented button event aliases
2017-10-26 Stepper: fix incorrect pins in code and diagram
    [stepper-driver.fzz]
2017-10-26 Stepper: pin correction
2017-11-28 IMU: Fn.{s32, u32} => s32, u32
2017-12-01 Accelerometer: modify MPU6050 `toGravity` to return values with 3 decimals
2017-12-08 fix: Switch defaults to NO
2017-12-08 move Board options up
2017-12-08 Add doc expander ADS1115
    [expander-ADS1115-4-pots.fzz]
2017-12-08 Accelerometer: remove toFixed call from x,y,z getters
    The `toGravity` function is now in charge of returning
    a value with the desired fractional digits by using
    `toFixed` call.
2017-12-15 Accelerometer: set fractional value
    Set fractional values returned by `toGravity.value` of devices:
    * ADXL335
    * ADXL345
    * MMA7361
2017-12-18 Accelerometer: update tests and digital.all/integral/fractional
2017-12-27 Fix relay to use analog output
2018-01-10 add protective diode to motor example. modify motor.fzz and motor.png
    [motor.fzz]
2018-01-10 Barometer: add resolution of MPL115A2 and MPL3115A2
    Add resolutions and tests.
    Refactor the `pressure` getter of the `Barometer` class to do not return
    a value
    with fixed 4 fractional digits, but just the raw one.
2018-01-10 Barometer: add BMP180 resoultion
    Does not add test because I can't get the `data` spy get called and
    check the barometer pressure value.
2018-01-15 Offset was being applied twice when to() was called with a time
    Move application of offset so that is only applied once.
    Move update of this.value to controller update methods. A little less DRY, but having them be more proximate to the actual servoWrite makes sense.
    Fixes #1429
2018-02-20 Accelerometer: add LIS3DH fractional digits
    Add device sensitivity to `toGravity.value` and test
    case.
2018-02-20 Relay: add test and example program for use with analog pin.
    [relay-on-analog-pin.fzz]
2018-02-20 Servo bug fixes
2018-02-20 Proximity: add resolution of MB1003 device
2018-02-20 Proximity: add resolution of MB1230 device
2018-02-20 Proximity: add resolution of HCSR04 device
2018-02-20 Proximity: add resolution of LIDAR-Lite device
2018-02-20 Exaples: fix lint nits in eg/relay-on-analog-pin.js
2018-02-20 Accelerometer: whitespace removal
2018-02-20 Hygrometer: add test for resolution of SHT31D device
2018-02-20 Hygrometer: add comment on resolution for TH02 device
2018-02-20 LSM303C IMU
    [imu-lsm303c.fzz]
2018-02-20 LSM303C IMU Unit Tests
    [imu-lsm303c.fzz]
2018-02-20 LSM303C IMU Extra unit tests
2018-02-20 Gyro: add MPU6050 and BNO055 devices resolution
    Add test only for MPU6050 device.
2018-03-27 Added 4x4 I2C Arduino Code under `firmwares/`
2018-03-27 Added example and images
    [keypad-4X4_I2C_NANO_BACKPACK.fzz, keypad_4X4_I2C_NANO_BACKPACK.fzz]
2018-03-27 small contribution - add example program for flex sensor
    [flex.fzz]
2018-04-05 Serial: throttle serial list attempts, add forced exit
    When listing available serial connections, a maximum number of 10
    attempts every 400 milliseconds are allowed, then the `board.fail`
    method is called.
    When disconnecting on SIGINT, add a 1000 millisecond timeout before
    forcing the exit. This has been added because if one disconnects a
    succesfully connected board the process could never exit on SIGINT.
2018-04-05 Repl: fix multi board disconnection
    When connecting multiple boards, an exception is thrown when exiting the
    process
    because `state.board.io.pending` is not defined. This commit fixes the
    problem by checking the `length` property of `state.board` and looping
    through the board list to check the `board.io.pending` property.
    Futhermore, it add a timeout of 1000 milliseconds to force the process
    exit in case the `board.io.pending` property never becomes `false` (it
    has happened disconnetting a succesfully connected board).
2018-04-05 Boards: expose `fail` event from board items
    Since `board.fail` is called when connection fails, it might be useful
    to echo the event in the Boards class.
2018-04-16 Coverage: Barometer, Board, Compass, IMU, Orientation
2018-05-10 Add support for multi-turn, winch, 90 and 360 degree servos
    servoWrite with microseconds instead of degrees.
    Add support for multi-turn, whinch, 90 and 360 degree servos
    Merge remote-tracking branch 'origin/multi-turn-servo' into multi-turn-servo
    Fix broken servo tests
    Regenerate Docs
    Coverage: Barometer, Board, Compass, IMU, Orientation
    Merge remote-tracking branch 'rwaldron/master' into multi-turn-servo
2018-05-10 Servo: removes blank line whitespace
2018-06-10 Add missing commas in stepper comments
2018-09-18 Add support for PWM resolutions other than 8-bit
    Required for ESP32. Addresses #1275, #1276, and #1280
2018-09-18 Fix for #1499
    If an array of keyFrames are passed to Servos, those keyFrames should be used as values for the whole collection and should not be normalized as a keyFrameSet.
2019-05-10 Servo: Adjust PCA9685 special case check for Tessel 2 IO instance name
2019-06-07 Update Raspberry Pi example
2019-07-17 five/Board: remove "array-includes-shim"
2019-07-17 Board: populate this.io.RESOLUTION from defaults and io.RESOLUTION
2019-08-11 ESC: deprecate speed(percent), introduce throttle(us).
    - Eliminates "history" memory leak
    - Deprecates speed()
    - Introduces throttle(us)
2019-08-11 ESC: Removes speed because there is no safe reason to continue supporting it.
2019-08-13 Update ESC examples to new API methods
2019-08-17 Examples: update led (#1598)
    * Examples: update led syntax
    * Docs: build docs from example
    * remove arrow function to allow this to scope to board
2019-08-21 Examples: update Accelerometer programs syntax
2019-08-21 Examples: Update Motor Syntax
2019-08-21 docs: update ESC examples with newer javascript syntax
2019-08-21 Examples: update led-array syntax
2019-08-21 update led-array-controller syntax
2019-08-21 update syntax for led examples
2019-08-21 update syntax on led examples
2019-08-21 keep this bound to board for ready event callback
2019-08-21 using global board with arrow function
2019-08-21 Examples: Update Servo Syntax
2019-08-21 Example: eg/servo-diagnostic.js simplified
2019-08-23 Sonar examples
    I'm assuming these are removed from programs.json because Sonar has been dropped in favor of proximity.
2019-08-23 Examples: make Sonar examples use Proximity class
2019-08-23 Update Switch examples
2019-08-23 Update Stepper examples
2019-08-23 Update LED-Digits examples
2019-09-10 led: updated led-rgb examples syntax
2019-09-10 Examples: make Accelerometer example output consistent
2019-09-17 Examples: Accelerometer nitpicking, Board, Exander, misc.
2019-09-18 Add support for PCA9685_Hybrid motors
    It is entirely reasonable to want to control a motor using a PCA9685 for speed and regular GPIO pins for direction. This PR allows for that.
2019-09-18 Update light class to es6
    This updates the `light` class to es6. I used eslint to do most of the work and manually removed binds and a few other things.
    This doesn’t move to actually using ES6 Classes
2019-10-06 Fix expander MCP23017 schema (#1632)
    [expander-MCP23017.fzz]
2019-10-17 docs: update IMU examples
2019-10-17 update awesome.md adding new robot to put as sample
2020-01-09 Fix error on code sample
2020-06-12 IMU -> SIP
2020-06-12 {Accelero, Alti, Baro, Magneto, Gyro, Hyro, Thermo}meter: IMU or Multi -> SIP
2020-06-12 Board: modernization pass
2020-06-12 Switch to 'change' event
2021-07-06 Suspendable: adds class that provides a "pause" and "resume" method
    We can't safely or effectively destroy objects that represent hardware or hardware states, but we need a way to temporarily prevent sensors from emitting data events. This class will move the contents of _events into a side table weakmap when pause() is called and then restore _events when resume() is called.
2021-07-25 Accelerometer: Pass board reference through to Expander
    Fixes https://github.com/rwaldron/johnny-five/issues/1709
2022-02-04 Fix accelerometer test
2022-12-03 Assign colors, and then assign colors to keys (#1799)
    * Assign colors, and then assign colors to keys
    * added unit test to check RGB.prototype[Animation.keys] initialized
2023-01-23 Modify Animation temporalTTL so that it is configurable (#1805)
    * in animation.js temporalTTL moved from constant to Animation.Segment options to be configurable
    * add unit test to check that led pulse method uses temporalTTL = 0
    * default of temporalTTL remains 5000 ms
2023-01-23 Add pulse method to RGB class (#1803)
    * add rgb pulse function
    * clean up comments, edit Animation.render and off functions
    * modify update to be writable and fix rgb Animation.render test in test/rgb.js
    * fix Animation.render test in rgb.collection test
    * add pulse tests in test/rgb.js
    * In Animation.render add state.value arg, add logic so rgb is at full value if on() called after pulse()
    * update rgb pulse comment - method can take also take Animation object as param
    * add example file for led-rgb-pulse
    * In rgb.js initialize state.prev values in constructor, clean up on() method, revise comments
2023-01-23 refactor: replace deprecated String.prototype.substr() (#1782)
    * refactor: replace deprecated String.prototype.substr()
    .substr() is deprecated so we replace it with .slice() which works similarily but isn't deprecated
    * Resolve PR comment
2023-02-12 Remove references to deprecated “axismove” event from Joystick examples (#1811)
    Fixes https://github.com/rwaldron/johnny-five/issues/1810
